huan95nd/BAI_TAP_PHAN_MEM/BAI_TAP_SOLIDWORKS/Dong_co_DC/bevel-gear-mechanism-4.snapshot.1/untitled.90.jpg

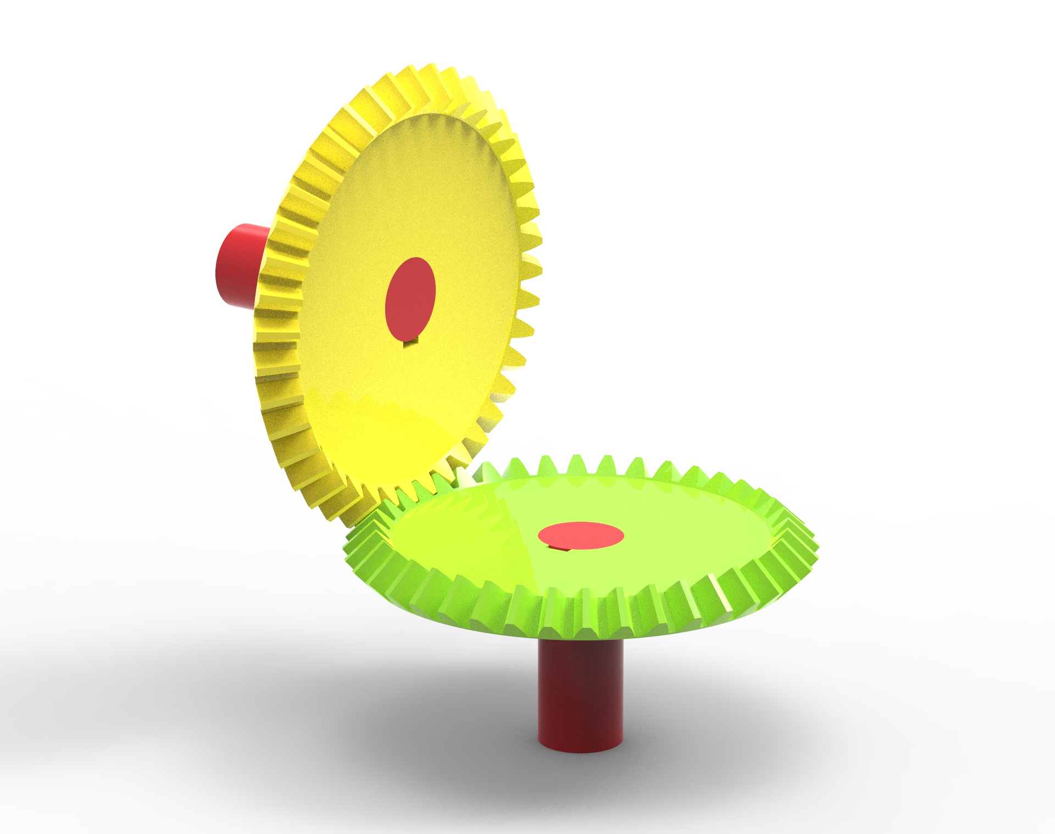
BAI_TAP_SOLIDWORKS/Dong_co_DC/bevel-gear-mechanism-4.snapshot.1/untitled.90.jpg
