huan95nd/BAI_TAP_PHAN_MEM/BAI_TAP_SOLIDWORKS/Dong_co_DC/bevel-gear-mechanism-4.snapshot.1/untitled.91.jpg

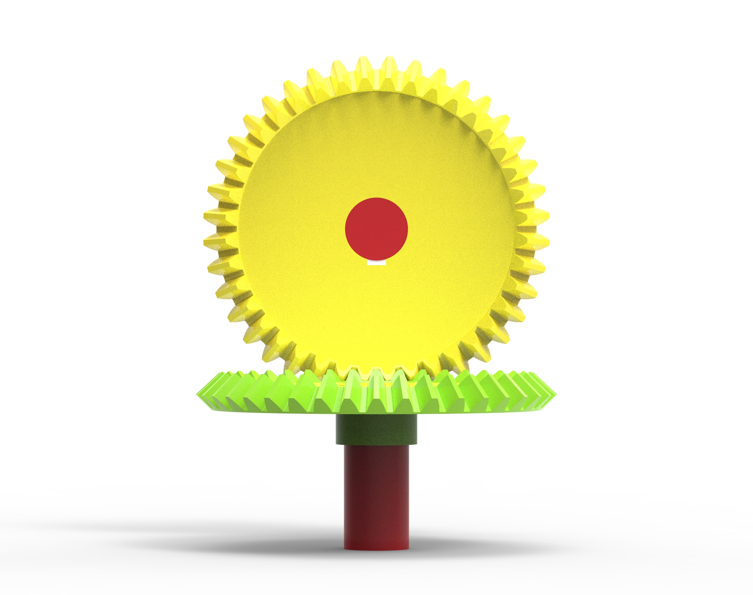
BAI_TAP_SOLIDWORKS/Dong_co_DC/bevel-gear-mechanism-4.snapshot.1/untitled.91.jpg
