huan95nd/BAI_TAP_PHAN_MEM/BAI_TAP_SOLIDWORKS/AN_HONG/Duoc_CPC_HN_project2-master/Duoc_CPC_HN_project2-master/fullcpchn.JPG

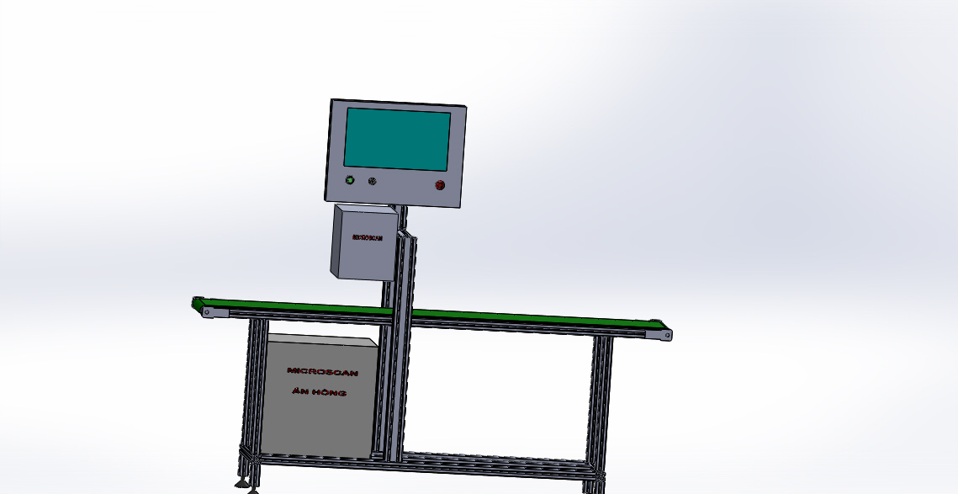
BAI_TAP_SOLIDWORKS/AN_HONG/Duoc_CPC_HN_project2-master/Duoc_CPC_HN_project2-master/fullcpchn.JPG
