huan95nd/BAI_TAP_PHAN_MEM/BAI_TAP_SOLIDWORKS/AN_HONG/videojet_8520/Assem1.SLDASM

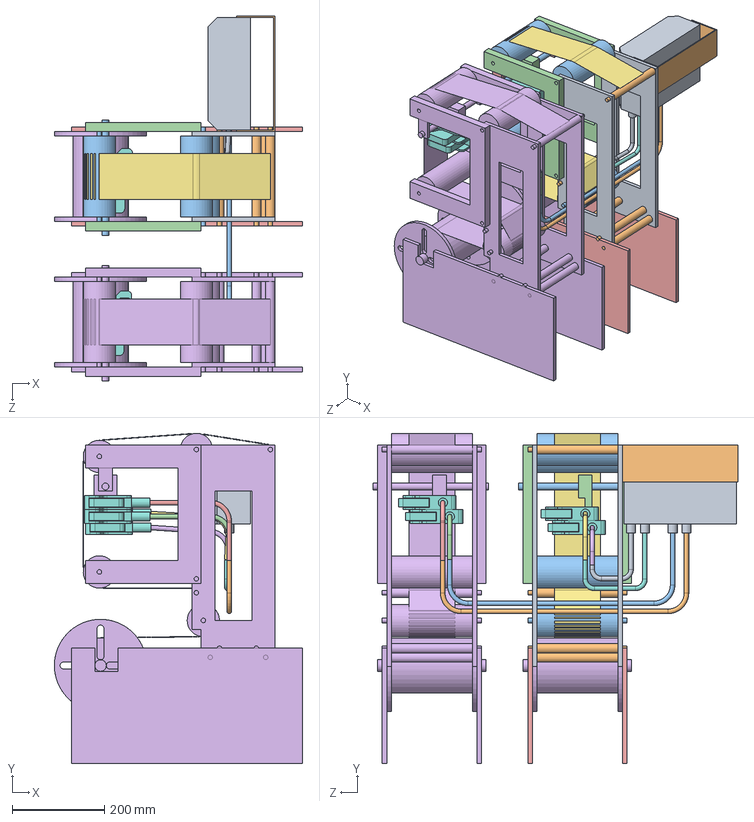
[picture p5: CAD file, 2020-03-10]
BAI_TAP_SOLIDWORKS/AN_HONG/videojet_8520/Assem1.SLDASM
537.5 x 715.1 x 790.0 mm
conlannho x 6
conlanto x 4
Part8^Assem1
dauin x 4
manhinh
Part22^Assem1
Part25^Assem1
Part1^Assem1
Part2^Assem1
Part5^Assem1
Part6^Assem1
Part9^Assem1
Part10^Assem1
Assem1
