huan95nd/BAI_TAP_PHAN_MEM/BAI_TAP_SOLIDWORKS/robot/User Library-NB4/User Library-NB4.sldasm

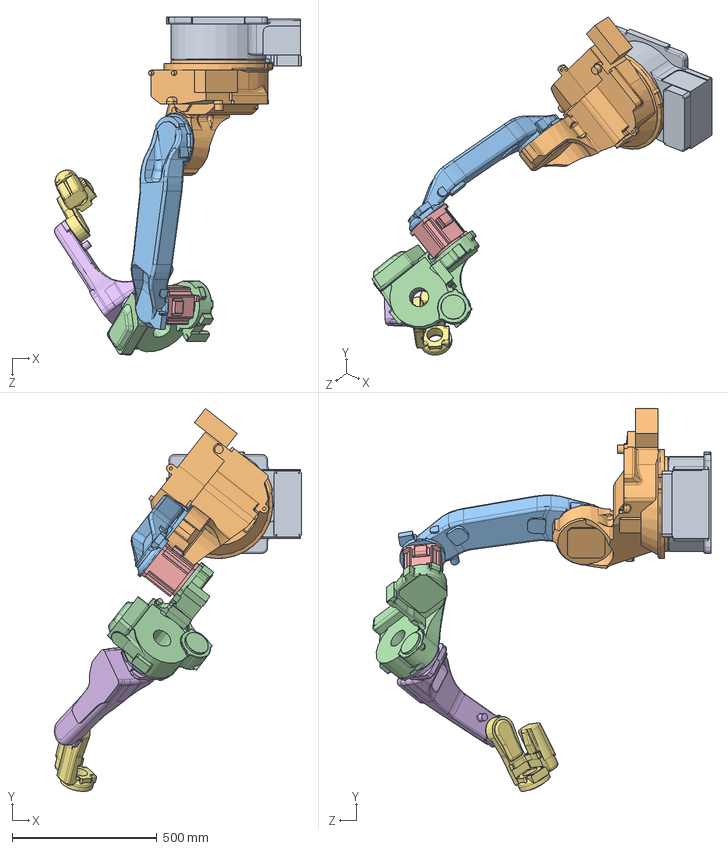
[picture p6: CAD file, 2020-02-10]
BAI_TAP_SOLIDWORKS/robot/User Library-NB4/User Library-NB4.sldasm
854.9 x 1325.2 x 1170.1 mm
User Library-NB4_NB4-oa0_1
User Library-NB4_NB4_0-oa1_1
User Library-NB4_NB4_2_1
User Library-NB4_NB4_3_1
User Library-NB4_NB4_4_1
User Library-NB4_NB4_6_1
User Library-NB4_NB4_7_1
User Library-NB4_NB4_8_1
