huan95nd/BAI_TAP_PHAN_MEM/BAI_TAP_SOLIDWORKS/AN_HONG/laser_khach_hang/laser_khach_hang/Assem2.SLDASM

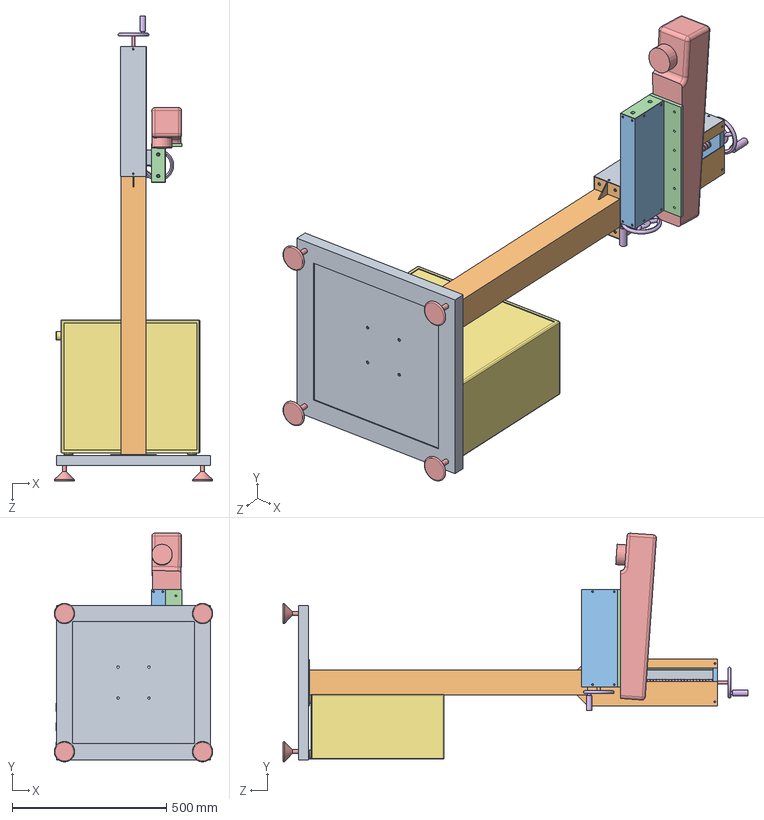
[picture p7: CAD file, 2020-03-07]
BAI_TAP_SOLIDWORKS/AN_HONG/laser_khach_hang/laser_khach_hang/Assem2.SLDASM
512.9 x 740.2 x 1505.0 mm
De
Chan_de
Nhom_duoi
Truc x 2
Truc_vit_me
Nhom_giua
nhom_truc_x
truc_x x 2
giua_trc_x
vit_me_truc_x
Nhom_tren
De_may_in
bat_de x 4
tay_quay x 2
khoi nguon fiber
angular contact ball bearing_68_iso
op
op_1
op_2
nhom_truc_x 1
MAY_IN_LAZE
bac x 4
bac_x x 4
