huan95nd/BAI_TAP_PHAN_MEM/BAI_TAP_SOLIDWORKS/AN_HONG/videojet_8520/Assem2.SLDASM

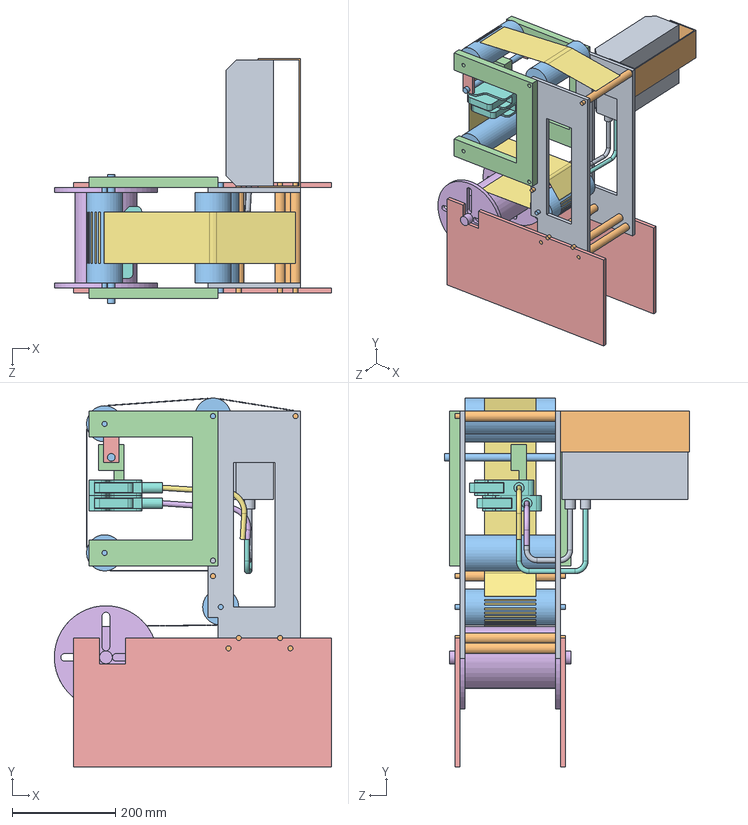
[picture p8: CAD file, 2020-03-10]
BAI_TAP_SOLIDWORKS/AN_HONG/videojet_8520/Assem2.SLDASM
537.5 x 715.1 x 475.0 mm
conlannho x 6
conlanto x 4
Part8^Assem2
dauin x 2
manhinh
Part22^Assem2
Part25^Assem2
Part1^Assem2
Part2^Assem2
