huan95nd/BAI_TAP_PHAN_MEM/BAI_TAP_SOLIDWORKS/Dong_co_DC/bevel-gear-mechanism-4.snapshot.1/圆锥齿轮传动齿轮副仿真.SLDASM

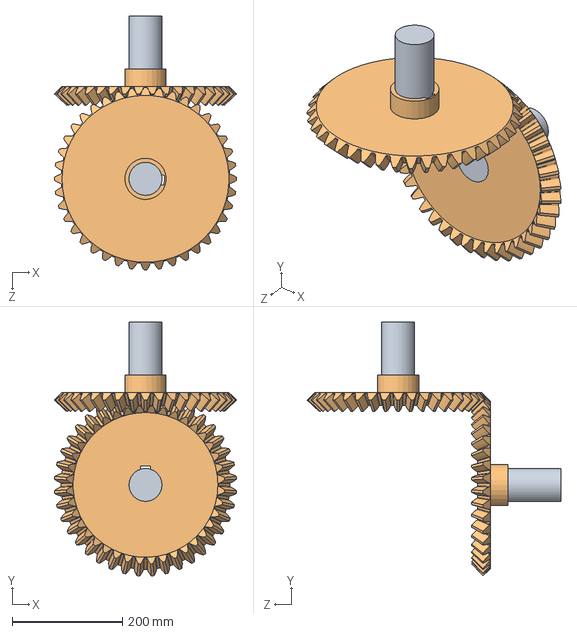
[picture p9: CAD file, 2020-02-09]
BAI_TAP_SOLIDWORKS/Dong_co_DC/bevel-gear-mechanism-4.snapshot.1/圆锥齿轮传动齿轮副仿真.SLDASM
331.3 x 461.1 x 461.4 mm
齿轮轴 x 2
圆锥齿轮 x 2
