huan95nd/BAI_TAP_PHAN_MEM/BAI_TAP_SOLIDWORKS/AN_HONG/gia_camera_demo-master/gia_camera_demo-master/full camera demo.SLDASM

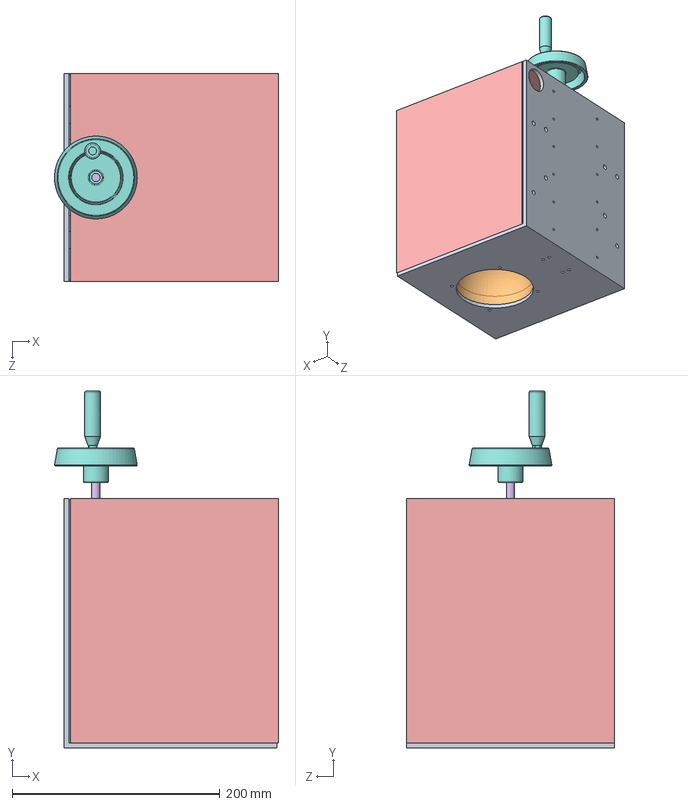
[picture p10: CAD file, 2020-03-10]
BAI_TAP_SOLIDWORKS/AN_HONG/gia_camera_demo-master/gia_camera_demo-master/full camera demo.SLDASM
215.6 x 343.5 x 200.0 mm
gia bat
dome light VT-LT3-DM100x
NORDEX-MIX-A1-3-230_MIX-A1-Base x 2
NORDEX-MIX-A1-3-230_MIX-A1-Carriage x 2
bat chung
vitme
do vitme duoi
H04.080.010.1-Durovis
gia bat MV4000
MicroHAWK_ID-40_Drawing
gia bat mv40-1
gia bat mv40
nap bat cover
