huan95nd/BAI_TAP_PHAN_MEM/BAI_TAP_SOLIDWORKS/AN_HONG/laser_khach_hang/laser_khach_hang/Assem3.SLDASM

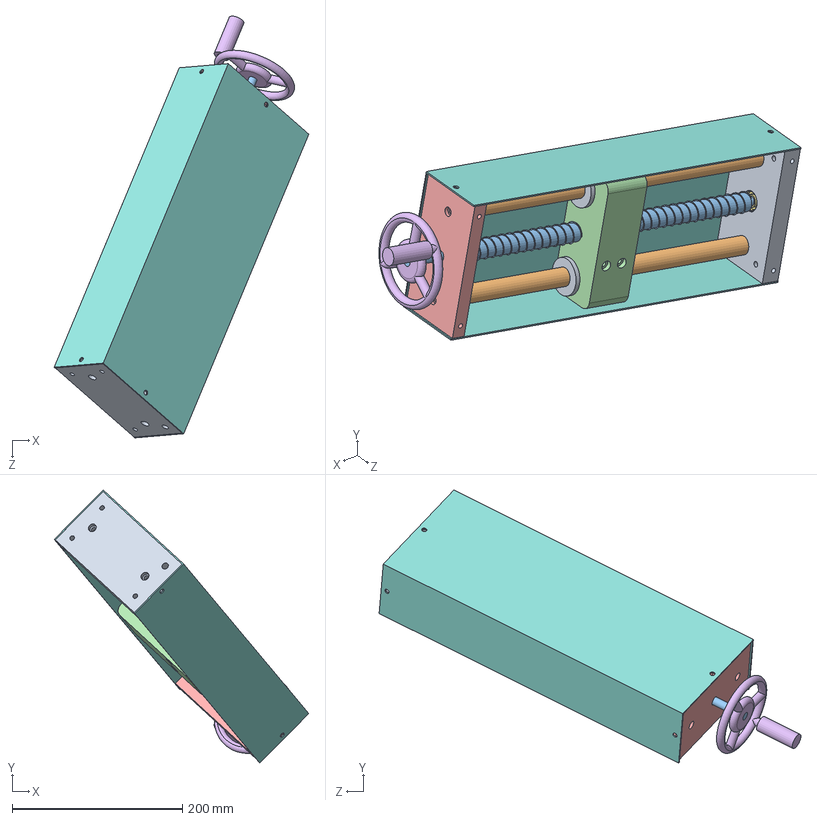
[picture p11: CAD file, 2020-02-09]
BAI_TAP_SOLIDWORKS/AN_HONG/laser_khach_hang/laser_khach_hang/Assem3.SLDASM
299.3 x 320.8 x 495.7 mm
Nhom_duoi
Truc x 2
Truc_vit_me
Nhom_giua
Nhom_tren
tay_quay
angular contact ball bearing_68_iso
op
bac x 4
