huan95nd/BAI_TAP_PHAN_MEM/BAI_TAP_SOLIDWORKS/bang tai/Quickdraw-LR6TS-7-DDL-ESD/Quickdraw-LR6TS-7-DDL-ESD.SLDASM

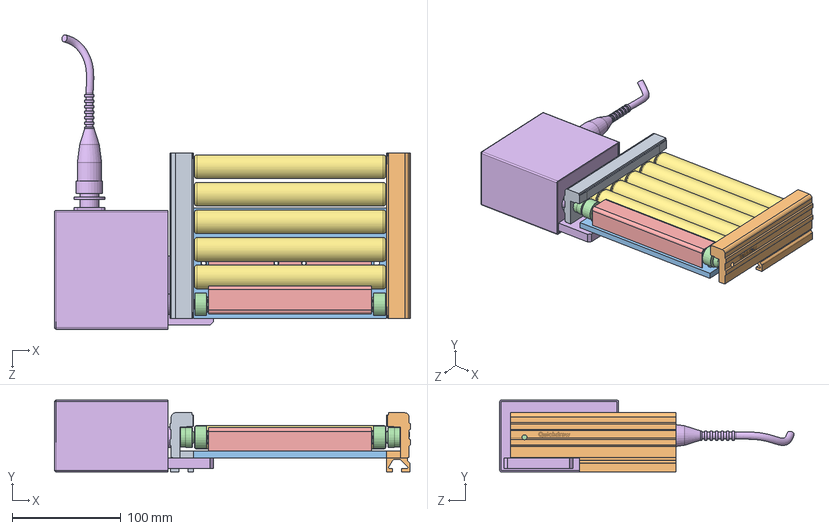
[picture p12: CAD file, 2020-02-09]
BAI_TAP_SOLIDWORKS/bang tai/Quickdraw-LR6TS-7-DDL-ESD/Quickdraw-LR6TS-7-DDL-ESD.SLDASM
328.1 x 66.2 x 271.4 mm
Quickdraw-LR6TS-7-DDL-ESD_LHRail
Quickdraw-LR6TS-7-DDL-ESD_RHRail
Quickdraw-LR6TS-7-DDL-ESD_END PLATE
Quickdraw-LR6TS-7-DDL-ESD_MR ROLLER ASSY LT x 2
Quickdraw-LR6TS-7-DDL-ESD_collar_cover
Quickdraw-LR6TS-7-DDL-ESD_Motor PKG DDL
Quickdraw-LR6TS-7-DDL-ESD_LongRoller x 5
