huan95nd/BAI_TAP_PHAN_MEM/BAI_TAP_SOLIDWORKS/AN_HONG/Project_BIA_HHT1/full bt5.SLDASM

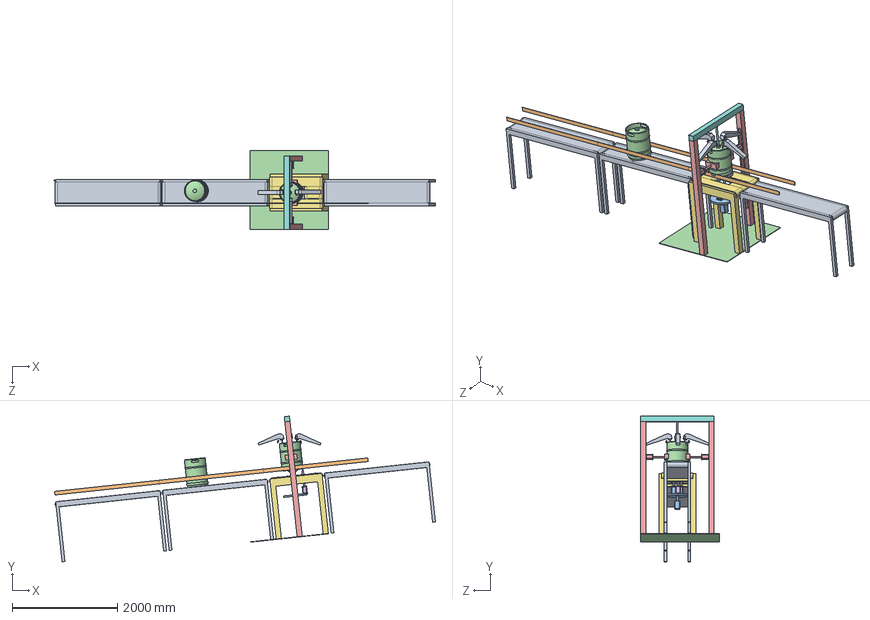
[picture p13: CAD file, 2020-02-09]
BAI_TAP_SOLIDWORKS/AN_HONG/Project_BIA_HHT1/full bt5.SLDASM
7253.0 x 2775.9 x 1500.0 mm
laser x 4
CT-hanhtrinh x 4
cam x 4
tam-nen
tru-do-xilanh-giu-keg x 3
xilanh_tt22
bang tai 2
bang tai 3 x 3
thanh dan hương x 6
ban-xoay-2
kegbia x 2
xilanh_giukeg1 x 2
