huan95nd/BAI_TAP_PHAN_MEM/BAI_TAP_SOLIDWORKS/AN_HONG/gia_camera_demo-master/gia_camera_demo-master/giá.SLDASM

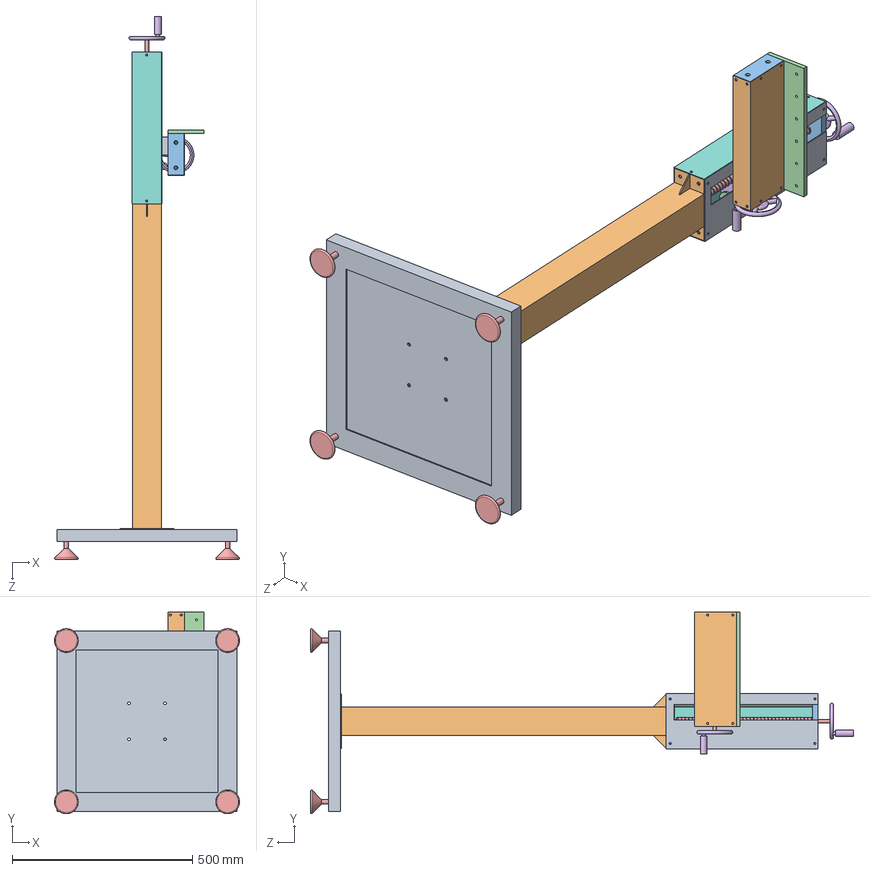
[picture p14: CAD file, 2020-03-10]
BAI_TAP_SOLIDWORKS/AN_HONG/gia_camera_demo-master/gia_camera_demo-master/giá.SLDASM
512.9 x 558.5 x 1505.0 mm
De
Chan_de
Nhom_duoi
Truc x 2
Truc_vit_me
Nhom_giua
nhom_truc_x
truc_x x 2
giua_trc_x
vit_me_truc_x
Nhom_tren
De_may_in
bat_de x 4
tay_quay x 2
angular contact ball bearing_68_iso
op
op_1
op_2
nhom_truc_x 1
bac x 4
bac_x x 4
