huan95nd/BAI_TAP_PHAN_MEM/BAI_TAP_SOLIDWORKS/Ban_le/8020-2134 Hinge Door Configuration/8020-2134 Hinge Door Configuration-$PARTNUMBER.SLDASM

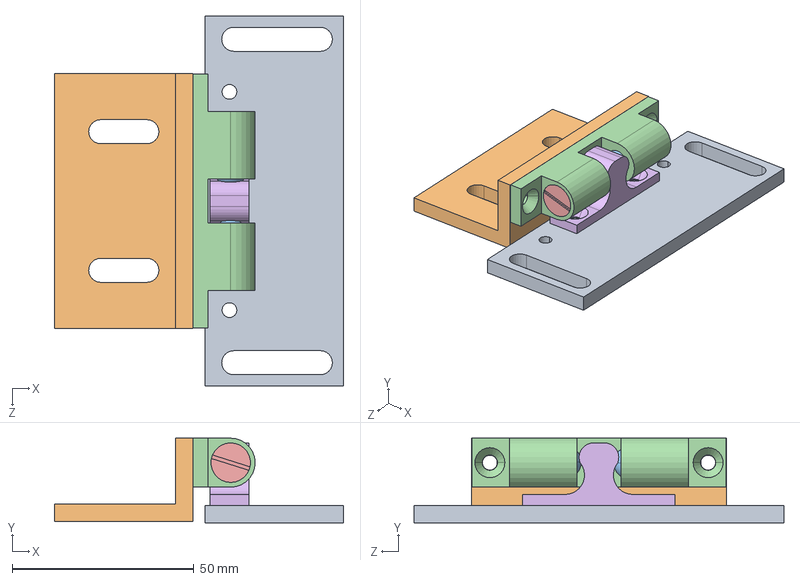
[picture p15: CAD file, 2020-02-09]
BAI_TAP_SOLIDWORKS/Ban_le/8020-2134 Hinge Door Configuration/8020-2134 Hinge Door Configuration-$PARTNUMBER.SLDASM
79.4 x 23.3 x 101.6 mm
8020-2134 Hinge Door Configuration-$PARTNUMBER_Latch Plate
8020-2134 Hinge Door Configuration-$PARTNUMBER_Strike Plate
8020-2134 Hinge Door Configuration-$PARTNUMBER_Ball Latch x 2
8020-2134 Hinge Door Configuration-$PARTNUMBER_Latch
8020-2134 Hinge Door Configuration-$PARTNUMBER_Cap x 2
8020-2134 Hinge Door Configuration-$PARTNUMBER_Striker
