huan95nd/BAI_TAP_PHAN_MEM/BAI_TAP_SOLIDWORKS/AN_HONG/FCC_2/Assem1.SLDASM

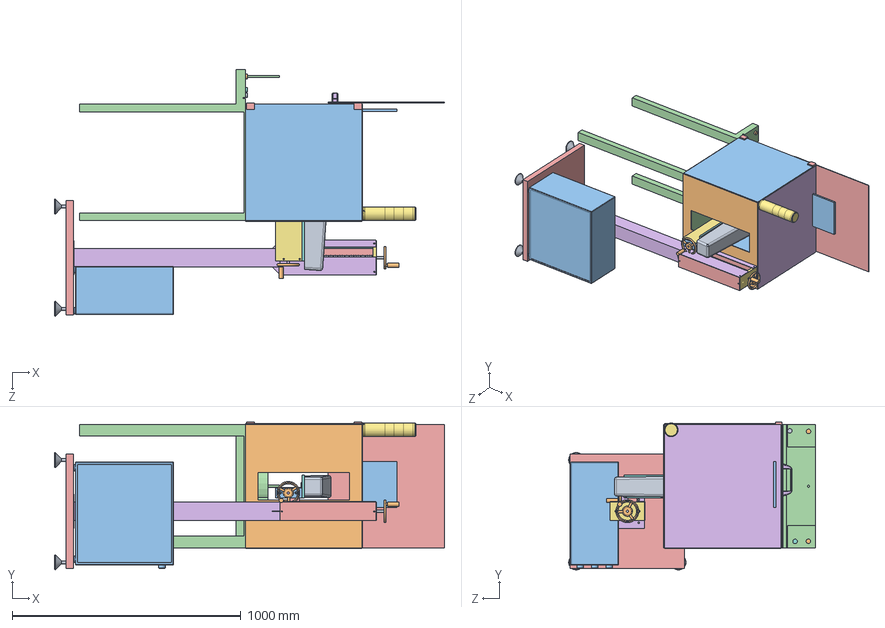
[picture p17: CAD file, 2020-02-09]
BAI_TAP_SOLIDWORKS/AN_HONG/FCC_2/Assem1.SLDASM
1704.8 x 646.1 x 1078.3 mm
nhôm định hình 1 x 11
De
Chan_de
Nhom_duoi
Truc x 2
Truc_vit_me
Nhom_giua
nhom_truc_x
truc_x x 2
giua_trc_x
vit_me_truc_x
Nhom_tren
De_may_in
bat_de x 4
tay_quay x 2
khoi nguon fiber
angular contact ball bearing_68_iso
op
op_1
op_2
nhom_truc_x 1
MAY_IN_LAZE
bac x 4
bac_x x 4
User Library-p000557 light tower
do
in
vang x 2
27394.stp
Part2 - Sao chép
8020-2061-$PARTNUMBER
