huan95nd/BAI_TAP_PHAN_MEM/BAI_TAP_SOLIDWORKS/AN_HONG/Project_BIA_HHT1/Assem3.SLDASM

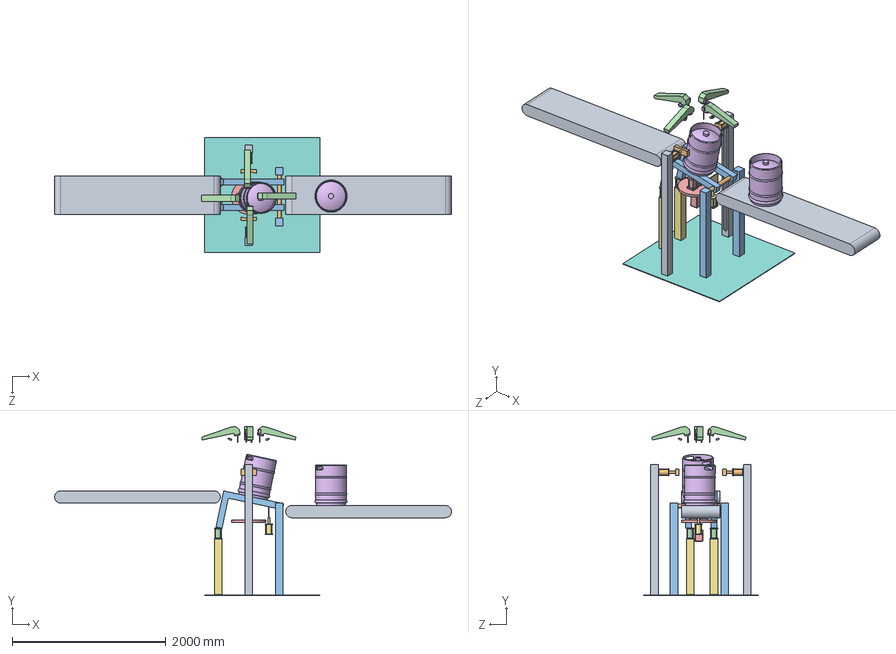
[picture p19: CAD file, 2020-02-09]
BAI_TAP_SOLIDWORKS/AN_HONG/Project_BIA_HHT1/Assem3.SLDASM
5170.0 x 2202.6 x 1500.0 mm
bang-tai x 2
truc-quay
tru-dung x 2
xilanh x 2
ban-xoay
kegbia x 2
xilanh_tt2
tam-nen
tru-do-xilanh-giu-keg x 2
xilanh_giukeg x 2
reject x 2
laser x 4
CT-hanhtrinh x 4
cam x 4
