huan95nd/BAI_TAP_PHAN_MEM/BAI_TAP_SOLIDWORKS/AN_HONG/Project_BIA_HHT1/FILE 1/full 1.SLDASM

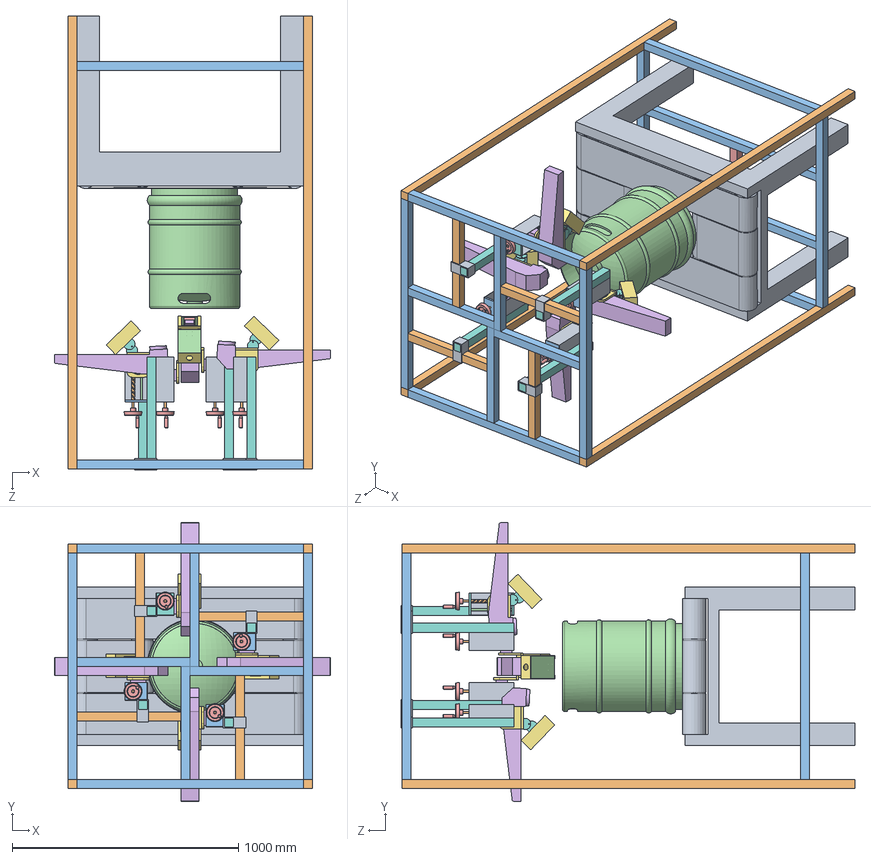
[picture p20: CAD file, 2020-02-09]
BAI_TAP_SOLIDWORKS/AN_HONG/Project_BIA_HHT1/FILE 1/full 1.SLDASM
1220.7 x 1233.4 x 2005.0 mm
bang tai 2
truc do laser x 4
truc do laser1 x 10
kegbia
truc do laser2
laser x 4
gia laser x 4
gia bat vitme3 x 5
gia bat vitme 1 x 4
truc vit me x 4
gia bat vitme x 3
truc tron x 4
H04.080.010.1-Durovis x 4
truc do x 4
gia laser 2 x 4
truc do laser3 x 4
gia bat tren x 4
truc do laser6 x 4
truc do laser7 x 4
cover camera x 4
do camera x 4
MicroHAWK_ID-40_Drawing x 4
cover camera1 x 4
gia bat cover x 8
