huan95nd/BAI_TAP_PHAN_MEM/BAI_TAP_SOLIDWORKS/robot/User Library-6-axis robot abb6650_320_125/User Library-6-axis robot abb6650_320_125.SLDASM

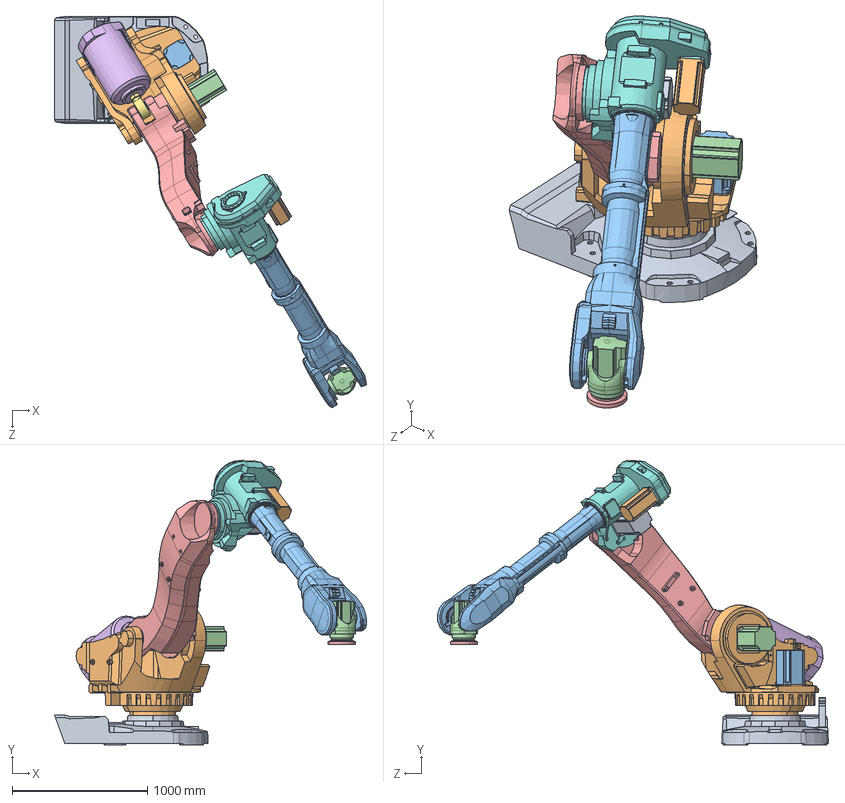
[picture p21: CAD file, 2020-02-10]
BAI_TAP_SOLIDWORKS/robot/User Library-6-axis robot abb6650_320_125/User Library-6-axis robot abb6650_320_125.SLDASM
2306.7 x 2104.9 x 2891.5 mm
User Library-6-axis robot abb6650_320_125_IRB6650_320-125_m2000_rev2_01-1
User Library-6-axis robot abb6650_320_125_IRB6650_320-125_m2000_rev2_01-2
User Library-6-axis robot abb6650_320_125_IRB6650_320-125_m2000_rev2_01-13
User Library-6-axis robot abb6650_320_125_IRB6650_320-125_m2000_rev2_01-12
User Library-6-axis robot abb6650_320_125_IRB6650_320-125_m2000_rev2_01-3
User Library-6-axis robot abb6650_320_125_IRB6650_320-125_m2000_rev2_01-8
User Library-6-axis robot abb6650_320_125_IRB6650_320-125_m2000_rev2_01-9
User Library-6-axis robot abb6650_320_125_IRB6650_320-125_m2000_rev2_01-4
User Library-6-axis robot abb6650_320_125_IRB6650_320-125_m2000_rev2_01-10
User Library-6-axis robot abb6650_320_125_IRB6650_320-125_m2000_rev2_01-11
User Library-6-axis robot abb6650_320_125_IRB6650_320-125_m2000_rev2_01-6
User Library-6-axis robot abb6650_320_125_IRB6650_320-125_m2000_rev2_01-5
User Library-6-axis robot abb6650_320_125_IRB6650_320-125_m2000_rev2_01-7
