huan95nd/BAI_TAP_PHAN_MEM/BAI_TAP_SOLIDWORKS/AN_HONG/Duoc_CPC_HN_project2-master/Duoc_CPC_HN_project2-master/dr30e3l-l3gzc.SLDASM

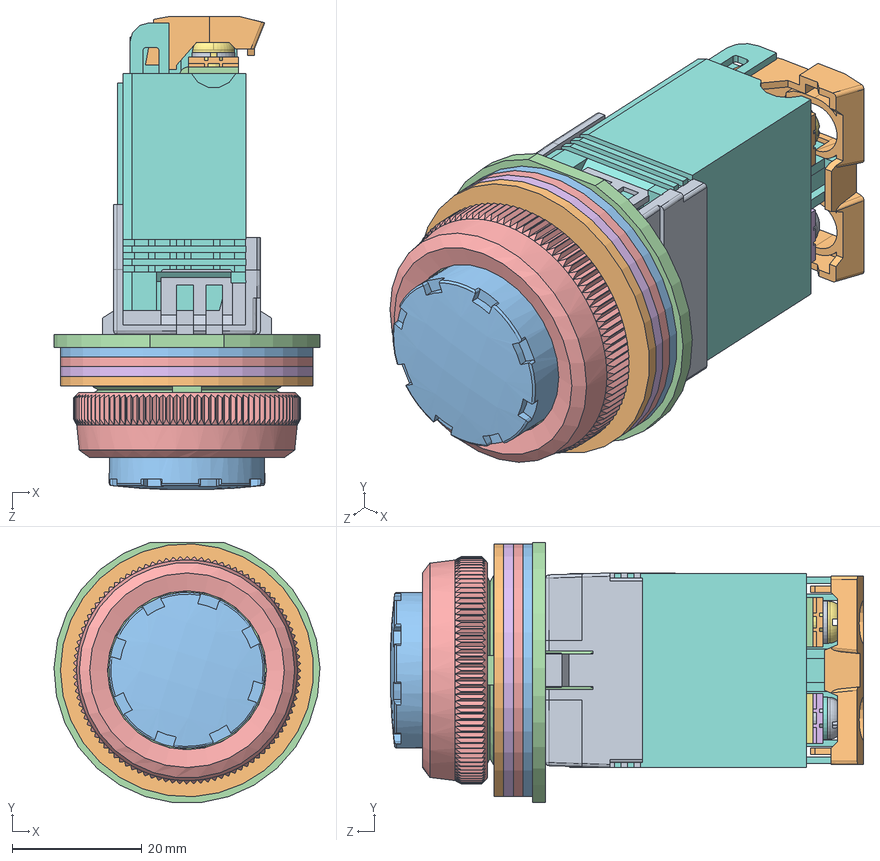
[picture p22: CAD file, 2020-03-10]
BAI_TAP_SOLIDWORKS/AN_HONG/Duoc_CPC_HN_project2-master/Duoc_CPC_HN_project2-master/dr30e3l-l3gzc.SLDASM
41.0 x 40.1 x 72.9 mm
dr30e3l-l3gzc_01
dr30e3l-l3gzc_02
dr30e3l-l3gzc_03
dr30e3l-l3gzc_04
dr30e3l-l3gzc_05
dr30e3l-l3gzc_06
dr30e3l-l3gzc_07
dr30e3l-l3gzc_08
dr30e3l-l3gzc_09
dr30e3l-l3gzc_10
dr30e3l-l3gzc_11
dr30e3l-l3gzc_12
dr30e3l-l3gzc_13
dr30e3l-l3gzc_14
dr30e3l-l3gzc_15
dr30e3l-l3gzc_16
dr30e3l-l3gzc_17
dr30e3l-l3gzc_18
dr30e3l-l3gzc_19
