huan95nd/BAI_TAP_PHAN_MEM/BAI_TAP_SOLIDWORKS/AN_HONG/Project_BIA_HHT1/FILE 1/truc do laser.SLDASM

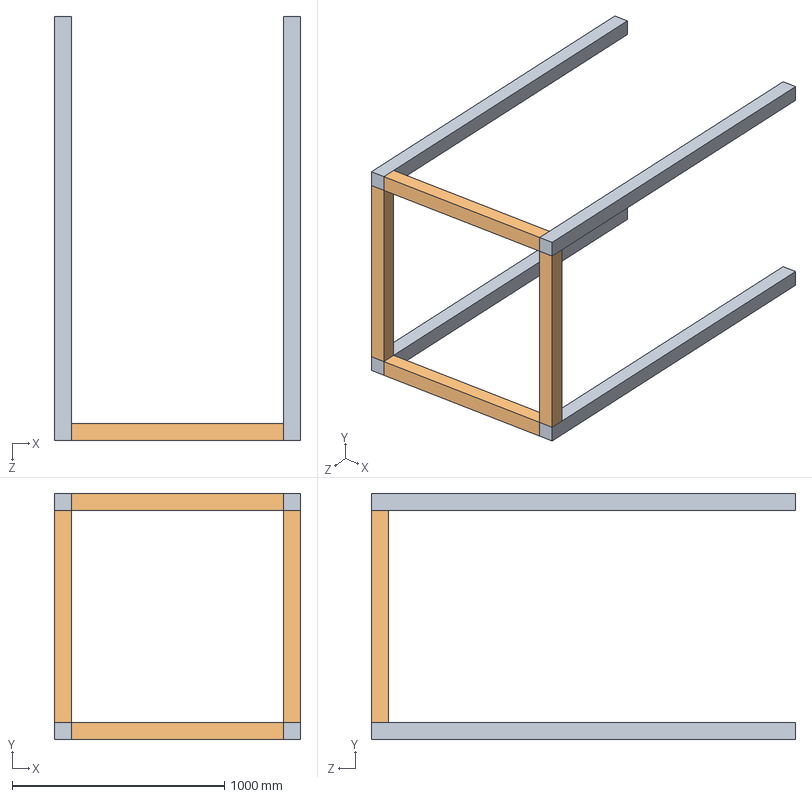
[picture p23: CAD file, 2020-02-09]
BAI_TAP_SOLIDWORKS/AN_HONG/Project_BIA_HHT1/FILE 1/truc do laser.SLDASM
1160.0 x 1160.0 x 2000.0 mm
truc do laser x 4
truc do laser1 x 4
