huan95nd/BAI_TAP_PHAN_MEM/BAI_TAP_SOLIDWORKS/AN_HONG/Duoc_CPC_HN_project2-master/Duoc_CPC_HN_project2-master/tu dien.SLDASM

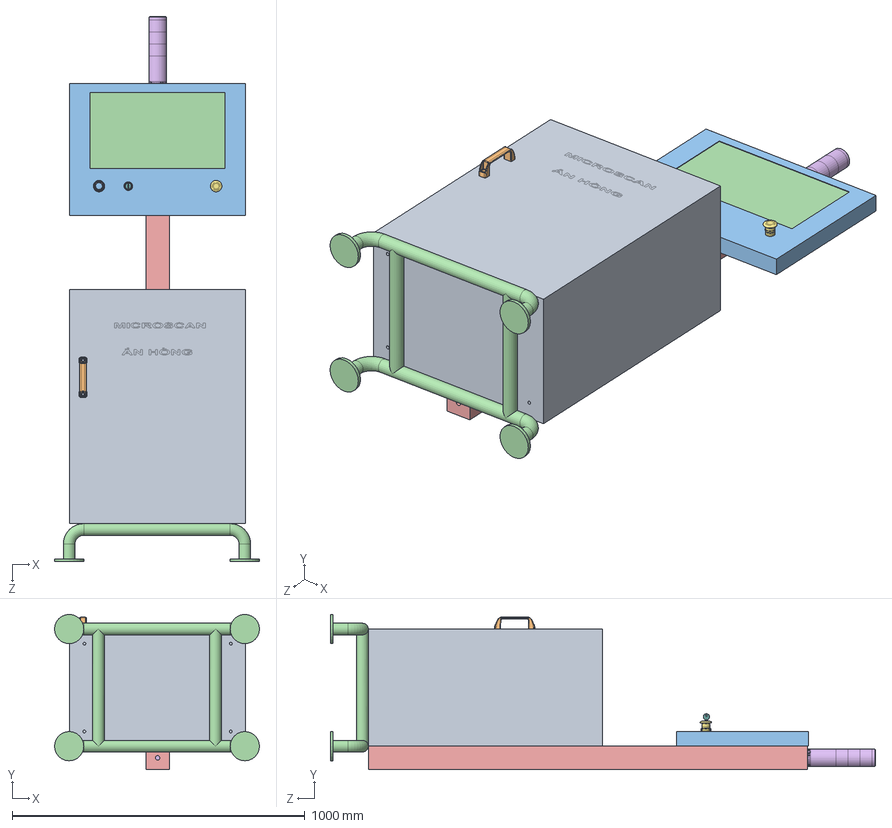
[picture p24: CAD file, 2020-03-10]
BAI_TAP_SOLIDWORKS/AN_HONG/Duoc_CPC_HN_project2-master/Duoc_CPC_HN_project2-master/tu dien.SLDASM
700.0 x 530.0 x 1862.4 mm
tu dien
8020-2061-$PARTNUMBER
bat man hinh
man hinh
thanh bat man hinh
User Library-p000557 light tower
User Library-E Stop Button
G_IC03_XX_28762V
dr30e3l-l3gzc_01
dr30e3l-l3gzc_02
dr30e3l-l3gzc_03
dr30e3l-l3gzc_04
dr30e3l-l3gzc_05
dr30e3l-l3gzc_06
dr30e3l-l3gzc_07
dr30e3l-l3gzc_08
dr30e3l-l3gzc_09
dr30e3l-l3gzc_10
dr30e3l-l3gzc_11
dr30e3l-l3gzc_12
dr30e3l-l3gzc_13
dr30e3l-l3gzc_14
dr30e3l-l3gzc_15
dr30e3l-l3gzc_16
dr30e3l-l3gzc_17
dr30e3l-l3gzc_18
dr30e3l-l3gzc_19
chan de tu
