huan95nd/BAI_TAP_PHAN_MEM/BAI_TAP_SOLIDWORKS/AN_HONG/Duoc_CPC_HN_project2-master/Duoc_CPC_HN_project2-master/bang_tai.SLDASM

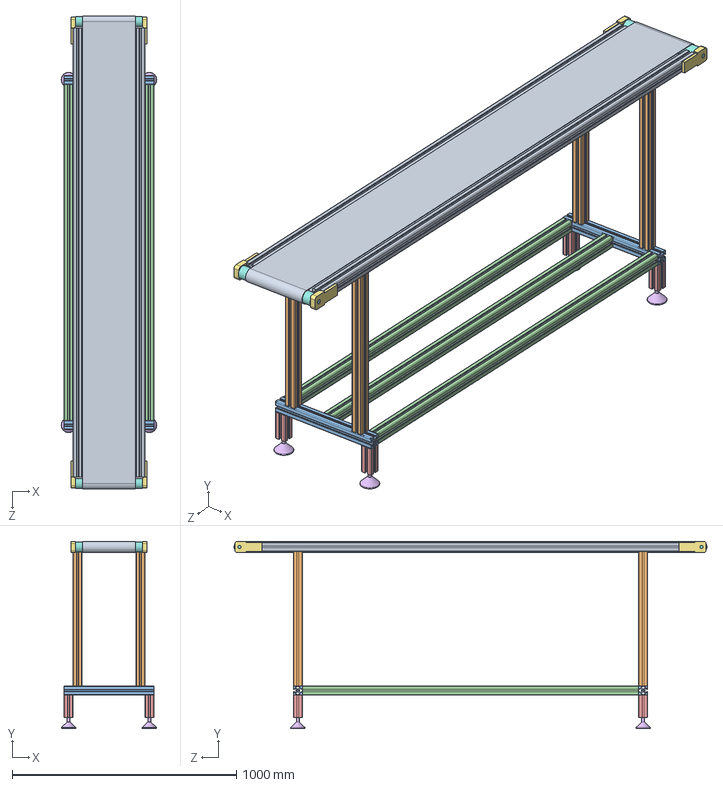
[picture p25: CAD file, 2020-03-10]
BAI_TAP_SOLIDWORKS/AN_HONG/Duoc_CPC_HN_project2-master/Duoc_CPC_HN_project2-master/bang_tai.SLDASM
426.0 x 835.0 x 2109.0 mm
nhom 40x40x2000 x 2
nhom 40x40x600 x 4
nhom 40x40x400 x 2
nhom 40x40x1500 x 3
nhom 40x40x100 x 4
bat_de x 4
bat truc x 4
truc lan x 2
Belt2-4^bang_tai
