huan95nd/BAI_TAP_PHAN_MEM/BAI_TAP_SOLIDWORKS/AN_HONG/Project_BIA_HHT1/FILE 1/cover camera.SLDASM

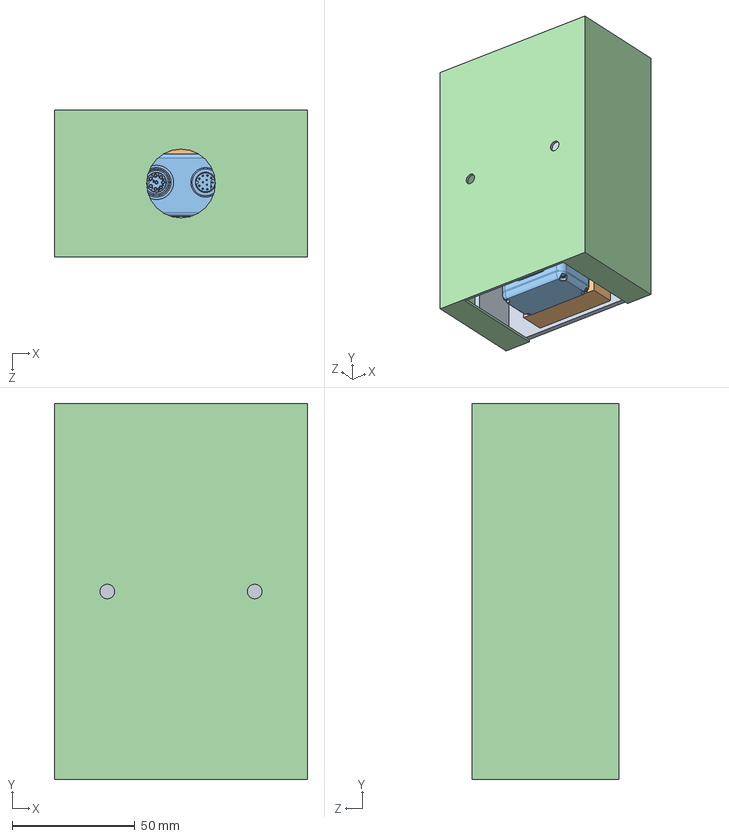
[picture p27: CAD file, 2020-02-09]
BAI_TAP_SOLIDWORKS/AN_HONG/Project_BIA_HHT1/FILE 1/cover camera.SLDASM
103.0 x 153.0 x 60.0 mm
cover camera
do camera
MicroHAWK_ID-40_Drawing
cover camera1
