huan95nd/BAI_TAP_PHAN_MEM/BAI_TAP_SOLIDWORKS/AN_HONG/Project_BIA_HHT1/bang tai giua.SLDASM

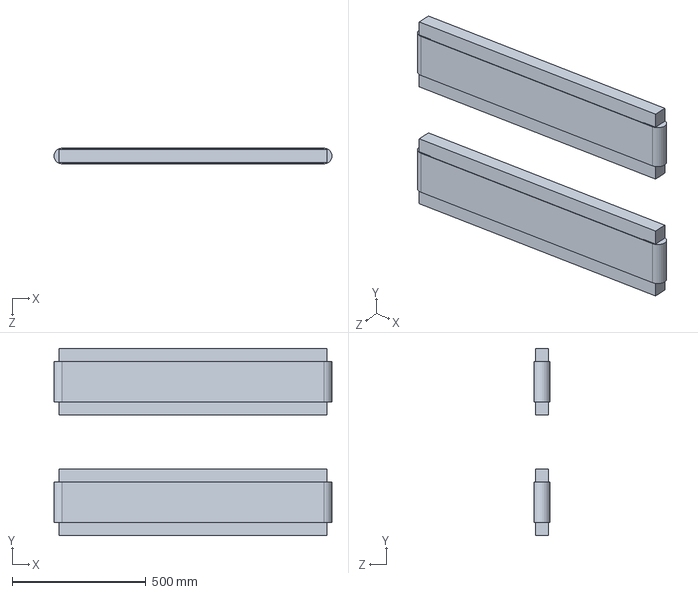
[picture p31: CAD file, 2020-02-09]
BAI_TAP_SOLIDWORKS/AN_HONG/Project_BIA_HHT1/bang tai giua.SLDASM
1039.0 x 700.0 x 59.0 mm
bang tai 1 x 2
