huan95nd/BAI_TAP_PHAN_MEM/BAI_TAP_SOLIDWORKS/AN_HONG/Duoc_CPC_HN_project2-master/Duoc_CPC_HN_project2-master/fullcpchn.SLDASM

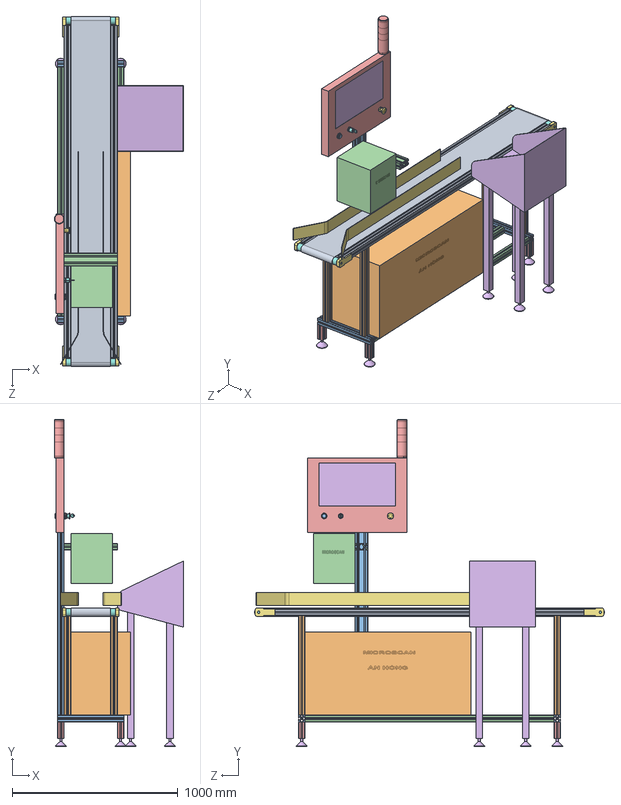
[picture p32: CAD file, 2020-03-10]
BAI_TAP_SOLIDWORKS/AN_HONG/Duoc_CPC_HN_project2-master/Duoc_CPC_HN_project2-master/fullcpchn.SLDASM
780.0 x 1972.4 x 2109.0 mm
nhom 40x40x2000 x 2
nhom 40x40x600 x 4
nhom 40x40x400 x 2
nhom 40x40x1500 x 3
nhom 40x40x100 x 4
bat_de x 8
bat truc x 4
truc lan x 2
Belt2-4^bang_tai
tu dien - Sao chép
40x80x1000
cover camera
bat man hinh
man hinh
User Library-E Stop Button
G_IC03_XX_28762V
dr30e3l-l3gzc_01
dr30e3l-l3gzc_02
dr30e3l-l3gzc_03
dr30e3l-l3gzc_04
dr30e3l-l3gzc_05
dr30e3l-l3gzc_06
dr30e3l-l3gzc_07
dr30e3l-l3gzc_08
dr30e3l-l3gzc_09
dr30e3l-l3gzc_10
dr30e3l-l3gzc_11
dr30e3l-l3gzc_12
dr30e3l-l3gzc_13
dr30e3l-l3gzc_14
dr30e3l-l3gzc_15
dr30e3l-l3gzc_16
dr30e3l-l3gzc_17
dr30e3l-l3gzc_18
dr30e3l-l3gzc_19
40x80x320
User Library-p000557 light tower
gia loai sp
thanh dan hương x 2
