huan95nd/BAI_TAP_PHAN_MEM/BAI_TAP_SOLIDWORKS/AN_HONG/Project_BIA_HHT1/full bt2.SLDASM

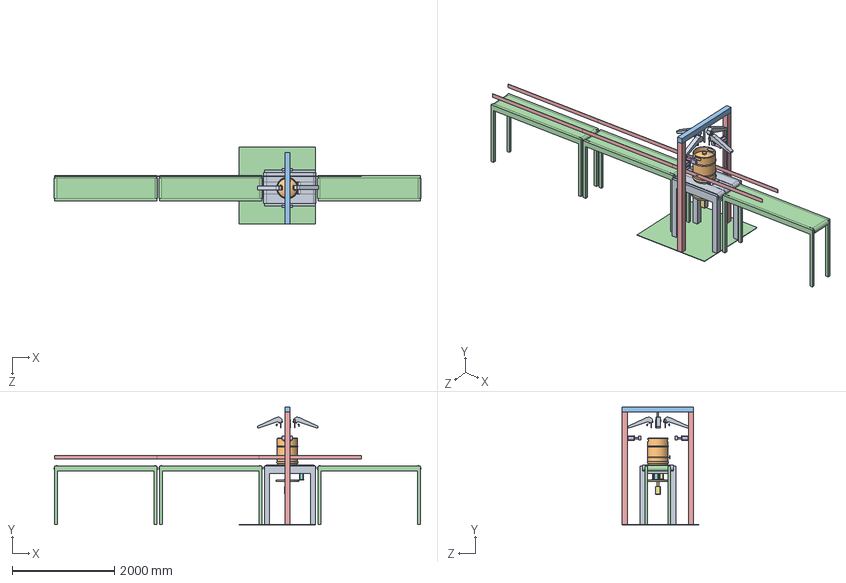
[picture p33: CAD file, 2020-02-09]
BAI_TAP_SOLIDWORKS/AN_HONG/Project_BIA_HHT1/full bt2.SLDASM
7179.0 x 2308.0 x 1500.0 mm
laser x 4
CT-hanhtrinh x 4
cam x 4
tam-nen
tru-do-xilanh-giu-keg x 3
xilanh_giukeg x 3
ban-xoay
xilanh_tt2
bang tai 2
kegbia
bang tai 3 x 3
thanh dan hương x 6
