huan95nd/BAI_TAP_PHAN_MEM/BAI_TAP_SOLIDWORKS/AN_HONG/laser_khach_hang/laser_khach_hang/Assem4.SLDASM

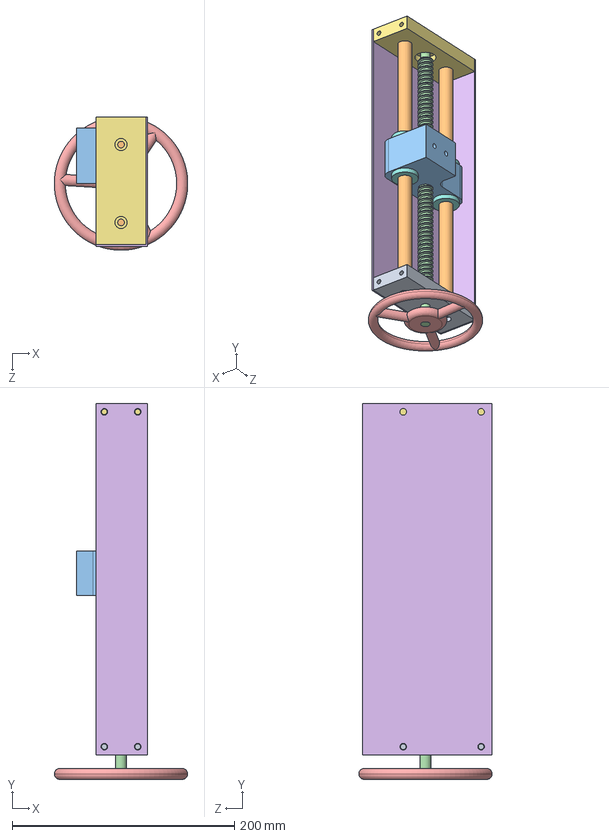
[picture p35: CAD file, 2020-02-09]
BAI_TAP_SOLIDWORKS/AN_HONG/laser_khach_hang/laser_khach_hang/Assem4.SLDASM
119.9 x 338.0 x 120.0 mm
nhom_truc_x
truc_x x 2
giua_trc_x
vit_me_truc_x
tay_quay
op_2
nhom_truc_x 1
bac_x x 4
