huan95nd/BAI_TAP_PHAN_MEM/BAI_TAP_SOLIDWORKS/AN_HONG/gia_camera_demo-master/gia_camera_demo-master/Assem1.SLDASM

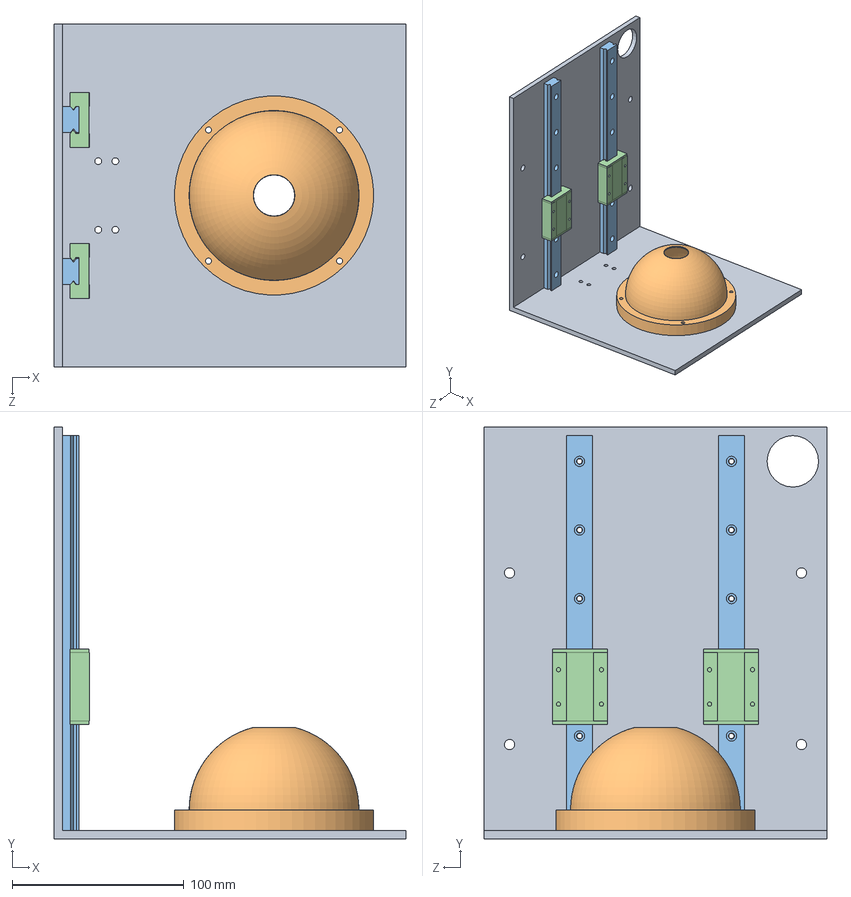
[picture p36: CAD file, 2020-03-10]
BAI_TAP_SOLIDWORKS/AN_HONG/gia_camera_demo-master/gia_camera_demo-master/Assem1.SLDASM
205.0 x 240.0 x 200.0 mm
gia bat
dome light VT-LT3-DM100x
NORDEX-MIX-A1-3-230_MIX-A1-Base x 2
NORDEX-MIX-A1-3-230_MIX-A1-Carriage x 2
