huan95nd/BAI_TAP_PHAN_MEM/BAI_TAP_SOLIDWORKS/AN_HONG/Project_BIA_HHT1/full bt10.SLDASM

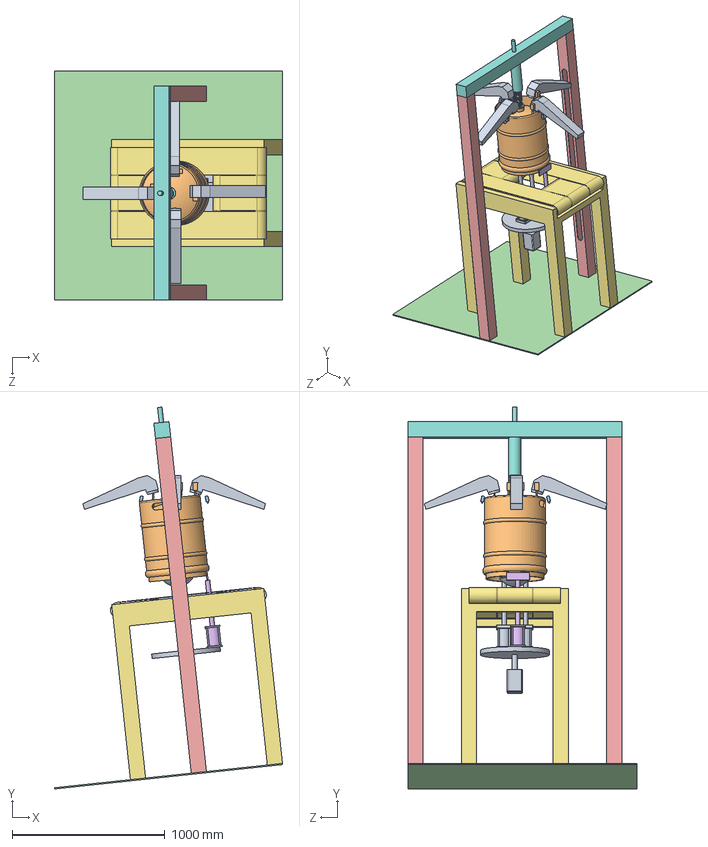
[picture p37: CAD file, 2020-02-09]
BAI_TAP_SOLIDWORKS/AN_HONG/Project_BIA_HHT1/full bt10.SLDASM
1492.4 x 2496.9 x 1500.0 mm
laser x 4
CT-hanhtrinh x 4
cam x 4
tam-nen
tru-do-xilanh-giu-keg x 3
xilanh_tt22
bang tai 2
ban-xoay-2
kegbia
loxo
