huan95nd/BAI_TAP_PHAN_MEM/BAI_TAP_SOLIDWORKS/AN_HONG/Project_BIA_HHT1/Assem1.SLDASM

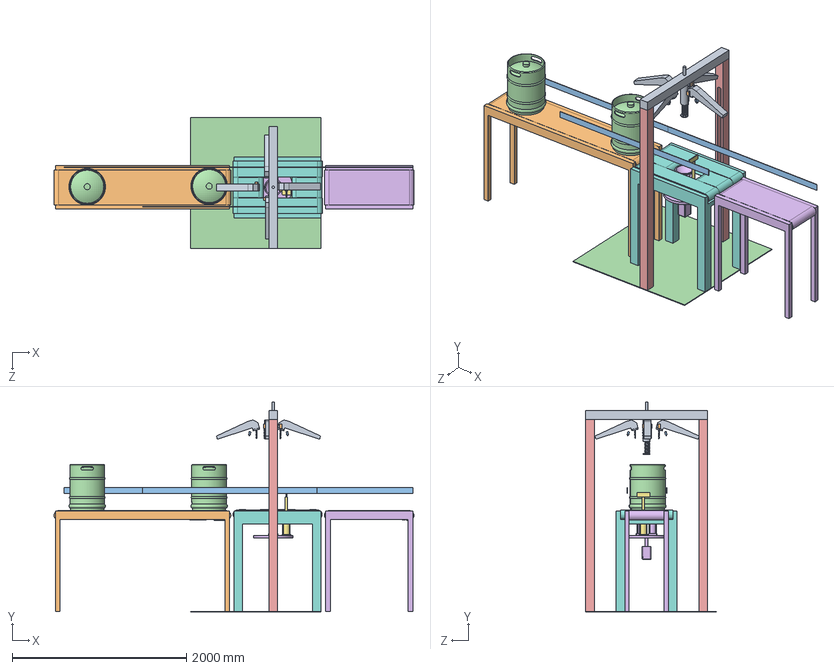
[picture p40: CAD file, 2020-02-09]
BAI_TAP_SOLIDWORKS/AN_HONG/Project_BIA_HHT1/Assem1.SLDASM
4128.5 x 2408.0 x 1500.0 mm
laser x 4
CT-hanhtrinh x 4
cam x 4
tam-nen
tru-do-xilanh-giu-keg x 3
ban-xoay
xilanh_tt22
bang tai 2
bang tai 3.1
thanh dan hương x 3
kegbia x 2
loxo
bang tai 3
