huan95nd/BAI_TAP_PHAN_MEM/BAI_TAP_SOLIDWORKS/AN_HONG/Project_BIA_HHT1/full bt4.SLDASM

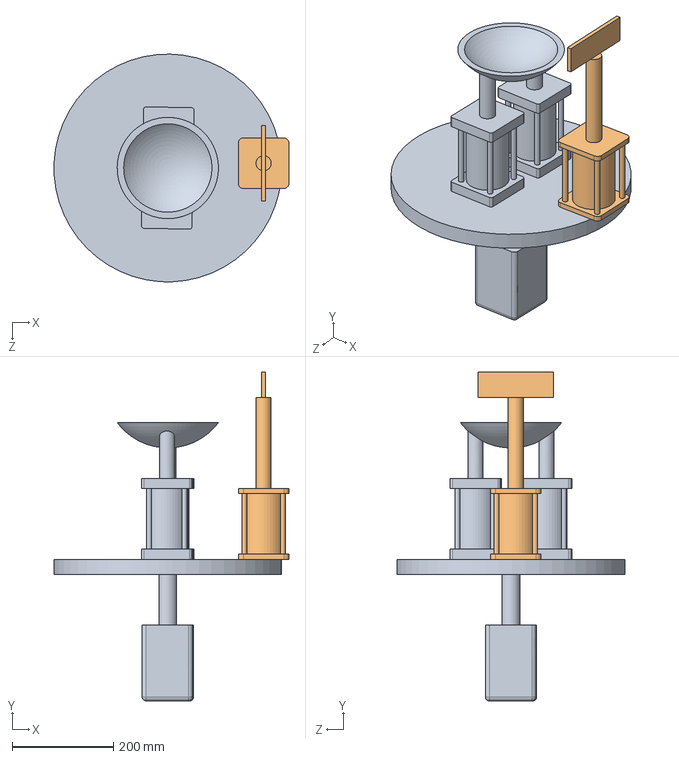
[picture p41: CAD file, 2020-02-09]
BAI_TAP_SOLIDWORKS/AN_HONG/Project_BIA_HHT1/full bt4.SLDASM
464.0 x 650.0 x 449.9 mm
ban-xoay
xilanh_tt22
