huan95nd/BAI_TAP_PHAN_MEM/BAI_TAP_SOLIDWORKS/AN_HONG/Project_BIA_HHT1/Assem2.SLDASM

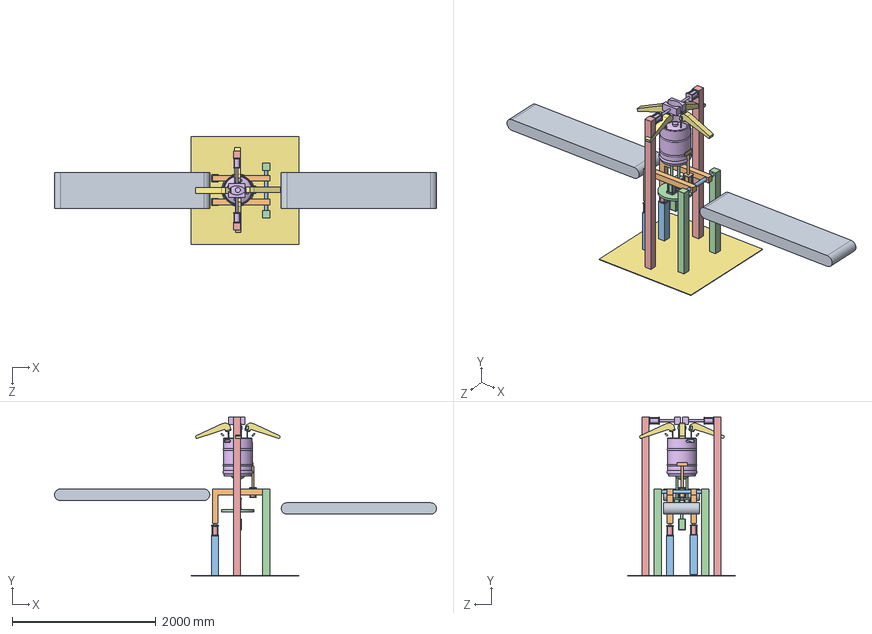
[picture p43: CAD file, 2020-02-09]
BAI_TAP_SOLIDWORKS/AN_HONG/Project_BIA_HHT1/Assem2.SLDASM
5312.3 x 2208.0 x 1500.0 mm
bang-tai x 2
reject x 2
truc-quay
tru-dung x 2
xilanh x 2
kegbia
laser x 4
CT-hanhtrinh x 4
cam x 4
xilanh_tt22
ban-xoay-2
tru-do-xilanh-giu-keg x 2
xilanh_giukeg1 x 2
tam-nen
