huan95nd/BAI_TAP_PHAN_MEM/BAI_TAP_SOLIDWORKS/AN_HONG/FCC_2/in.SLDPRT

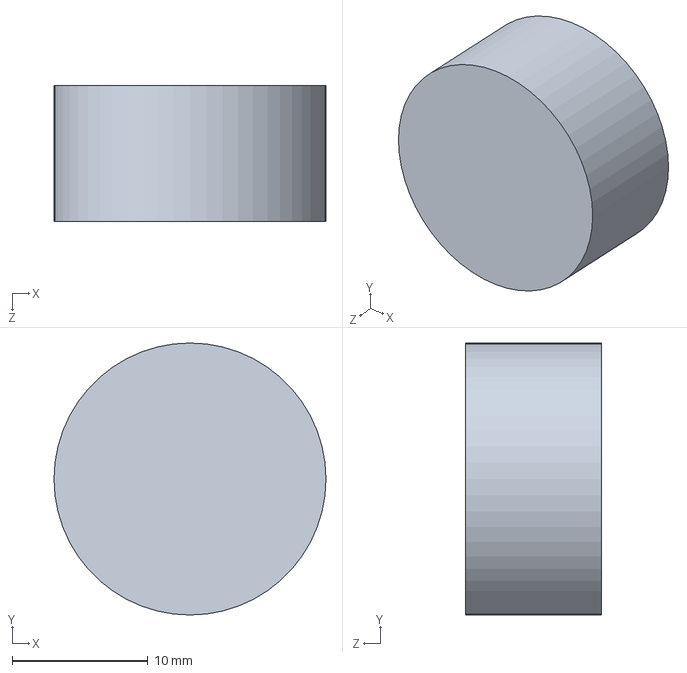
[picture p45: CAD file, 2020-02-09]
BAI_TAP_SOLIDWORKS/AN_HONG/FCC_2/in.SLDPRT
20.0 x 20.0 x 10.0 mm
