huan95nd/BAI_TAP_PHAN_MEM/BAI_TAP_SOLIDWORKS/AN_HONG/laser_khach_hang/laser_khach_hang/giua_trc_x.SLDPRT

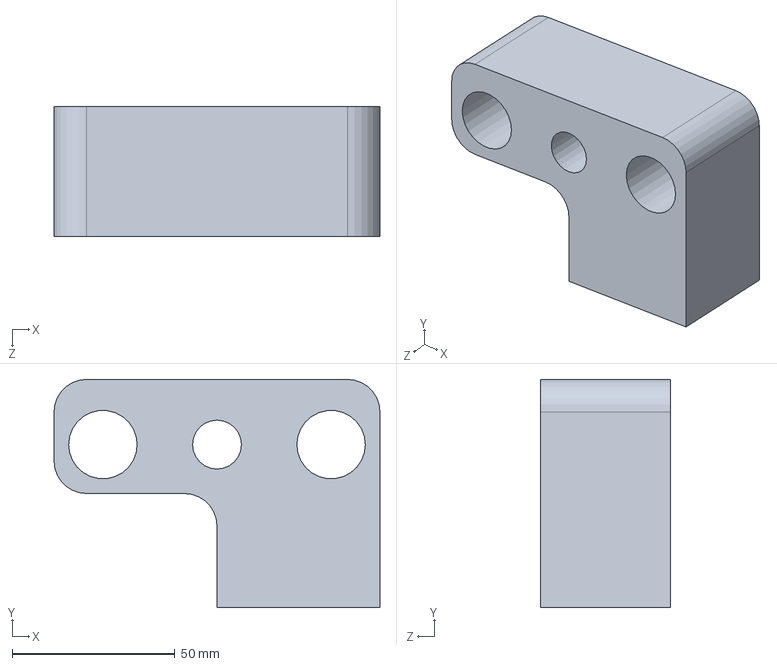
[picture p47: CAD file, 2020-03-07]
BAI_TAP_SOLIDWORKS/AN_HONG/laser_khach_hang/laser_khach_hang/giua_trc_x.SLDPRT
100.0 x 70.0 x 40.0 mm
