huan95nd/BAI_TAP_PHAN_MEM/BAI_TAP_SOLIDWORKS/AN_HONG/MV40MicroHAWK_Drawings/STEP/98-9000041-01.STEP

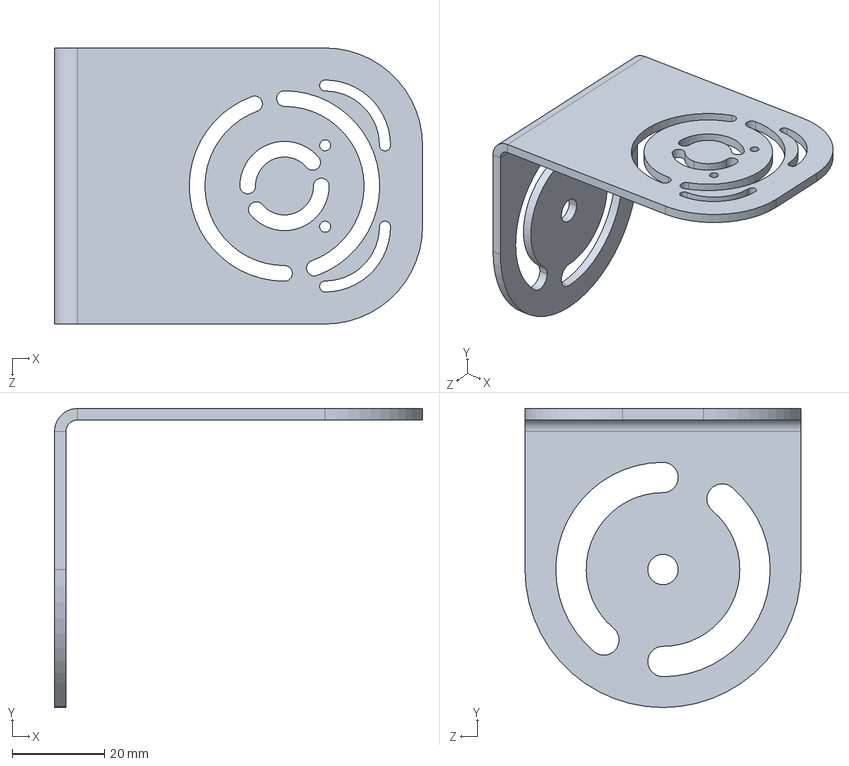
[picture p48: CAD file, 2020-02-09]
BAI_TAP_SOLIDWORKS/AN_HONG/MV40MicroHAWK_Drawings/STEP/98-9000041-01.STEP
80.0 x 65.0 x 60.0 mm
