huan95nd/BAI_TAP_PHAN_MEM/BAI_TAP_SOLIDWORKS/AN_HONG/Project_BIA_HHT1/FILE 1/gia bat vitme.SLDPRT

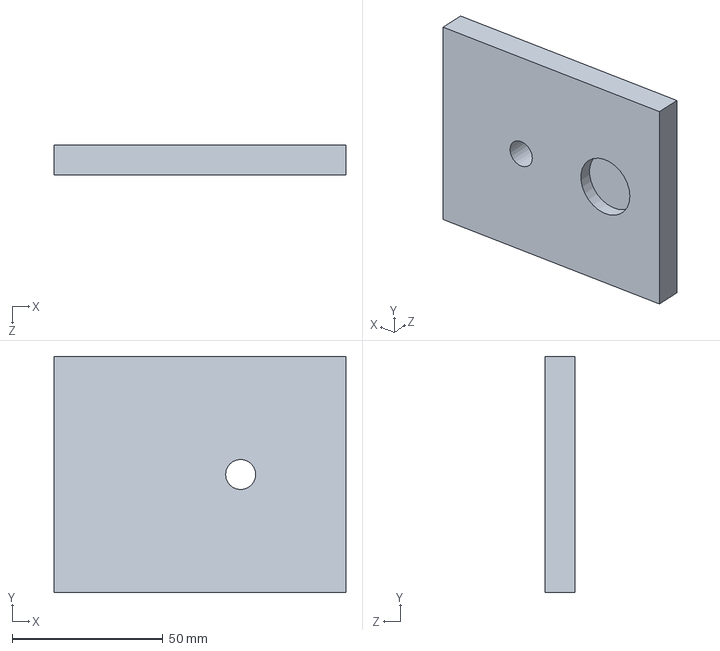
[picture p49: CAD file, 2020-02-09]
BAI_TAP_SOLIDWORKS/AN_HONG/Project_BIA_HHT1/FILE 1/gia bat vitme.SLDPRT
97.0 x 78.5 x 10.0 mm
