huan95nd/BAI_TAP_PHAN_MEM/BAI_TAP_SOLIDWORKS/AN_HONG/Project_BIA_HHT1/tru-dung.SLDPRT

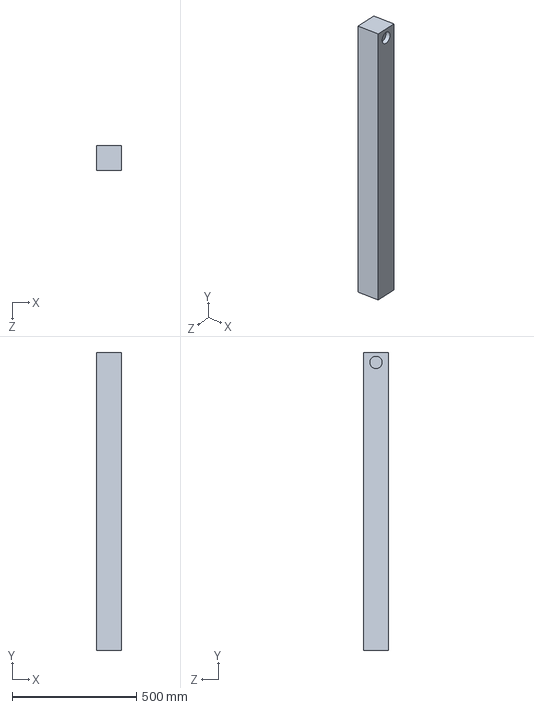
[picture p50: CAD file, 2020-02-09]
BAI_TAP_SOLIDWORKS/AN_HONG/Project_BIA_HHT1/tru-dung.SLDPRT
100.0 x 1200.0 x 100.0 mm
