huan95nd/BAI_TAP_PHAN_MEM/BAI_TAP_SOLIDWORKS/Ban_le/8020-2061/Part1.SLDPRT

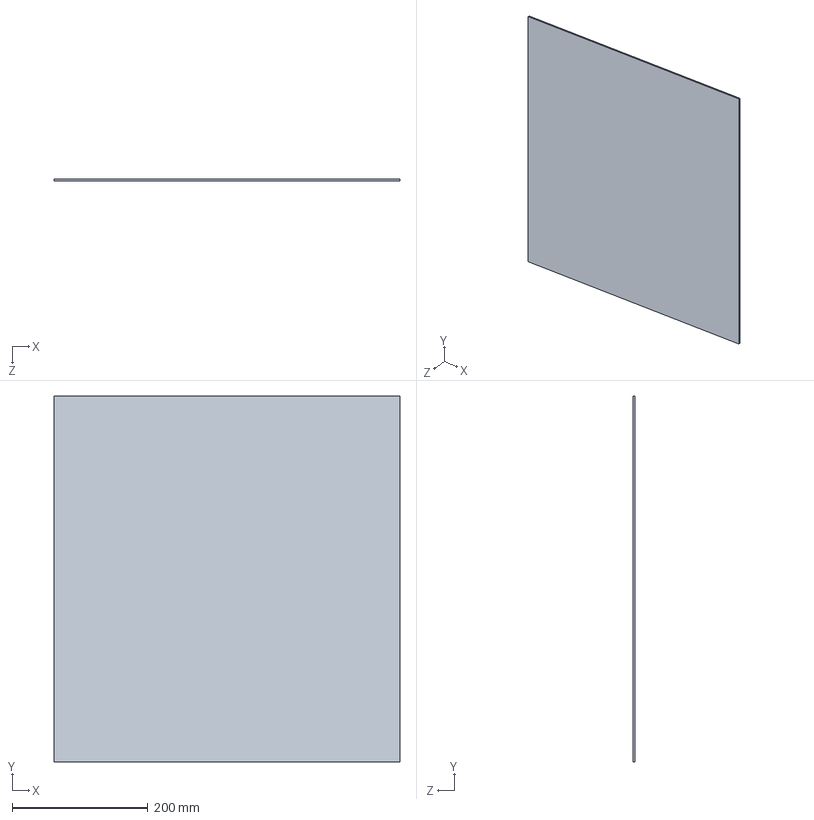
[picture p51: CAD file, 2020-02-09]
BAI_TAP_SOLIDWORKS/Ban_le/8020-2061/Part1.SLDPRT
510.0 x 540.0 x 3.00 mm
