huan95nd/BAI_TAP_PHAN_MEM/BAI_TAP_SOLIDWORKS/Ban_le/8020-2134 Hinge Door Configuration/Part5.SLDPRT

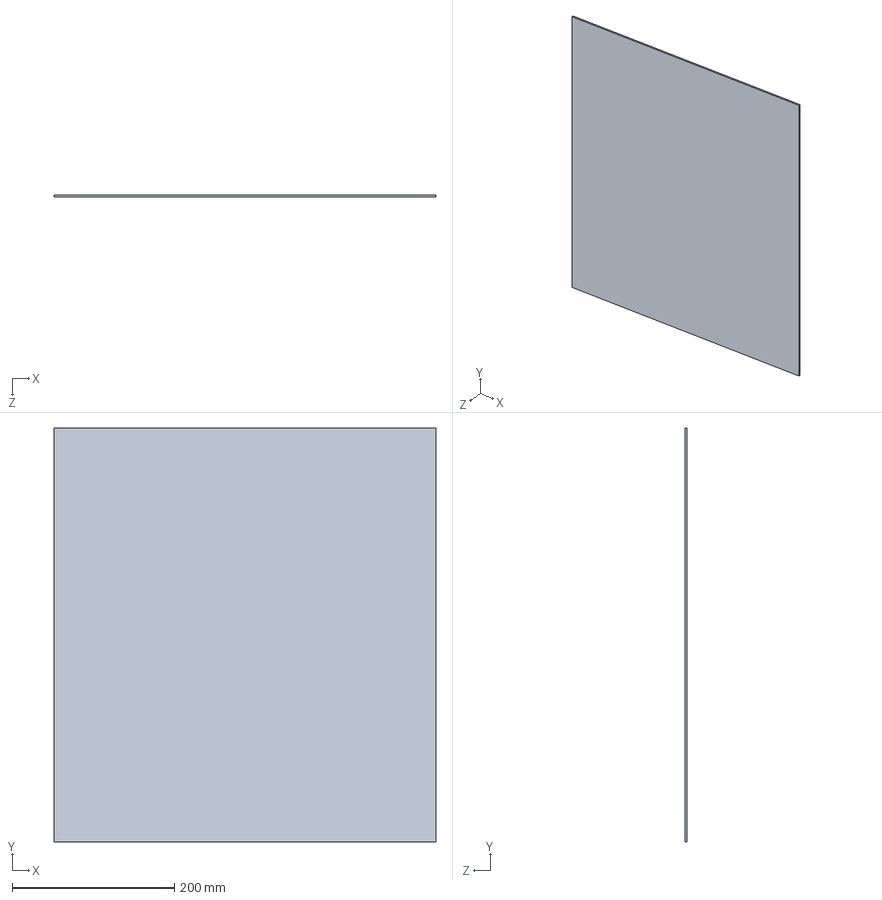
[picture p52: CAD file, 2020-02-09]
BAI_TAP_SOLIDWORKS/Ban_le/8020-2134 Hinge Door Configuration/Part5.SLDPRT
470.0 x 510.0 x 3.00 mm
