huan95nd/BAI_TAP_PHAN_MEM/BAI_TAP_SOLIDWORKS/Ban_le/SierraPacific-BH7005BP/SierraPacific-BH7005BP.SLDPRT

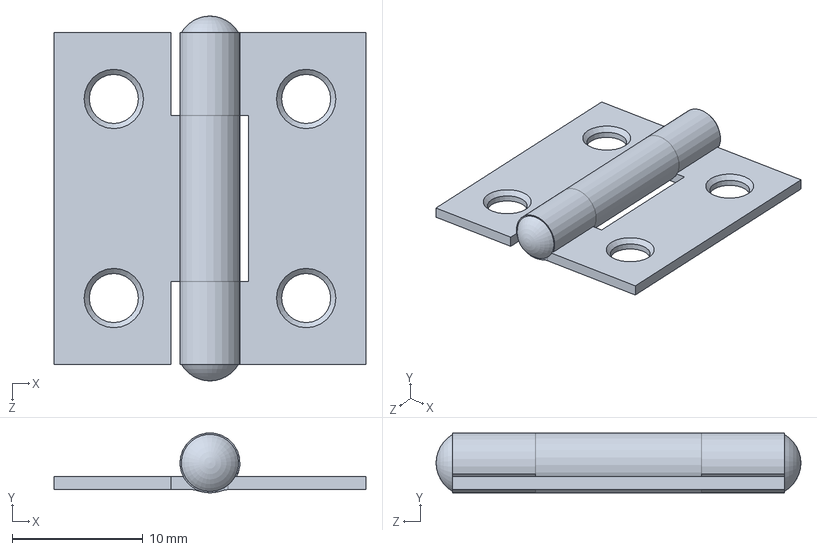
[picture p53: CAD file, 2020-02-09]
BAI_TAP_SOLIDWORKS/Ban_le/SierraPacific-BH7005BP/SierraPacific-BH7005BP.SLDPRT
23.9 x 4.59 x 27.9 mm
