huan95nd/BAI_TAP_PHAN_MEM/BAI_TAP_SOLIDWORKS/Ban_le/SierraPacific-M1005/SierraPacific-M1005.SLDPRT

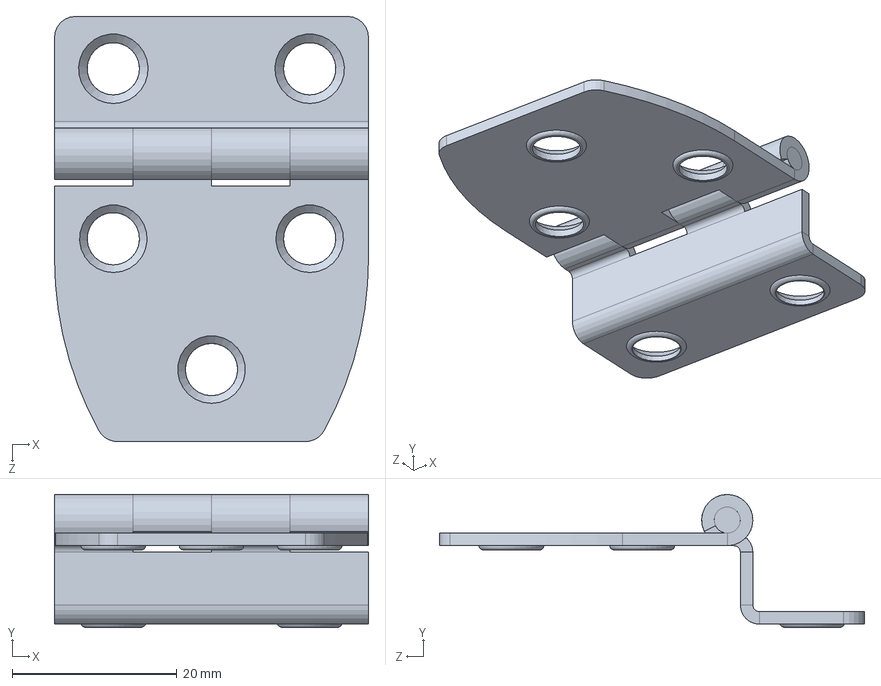
[picture p54: CAD file, 2020-02-09]
BAI_TAP_SOLIDWORKS/Ban_le/SierraPacific-M1005/SierraPacific-M1005.SLDPRT
38.1 x 16.2 x 51.6 mm
