huan95nd/BAI_TAP_PHAN_MEM/BAI_TAP_SOLIDWORKS/bang tai/96223304-19-c-040-20-400-pvc-m1-a1-r_74_70_0_2/c-040-20-400-pvc-m1-a1-r_74_70_0_2.stp

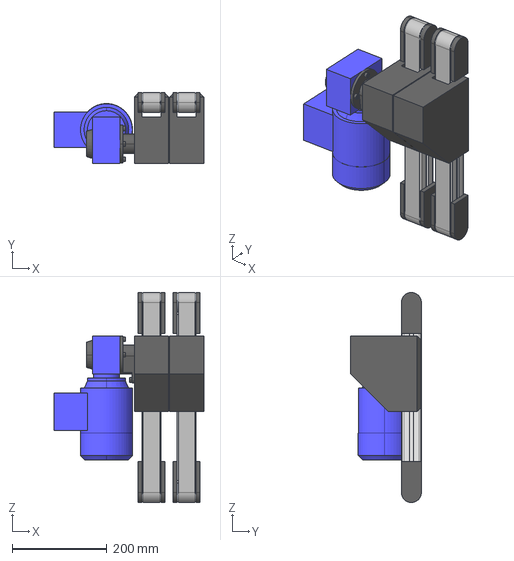
[picture p55: CAD file, 2020-02-09]
BAI_TAP_SOLIDWORKS/bang tai/96223304-19-c-040-20-400-pvc-m1-a1-r_74_70_0_2/c-040-20-400-pvc-m1-a1-r_74_70_0_2.stp
315.0 x 149.1 x 442.2 mm
