huan95nd/BAI_TAP_PHAN_MEM/BAI_TAP_SOLIDWORKS/bang tai/96223307-19-c-040-41-400-t5_par_paz-m1-a1-r_133_0_2/c-040-41-400-t5_par_paz-m1-a1-r_133_0_2.stp

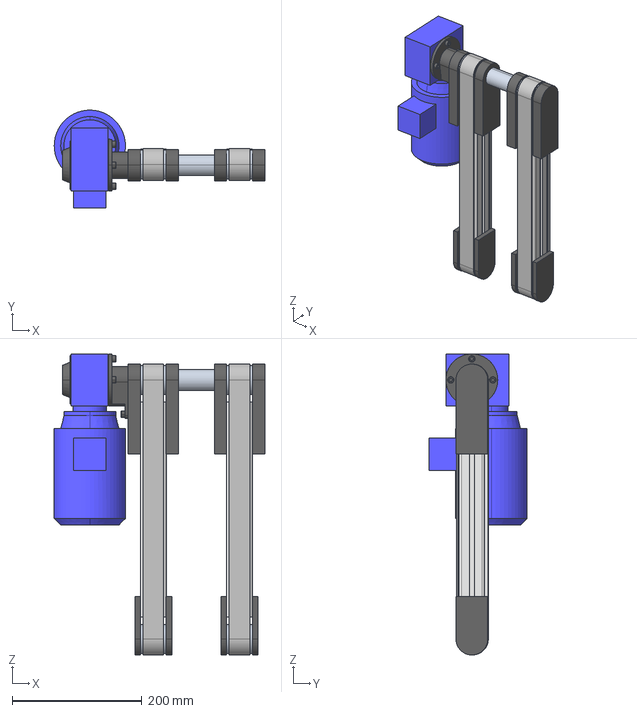
[picture p56: CAD file, 2020-02-09]
BAI_TAP_SOLIDWORKS/bang tai/96223307-19-c-040-41-400-t5_par_paz-m1-a1-r_133_0_2/c-040-41-400-t5_par_paz-m1-a1-r_133_0_2.stp
325.0 x 151.0 x 464.5 mm
