huan95nd/BAI_TAP_PHAN_MEM/BAI_TAP_SOLIDWORKS/bang tai/96223312-19-minitec_29_5033_0_35ppeglpb9pa7qzzlsu53eo0n/minitec_29_5033_0_35ppeglpb9pa7qzzlsu53eo0n.stp

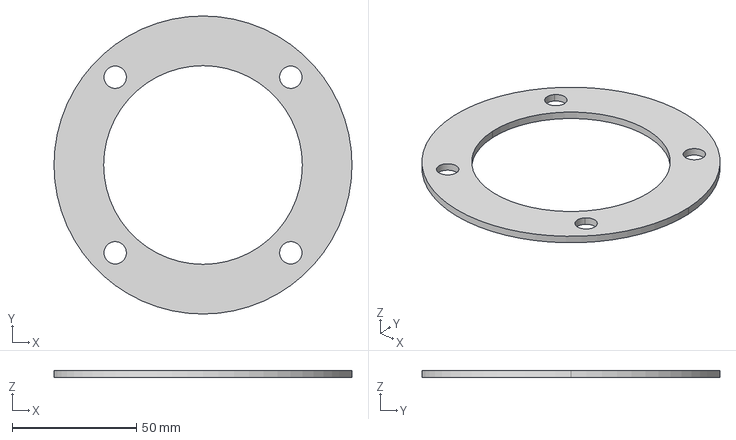
[picture p57: CAD file, 2020-02-09]
BAI_TAP_SOLIDWORKS/bang tai/96223312-19-minitec_29_5033_0_35ppeglpb9pa7qzzlsu53eo0n/minitec_29_5033_0_35ppeglpb9pa7qzzlsu53eo0n.stp
120.0 x 120.0 x 3.00 mm
