huan95nd/BAI_TAP_PHAN_MEM/BAI_TAP_SOLIDWORKS/bang tai/User Library-hytrol model tr horizontal belt conveyor/User Library-hytrol model tr horizontal belt conveyor.sldprt

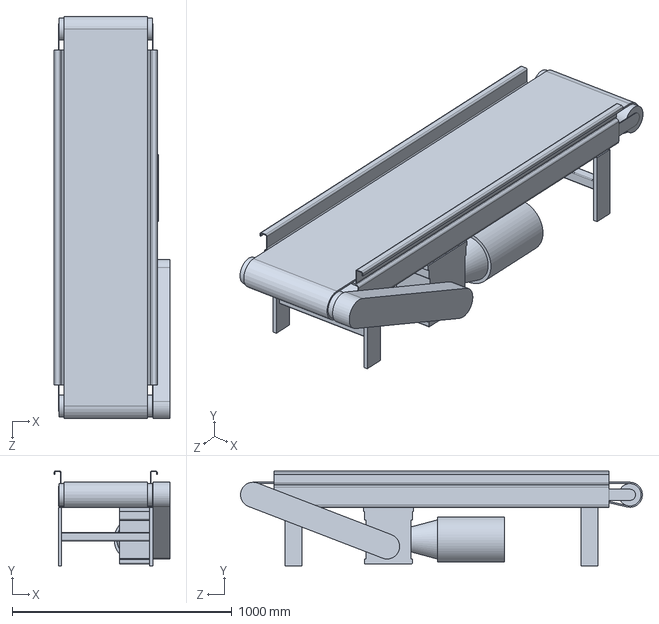
[picture p58: CAD file, 2020-02-09]
BAI_TAP_SOLIDWORKS/bang tai/User Library-hytrol model tr horizontal belt conveyor/User Library-hytrol model tr horizontal belt conveyor.sldprt
527.1 x 431.8 x 1828.8 mm
