huan95nd/BAI_TAP_PHAN_MEM/BAI_TAP_SOLIDWORKS/Banh_rang/gear-525.snapshot.1/gear.SLDPRT

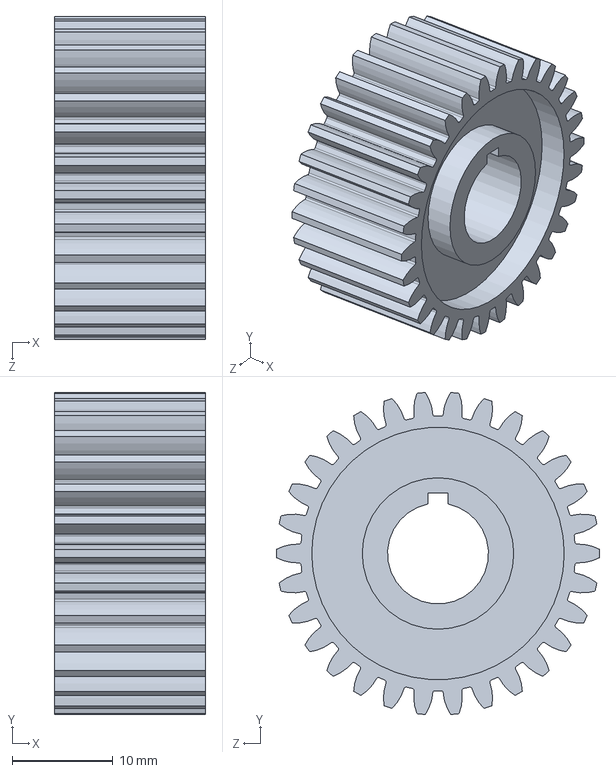
[picture p59: CAD file, 2020-02-09]
BAI_TAP_SOLIDWORKS/Banh_rang/gear-525.snapshot.1/gear.SLDPRT
15.0 x 31.9 x 32.0 mm
