huan95nd/BAI_TAP_PHAN_MEM/BAI_TAP_SOLIDWORKS/Den thap/96223199-19-lr4-3m2ljnw-ryg/lr4-3m2ljnw-ryg.step

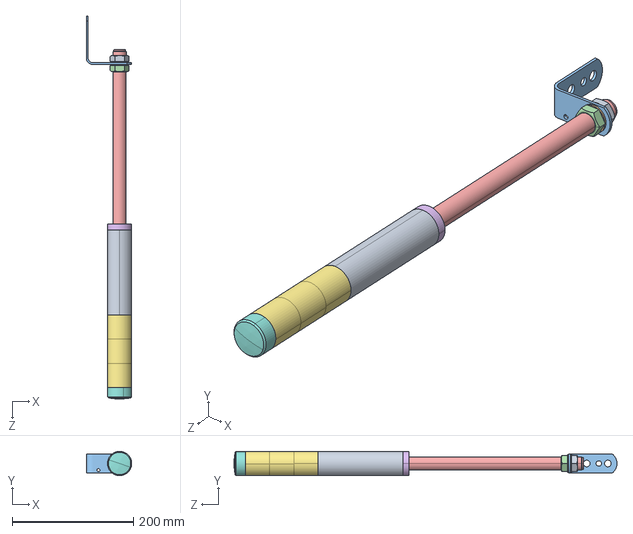
[picture p60: CAD file, 2020-02-09]
BAI_TAP_SOLIDWORKS/Den thap/96223199-19-lr4-3m2ljnw-ryg/lr4-3m2ljnw-ryg.step
75.0 x 40.0 x 632.0 mm
