huan95nd/BAI_TAP_PHAN_MEM/BAI_TAP_SOLIDWORKS/Dong_co_DC/bevel-gear-mechanism-4.snapshot.1/齿轮轴.SLDPRT

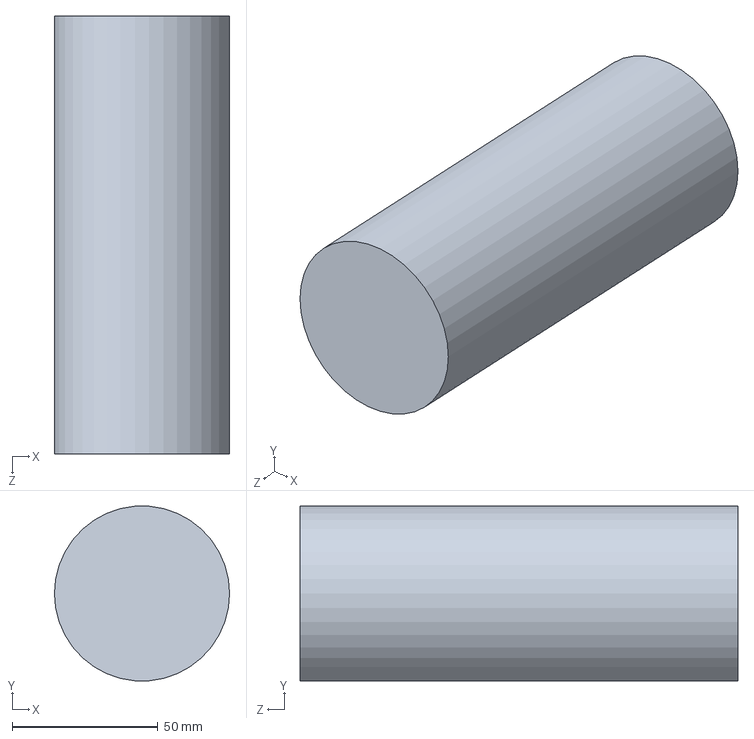
[picture p61: CAD file, 2020-02-09]
BAI_TAP_SOLIDWORKS/Dong_co_DC/bevel-gear-mechanism-4.snapshot.1/齿轮轴.SLDPRT
60.0 x 59.8 x 150.0 mm
