huan95nd/BAI_TAP_PHAN_MEM/BAI_TAP_SOLIDWORKS/Dong_co_DC/Bison-021725DCSHORT-DEFAULT/Bison-021725DCSHORT-$PARTNUMBER.SLDPRT

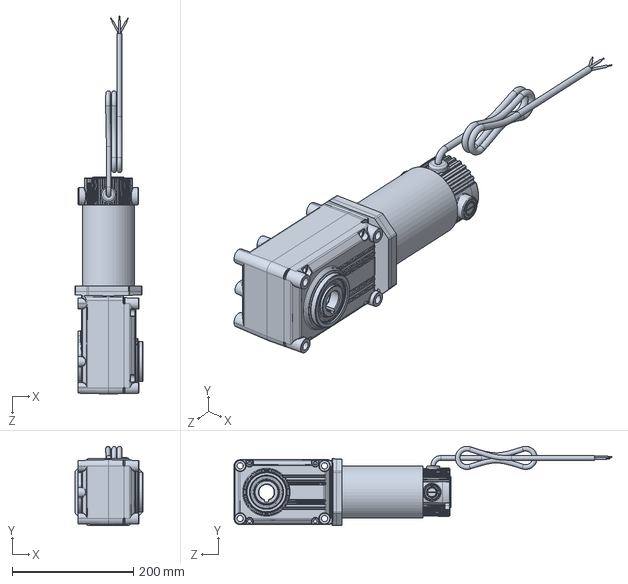
[picture p62: CAD file, 2020-02-09]
BAI_TAP_SOLIDWORKS/Dong_co_DC/Bison-021725DCSHORT-DEFAULT/Bison-021725DCSHORT-$PARTNUMBER.SLDPRT
112.2 x 130.8 x 622.5 mm
