huan95nd/BAI_TAP_PHAN_MEM/BAI_TAP_SOLIDWORKS/Dong_co_DC/GearWurx-i06324_01_MN_TRXS_2_0/GearWurx-i06324_01_MN_TRXS_2_0.SLDPRT

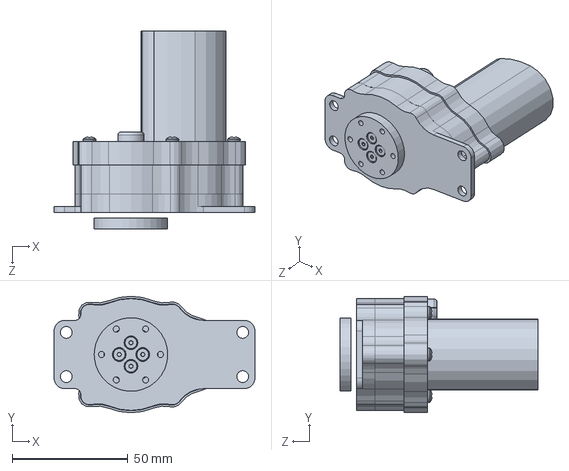
[picture p63: CAD file, 2020-02-09]
BAI_TAP_SOLIDWORKS/Dong_co_DC/GearWurx-i06324_01_MN_TRXS_2_0/GearWurx-i06324_01_MN_TRXS_2_0.SLDPRT
86.8 x 50.3 x 85.4 mm
