huan95nd/BAI_TAP_PHAN_MEM/BAI_TAP_SOLIDWORKS/Dong_co_DC/User Library-ml-50 MOTOR from ROBOT MARKETPLACE_COM/User Library-ml-50 MOTOR from ROBOT MARKETPLACE_COM.sldprt

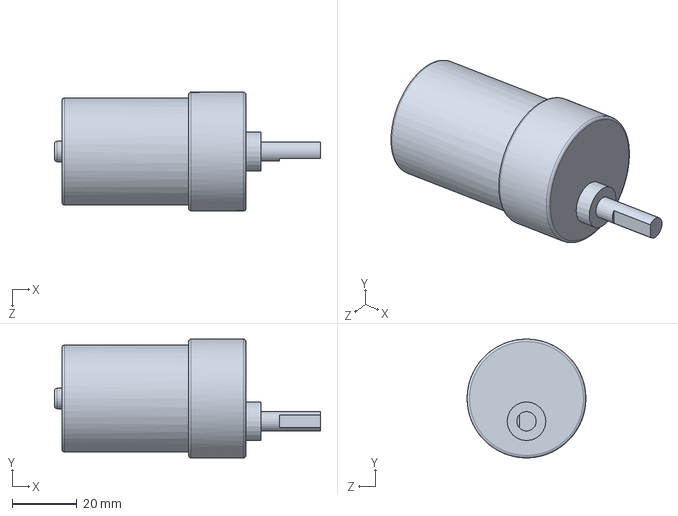
[picture p64: CAD file, 2020-02-09]
BAI_TAP_SOLIDWORKS/Dong_co_DC/User Library-ml-50 MOTOR from ROBOT MARKETPLACE_COM/User Library-ml-50 MOTOR from ROBOT MARKETPLACE_COM.sldprt
82.2 x 36.7 x 36.7 mm
