huan95nd/BAI_TAP_PHAN_MEM/BAI_TAP_SOLIDWORKS/Dong_co_DC/User Library-motors_banebots rs-775/User Library-motors_banebots rs-775.sldprt

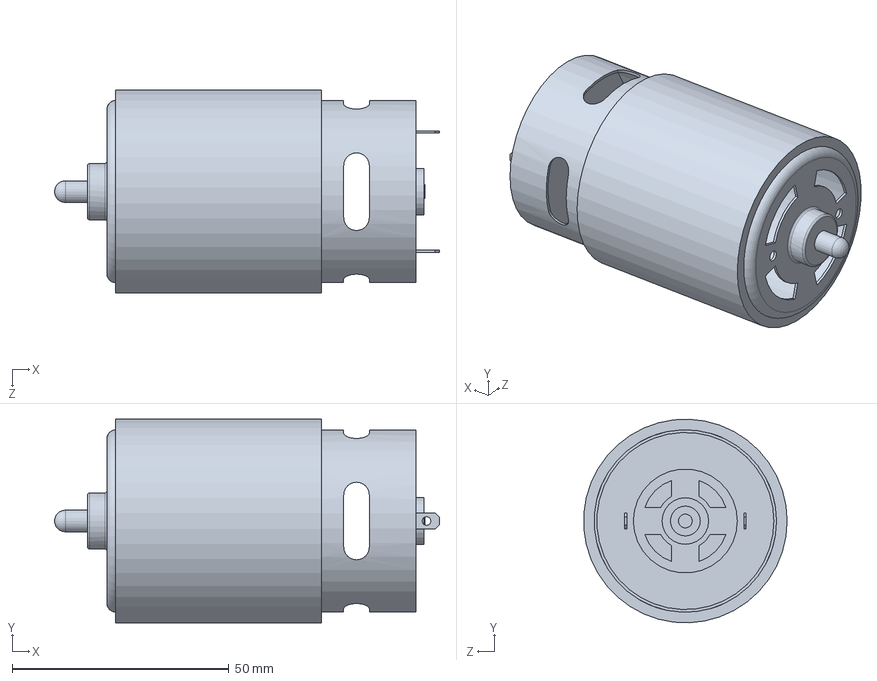
[picture p65: CAD file, 2020-02-09]
BAI_TAP_SOLIDWORKS/Dong_co_DC/User Library-motors_banebots rs-775/User Library-motors_banebots rs-775.sldprt
88.8 x 47.0 x 46.9 mm
