huan95nd/BAI_TAP_PHAN_MEM/BAI_TAP_SOLIDWORKS/ga vision/CMD --Vision S/CMD --Vision S.SLDPRT

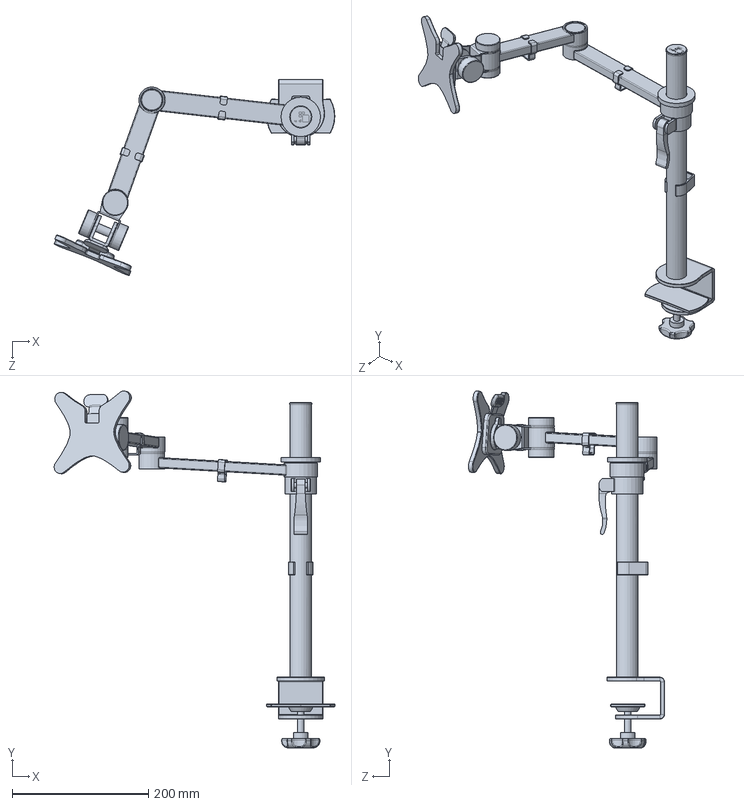
[picture p66: CAD file, 2020-02-09]
BAI_TAP_SOLIDWORKS/ga vision/CMD --Vision S/CMD --Vision S.SLDPRT
412.0 x 523.9 x 287.9 mm
