huan95nd/BAI_TAP_PHAN_MEM/BAI_TAP_SOLIDWORKS/ga vision/pss24-100.SLDPRT

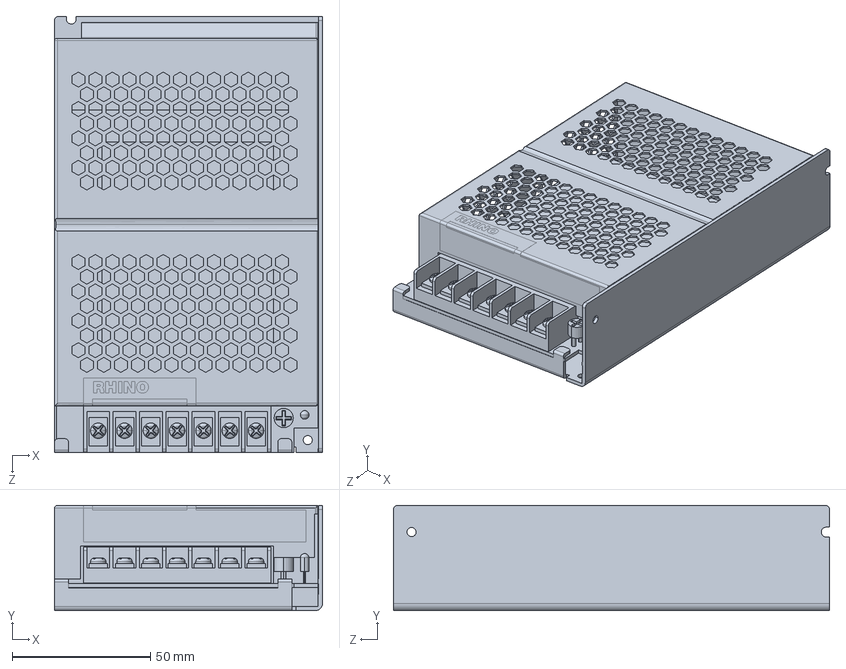
[picture p67: CAD file, 2020-02-09]
BAI_TAP_SOLIDWORKS/ga vision/pss24-100.SLDPRT
97.0 x 38.1 x 158.0 mm
