huan95nd/BAI_TAP_PHAN_MEM/BAI_TAP_SOLIDWORKS/Nhom_dinh_hinh/8020-20-2020 X 4 M.SLDPRT/8020-20-2020-20-2020 X 4 M.SLDPRT

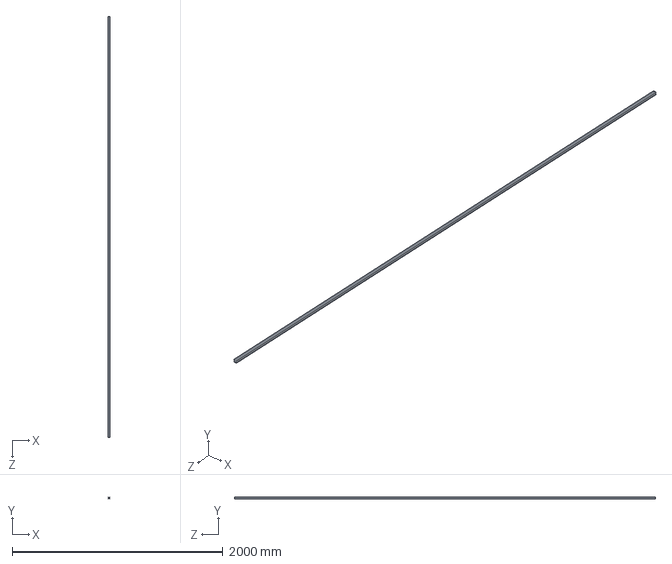
[picture p68: CAD file, 2020-02-09]
BAI_TAP_SOLIDWORKS/Nhom_dinh_hinh/8020-20-2020 X 4 M.SLDPRT/8020-20-2020-20-2020 X 4 M.SLDPRT
20.0 x 20.0 x 4000.0 mm
