huan95nd/BAI_TAP_PHAN_MEM/BAI_TAP_SOLIDWORKS/Nhom_dinh_hinh/8020-30-3030 X 4000.SLDPRT/8020-30-3030-30-3030 X 4000.SLDPRT

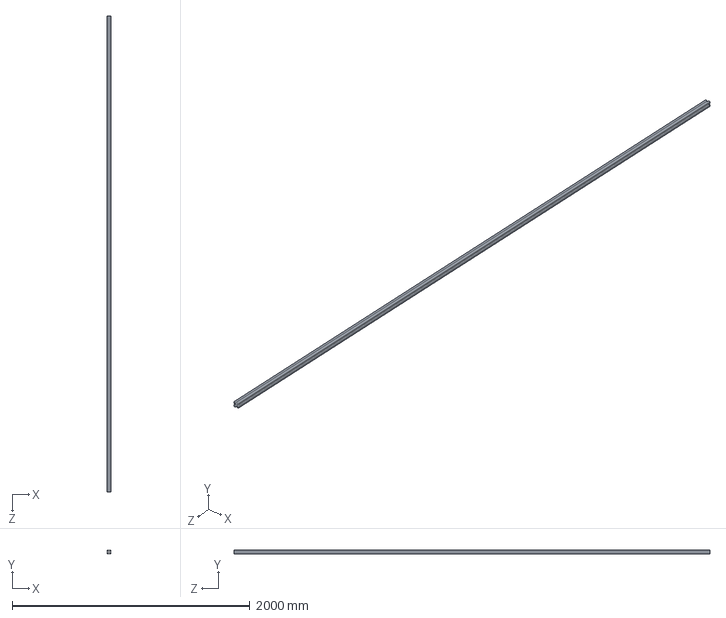
[picture p70: CAD file, 2020-02-09]
BAI_TAP_SOLIDWORKS/Nhom_dinh_hinh/8020-30-3030 X 4000.SLDPRT/8020-30-3030-30-3030 X 4000.SLDPRT
30.0 x 30.0 x 4000.0 mm
