huan95nd/BAI_TAP_PHAN_MEM/BAI_TAP_SOLIDWORKS/Nhom_dinh_hinh/8020-30-6060 X 4000.SLDPRT/8020-30-6060-30-6060 X 4000.SLDPRT

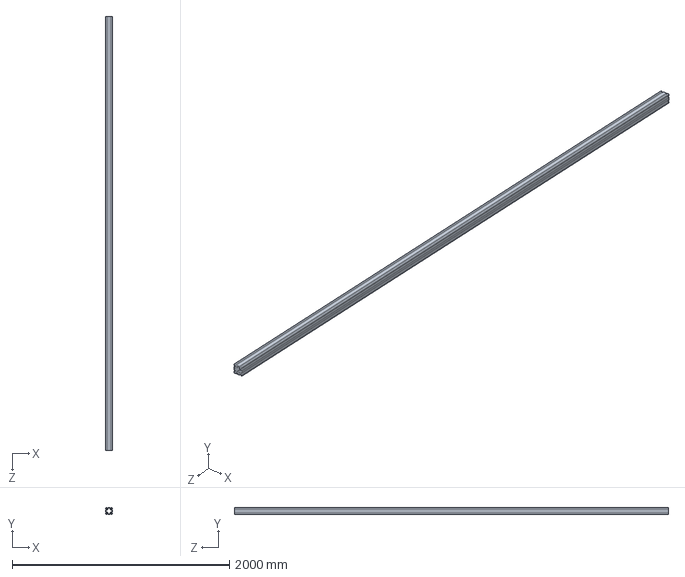
[picture p71: CAD file, 2020-02-09]
BAI_TAP_SOLIDWORKS/Nhom_dinh_hinh/8020-30-6060 X 4000.SLDPRT/8020-30-6060-30-6060 X 4000.SLDPRT
60.0 x 60.0 x 4000.0 mm
