huan95nd/BAI_TAP_PHAN_MEM/BAI_TAP_SOLIDWORKS/Nhom_dinh_hinh/8020-3060 X 145.SLDPRT/8020-30-3060-BLACK-FB-30-3060-BLACK-FB X 4000.SLDPRT

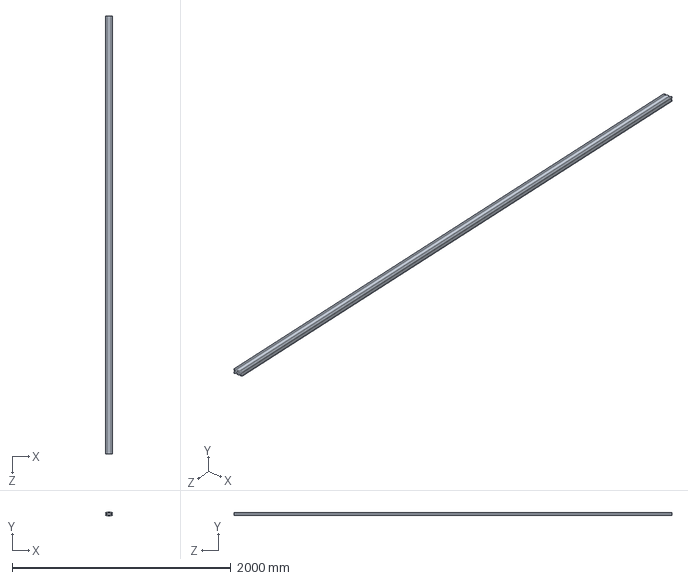
[picture p72: CAD file, 2020-02-09]
BAI_TAP_SOLIDWORKS/Nhom_dinh_hinh/8020-3060 X 145.SLDPRT/8020-30-3060-BLACK-FB-30-3060-BLACK-FB X 4000.SLDPRT
60.0 x 30.0 x 4000.0 mm
