huan95nd/BAI_TAP_PHAN_MEM/BAI_TAP_SOLIDWORKS/Nhom_dinh_hinh/8020-40-4040 X 4000.SLDPRT/8020-40-4040-40-4040 X 4000.SLDPRT

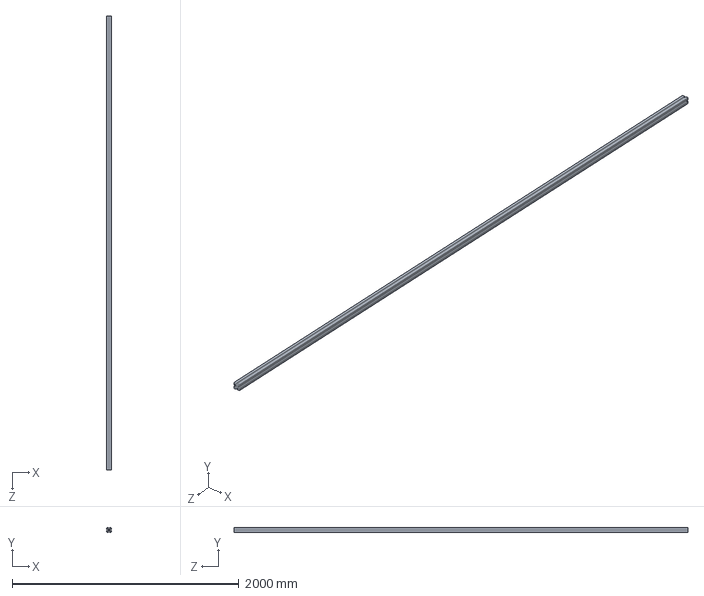
[picture p73: CAD file, 2020-02-09]
BAI_TAP_SOLIDWORKS/Nhom_dinh_hinh/8020-40-4040 X 4000.SLDPRT/8020-40-4040-40-4040 X 4000.SLDPRT
40.0 x 40.0 x 4000.0 mm
