huan95nd/BAI_TAP_PHAN_MEM/BAI_TAP_SOLIDWORKS/Nhom_dinh_hinh/8020-40-4080 X 4000.SLDPRT/8020-40-4080-40-4080 X 4000.SLDPRT

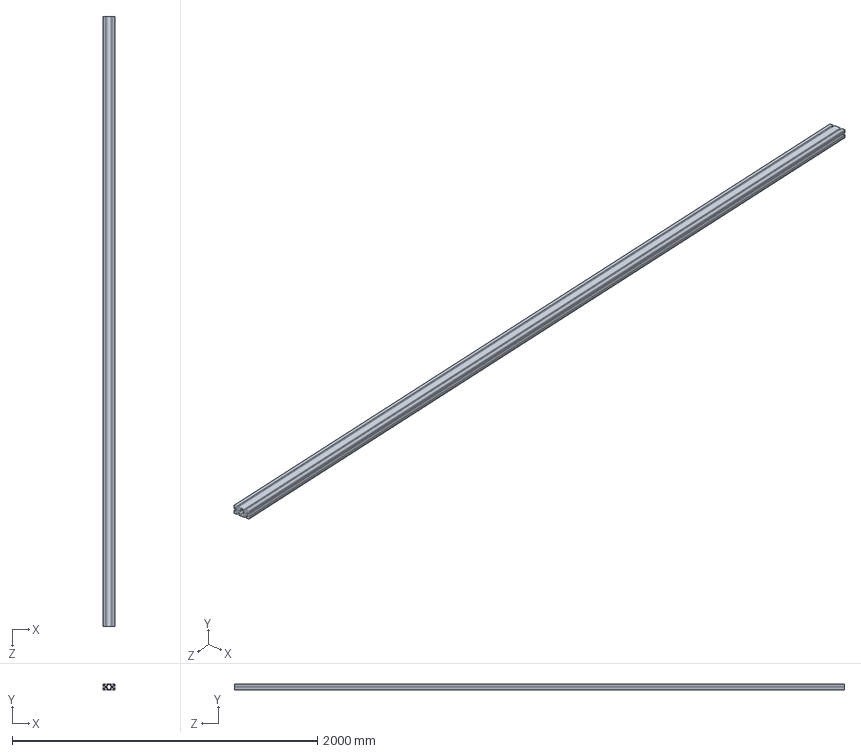
[picture p74: CAD file, 2020-02-09]
BAI_TAP_SOLIDWORKS/Nhom_dinh_hinh/8020-40-4080 X 4000.SLDPRT/8020-40-4080-40-4080 X 4000.SLDPRT
80.0 x 40.0 x 4000.0 mm
