huan95nd/BAI_TAP_PHAN_MEM/BAI_TAP_SOLIDWORKS/robot/User Library-6-axis robot abb6650_320_125/User Library-6-axis robot abb6650_320_125_IRB6650_320-125_m2000_rev2_01-4.sldprt

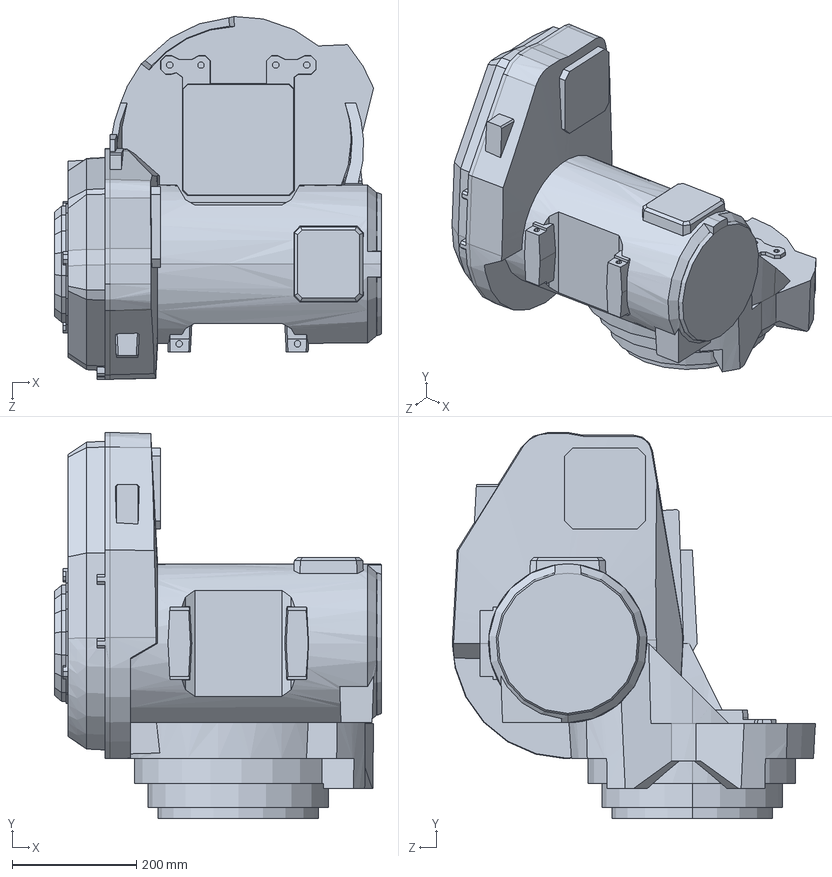
[picture p76: CAD file, 2020-02-10]
BAI_TAP_SOLIDWORKS/robot/User Library-6-axis robot abb6650_320_125/User Library-6-axis robot abb6650_320_125_IRB6650_320-125_m2000_rev2_01-4.sldprt
526.3 x 620.4 x 583.4 mm
