huan95nd/BAI_TAP_PHAN_MEM/BAI_TAP_SOLIDWORKS/tay quay/96223232-19-haldern_eh_2433_010_/haldern_eh_2433_010_.stp

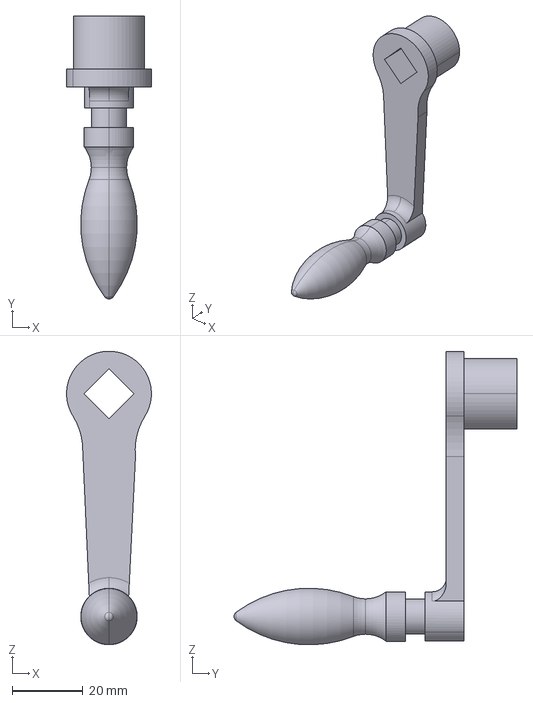
[picture p77: CAD file, 2020-02-09]
BAI_TAP_SOLIDWORKS/tay quay/96223232-19-haldern_eh_2433_010_/haldern_eh_2433_010_.stp
24.0 x 80.0 x 83.0 mm
