huan95nd/BAI_TAP_PHAN_MEM/BAI_TAP_SOLIDWORKS/AN_HONG/FCC_2/Part9.SLDPRT

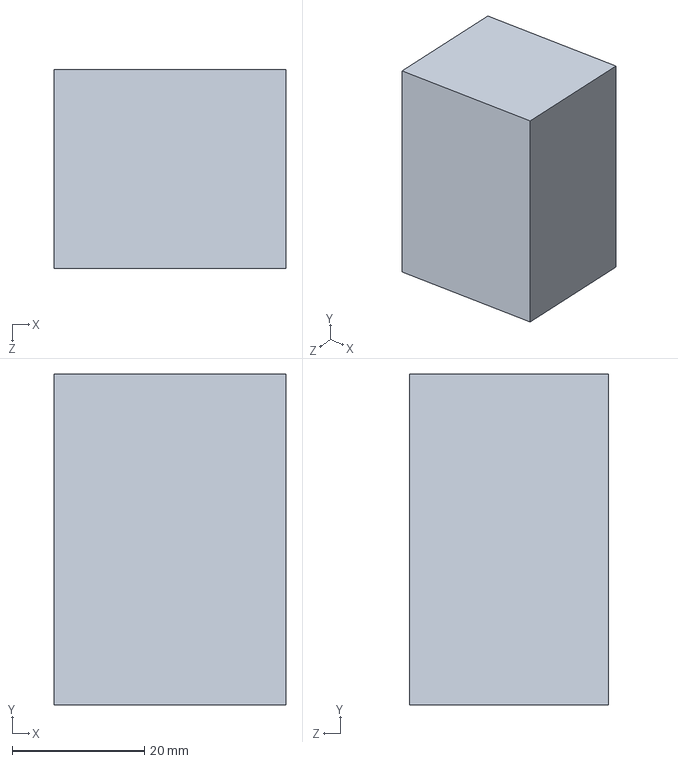
[picture p79: CAD file, 2020-02-09]
BAI_TAP_SOLIDWORKS/AN_HONG/FCC_2/Part9.SLDPRT
35.0 x 50.0 x 30.0 mm
