huan95nd/BAI_TAP_PHAN_MEM/BAI_TAP_SOLIDWORKS/AN_HONG/gia_camera_demo-master/gia_camera_demo-master/NORDEX-MIX-A1-3-230/NORDEX-MIX-A1-3-230_MIX-A1-Carriage.SLDPRT

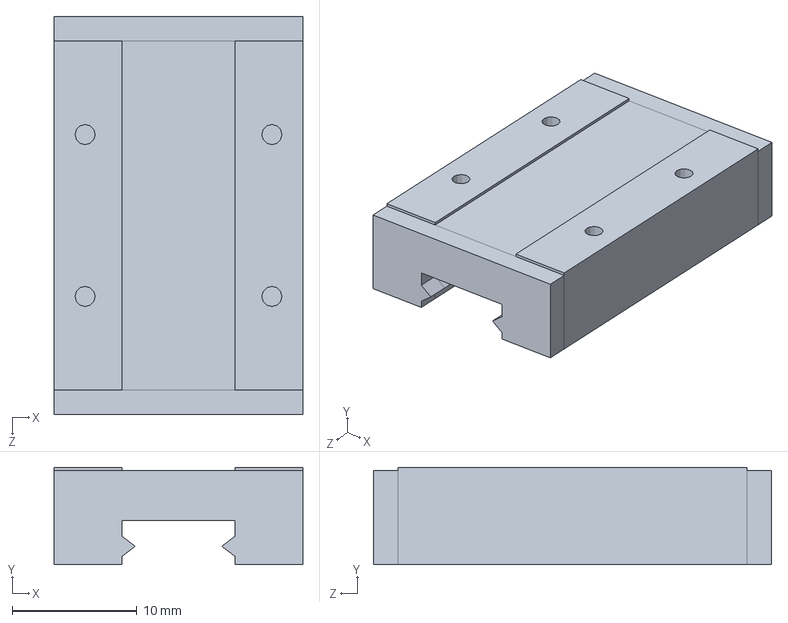
[picture p81: CAD file, 2020-03-10]
BAI_TAP_SOLIDWORKS/AN_HONG/gia_camera_demo-master/gia_camera_demo-master/NORDEX-MIX-A1-3-230/NORDEX-MIX-A1-3-230_MIX-A1-Carriage.SLDPRT
20.0 x 7.80 x 32.0 mm
