huan95nd/BAI_TAP_PHAN_MEM/BAI_TAP_SOLIDWORKS/AN_HONG/MV40MicroHAWK_Drawings/STEP/98-9000054-01.STEP

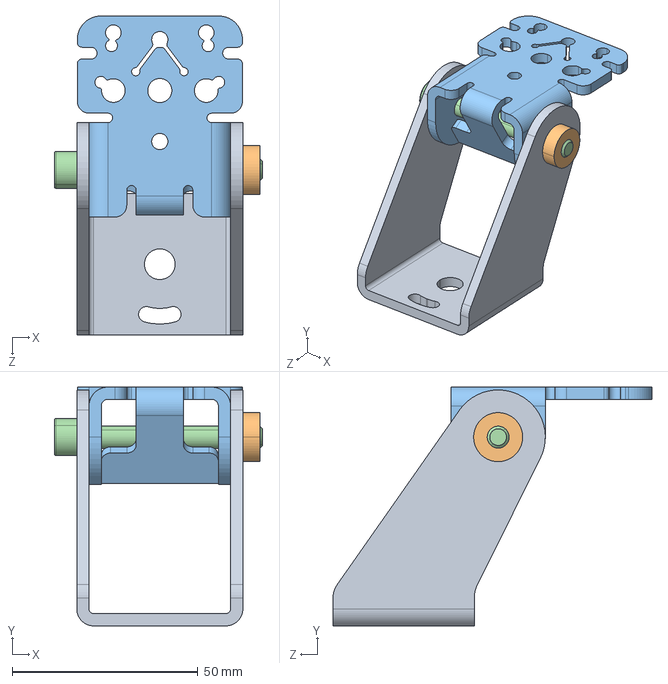
[picture p82: CAD file, 2020-02-09]
BAI_TAP_SOLIDWORKS/AN_HONG/MV40MicroHAWK_Drawings/STEP/98-9000054-01.STEP
56.0 x 64.3 x 85.9 mm
