huan95nd/BAI_TAP_PHAN_MEM/BAI_TAP_SOLIDWORKS/AN_HONG/Project_BIA_HHT1/FILE 1/truc do laser6.SLDPRT

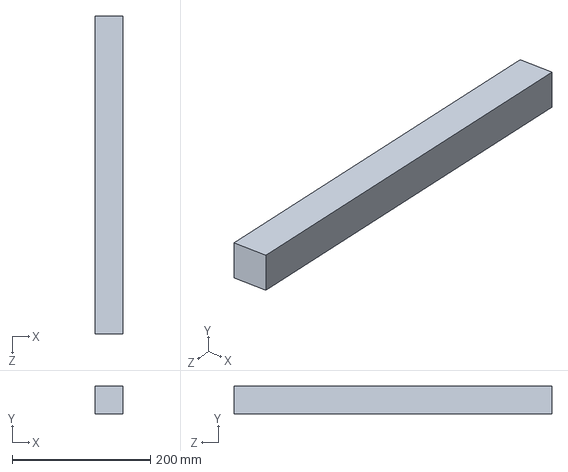
[picture p83: CAD file, 2020-02-09]
BAI_TAP_SOLIDWORKS/AN_HONG/Project_BIA_HHT1/FILE 1/truc do laser6.SLDPRT
40.0 x 40.0 x 460.0 mm
