huan95nd/BAI_TAP_PHAN_MEM/BAI_TAP_SOLIDWORKS/AN_HONG/Project_BIA_HHT1/tam-nen.SLDPRT

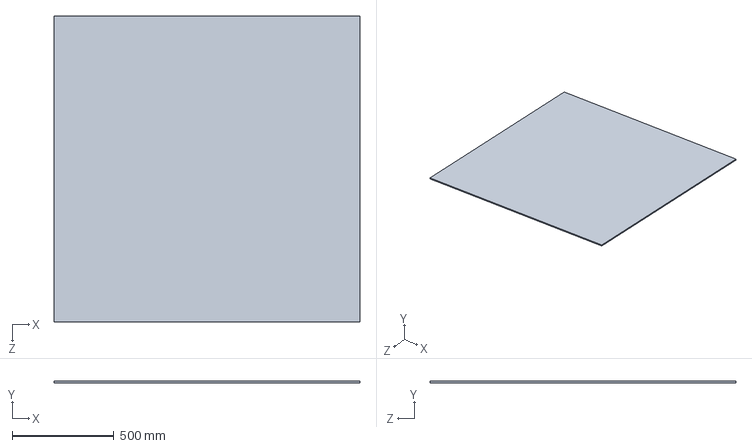
[picture p84: CAD file, 2020-02-09]
BAI_TAP_SOLIDWORKS/AN_HONG/Project_BIA_HHT1/tam-nen.SLDPRT
1500.0 x 8.00 x 1500.0 mm
