huan95nd/BAI_TAP_PHAN_MEM/BAI_TAP_SOLIDWORKS/Ban_le/8020-2134 Hinge Door Configuration/8020-2134 Hinge Door Configuration-$PARTNUMBER_Ball Latch.sldprt

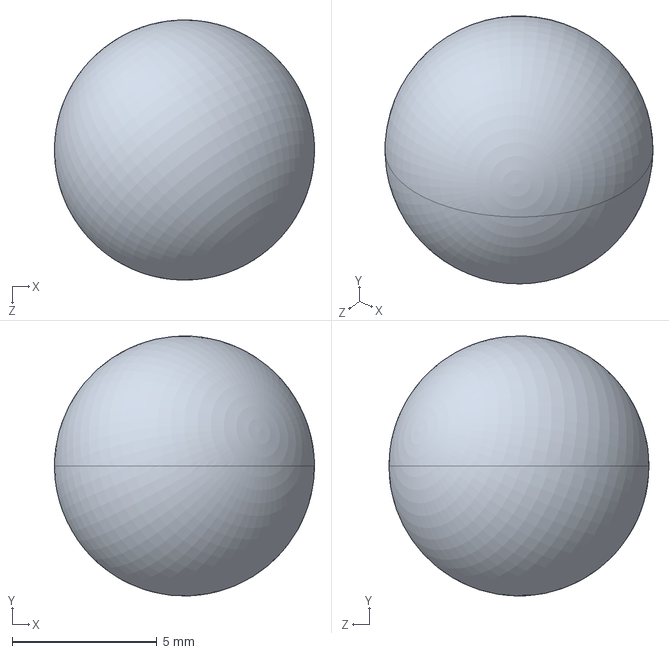
[picture p85: CAD file, 2020-02-09]
BAI_TAP_SOLIDWORKS/Ban_le/8020-2134 Hinge Door Configuration/8020-2134 Hinge Door Configuration-$PARTNUMBER_Ball Latch.sldprt
8.99 x 8.98 x 8.99 mm
