huan95nd/BAI_TAP_PHAN_MEM/BAI_TAP_SOLIDWORKS/Banh_rang/gear-525.snapshot.1/gear - Sao chép.SLDPRT

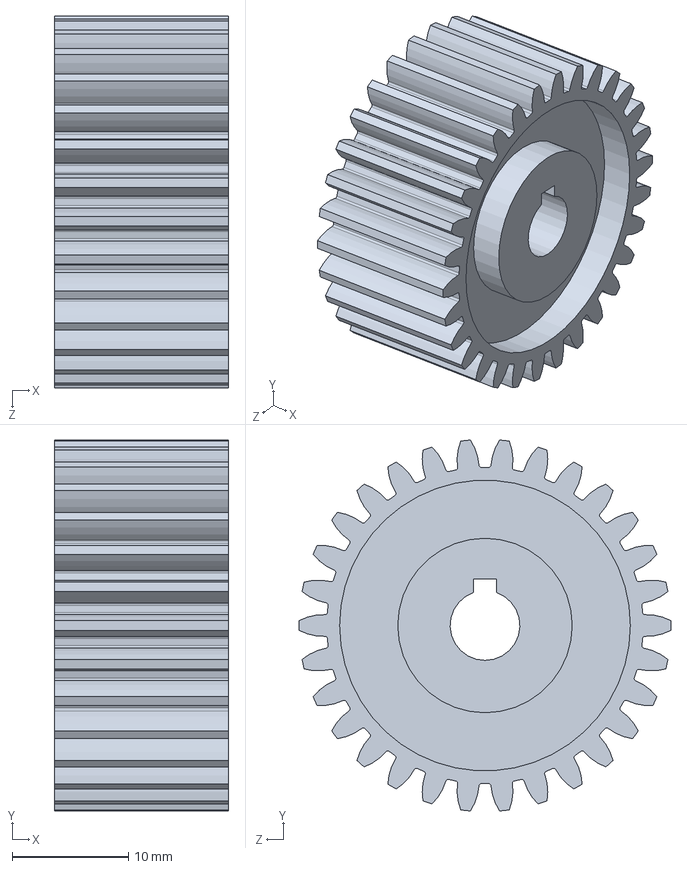
[picture p86: CAD file, 2020-02-09]
BAI_TAP_SOLIDWORKS/Banh_rang/gear-525.snapshot.1/gear - Sao chép.SLDPRT
15.0 x 31.9 x 32.0 mm
