huan95nd/BAI_TAP_PHAN_MEM/BAI_TAP_SOLIDWORKS/Nhom_dinh_hinh/8020-3060 X 145.SLDPRT/8020-3060- 3060 X 145.SLDPRT

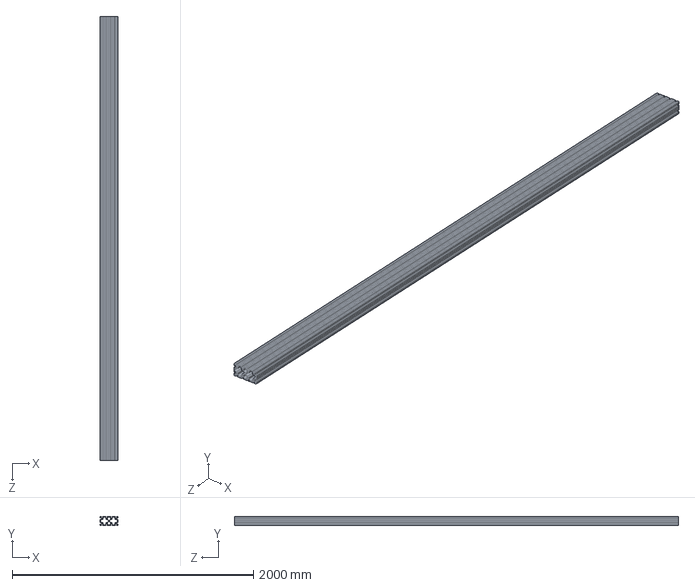
[picture p87: CAD file, 2020-02-09]
BAI_TAP_SOLIDWORKS/Nhom_dinh_hinh/8020-3060 X 145.SLDPRT/8020-3060- 3060 X 145.SLDPRT
152.4 x 76.2 x 3683.0 mm
