huan95nd/BAI_TAP_PHAN_MEM/BAI_TAP_SOLIDWORKS/robot/User Library-30 pound vert/User Library-30 pound vert_R Side Rail.SLDPRT

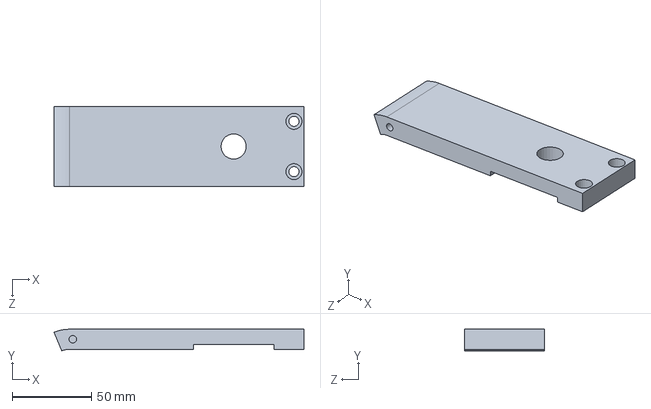
[picture p88: CAD file, 2020-02-10]
BAI_TAP_SOLIDWORKS/robot/User Library-30 pound vert/User Library-30 pound vert_R Side Rail.SLDPRT
157.9 x 13.7 x 50.8 mm
