huan95nd/BAI_TAP_PHAN_MEM/BAI_TAP_SOLIDWORKS/tay quay/96223232-19-haldern_eh_2433_010_/H04.080.010.1-Durovis.sldprt

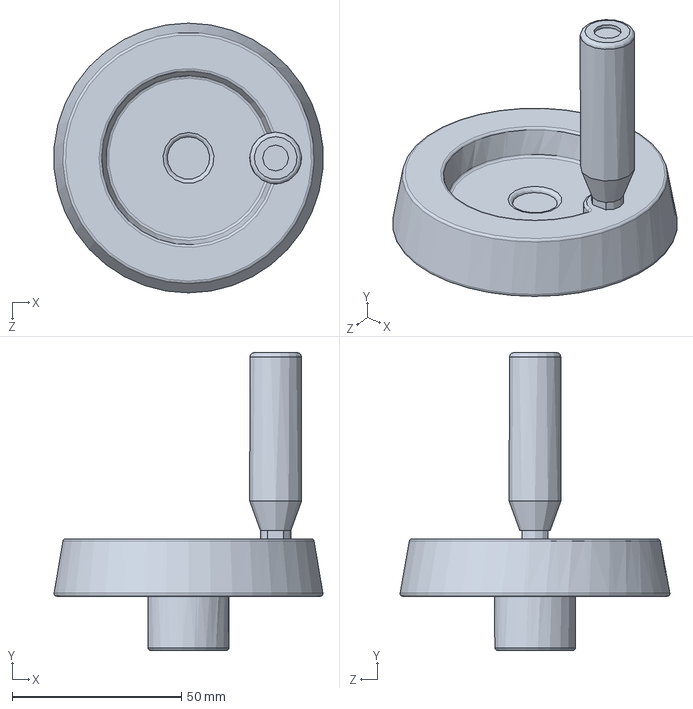
[picture p90: CAD file, 2020-02-09]
BAI_TAP_SOLIDWORKS/tay quay/96223232-19-haldern_eh_2433_010_/H04.080.010.1-Durovis.sldprt
79.4 x 88.0 x 79.7 mm
