huan95nd/BAI_TAP_PHAN_MEM/BAI_TAP_SOLIDWORKS/AN_HONG/gia_camera_demo-master/gia_camera_demo-master/NORDEX-MIX-A1-3-230/NORDEX-MIX-A1-3-230_MIX-A1-Base.SLDPRT

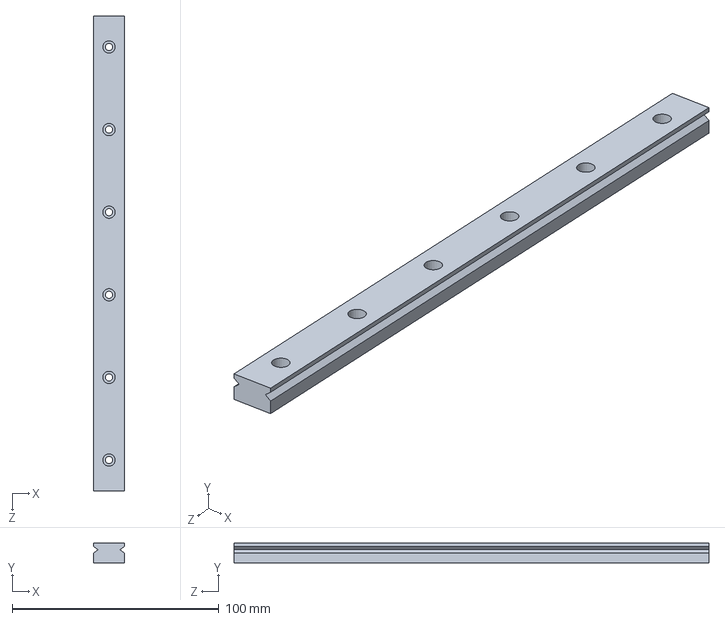
[picture p92: CAD file, 2020-03-10]
BAI_TAP_SOLIDWORKS/AN_HONG/gia_camera_demo-master/gia_camera_demo-master/NORDEX-MIX-A1-3-230/NORDEX-MIX-A1-3-230_MIX-A1-Base.SLDPRT
15.0 x 9.50 x 230.0 mm
