huan95nd/BAI_TAP_PHAN_MEM/BAI_TAP_SOLIDWORKS/AN_HONG/laser_khach_hang/laser_khach_hang/Nhom_giua.SLDPRT

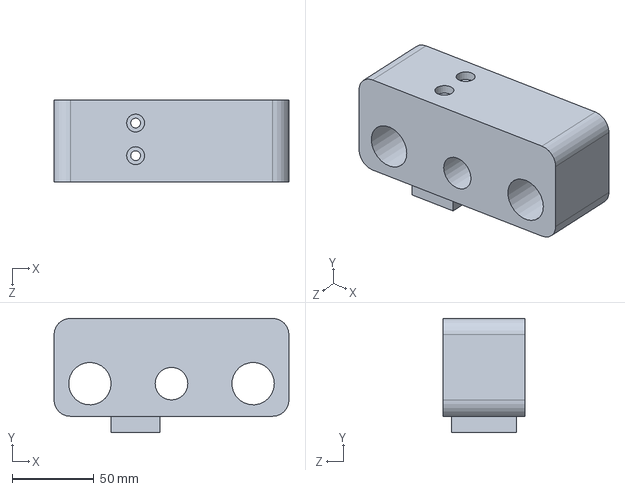
[picture p93: CAD file, 2020-03-07]
BAI_TAP_SOLIDWORKS/AN_HONG/laser_khach_hang/laser_khach_hang/Nhom_giua.SLDPRT
144.0 x 70.0 x 50.0 mm
