huan95nd/BAI_TAP_PHAN_MEM/BAI_TAP_SOLIDWORKS/AN_HONG/MV40MicroHAWK_Drawings/STEP/98-9000059-01.STEP

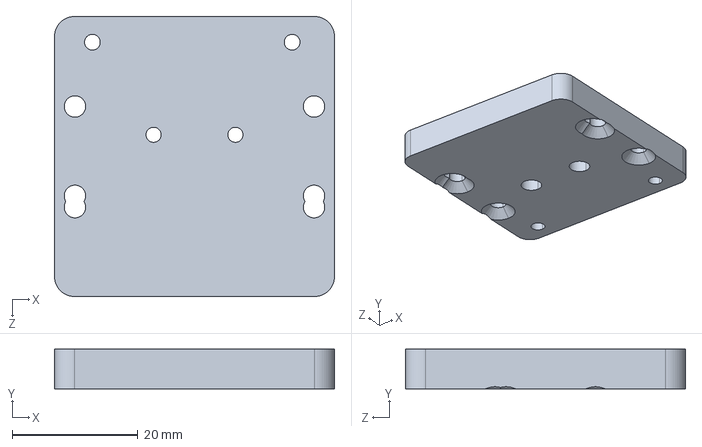
[picture p94: CAD file, 2020-02-09]
BAI_TAP_SOLIDWORKS/AN_HONG/MV40MicroHAWK_Drawings/STEP/98-9000059-01.STEP
44.5 x 6.35 x 44.5 mm
