huan95nd/BAI_TAP_PHAN_MEM/BAI_TAP_SOLIDWORKS/AN_HONG/Project_BIA_HHT1/tru-do-xilanh-giu-keg.SLDPRT

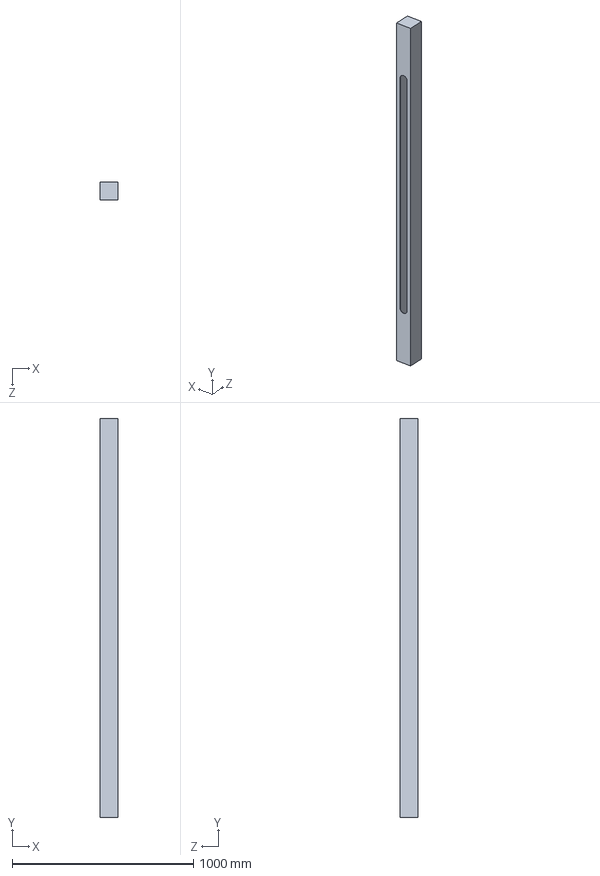
[picture p96: CAD file, 2020-02-09]
BAI_TAP_SOLIDWORKS/AN_HONG/Project_BIA_HHT1/tru-do-xilanh-giu-keg.SLDPRT
100.0 x 2200.0 x 100.0 mm
