huan95nd/BAI_TAP_PHAN_MEM/BAI_TAP_SOLIDWORKS/AN_HONG/videojet_8520/Part5.SLDPRT

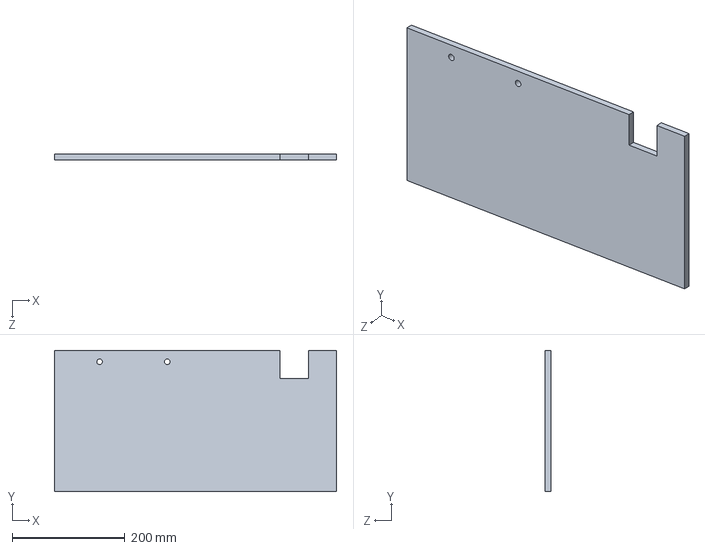
[picture p97: CAD file, 2020-03-10]
BAI_TAP_SOLIDWORKS/AN_HONG/videojet_8520/Part5.SLDPRT
500.0 x 250.0 x 10.0 mm
