huan95nd/BAI_TAP_PHAN_MEM/BAI_TAP_SOLIDWORKS/Ban_le/8020-2134 Hinge Door Configuration/8020-2134 Hinge Door Configuration-$PARTNUMBER_Latch Plate.sldprt

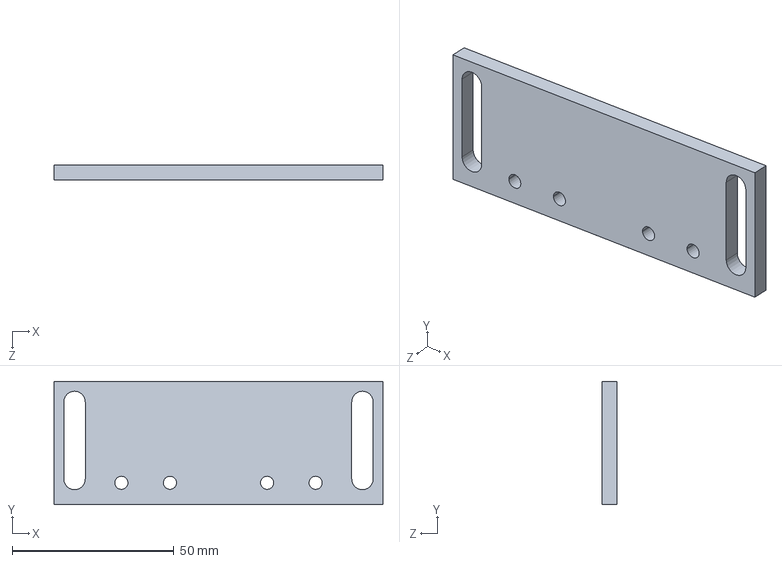
[picture p98: CAD file, 2020-02-09]
BAI_TAP_SOLIDWORKS/Ban_le/8020-2134 Hinge Door Configuration/8020-2134 Hinge Door Configuration-$PARTNUMBER_Latch Plate.sldprt
101.6 x 38.1 x 4.78 mm
