huan95nd/BAI_TAP_PHAN_MEM/BAI_TAP_SOLIDWORKS/bang tai/Quickdraw-LR6TS-7-DDL-ESD/Quickdraw-LR6TS-7-DDL-ESD_Motor PKG  DDL.SLDPRT

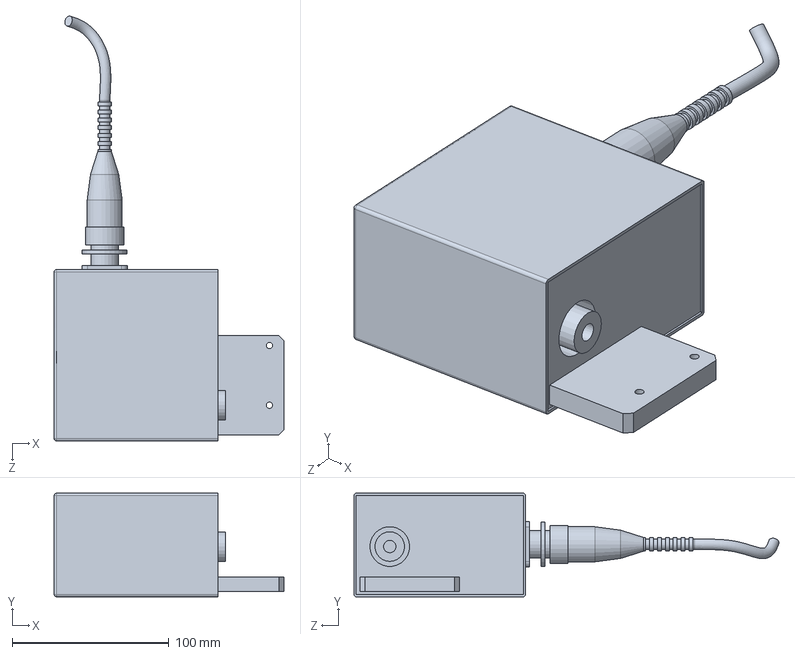
[picture p99: CAD file, 2020-02-09]
BAI_TAP_SOLIDWORKS/bang tai/Quickdraw-LR6TS-7-DDL-ESD/Quickdraw-LR6TS-7-DDL-ESD_Motor PKG DDL.SLDPRT
146.7 x 66.2 x 271.4 mm
