huan95nd/BAI_TAP_PHAN_MEM/BAI_TAP_SOLIDWORKS/Dong_co_DC/bevel-gear-mechanism-4.snapshot.1/圆锥齿轮.SLDPRT

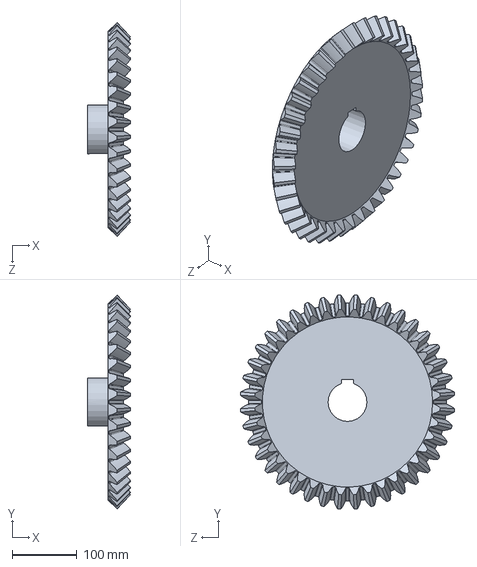
[picture p100: CAD file, 2020-02-09]
BAI_TAP_SOLIDWORKS/Dong_co_DC/bevel-gear-mechanism-4.snapshot.1/圆锥齿轮.SLDPRT
66.1 x 330.7 x 330.7 mm
