huan95nd/BAI_TAP_PHAN_MEM/BAI_TAP_SOLIDWORKS/AN_HONG/FCC_2/Part14.SLDPRT

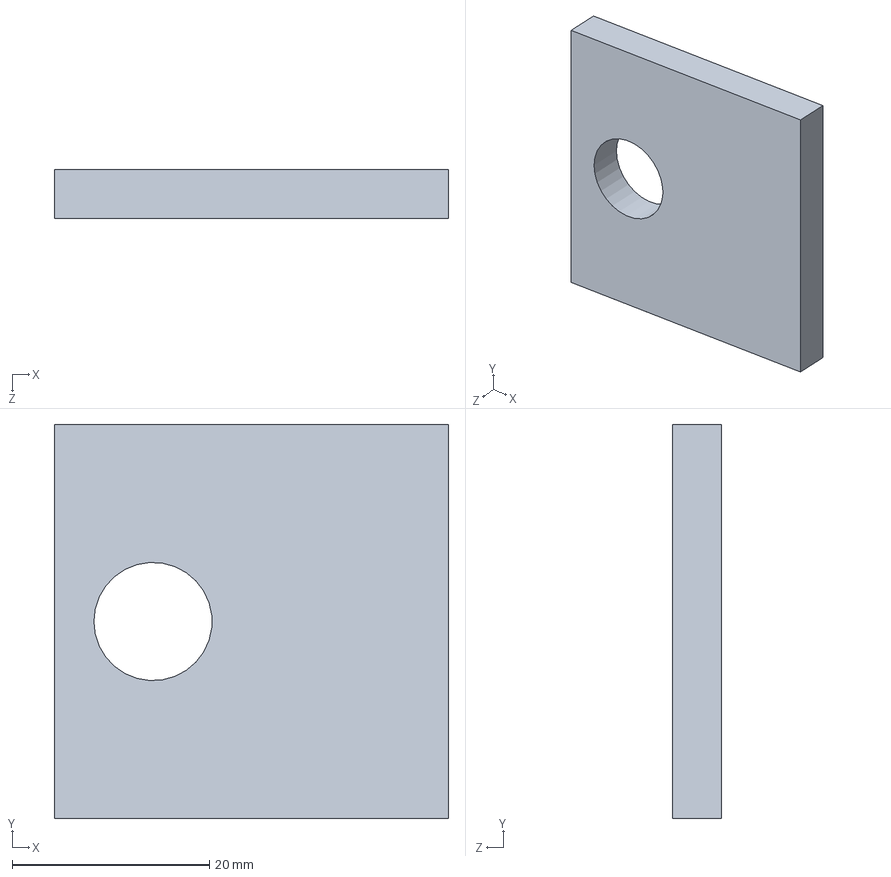
[picture p103: CAD file, 2020-02-09]
BAI_TAP_SOLIDWORKS/AN_HONG/FCC_2/Part14.SLDPRT
40.0 x 40.0 x 5.00 mm
