huan95nd/BAI_TAP_PHAN_MEM/BAI_TAP_SOLIDWORKS/AN_HONG/laser_khach_hang/laser_khach_hang/op_2.SLDPRT

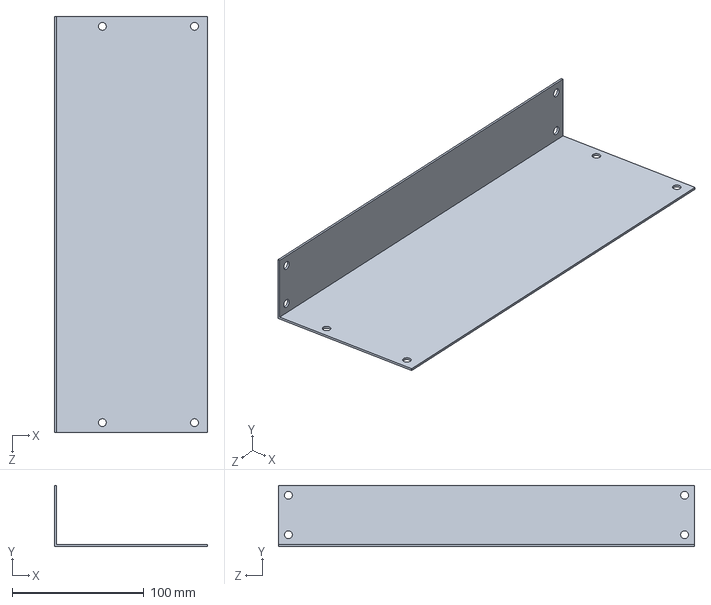
[picture p105: CAD file, 2020-02-09]
BAI_TAP_SOLIDWORKS/AN_HONG/laser_khach_hang/laser_khach_hang/op_2.SLDPRT
116.5 x 46.5 x 316.0 mm
