huan95nd/BAI_TAP_PHAN_MEM/BAI_TAP_SOLIDWORKS/AN_HONG/MV40MicroHAWK_Drawings/STEP/98-9000052-01.STEP

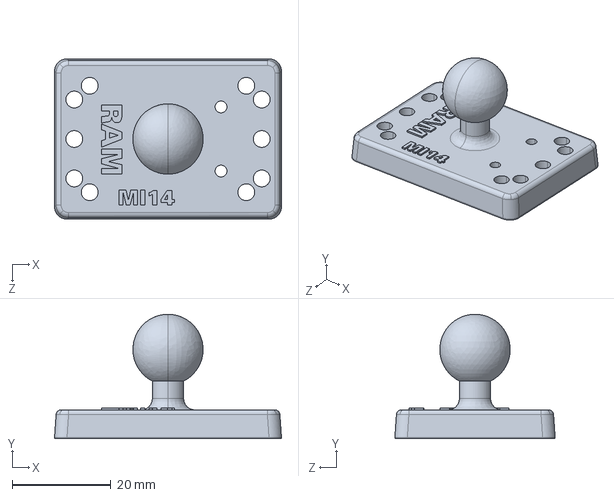
[picture p106: CAD file, 2020-02-09]
BAI_TAP_SOLIDWORKS/AN_HONG/MV40MicroHAWK_Drawings/STEP/98-9000052-01.STEP
46.0 x 25.2 x 32.5 mm
