huan95nd/BAI_TAP_PHAN_MEM/BAI_TAP_SOLIDWORKS/AN_HONG/videojet_8520/manhinh.SLDPRT

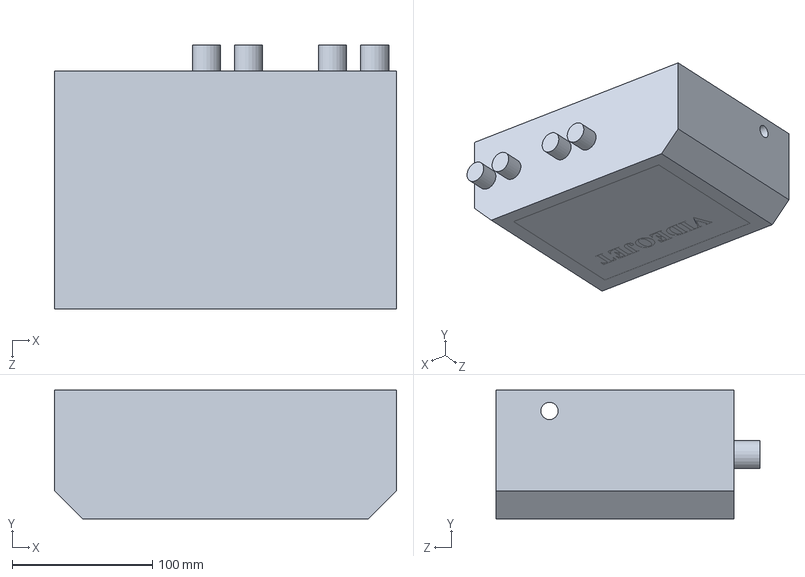
[picture p108: CAD file, 2020-03-10]
BAI_TAP_SOLIDWORKS/AN_HONG/videojet_8520/manhinh.SLDPRT
244.0 x 92.0 x 188.7 mm
