huan95nd/BAI_TAP_PHAN_MEM/BAI_TAP_SOLIDWORKS/Ban_le/8020-2134 Hinge Door Configuration/8020-2134 Hinge Door Configuration-$PARTNUMBER_Latch.sldprt

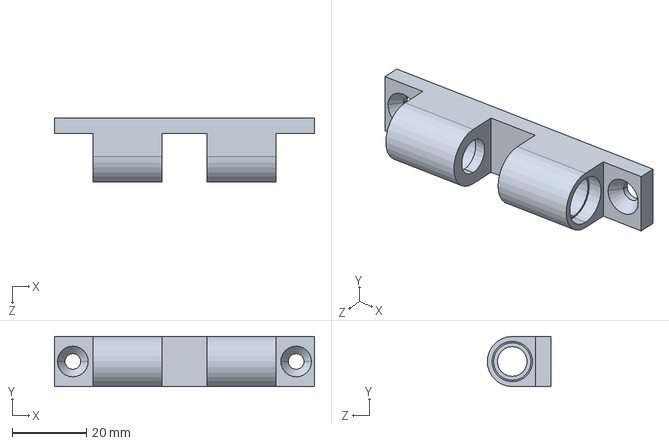
[picture p109: CAD file, 2020-02-09]
BAI_TAP_SOLIDWORKS/Ban_le/8020-2134 Hinge Door Configuration/8020-2134 Hinge Door Configuration-$PARTNUMBER_Latch.sldprt
69.8 x 13.5 x 17.1 mm
