huan95nd/BAI_TAP_PHAN_MEM/BAI_TAP_SOLIDWORKS/tay quay/96223232-19-haldern_eh_2433_010_/gn_22501.stp

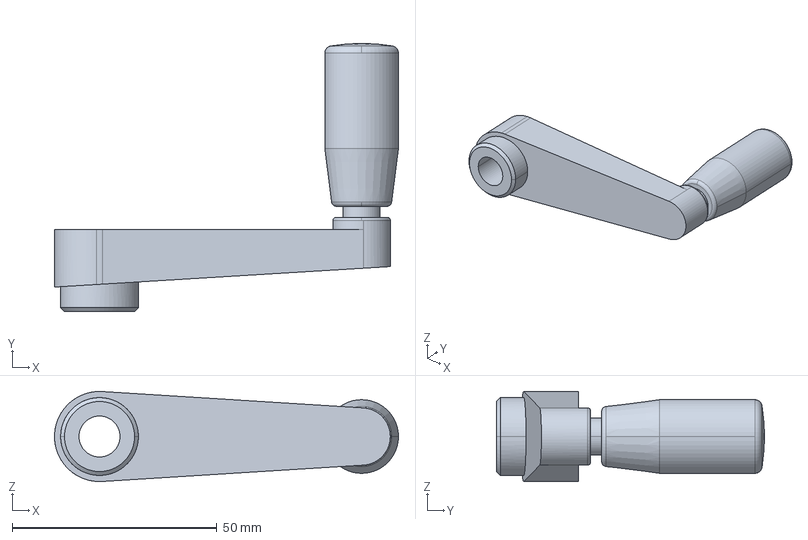
[picture p111: CAD file, 2020-02-09]
BAI_TAP_SOLIDWORKS/tay quay/96223232-19-haldern_eh_2433_010_/gn_22501.stp
84.0 x 65.5 x 22.0 mm
