huan95nd/BAI_TAP_PHAN_MEM/BAI_TAP_SOLIDWORKS/AN_HONG/MV40MicroHAWK_Drawings/STEP/98-9000034-01.STEP

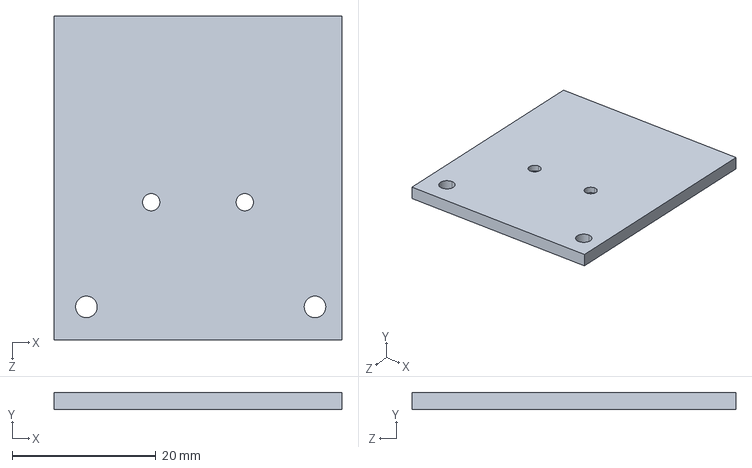
[picture p114: CAD file, 2020-02-09]
BAI_TAP_SOLIDWORKS/AN_HONG/MV40MicroHAWK_Drawings/STEP/98-9000034-01.STEP
40.0 x 2.40 x 45.0 mm
