huan95nd/BAI_TAP_PHAN_MEM/BAI_TAP_SOLIDWORKS/AN_HONG/videojet_8520/Part6.SLDPRT

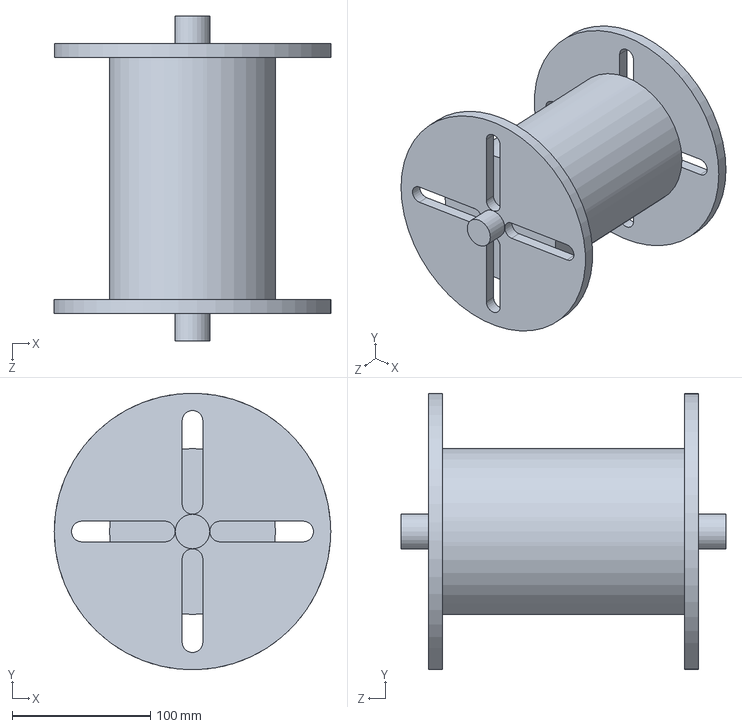
[picture p117: CAD file, 2020-03-10]
BAI_TAP_SOLIDWORKS/AN_HONG/videojet_8520/Part6.SLDPRT
200.0 x 199.9 x 235.0 mm
