huan95nd/BAI_TAP_PHAN_MEM/BAI_TAP_SOLIDWORKS/robot/User Library-30 pound vert/User Library-30 pound vert_Round Tie Rod.SLDPRT

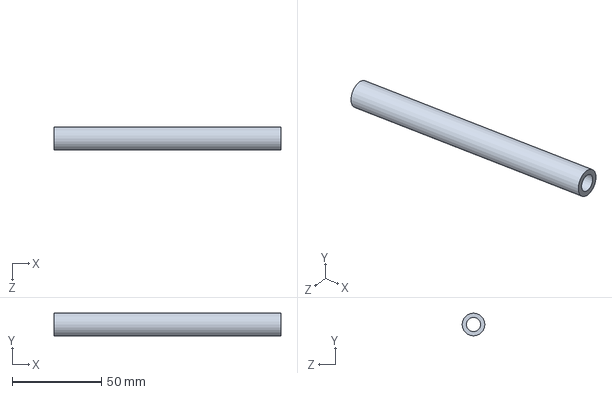
[picture p119: CAD file, 2020-02-10]
BAI_TAP_SOLIDWORKS/robot/User Library-30 pound vert/User Library-30 pound vert_Round Tie Rod.SLDPRT
127.0 x 12.7 x 12.7 mm
