huan95nd/BAI_TAP_PHAN_MEM/BAI_TAP_SOLIDWORKS/AN_HONG/FCC_2/Part8.SLDPRT

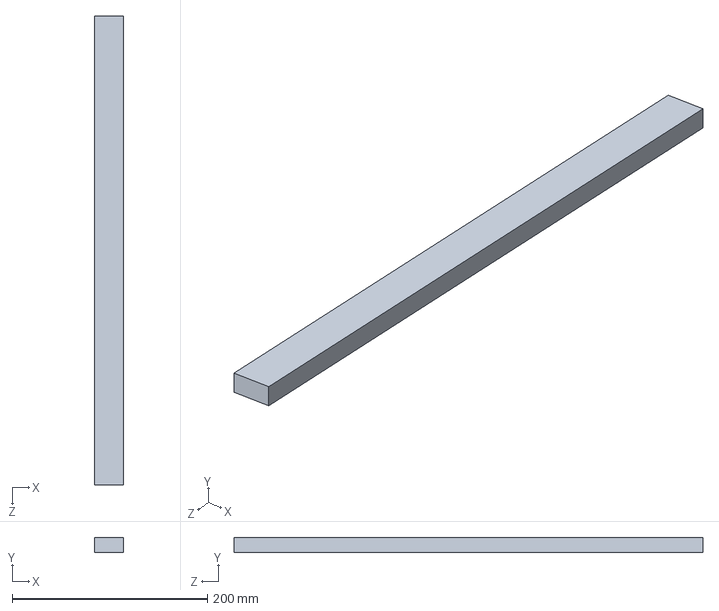
[picture p122: CAD file, 2020-02-09]
BAI_TAP_SOLIDWORKS/AN_HONG/FCC_2/Part8.SLDPRT
30.0 x 15.0 x 480.0 mm
