huan95nd/BAI_TAP_PHAN_MEM/BAI_TAP_SOLIDWORKS/AN_HONG/laser_khach_hang/laser_khach_hang/nhom_truc_x 1.SLDPRT

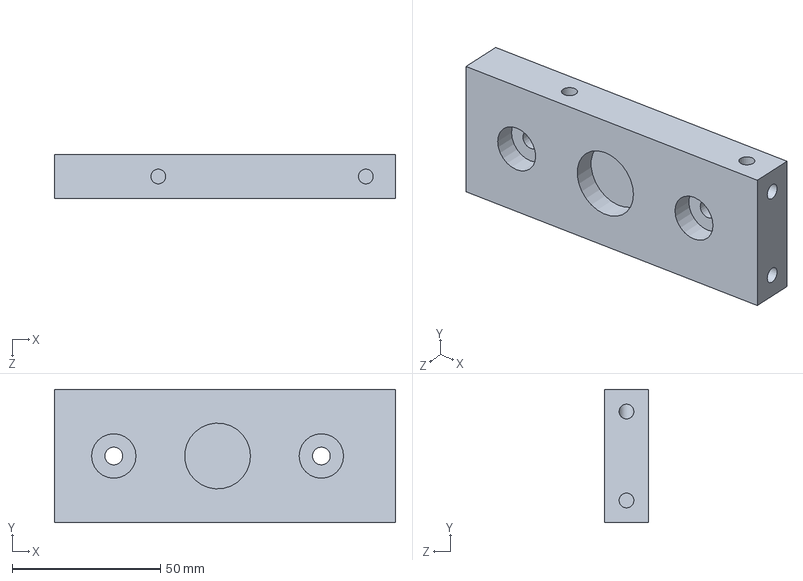
[picture p123: CAD file, 2020-02-09]
BAI_TAP_SOLIDWORKS/AN_HONG/laser_khach_hang/laser_khach_hang/nhom_truc_x 1.SLDPRT
115.0 x 45.0 x 15.0 mm
