huan95nd/BAI_TAP_PHAN_MEM/BAI_TAP_SOLIDWORKS/robot/User Library-30 pound vert/User Library-30 pound vert_New Disc Assembly.SLDASM

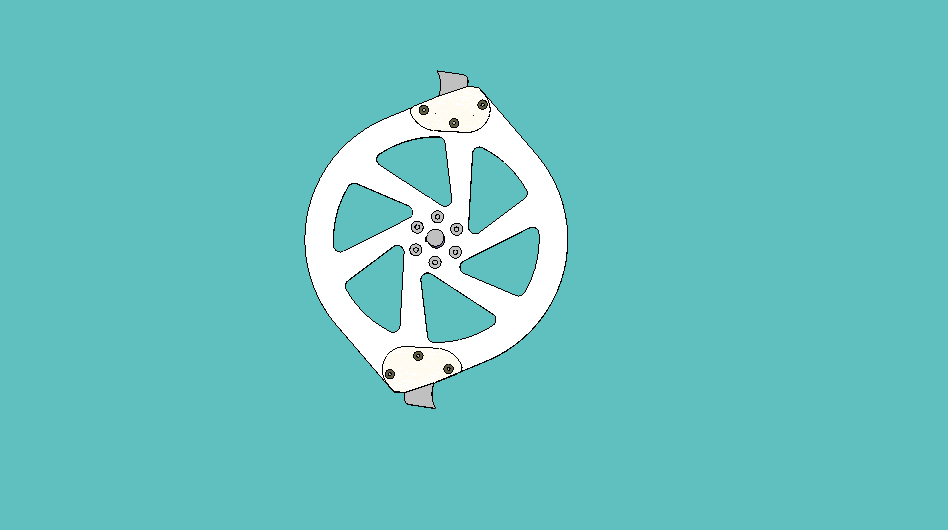
[picture p126: CAD file, 2020-02-10]
BAI_TAP_SOLIDWORKS/robot/User Library-30 pound vert/User Library-30 pound vert_New Disc Assembly.SLDASM
User Library-30 pound vert_New Disc
User Library-30 pound vert_New Tooth x 2
User Library-30 pound vert_New Tooth Plate L x 2
User Library-30 pound vert_New Tooth Plate R x 2
User Library-30 pound vert_Hub
User Library-30 pound vert_.25 flat screw x 6
User Library-30 pound vert_Shaft
User Library-30 pound vert_10-32_Screw x 6
