huan95nd/BAI_TAP_PHAN_MEM/(list of files, cad)

Other CAD files:
BAI_TAP_SOLIDWORKS/bang tai/Quickdraw-LR6TS-7-DDL-ESD/Quickdraw-LR6TS-7-DDL-ESD_MR ROLLER ASSY LT.SLDPRT
BAI_TAP_SOLIDWORKS/AN_HONG/Project_BIA_HHT1/full.SLDASM
BAI_TAP_SOLIDWORKS/AN_HONG/Project_BIA_HHT1/full bt9.SLDASM
BAI_TAP_SOLIDWORKS/AN_HONG/Project_BIA_HHT1/full bt6.SLDASM
BAI_TAP_SOLIDWORKS/AN_HONG/Project_BIA_HHT1/full bt8.SLDASM
BAI_TAP_SOLIDWORKS/AN_HONG/Project_BIA_HHT1/full bt7.SLDASM
BAI_TAP_AUTOCAD/Drawing1.dwg
BAI_TAP_SOLIDWORKS/AN_HONG/MV40MicroHAWK_Drawings/DWG/MicroHAWK_ID-20_Drawing.DWG
BAI_TAP_SOLIDWORKS/nguon 24VDC/96226356-19-pss24-100/pss24-100.stp
BAI_TAP_SOLIDWORKS/Nhom_dinh_hinh/40x40.SLDPRT
BAI_TAP_SOLIDWORKS/Nhom_dinh_hinh/NHOM_DINH_HINH/20x40.SLDPRT
BAI_TAP_SOLIDWORKS/AN_HONG/MV40MicroHAWK_Drawings/DWG/MicroHAWK_ID-30_Drawing.DWG
BAI_TAP_SOLIDWORKS/bang tai/Quickdraw-LR6TS-7-DDL-ESD/Quickdraw-LR6TS-7-DDL-ESD_END PLATE.SLDPRT
BAI_TAP_SOLIDWORKS/Nhom_dinh_hinh/NHOM_DINH_HINH/30x30.SLDPRT
BAI_TAP_SOLIDWORKS/robot/User Library-NB4/User Library-NB4_NB4_6_1.sldprt
BAI_TAP_SOLIDWORKS/AN_HONG/FCC_2/Part2 - Sao chép.SLDPRT
BAI_TAP_SOLIDWORKS/AN_HONG/MV40MicroHAWK_Drawings/DWG/MicroHAWK_ID-40_Drawing.DWG
BAI_TAP_SOLIDWORKS/Nhom_dinh_hinh/NHOM_DINH_HINH/40x80.SLDPRT
BAI_TAP_SOLIDWORKS/robot/User Library-NB4/User Library-NB4_NB4_5_1.sldprt
BAI_TAP_SOLIDWORKS/AN_HONG/Project_BIA_HHT1/FILE 1/gia bat vitme3.SLDPRT
BAI_TAP_SOLIDWORKS/bang tai/Quickdraw-LR6TS-7-DDL-ESD/Quickdraw-LR6TS-7-DDL-ESD_RHRail.SLDPRT
BAI_TAP_SOLIDWORKS/Nhom_dinh_hinh/NHOM_DINH_HINH/20x20.SLDPRT
BAI_TAP_SOLIDWORKS/robot/User Library-NB4/User Library-NB4_NB4_4_1.sldprt
BAI_TAP_SOLIDWORKS/AN_HONG/FCC_2/Part10.SLDPRT
BAI_TAP_SOLIDWORKS/Nhom_dinh_hinh/NHOM_DINH_HINH/30x60.SLDPRT
BAI_TAP_SOLIDWORKS/robot/User Library-NB4/User Library-NB4_NB4_8_1.sldprt
BAI_TAP_SOLIDWORKS/AN_HONG/gia_camera_demo-master/gia_camera_demo-master/H04.080.010.1-Durovis.sldprt
BAI_TAP_SOLIDWORKS/AN_HONG/Duoc_CPC_HN_project2-master/Duoc_CPC_HN_project2-master/40x80x100.SLDPRT
BAI_TAP_SOLIDWORKS/AN_HONG/Duoc_CPC_HN_project2-master/Duoc_CPC_HN_project2-master/40x80x1000.SLDPRT
BAI_TAP_SOLIDWORKS/AN_HONG/Duoc_CPC_HN_project2-master/Duoc_CPC_HN_project2-master/40x80x320.SLDPRT
BAI_TAP_SOLIDWORKS/AN_HONG/Duoc_CPC_HN_project2-master/Duoc_CPC_HN_project2-master/40x80x3201.SLDPRT
BAI_TAP_SOLIDWORKS/AN_HONG/Duoc_CPC_HN_project2-master/Duoc_CPC_HN_project2-master/8020-2061-$PARTNUMBER.SLDPRT
BAI_TAP_SOLIDWORKS/AN_HONG/Duoc_CPC_HN_project2-master/Duoc_CPC_HN_project2-master/BAN VE/full.SLDDRW
BAI_TAP_SOLIDWORKS/AN_HONG/Duoc_CPC_HN_project2-master/Duoc_CPC_HN_project2-master/BAN VE/fullcpchn.SLDDRW
BAI_TAP_SOLIDWORKS/AN_HONG/Duoc_CPC_HN_project2-master/Duoc_CPC_HN_project2-master/G_IC03_XX_28762V.SLDPRT
BAI_TAP_SOLIDWORKS/AN_HONG/Duoc_CPC_HN_project2-master/Duoc_CPC_HN_project2-master/User Library-E Stop Button.sldprt
BAI_TAP_SOLIDWORKS/AN_HONG/Duoc_CPC_HN_project2-master/Duoc_CPC_HN_project2-master/User Library-p000557 light tower.sldprt
BAI_TAP_SOLIDWORKS/AN_HONG/Duoc_CPC_HN_project2-master/Duoc_CPC_HN_project2-master/bat man hinh.SLDPRT
BAI_TAP_SOLIDWORKS/AN_HONG/Duoc_CPC_HN_project2-master/Duoc_CPC_HN_project2-master/bat_de.SLDPRT
BAI_TAP_SOLIDWORKS/AN_HONG/Duoc_CPC_HN_project2-master/Duoc_CPC_HN_project2-master/chan de tu.SLDPRT
BAI_TAP_SOLIDWORKS/AN_HONG/Duoc_CPC_HN_project2-master/Duoc_CPC_HN_project2-master/cover camera.SLDPRT
BAI_TAP_SOLIDWORKS/AN_HONG/Duoc_CPC_HN_project2-master/Duoc_CPC_HN_project2-master/man hinh.SLDPRT
BAI_TAP_SOLIDWORKS/AN_HONG/Duoc_CPC_HN_project2-master/Duoc_CPC_HN_project2-master/nhom 40x40.SLDPRT
BAI_TAP_SOLIDWORKS/AN_HONG/Duoc_CPC_HN_project2-master/Duoc_CPC_HN_project2-master/nhom 40x40x100.SLDPRT
BAI_TAP_SOLIDWORKS/AN_HONG/Duoc_CPC_HN_project2-master/Duoc_CPC_HN_project2-master/nhom 40x40x1500.SLDPRT
BAI_TAP_SOLIDWORKS/AN_HONG/Duoc_CPC_HN_project2-master/Duoc_CPC_HN_project2-master/nhom 40x40x400.SLDPRT
BAI_TAP_SOLIDWORKS/AN_HONG/Duoc_CPC_HN_project2-master/Duoc_CPC_HN_project2-master/nhom 40x40x600.SLDPRT
BAI_TAP_SOLIDWORKS/AN_HONG/Duoc_CPC_HN_project2-master/Duoc_CPC_HN_project2-master/thanh dan hương.SLDPRT
BAI_TAP_SOLIDWORKS/AN_HONG/Duoc_CPC_HN_project2-master/Duoc_CPC_HN_project2-master/tu dien - Sao chép.SLDPRT
BAI_TAP_SOLIDWORKS/AN_HONG/Duoc_CPC_HN_project2-master/Duoc_CPC_HN_project2-master/tu dien.SLDPRT
BAI_TAP_SOLIDWORKS/AN_HONG/FCC_2/Assem1.SLDDRW
BAI_TAP_SOLIDWORKS/AN_HONG/FCC_2/Part11.SLDPRT
BAI_TAP_SOLIDWORKS/AN_HONG/FCC_2/Part15.SLDPRT
BAI_TAP_SOLIDWORKS/AN_HONG/FCC_2/Part16.SLDPRT
BAI_TAP_SOLIDWORKS/AN_HONG/FCC_2/Part2.SLDPRT
BAI_TAP_SOLIDWORKS/AN_HONG/FCC_2/Part3.SLDPRT
BAI_TAP_SOLIDWORKS/AN_HONG/FCC_2/Part6.SLDPRT
BAI_TAP_SOLIDWORKS/AN_HONG/FCC_2/Part7.SLDPRT
BAI_TAP_SOLIDWORKS/AN_HONG/FCC_2/do.SLDPRT
BAI_TAP_SOLIDWORKS/AN_HONG/FCC_2/nhôm định hình 1.SLDPRT
BAI_TAP_SOLIDWORKS/AN_HONG/FCC_2/vang.SLDPRT
BAI_TAP_SOLIDWORKS/AN_HONG/FCC_2/vitme.SLDPRT
BAI_TAP_SOLIDWORKS/AN_HONG/MV40MicroHAWK_Drawings/STEP/98-9000047-01Ext.STEP
BAI_TAP_SOLIDWORKS/AN_HONG/MV40MicroHAWK_Drawings/STEP/98-9000053-01.STEP
BAI_TAP_SOLIDWORKS/AN_HONG/MV40MicroHAWK_Drawings/STEP/98-9000058-01Ext.STEP
BAI_TAP_SOLIDWORKS/AN_HONG/Project_BIA_HHT1/CT-hanhtrinh.SLDPRT
BAI_TAP_SOLIDWORKS/AN_HONG/Project_BIA_HHT1/FILE 1/cover camera.SLDPRT
BAI_TAP_SOLIDWORKS/AN_HONG/Project_BIA_HHT1/FILE 1/do camera.SLDPRT
BAI_TAP_SOLIDWORKS/AN_HONG/Project_BIA_HHT1/FILE 1/full 1.SLDDRW
BAI_TAP_SOLIDWORKS/AN_HONG/Project_BIA_HHT1/FILE 1/gia bat cover.SLDPRT
BAI_TAP_SOLIDWORKS/AN_HONG/Project_BIA_HHT1/FILE 1/gia bat tren.SLDPRT
BAI_TAP_SOLIDWORKS/AN_HONG/Project_BIA_HHT1/FILE 1/gia bat vitme 1.SLDPRT
BAI_TAP_SOLIDWORKS/AN_HONG/Project_BIA_HHT1/FILE 1/truc do laser.SLDPRT
BAI_TAP_SOLIDWORKS/AN_HONG/Project_BIA_HHT1/FILE 1/truc do laser1.SLDPRT
BAI_TAP_SOLIDWORKS/AN_HONG/Project_BIA_HHT1/FILE 1/truc do laser2.SLDPRT
BAI_TAP_SOLIDWORKS/AN_HONG/Project_BIA_HHT1/FILE 1/truc do laser3.SLDPRT
BAI_TAP_SOLIDWORKS/AN_HONG/Project_BIA_HHT1/FILE 1/truc do laser5.SLDPRT
BAI_TAP_SOLIDWORKS/AN_HONG/Project_BIA_HHT1/FILE 1/truc do laser7.SLDPRT
BAI_TAP_SOLIDWORKS/AN_HONG/Project_BIA_HHT1/FILE 1/truc do.SLDPRT
BAI_TAP_SOLIDWORKS/AN_HONG/Project_BIA_HHT1/FILE 1/truc tron.SLDPRT
BAI_TAP_SOLIDWORKS/AN_HONG/Project_BIA_HHT1/FILE 1/truc vit me.SLDPRT
BAI_TAP_SOLIDWORKS/AN_HONG/Project_BIA_HHT1/Part11.SLDPRT
BAI_TAP_SOLIDWORKS/AN_HONG/Project_BIA_HHT1/Part12.SLDPRT
BAI_TAP_SOLIDWORKS/AN_HONG/Project_BIA_HHT1/ban-xoay-2.SLDPRT
BAI_TAP_SOLIDWORKS/AN_HONG/Project_BIA_HHT1/ban-xoay.SLDPRT
BAI_TAP_SOLIDWORKS/AN_HONG/Project_BIA_HHT1/bang tai 1.SLDPRT
BAI_TAP_SOLIDWORKS/AN_HONG/Project_BIA_HHT1/bang tai 2.SLDPRT
BAI_TAP_SOLIDWORKS/AN_HONG/Project_BIA_HHT1/bang tai 3.1.SLDPRT
BAI_TAP_SOLIDWORKS/AN_HONG/Project_BIA_HHT1/bang tai 3.SLDPRT
BAI_TAP_SOLIDWORKS/AN_HONG/Project_BIA_HHT1/bang-tai.SLDPRT
BAI_TAP_SOLIDWORKS/AN_HONG/Project_BIA_HHT1/cam.SLDPRT
BAI_TAP_SOLIDWORKS/AN_HONG/Project_BIA_HHT1/gia laser.SLDPRT
BAI_TAP_SOLIDWORKS/AN_HONG/Project_BIA_HHT1/kegbia.SLDPRT
BAI_TAP_SOLIDWORKS/AN_HONG/Project_BIA_HHT1/laser.SLDPRT
BAI_TAP_SOLIDWORKS/AN_HONG/Project_BIA_HHT1/loxo.SLDPRT
BAI_TAP_SOLIDWORKS/AN_HONG/Project_BIA_HHT1/reject_2.SLDPRT
BAI_TAP_SOLIDWORKS/AN_HONG/Project_BIA_HHT1/thanh dan hương.SLDPRT
BAI_TAP_SOLIDWORKS/AN_HONG/Project_BIA_HHT1/tru-dung-2.SLDPRT
BAI_TAP_SOLIDWORKS/AN_HONG/Project_BIA_HHT1/truc-quay.SLDPRT
BAI_TAP_SOLIDWORKS/AN_HONG/Project_BIA_HHT1/xilanh.SLDPRT
BAI_TAP_SOLIDWORKS/AN_HONG/Project_BIA_HHT1/xilanh_giukeg.SLDPRT
BAI_TAP_SOLIDWORKS/AN_HONG/Project_BIA_HHT1/xilanh_giukeg1.SLDPRT
BAI_TAP_SOLIDWORKS/AN_HONG/Project_BIA_HHT1/xilanh_tt2.SLDPRT
BAI_TAP_SOLIDWORKS/AN_HONG/Project_BIA_HHT1/xilanh_tt22.SLDPRT
BAI_TAP_SOLIDWORKS/AN_HONG/gia_camera_demo-master/gia_camera_demo-master/GigE Camera CCD.SLDPRT
BAI_TAP_SOLIDWORKS/AN_HONG/gia_camera_demo-master/gia_camera_demo-master/MicroHAWK_ID-20_Drawing.SLDPRT
BAI_TAP_SOLIDWORKS/AN_HONG/gia_camera_demo-master/gia_camera_demo-master/MicroHAWK_ID-30_Drawing.SLDPRT
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
