huan95nd/BAI_TAP_PHAN_MEM/BAI_TAP_SOLIDWORKS/AN_HONG/videojet_8520/Assem1.PDF

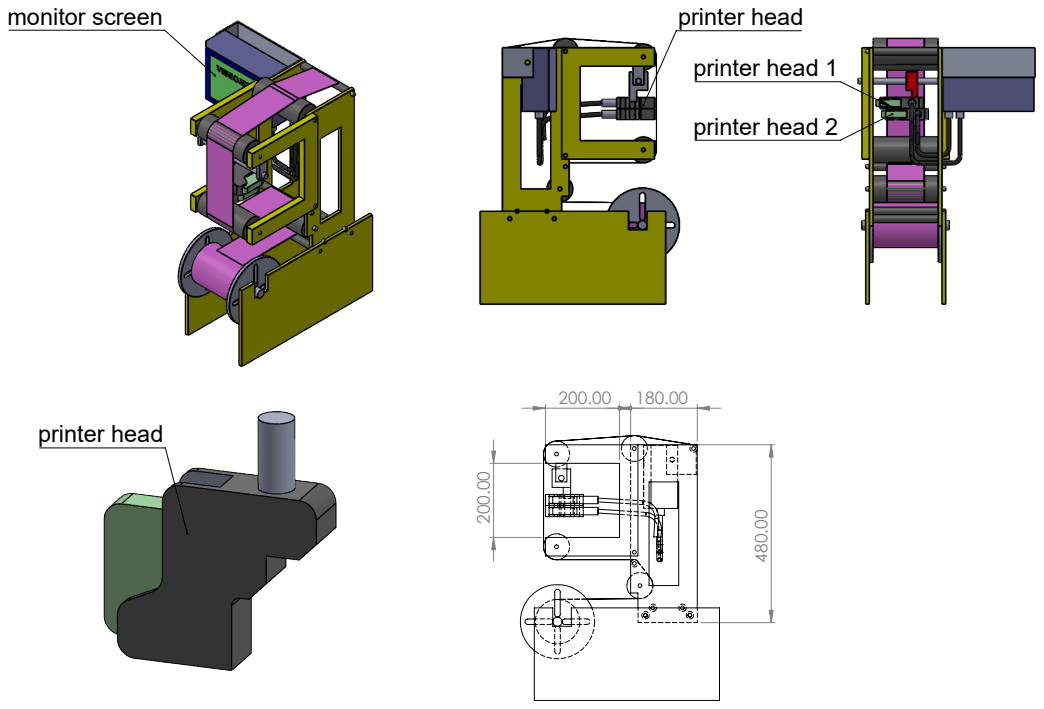
[picture p127: page 1]
monitor screen; printer head; printer head 1; printer head 2
