huan95nd/BAI_TAP_PHAN_MEM/BAI_TAP_SOLIDWORKS/AN_HONG/videojet_8520/Assem3 - Sheet1.pdf

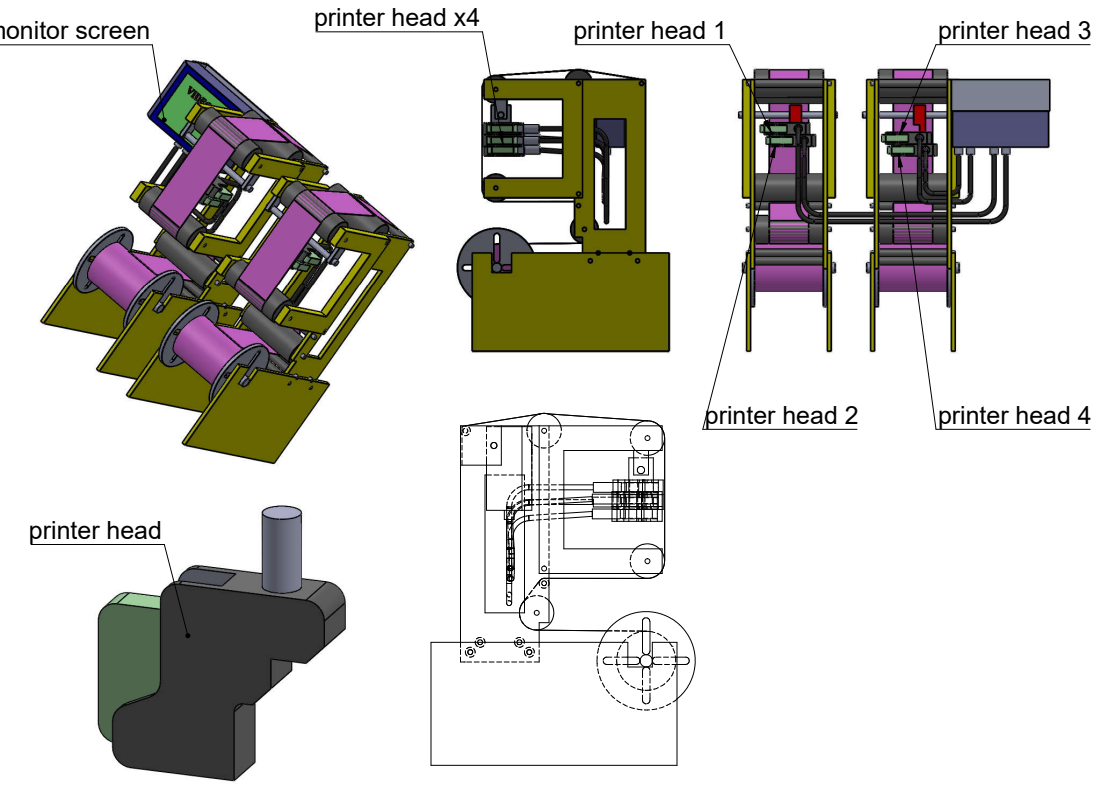
[picture p128: page 1]
printer head; printer head 1; printer head 4; printer head 3; printer head 2; monitor screen; printer head x4
