huan95nd/BAI_TAP_PHAN_MEM/BAI_TAP_SOLIDWORKS/AN_HONG/FCC_2/Assem1-1.PDF

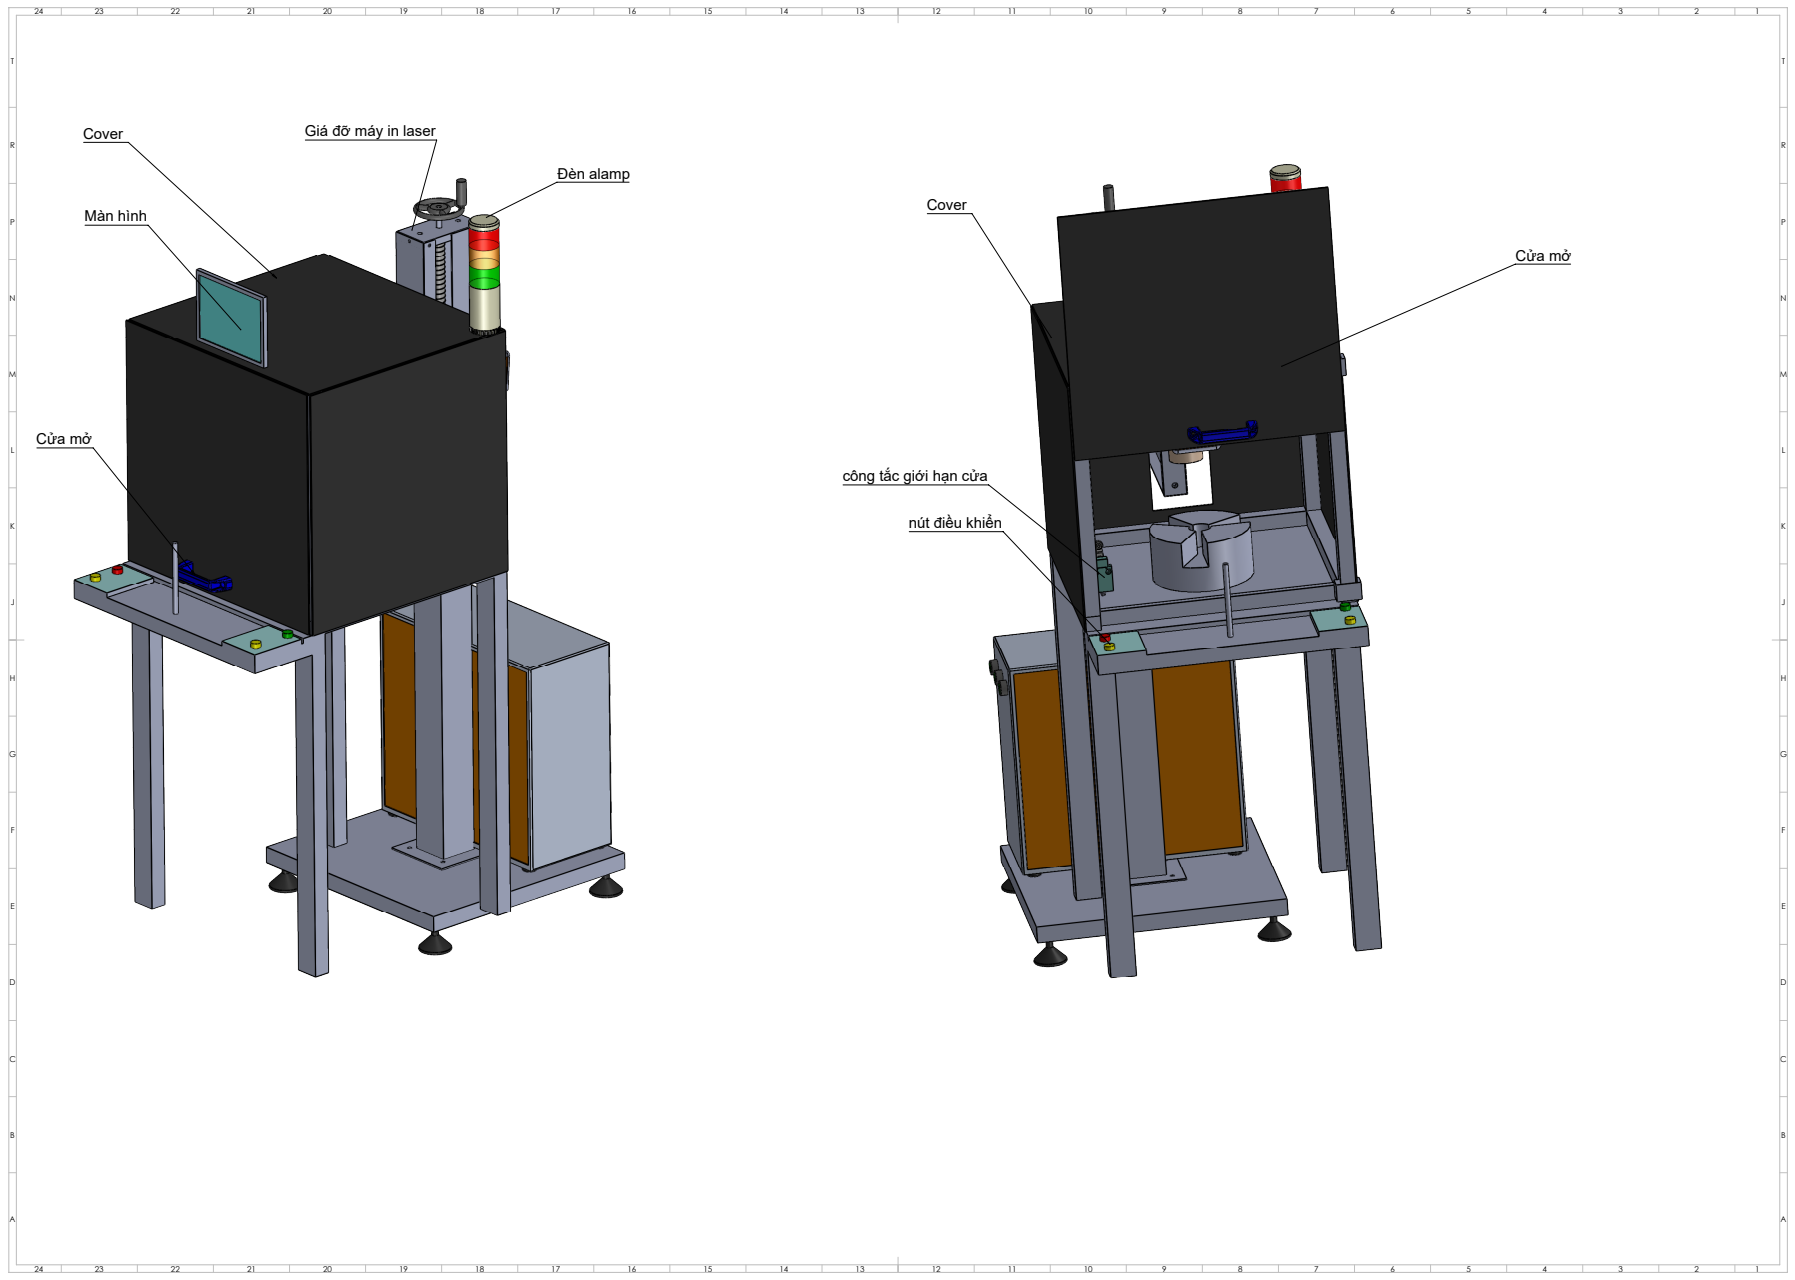
[picture p129: page 1]
Đèn alamp; Cửa mở; Màn hình

Giá đỡ máy in laser

công tắc giới hạn cửa

nút điều khiển
