huan95nd/BAI_TAP_PHAN_MEM/BAI_TAP_SOLIDWORKS/AN_HONG/Project_BIA_HHT1/full lan 1.PDF

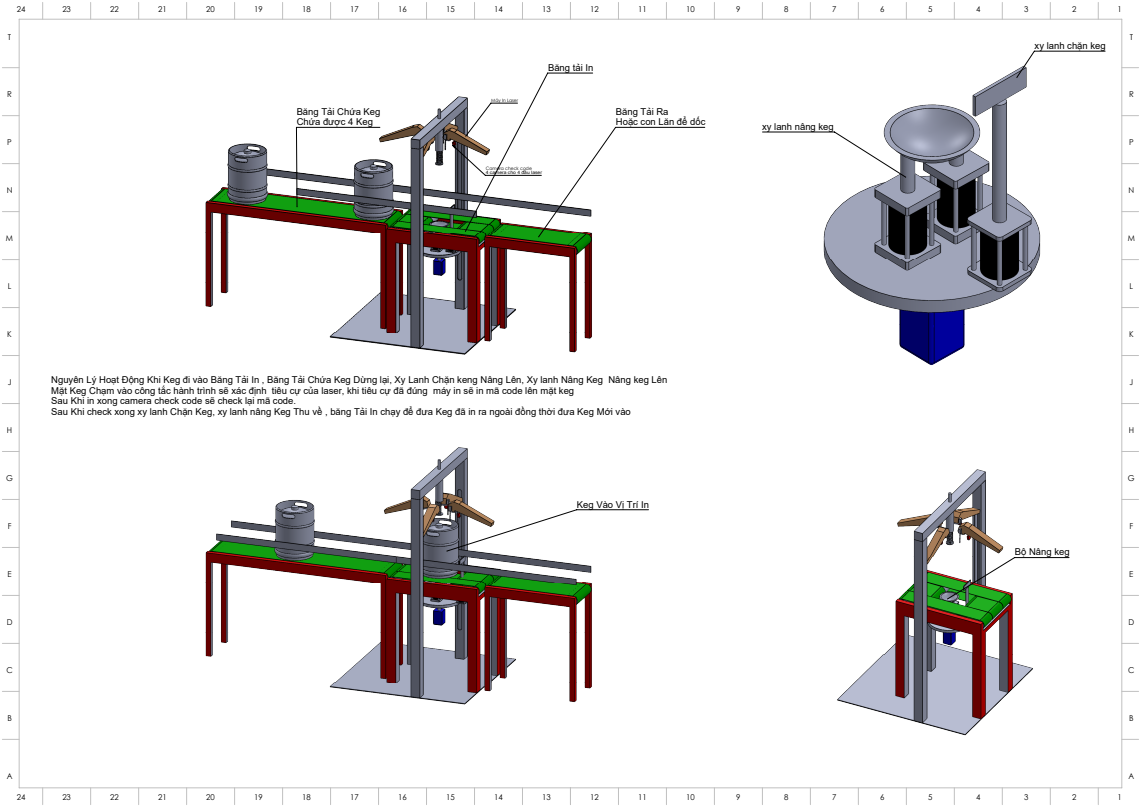
[picture p131: page 1]

xy lanh chặn keg

Băng tải In

Máy In Laser

Băng Tải Chứa Keg
Chứa được 4 Keg

Băng Tải Ra
Hoặc con Lăn để dốc

xy lanh nâng keg

Camera check code
4 camera cho 4 đầu laser

Nguyên Lý Hoạt Động Khi Keg đi vào Băng Tải In , Băng Tải Chứa Keg Dừng lại, Xy Lanh Chặn keng Nâng Lên, Xy lanh Nâng Keg Nâng keg Lên
Mặt Keg Chạm vào công tắc hành trình sẽ xác định tiêu cự của laser, khi tiêu cự đã đúng máy in sẽ in mã code lên mặt keg
Sau Khi in xong camera check code sẽ check lại mã code.
Sau Khi check xong xy lanh Chặn Keg, xy lanh nâng Keg Thu về , băng Tải In chạy để đưa Keg đã in ra ngoài đồng thời đưa Keg Mới vào

Keg Vào Vị Trí In

Bộ Nâng keg
