huan95nd/BAI_TAP_PHAN_MEM/BAI_TAP_SOLIDWORKS/AN_HONG/Project_BIA_HHT1/full lan 2.PDF

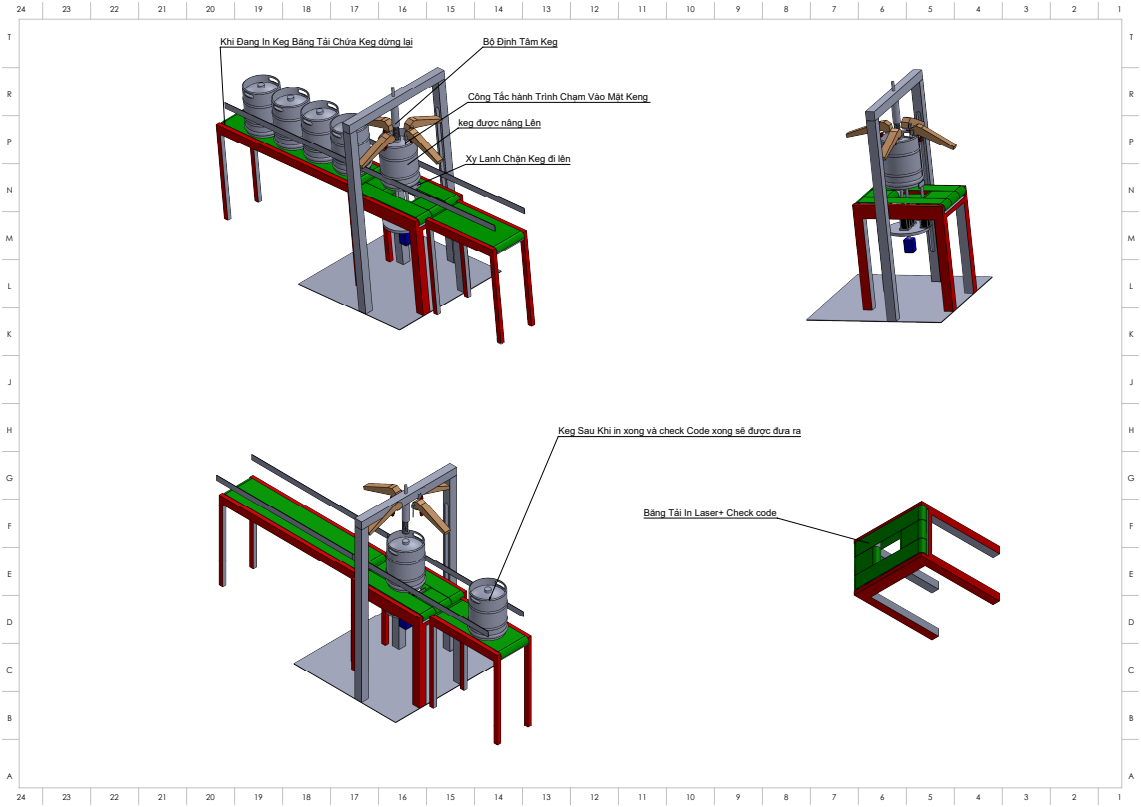
[picture p132: page 1]
Khi Đang In Keg Băng Tải Chứa Keg dừng lại; Bộ Định Tâm Keg

Công Tắc hành Trình Chạm Vào Mặt Keng

keg được nâng Lên

Xy Lanh Chặn Keg đi lên

Keg Sau Khi in xong và check Code xong sẽ được đưa ra

Băng Tải In Laser+ Check code
