huan95nd/BAI_TAP_PHAN_MEM/BAI_TAP_SOLIDWORKS/AN_HONG/Project_BIA_HHT1/Nguyen-ly-hoat-dong.PDF

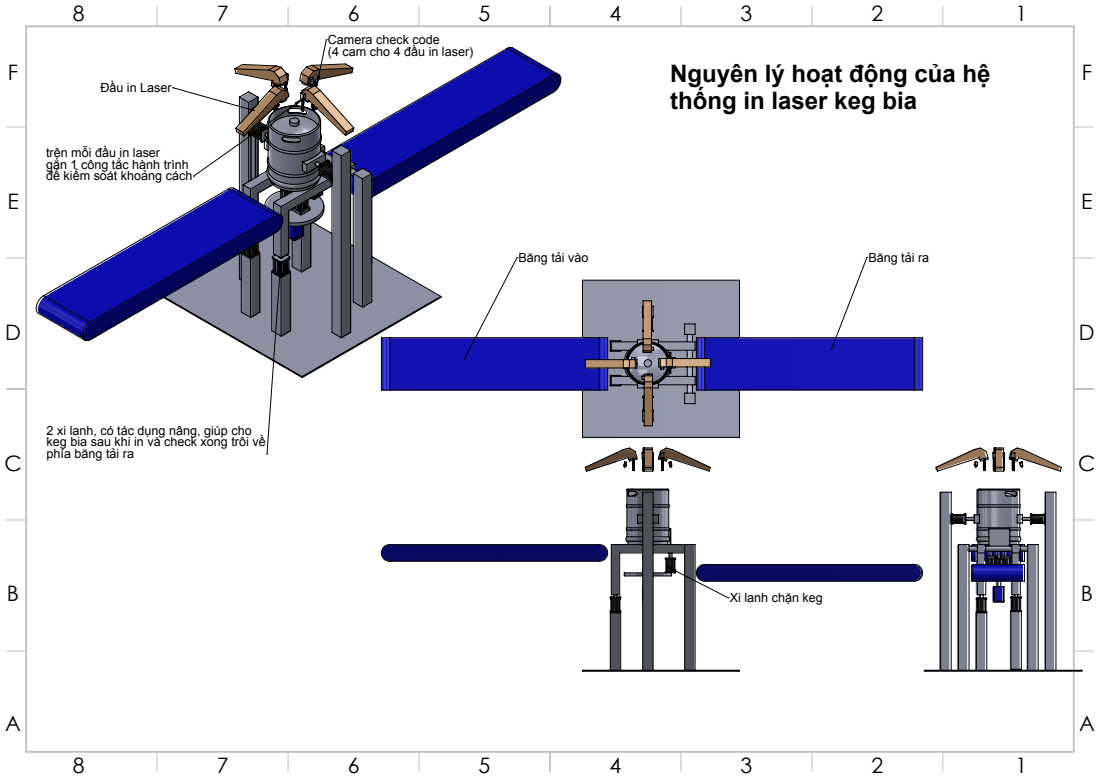
[picture p133: page 1]
Băng tải vào; Băng tải ra

Camera check code
(4 cam cho 4 đầu in laser)

Nguyên lý hoạt động của hệ
thống in laser keg bia

Đầu in Laser

trên mỗi đầu in laser
gắn 1 công tắc hành trình
để kiểm soát khoảng cách

2 xi lanh, có tác dụng nâng, giúp cho
keg bia sau khi in và check xong trôi về
phía băng tải ra

Xi lanh chặn keg

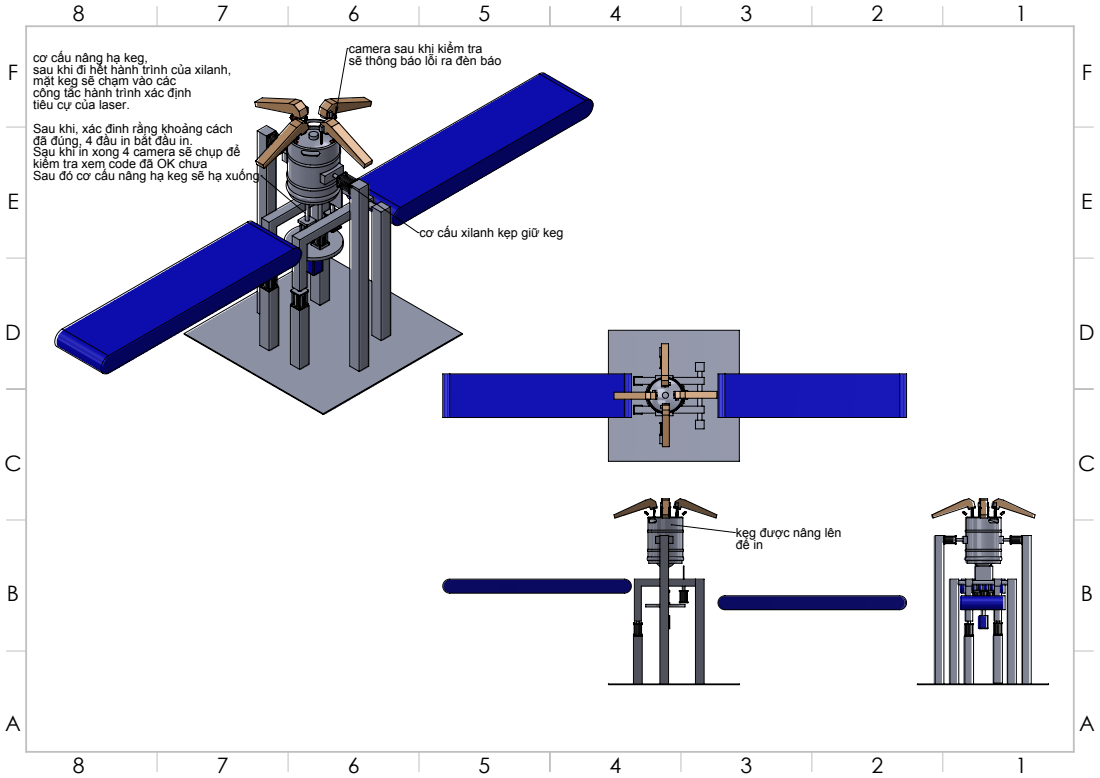
[picture p134: page 2]

camera sau khi kiểm tra
sẽ thông báo lỗi ra đèn báo

cơ cấu nâng hạ keg,
sau khi đi hết hành trình của xilanh,
mặt keg sẽ chạm vào các
công tắc hành trình xác định
tiêu cự của laser.
Sau khi, xác đinh rằng khoảng cách
đã đúng, 4 đầu in bắt đầu in.
Sau khi in xong 4 camera sẽ chụp để
kiểm tra xem code đã OK chưa
Sau đó cơ cấu nâng hạ keg sẽ hạ xuống

cơ cấu xilanh kẹp giữ keg

keg được nâng lên

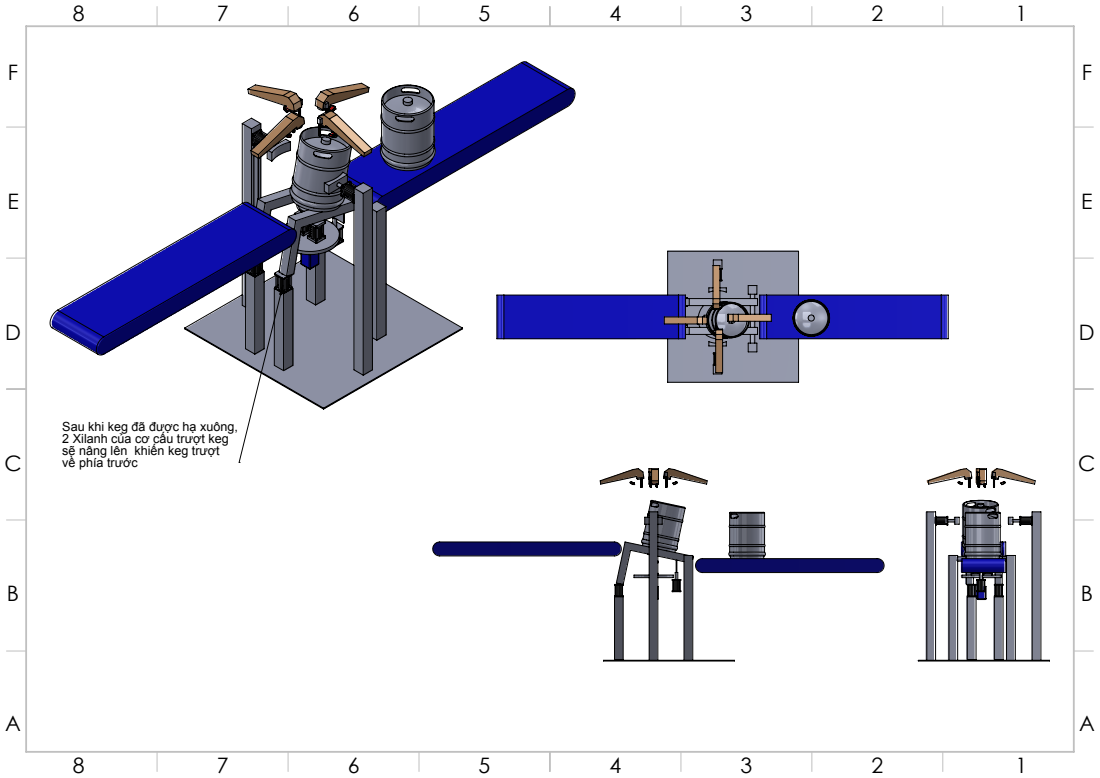
[picture p135: page 3]

Sau khi keg đã được hạ xuông,
2 Xilanh của cơ cấu trượt keg
sẽ nâng lên khiến keg trượt

về phía trước
