huan95nd/BAI_TAP_PHAN_MEM/BAI_TAP_SOLIDWORKS/AN_HONG/MV40MicroHAWK_Drawings/PDF/98-9000041-01Ext.PDF

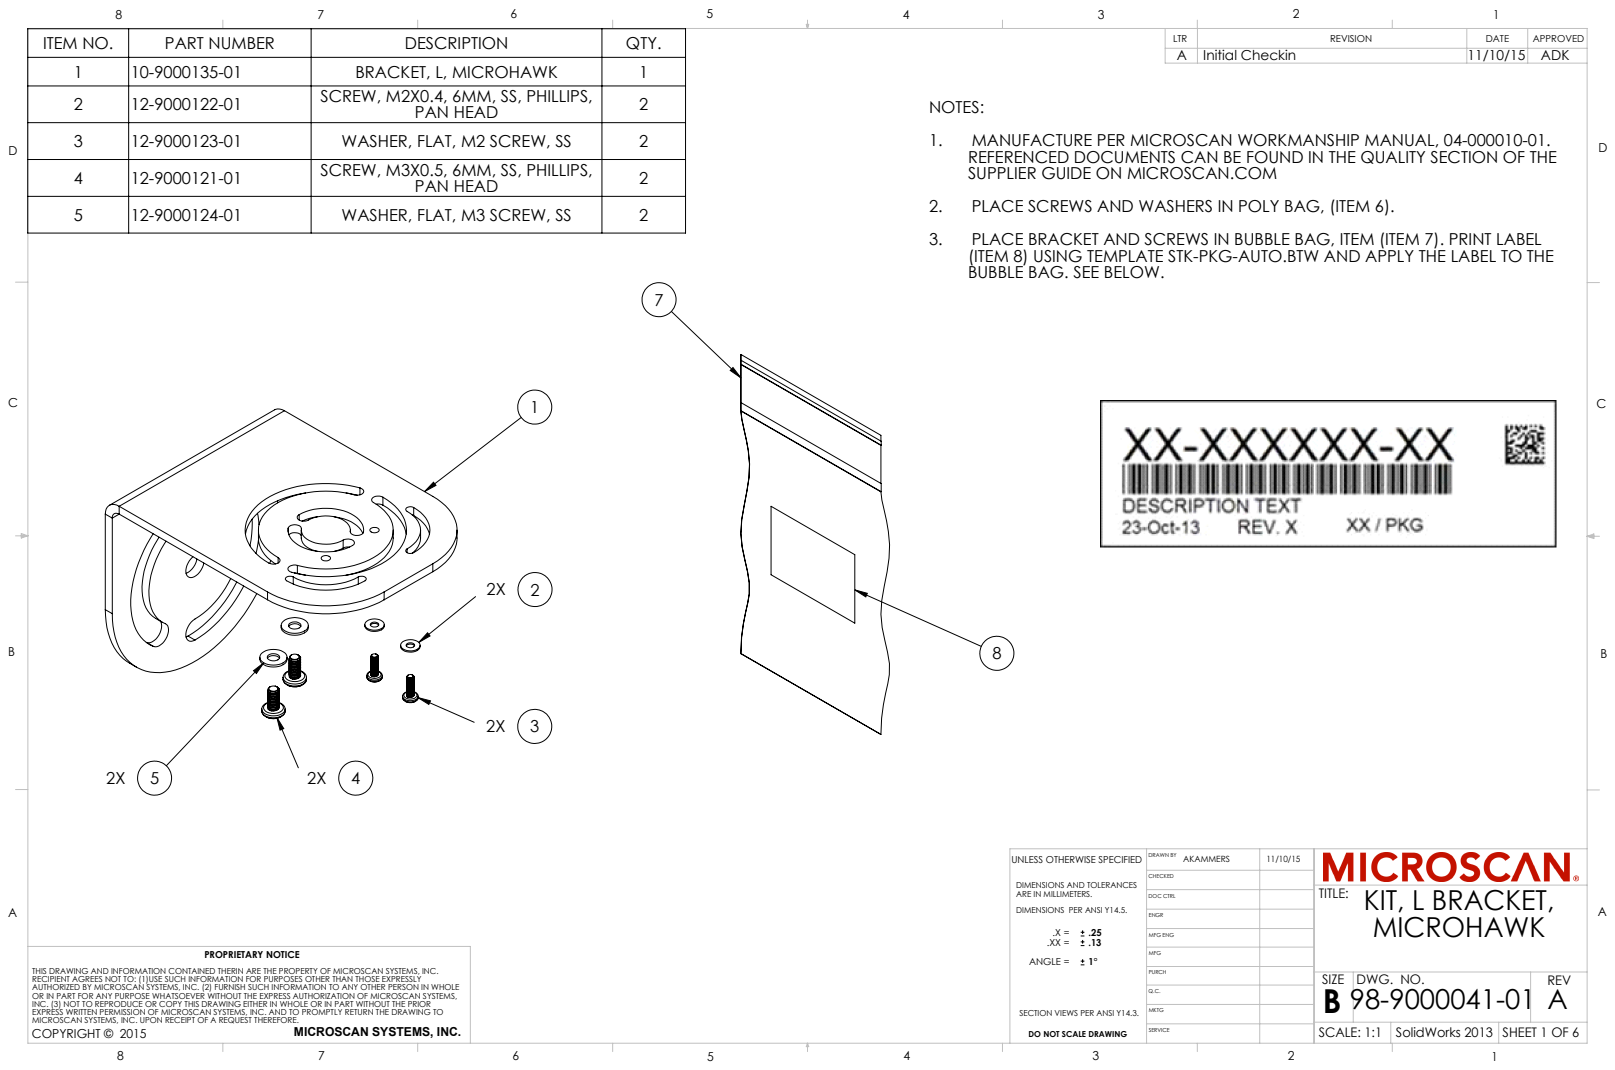
[picture p136: page 1]
DWG. NO.; REV; KIT, L BRACKET,; .XX = ANGLE =; COPYRIGHT © 2015; MICROSCAN SYSTEMS, INC.; SERVICE; PROPRIETARY NOTICE; DRAWN BY; DOC CTRL; MFG ENG; UNLESS OTHERWISE SPECIFIED; AKAMMERS; A Initial Checkin; 11/10/15 ADK

ITEM NO. | PART NUMBER | DESCRIPTION | QTY.
1 | 10-9000135-01 | BRACKET, L, MICROHAWK | 1
2 | 12-9000122-01 | SCREW, M2X0.4, 6MM, SS, PHILLIPS, PAN HEAD | 2

NOTES:
1. MANUFACTURE PER MICROSCAN WORKMANSHIP MANUAL, 04-000010-01.
REFERENCED DOCUMENTS CAN BE FOUND IN THE QUALITY SECTION OF THE
SUPPLIER GUIDE ON MICROSCAN.COM
2. PLACE SCREWS AND WASHERS IN POLY BAG, (ITEM 6).
3. PLACE BRACKET AND SCREWS IN BUBBLE BAG, ITEM (ITEM 7). PRINT LABEL
(ITEM 8) USING TEMPLATE STK-PKG-AUTO.BTW AND APPLY THE LABEL TO THE
BUBBLE BAG. SEE BELOW.

3 | 12-9000123-01 | WASHER, FLAT, M2 SCREW, SS | 2
4 | 12-9000121-01 | SCREW, M3X0.5, 6MM, SS, PHILLIPS, PAN HEAD | 2

5 | 12-9000124-01 | WASHER, FLAT, M3 SCREW, SS | 2

DIMENSIONS AND TOLERANCES
ARE IN MILLIMETERS.
DIMENSIONS PER ANSI Y14.5.

THIS DRAWING AND INFORMATION CONTAINED THERIN ARE THE PROPERTY OF MICROSCAN SYSTEMS, INC.
RECIPIENT AGREES NOT TO: (1)USE SUCH INFORMATION FOR PURPOSES OTHER THAN THOSE EXPRESSLY
AUTHORIZED BY MICROSCAN SYSTEMS, INC. (2) FURNISH SUCH INFORMATION TO ANY OTHER PERSON IN WHOLE
OR IN PART FOR ANY PURPOSE WHATSOEVER WITHOUT THE EXPRESS AUTHORIZATION OF MICROSCAN SYSTEMS,
INC. (3) NOT TO REPRODUCE OR COPY THIS DRAWING EITHER IN WHOLE OR IN PART WITHOUT THE PRIOR
EXPRESS WRITTEN PERMISSION OF MICROSCAN SYSTEMS, INC. AND TO PROMPTLY RETURN THE DRAWING TO
MICROSCAN SYSTEMS, INC. UPON RECEIPT OF A REQUEST THEREFORE.

SECTION VIEWS PER ANSI Y14.3.
DO NOT SCALE DRAWING

SCALE: 1:1 SolidWorks 2013 SHEET 1 OF 6

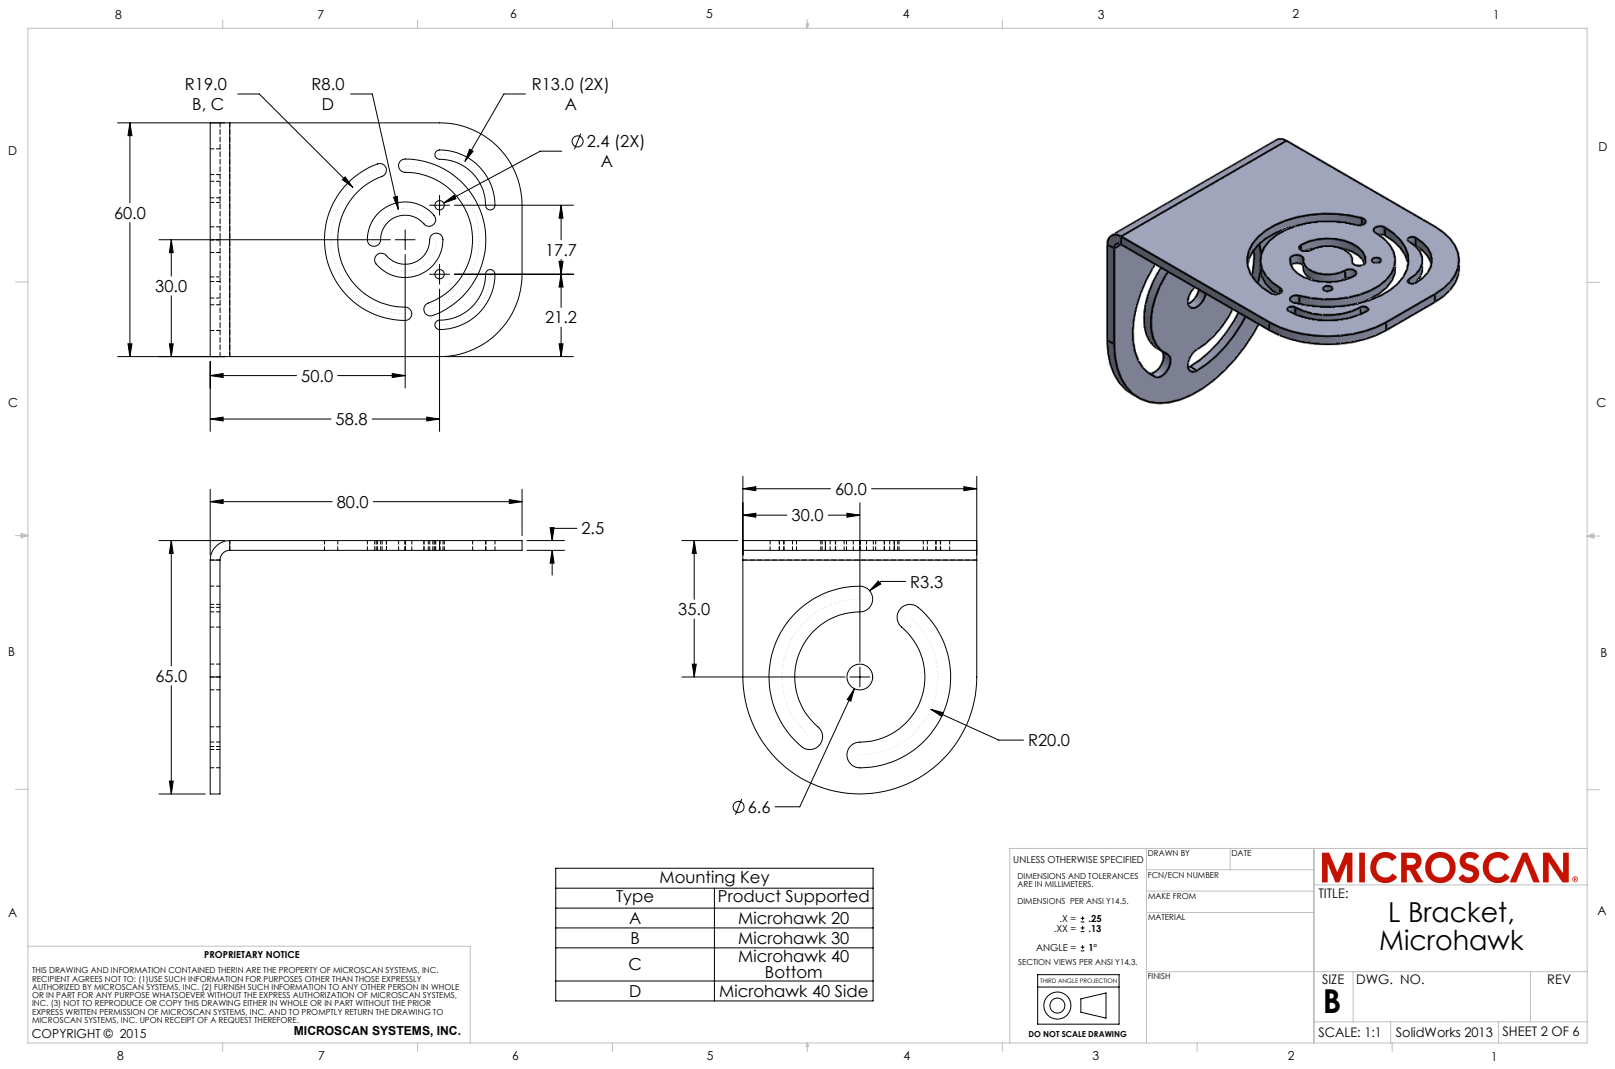
[picture p137: page 2]
Mounting Key; DWG. NO.; REV; L Bracket,; COPYRIGHT © 2015; MICROSCAN SYSTEMS, INC.; PROPRIETARY NOTICE; DO NOT SCALE DRAWING; SCALE: 1:1 SolidWorks 2013 SHEET 2 OF 6; MAKE FROM; DRAWN BY; DATE

UNLESS OTHERWISE SPECIFIED
DIMENSIONS AND TOLERANCES
ARE IN MILLIMETERS.
DIMENSIONS PER ANSI Y14.5.

FCN/ECN NUMBER

Type | Product Supported
A | Microhawk 20
B | Microhawk 30
C | Microhawk 40 Bottom
D | Microhawk 40 Side

ANGLE =
SECTION VIEWS PER ANSI Y14.3.

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

THIRD ANGLE PROJECTION

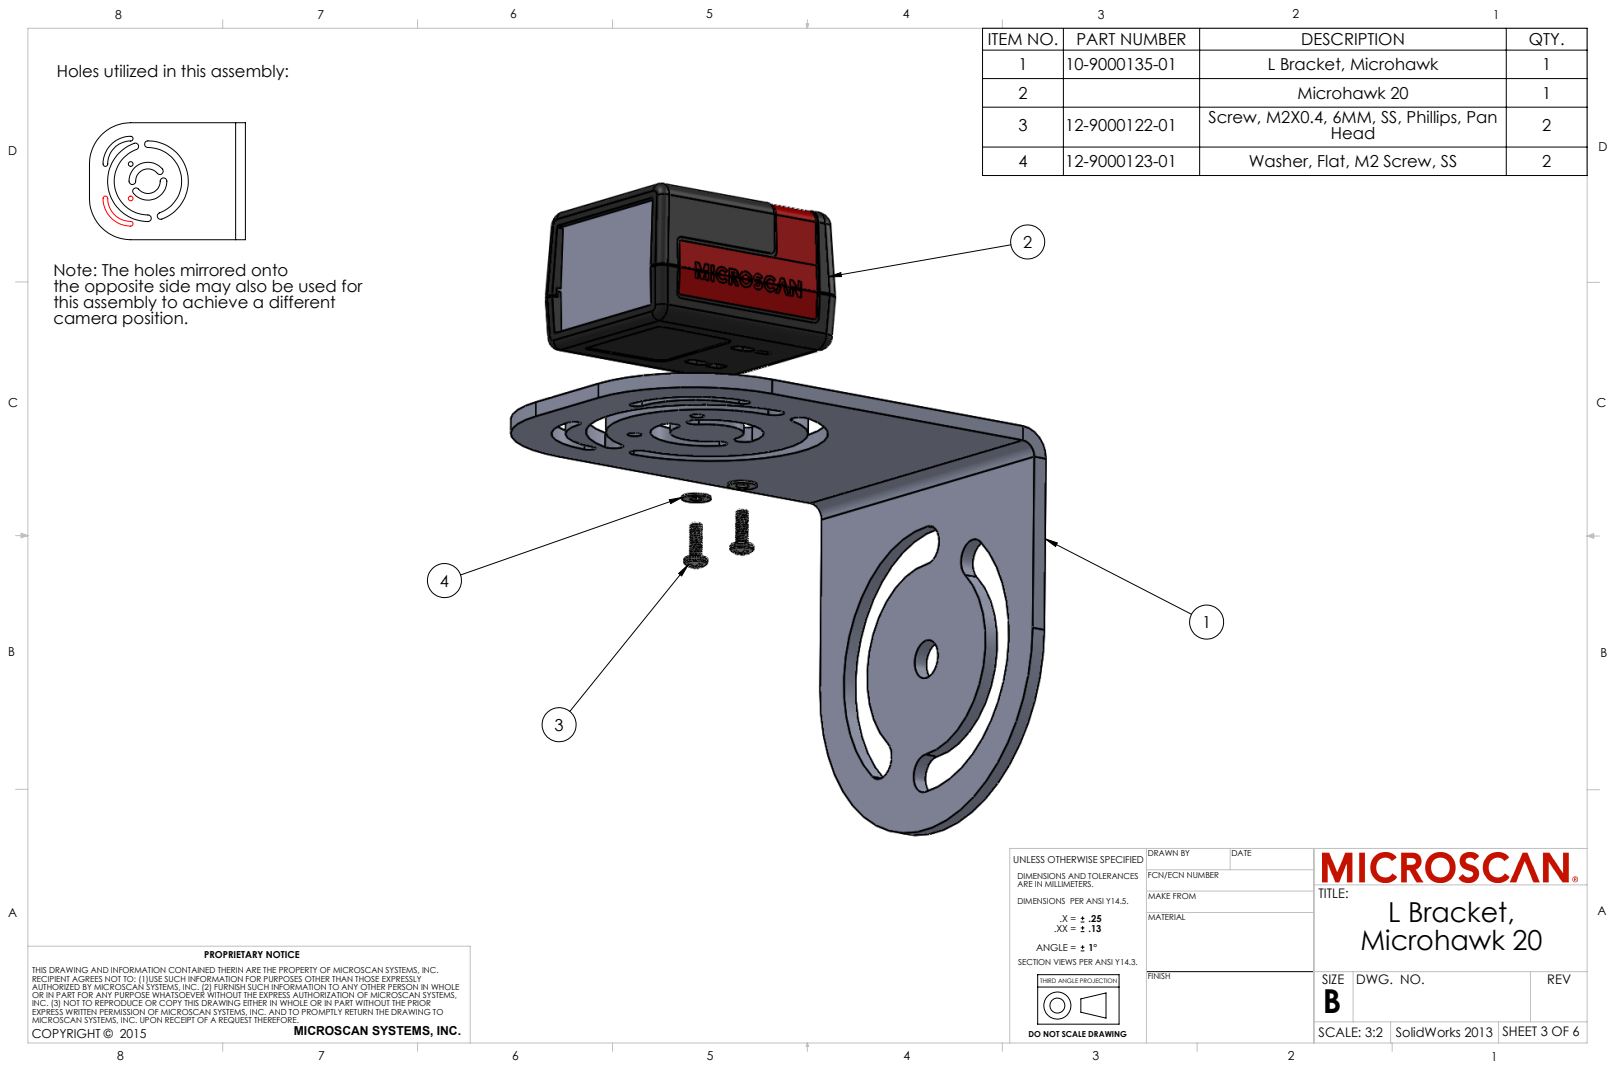
[picture p138: page 3]
DWG. NO.; REV; L Bracket, Microhawk 20; PROPRIETARY NOTICE; DO NOT SCALE DRAWING; SCALE: 3:2 SolidWorks 2013 SHEET 3 OF 6; MAKE FROM; DRAWN BY; DATE

Holes utilized in this assembly:

1 | 10-9000135-01 | L Bracket, Microhawk | 1
2 | | Microhawk 20 | 1
3 | 12-9000122-01 | Screw, M2X0.4, 6MM, SS, Phillips, Pan Head | 2

4 | 12-9000123-01 | Washer, Flat, M2 Screw, SS | 2

Note: The holes mirrored onto
the opposite side may also be used for
this assembly to achieve a different
camera position.

UNLESS OTHERWISE SPECIFIED
DIMENSIONS AND TOLERANCES
ARE IN MILLIMETERS.
DIMENSIONS PER ANSI Y14.5.

FCN/ECN NUMBER

ANGLE =
SECTION VIEWS PER ANSI Y14.3.

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

THIRD ANGLE PROJECTION

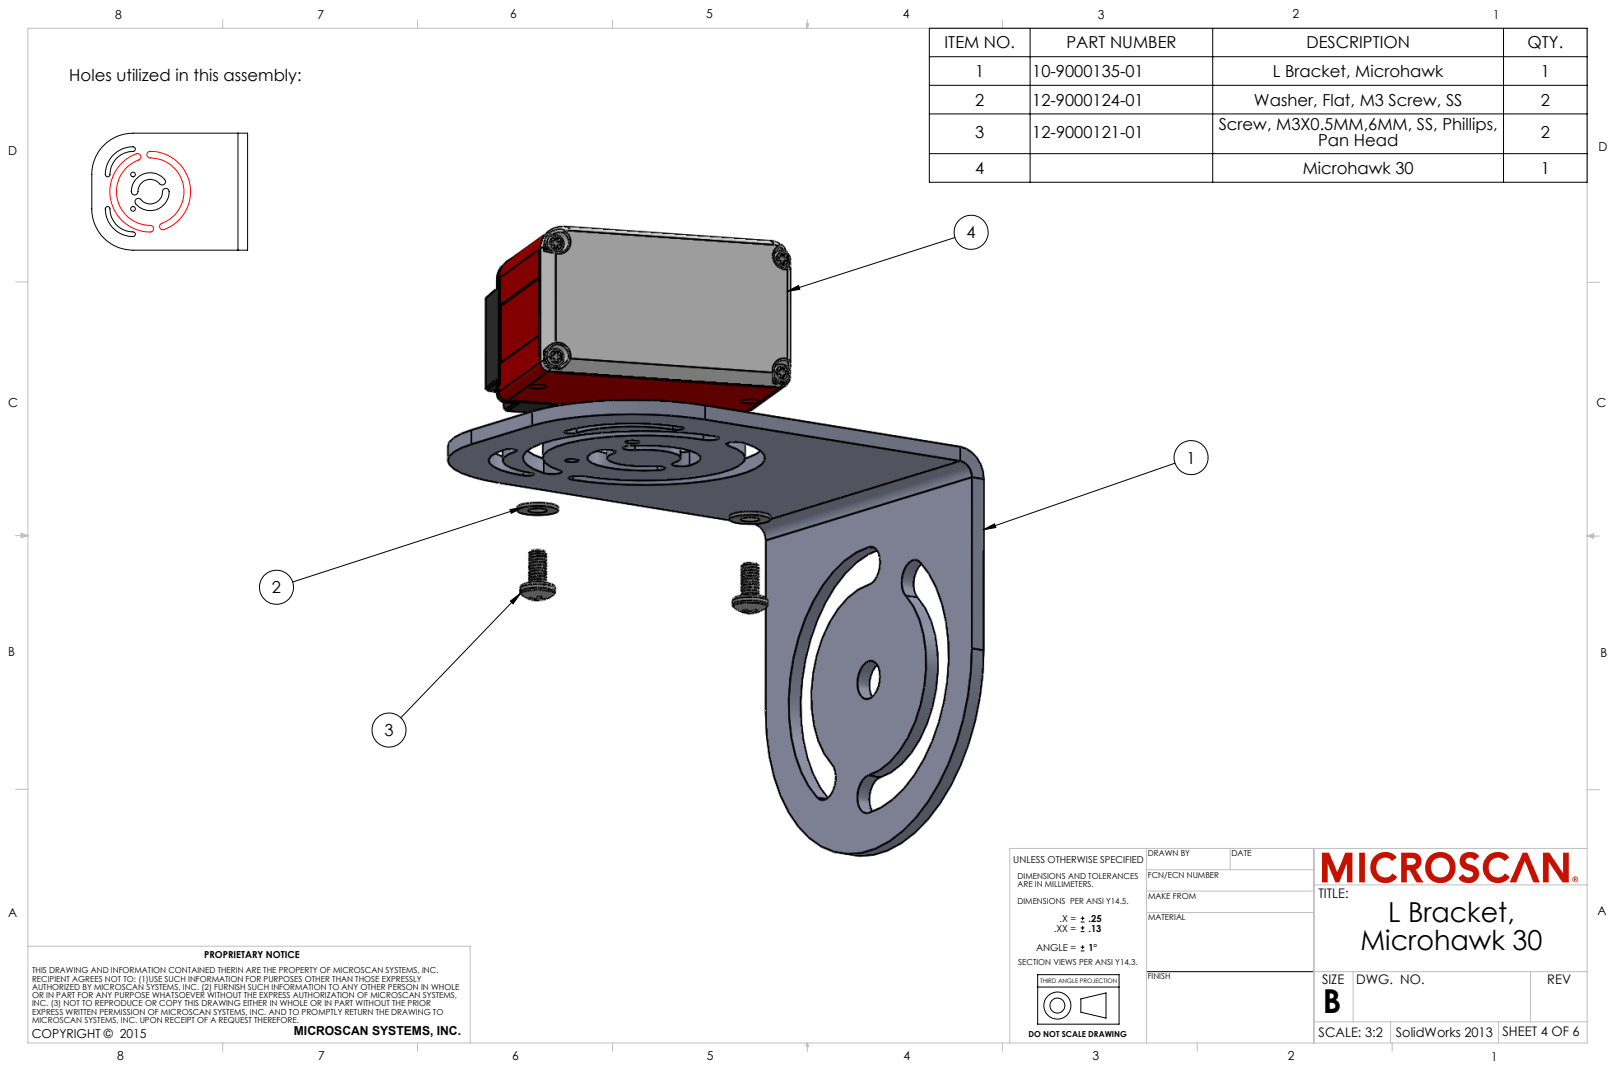
[picture p139: page 4]
DWG. NO.; REV; L Bracket, Microhawk 30; PROPRIETARY NOTICE; DO NOT SCALE DRAWING; SCALE: 3:2 SolidWorks 2013 SHEET 4 OF 6; MAKE FROM; DRAWN BY; DATE

2 | 12-9000124-01 | Washer, Flat, M3 Screw, SS | 2
3 | 12-9000121-01 | Screw, M3X0.5MM,6MM, SS, Phillips, Pan Head | 2

4 | | Microhawk 30 | 1

UNLESS OTHERWISE SPECIFIED
DIMENSIONS AND TOLERANCES
ARE IN MILLIMETERS.
DIMENSIONS PER ANSI Y14.5.

FCN/ECN NUMBER

ANGLE =
SECTION VIEWS PER ANSI Y14.3.

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

THIRD ANGLE PROJECTION

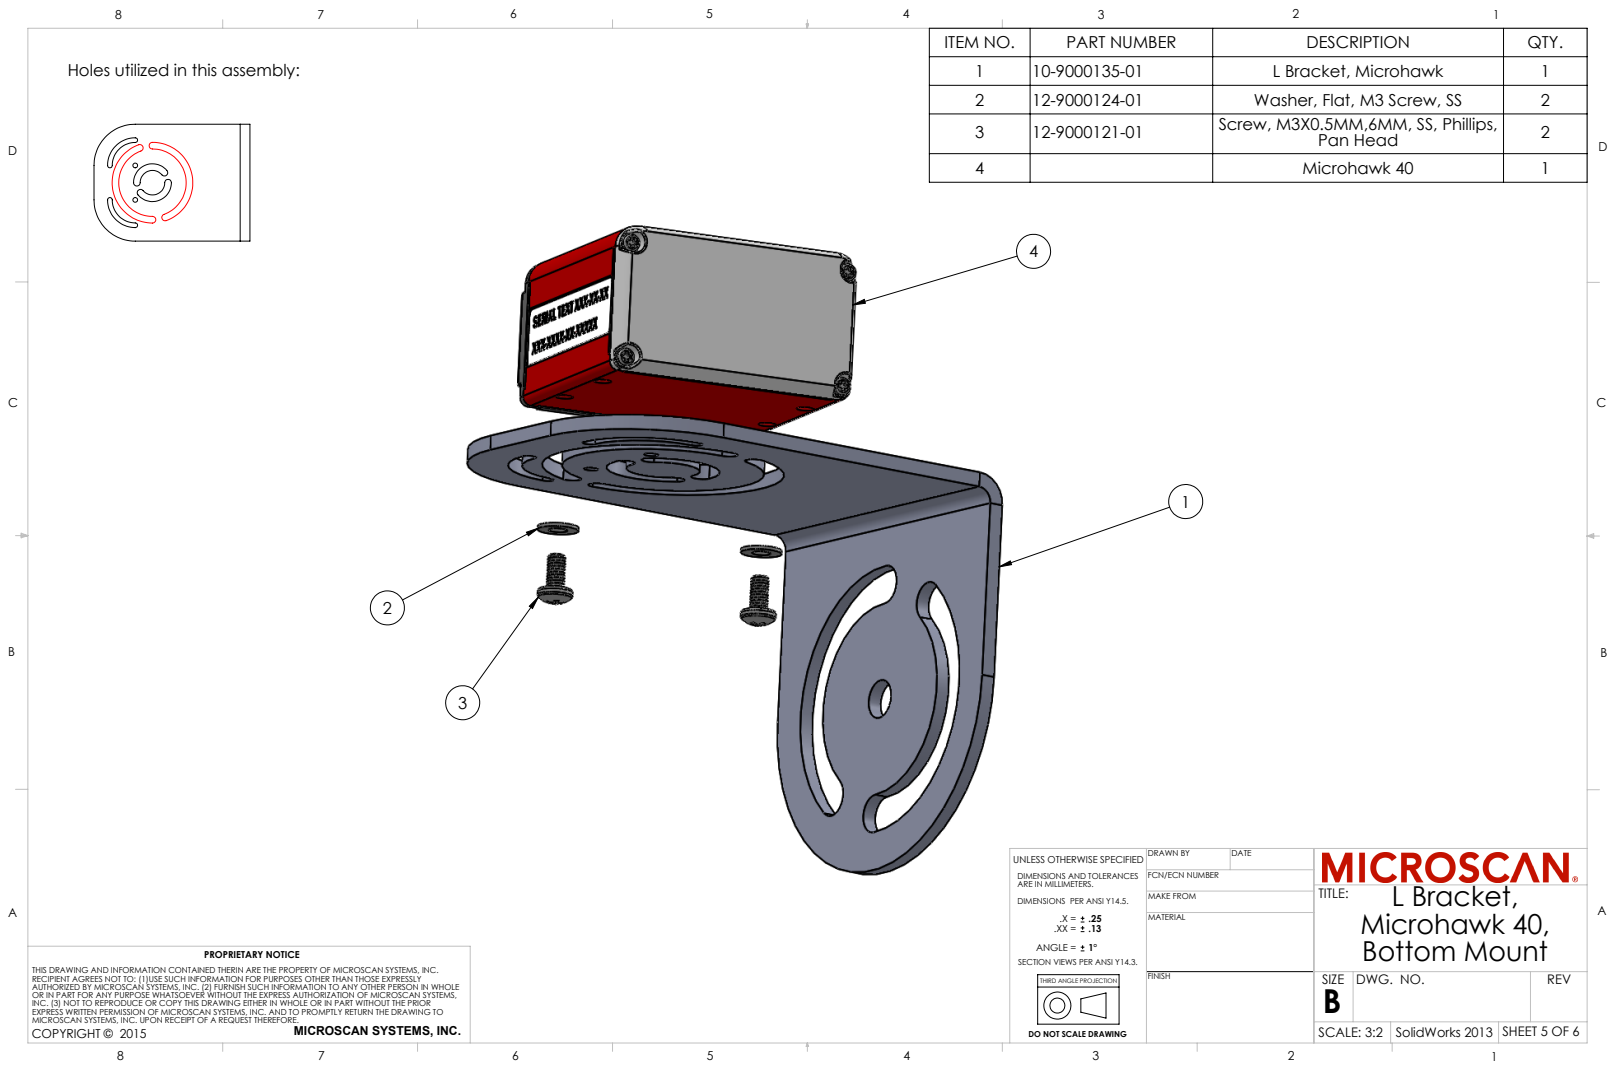
[picture p140: page 5]
DWG. NO.; REV; L Bracket, Microhawk 40,; SECTION VIEWS PER ANSI Y14.3.; Bottom Mount; .X = .XX = ANGLE =; PROPRIETARY NOTICE; DO NOT SCALE DRAWING; SCALE: 3:2 SolidWorks 2013 SHEET 5 OF 6; MAKE FROM; DRAWN BY; DATE

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

4 | | Microhawk 40 | 1

UNLESS OTHERWISE SPECIFIED
DIMENSIONS AND TOLERANCES
ARE IN MILLIMETERS.
DIMENSIONS PER ANSI Y14.5.

FCN/ECN NUMBER

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

THIRD ANGLE PROJECTION

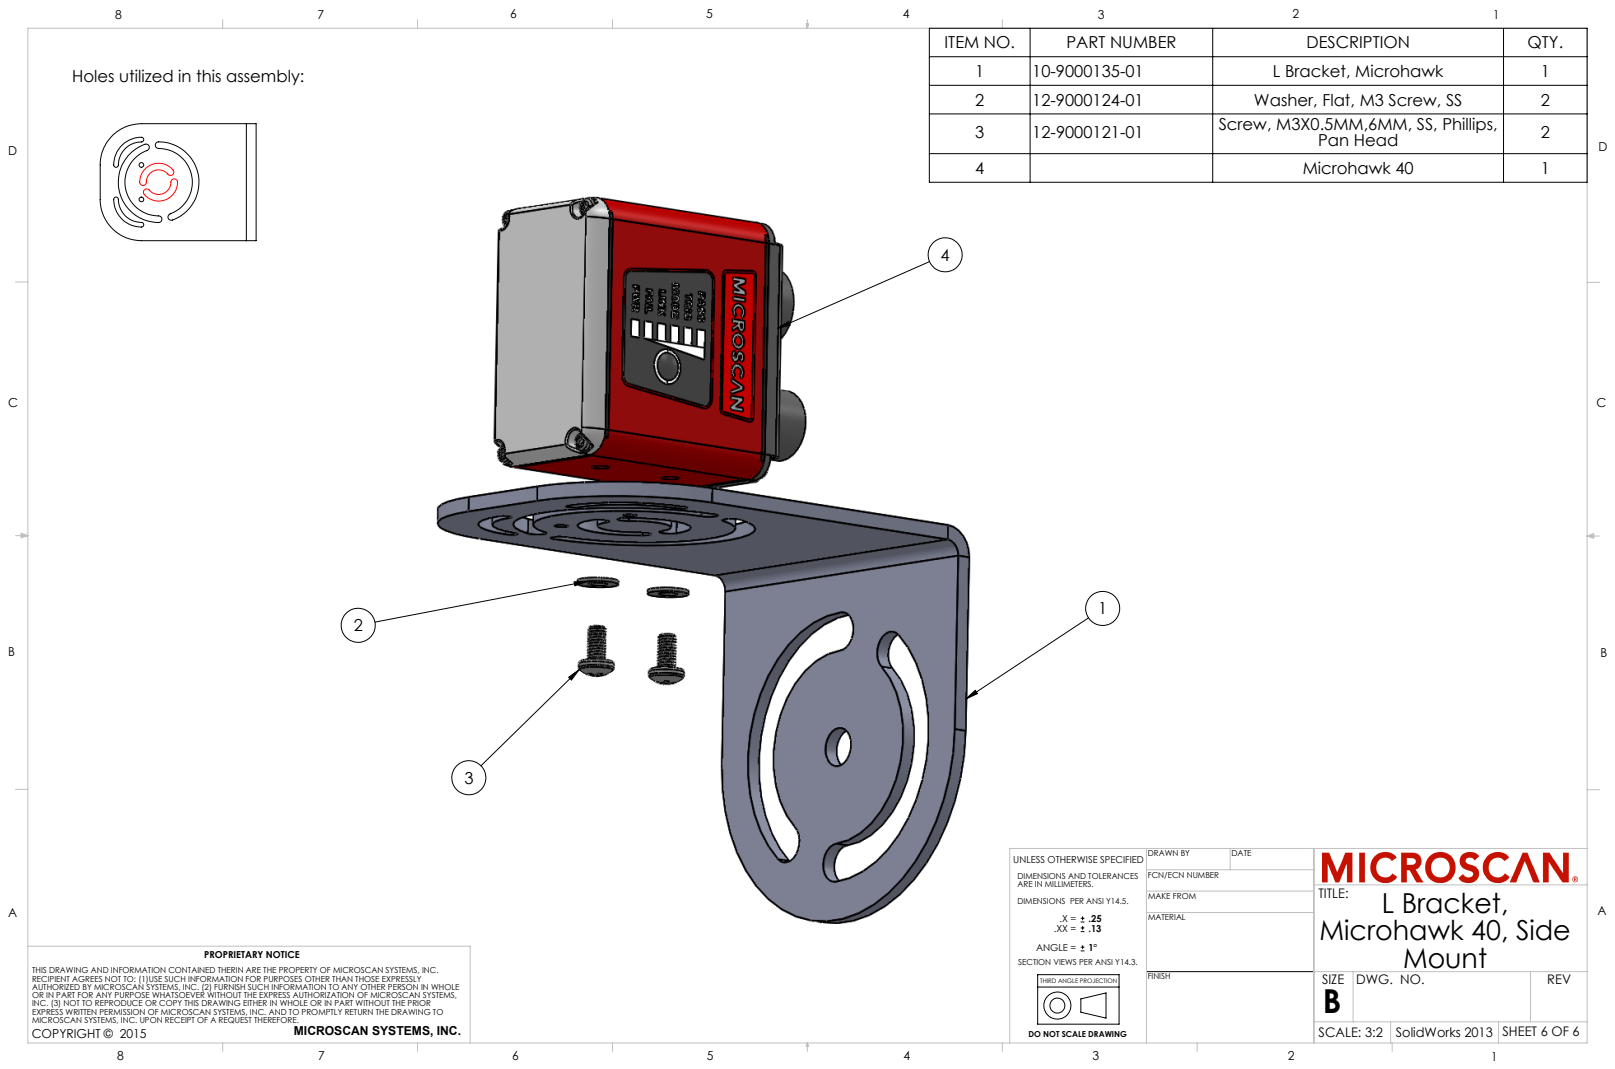
[picture p141: page 6]
DWG. NO.; REV; L Bracket, Microhawk 40, Side; SECTION VIEWS PER ANSI Y14.3.; Mount; .X = .XX = ANGLE =; PROPRIETARY NOTICE; DO NOT SCALE DRAWING; SCALE: 3:2 SolidWorks 2013 SHEET 6 OF 6; MAKE FROM; DRAWN BY; DATE

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

4 | | Microhawk 40 | 1

UNLESS OTHERWISE SPECIFIED
DIMENSIONS AND TOLERANCES
ARE IN MILLIMETERS.
DIMENSIONS PER ANSI Y14.5.

FCN/ECN NUMBER

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

THIRD ANGLE PROJECTION
