huan95nd/BAI_TAP_PHAN_MEM/BAI_TAP_SOLIDWORKS/AN_HONG/MV40MicroHAWK_Drawings/PDF/98-9000047-01Ext.PDF

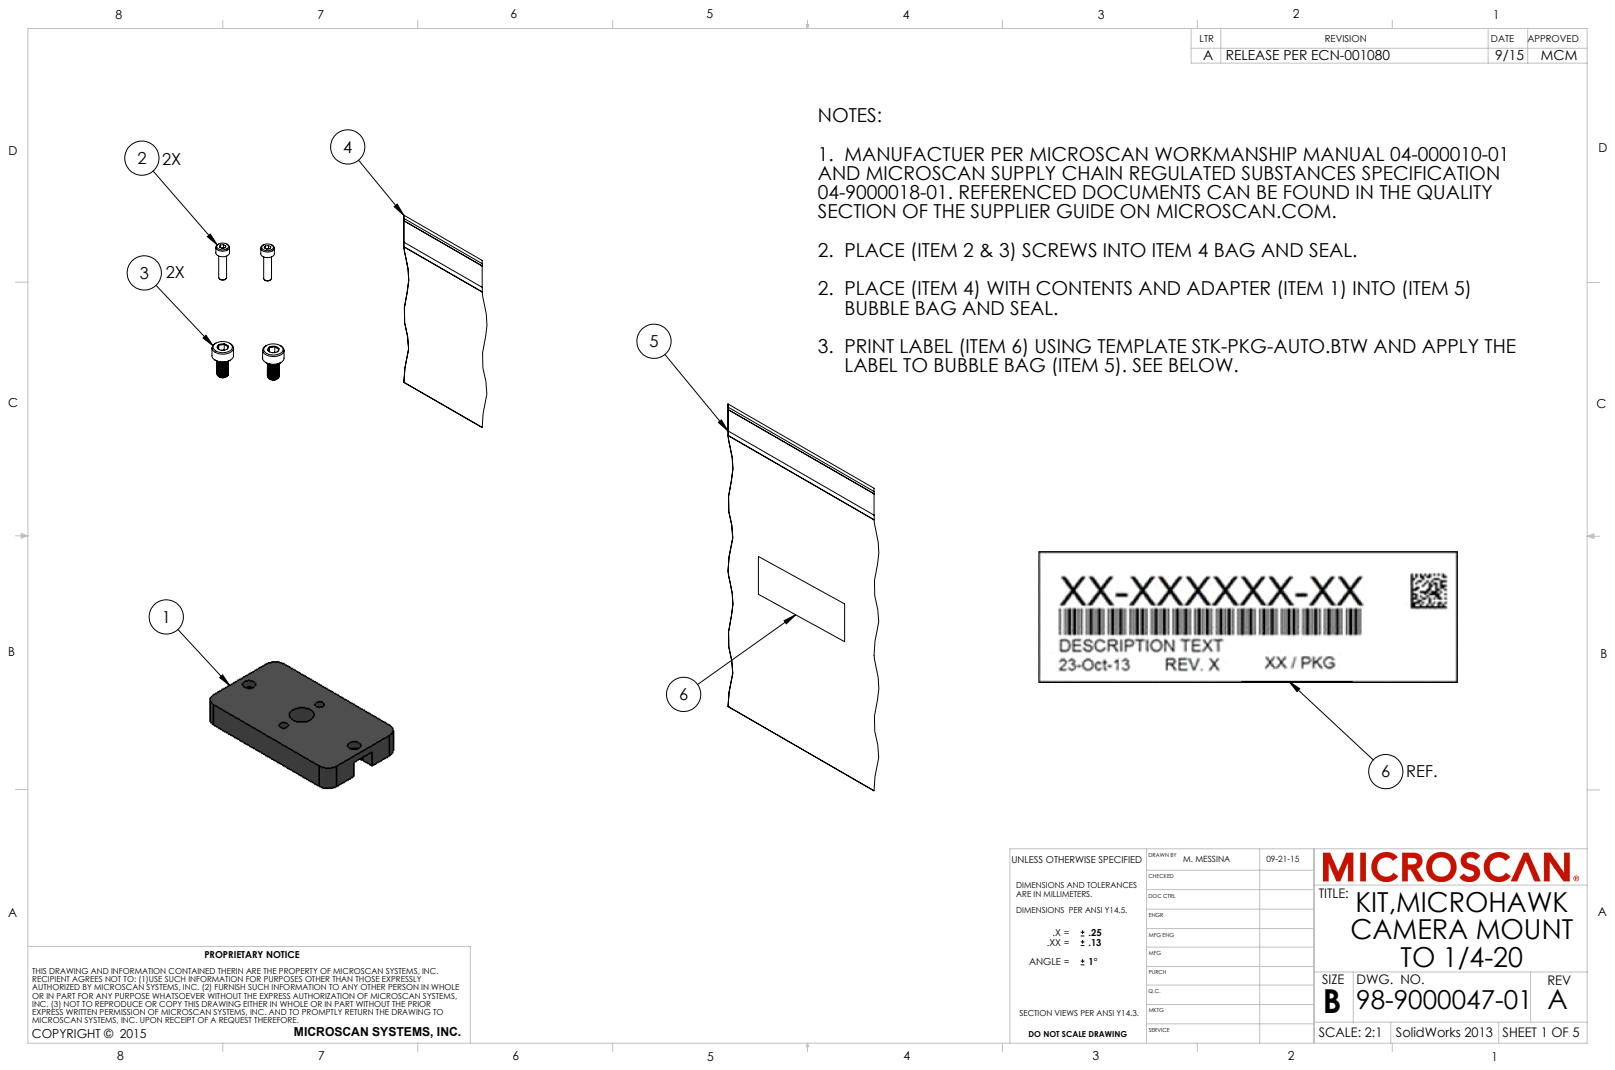
[picture p142: page 1]
DWG. NO.; REV; CAMERA MOUNT TO 1/4-20; .XX = ANGLE =; COPYRIGHT © 2015; MICROSCAN SYSTEMS, INC.; SERVICE; PROPRIETARY NOTICE; DRAWN BY; DOC CTRL; MFG ENG; UNLESS OTHERWISE SPECIFIED; M. MESSINA; LTR; REVISION; DATE APPROVED; 9/15 MCM

A RELEASE PER ECN-001080

NOTES:
1. MANUFACTUER PER MICROSCAN WORKMANSHIP MANUAL 04-000010-01
AND MICROSCAN SUPPLY CHAIN REGULATED SUBSTANCES SPECIFICATION
04-9000018-01. REFERENCED DOCUMENTS CAN BE FOUND IN THE QUALITY
SECTION OF THE SUPPLIER GUIDE ON MICROSCAN.COM.
2. PLACE (ITEM 2 & 3) SCREWS INTO ITEM 4 BAG AND SEAL.
2. PLACE (ITEM 4) WITH CONTENTS AND ADAPTER (ITEM 1) INTO (ITEM 5)
BUBBLE BAG AND SEAL.
3. PRINT LABEL (ITEM 6) USING TEMPLATE STK-PKG-AUTO.BTW AND APPLY THE
LABEL TO BUBBLE BAG (ITEM 5). SEE BELOW.

DIMENSIONS AND TOLERANCES
ARE IN MILLIMETERS.
DIMENSIONS PER ANSI Y14.5.

THIS DRAWING AND INFORMATION CONTAINED THERIN ARE THE PROPERTY OF MICROSCAN SYSTEMS, INC.
RECIPIENT AGREES NOT TO: (1)USE SUCH INFORMATION FOR PURPOSES OTHER THAN THOSE EXPRESSLY
AUTHORIZED BY MICROSCAN SYSTEMS, INC. (2) FURNISH SUCH INFORMATION TO ANY OTHER PERSON IN WHOLE
OR IN PART FOR ANY PURPOSE WHATSOEVER WITHOUT THE EXPRESS AUTHORIZATION OF MICROSCAN SYSTEMS,
INC. (3) NOT TO REPRODUCE OR COPY THIS DRAWING EITHER IN WHOLE OR IN PART WITHOUT THE PRIOR
EXPRESS WRITTEN PERMISSION OF MICROSCAN SYSTEMS, INC. AND TO PROMPTLY RETURN THE DRAWING TO
MICROSCAN SYSTEMS, INC. UPON RECEIPT OF A REQUEST THEREFORE.

SECTION VIEWS PER ANSI Y14.3.
DO NOT SCALE DRAWING

SCALE: 2:1 SolidWorks 2013 SHEET 1 OF 5

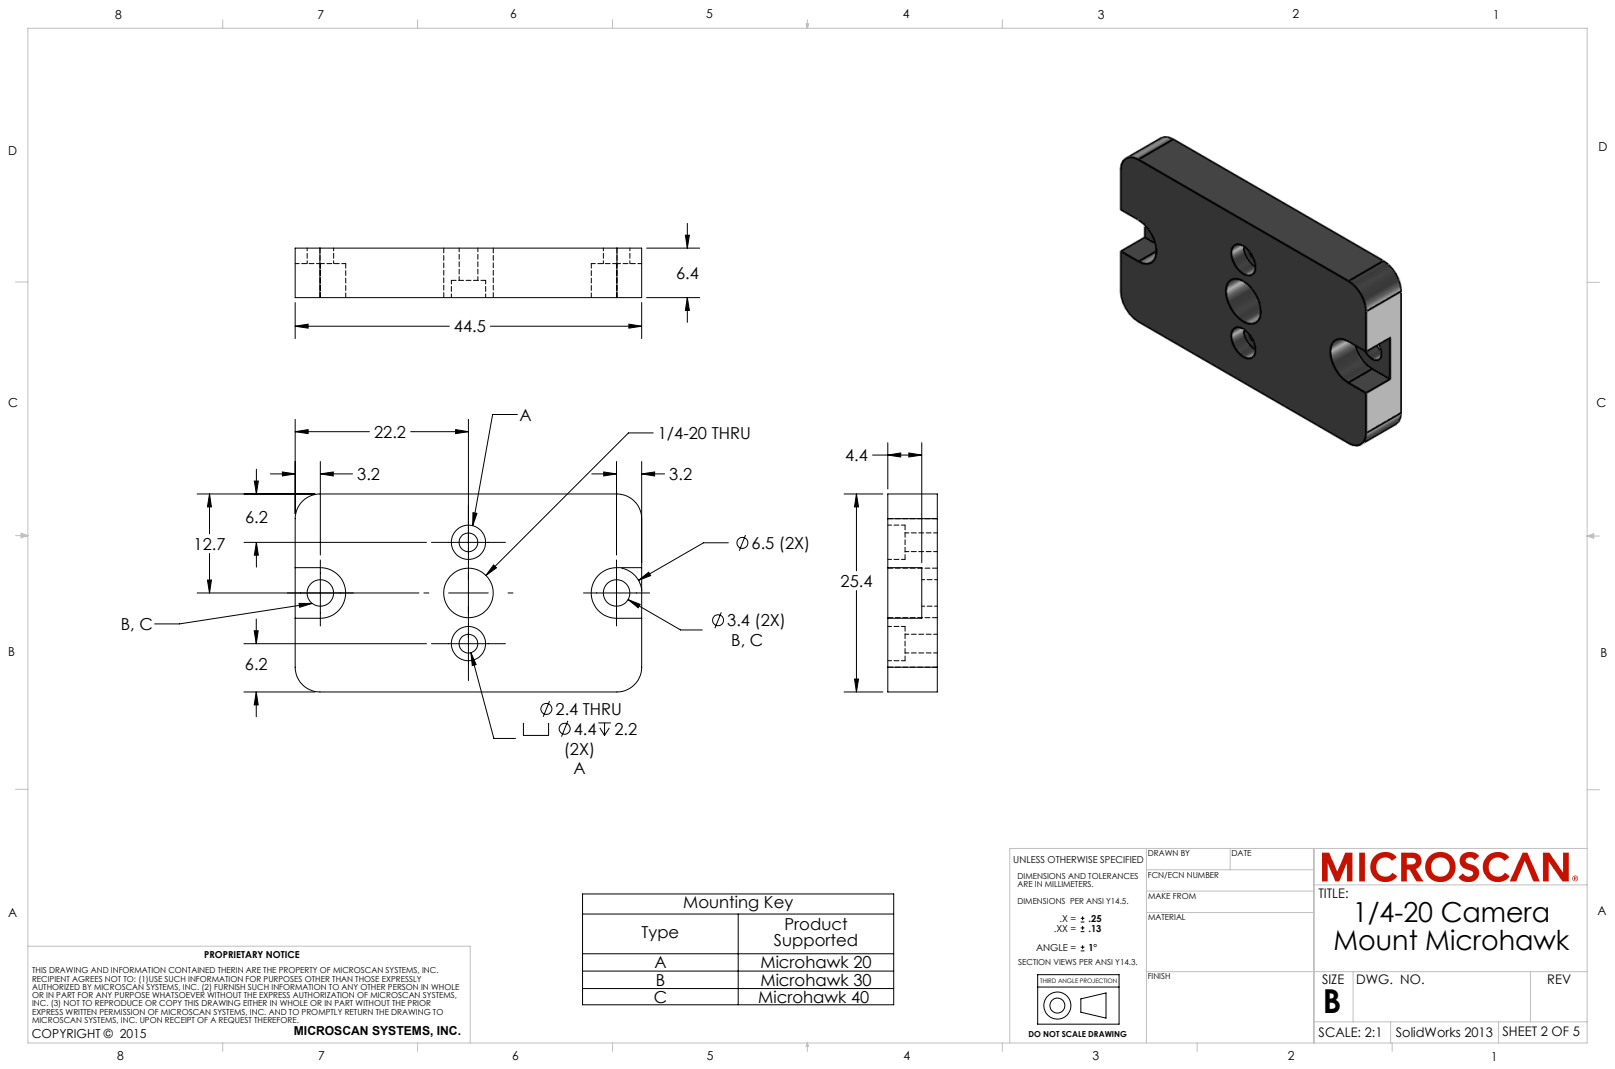
[picture p143: page 2]
1/4-20 THRU; 2.4 THRU 4.4 2.2; Mounting Key; DWG. NO.; REV; 1/4-20 Camera Mount Microhawk; COPYRIGHT © 2015; MICROSCAN SYSTEMS, INC.; PROPRIETARY NOTICE; DO NOT SCALE DRAWING; SCALE: 2:1 SolidWorks 2013 SHEET 2 OF 5; MAKE FROM; DRAWN BY; DATE

UNLESS OTHERWISE SPECIFIED
DIMENSIONS AND TOLERANCES
ARE IN MILLIMETERS.
DIMENSIONS PER ANSI Y14.5.

FCN/ECN NUMBER

Type | Product Supported
A | Microhawk 20
B | Microhawk 30
C | Microhawk 40

ANGLE =
SECTION VIEWS PER ANSI Y14.3.

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

THIRD ANGLE PROJECTION

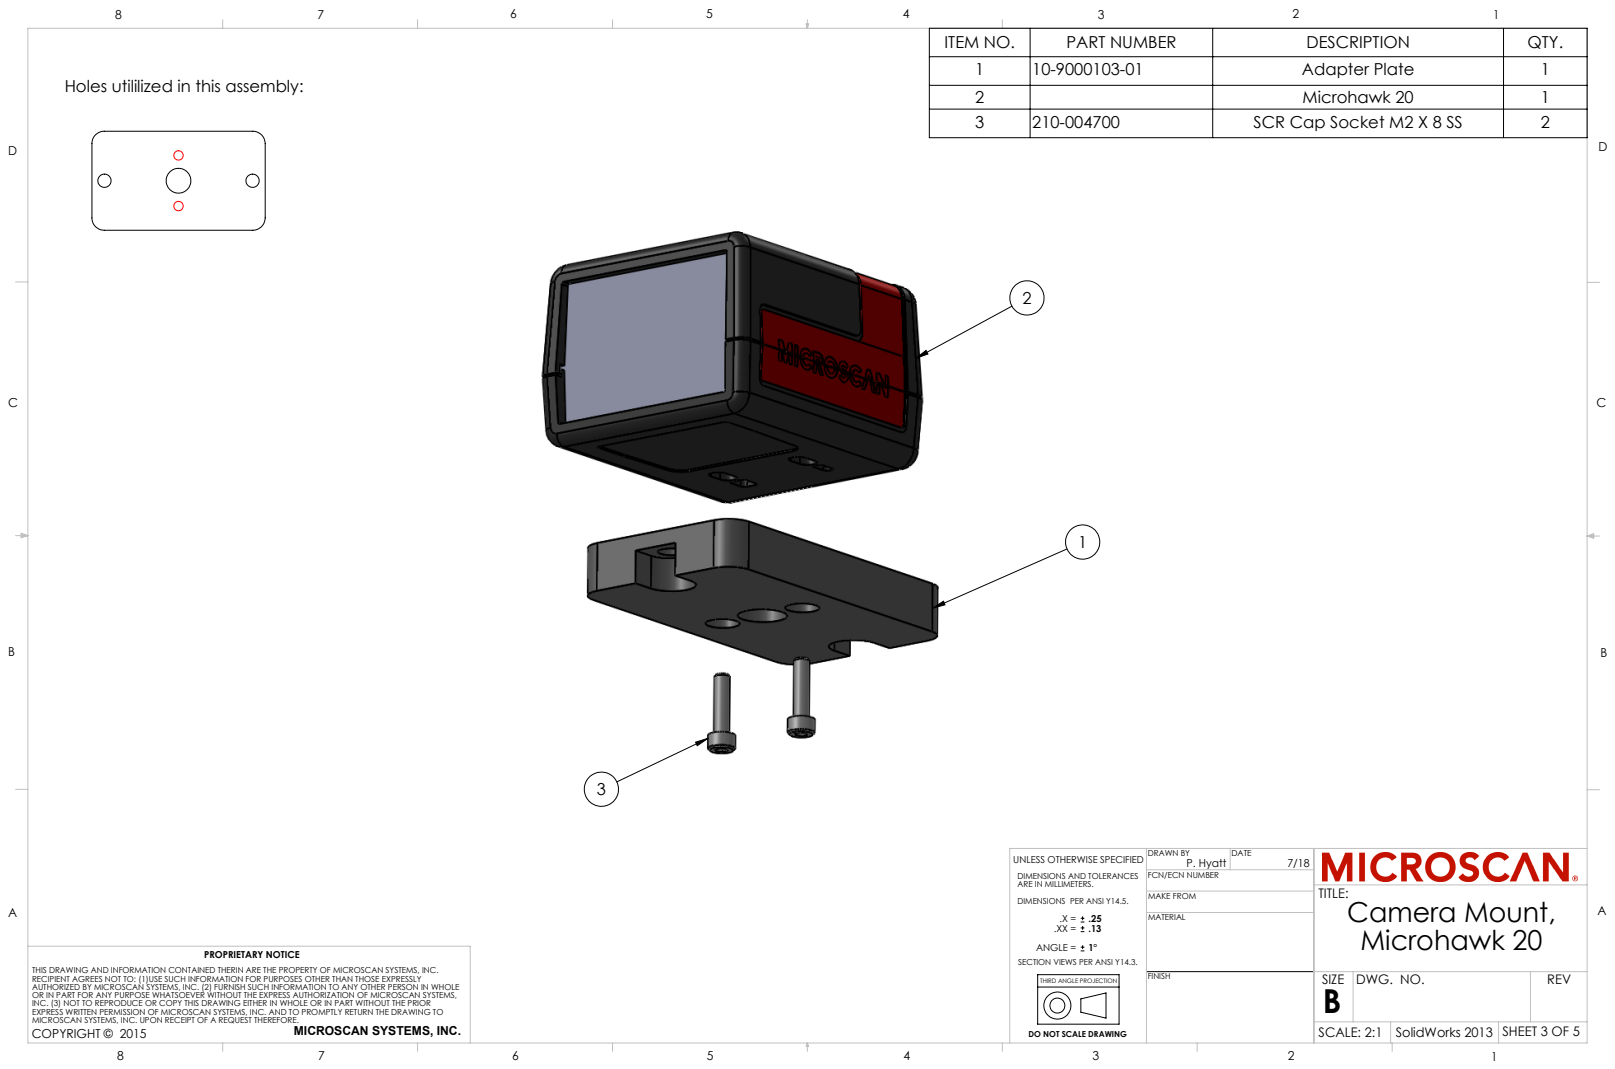
[picture p144: page 3]
DWG. NO.; REV; Camera Mount, Microhawk 20; PROPRIETARY NOTICE; DO NOT SCALE DRAWING; SCALE: 2:1 SolidWorks 2013 SHEET 3 OF 5; MAKE FROM; P. Hyatt; 7/18 DRAWN BY; DATE

ITEM NO. | PART NUMBER | DESCRIPTION | QTY.
1 | 10-9000103-01 | Adapter Plate | 1
2 | | Microhawk 20 | 1
3 | 210-004700 | SCR Cap Socket M2 X 8 SS | 2

Holes utililized in this assembly:

UNLESS OTHERWISE SPECIFIED
DIMENSIONS AND TOLERANCES
ARE IN MILLIMETERS.
DIMENSIONS PER ANSI Y14.5.

FCN/ECN NUMBER

ANGLE =
SECTION VIEWS PER ANSI Y14.3.

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

THIRD ANGLE PROJECTION

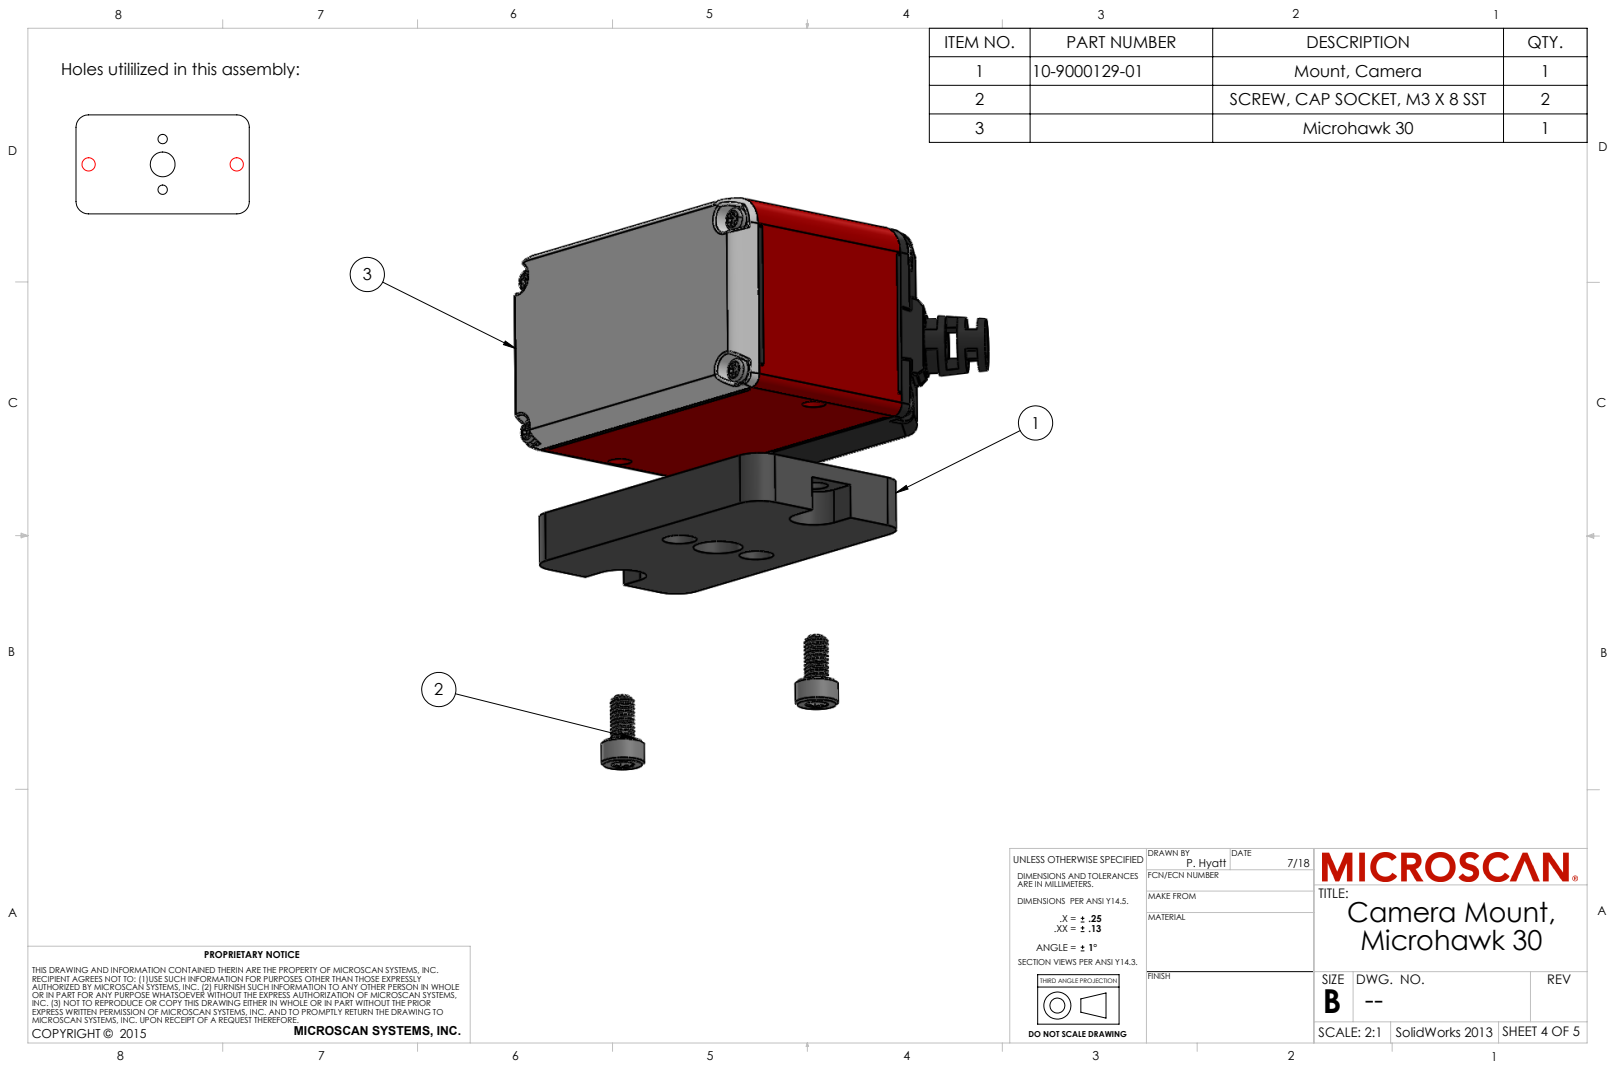
[picture p145: page 4]
DWG. NO.; REV; Camera Mount, Microhawk 30; PROPRIETARY NOTICE; DO NOT SCALE DRAWING; SCALE: 2:1 SolidWorks 2013 SHEET 4 OF 5; MAKE FROM; P. Hyatt; 7/18 DRAWN BY; DATE

Holes utililized in this assembly:

1 | 10-9000129-01 | Mount, Camera | 1
2 | | SCREW, CAP SOCKET, M3 X 8 SST | 2
3 | | Microhawk 30 | 1

UNLESS OTHERWISE SPECIFIED
DIMENSIONS AND TOLERANCES
ARE IN MILLIMETERS.
DIMENSIONS PER ANSI Y14.5.

FCN/ECN NUMBER

ANGLE =
SECTION VIEWS PER ANSI Y14.3.

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

THIRD ANGLE PROJECTION

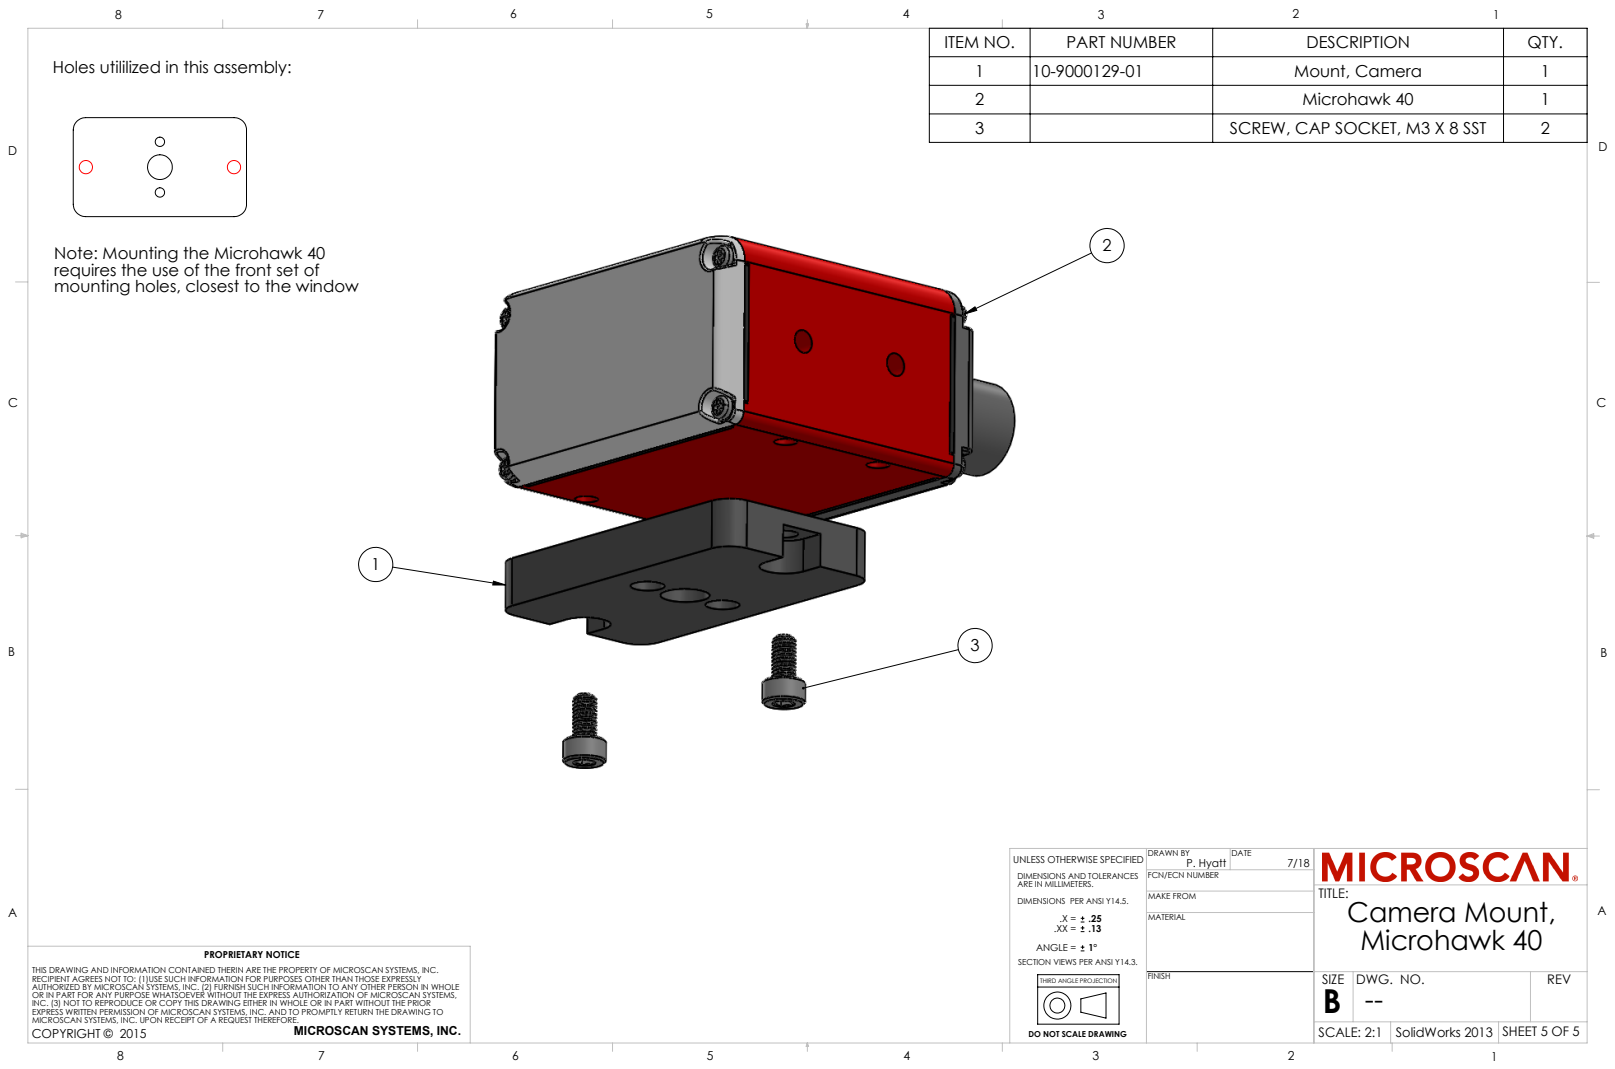
[picture p146: page 5]
DWG. NO.; REV; Camera Mount, Microhawk 40; PROPRIETARY NOTICE; DO NOT SCALE DRAWING; SCALE: 2:1 SolidWorks 2013 SHEET 5 OF 5; MAKE FROM; P. Hyatt; 7/18 DRAWN BY; DATE

Holes utililized in this assembly:

1 | 10-9000129-01 | Mount, Camera | 1
2 | | Microhawk 40 | 1
3 | | SCREW, CAP SOCKET, M3 X 8 SST | 2

Note: Mounting the Microhawk 40
requires the use of the front set of
mounting holes, closest to the window

UNLESS OTHERWISE SPECIFIED
DIMENSIONS AND TOLERANCES
ARE IN MILLIMETERS.
DIMENSIONS PER ANSI Y14.5.

FCN/ECN NUMBER

ANGLE =
SECTION VIEWS PER ANSI Y14.3.

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

THIRD ANGLE PROJECTION
