huan95nd/BAI_TAP_PHAN_MEM/BAI_TAP_SOLIDWORKS/AN_HONG/MV40MicroHAWK_Drawings/PDF/98-9000052-01.PDF

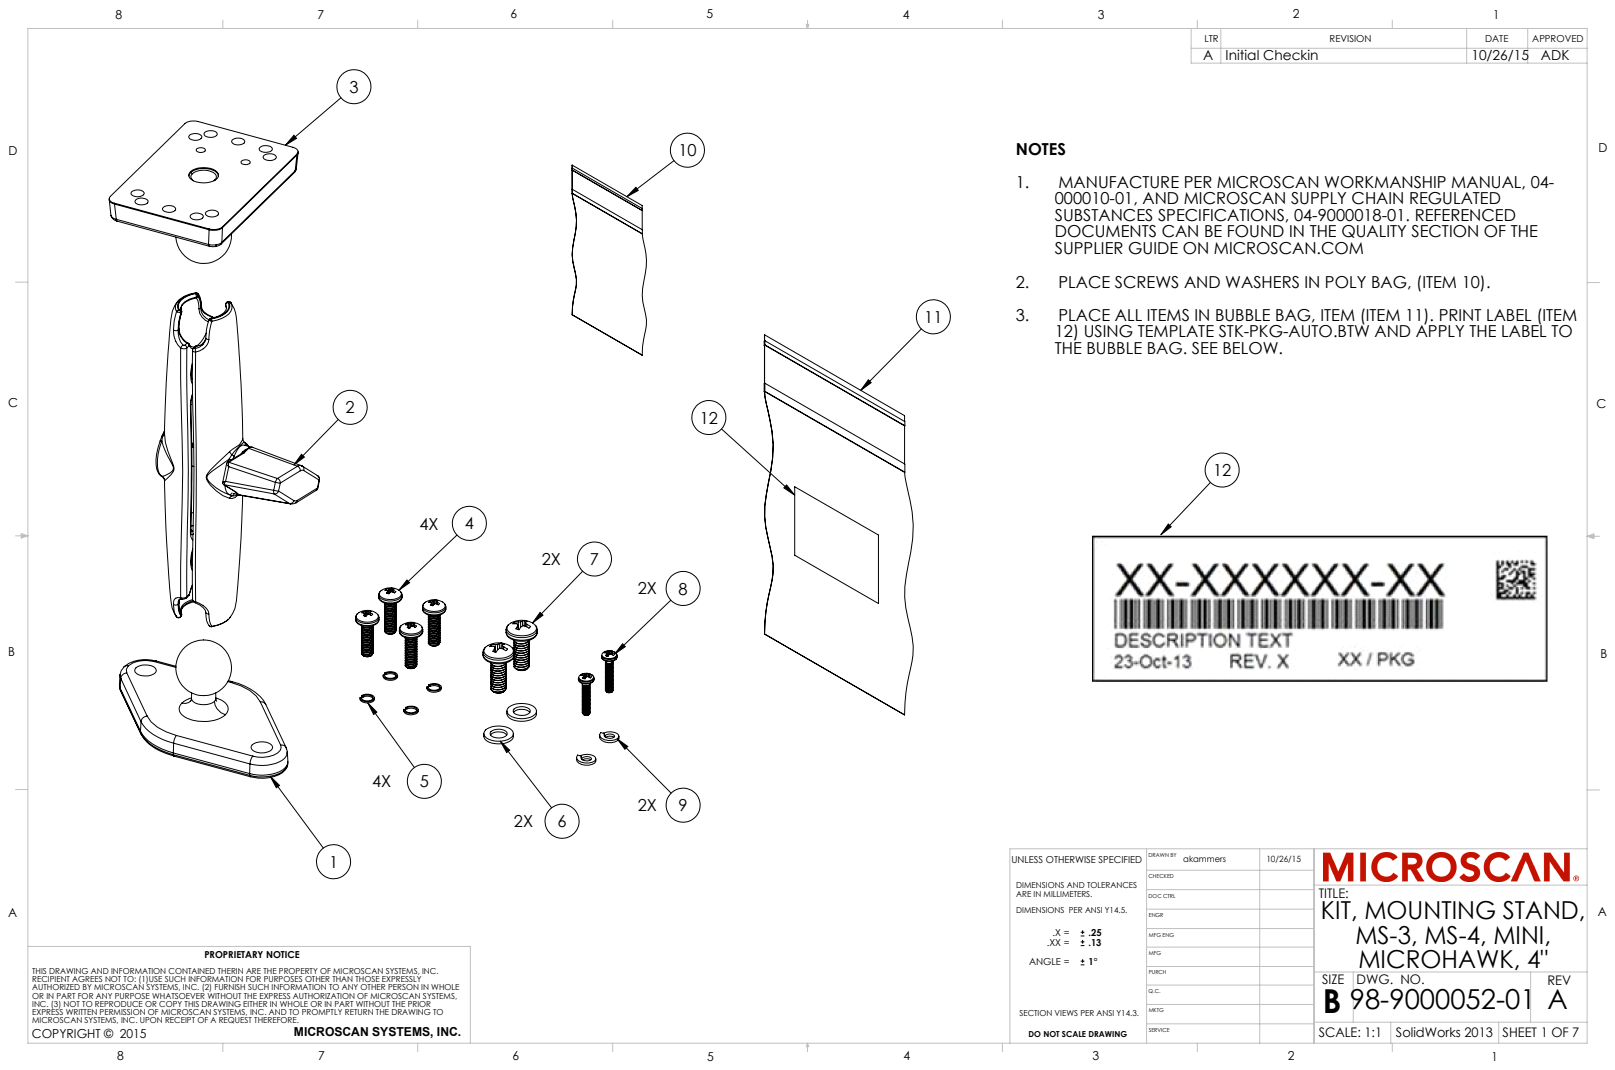
[picture p147: page 1]
DWG. NO.; REV; KIT, MOUNTING STAND, MS-3, MS-4, MINI, MICROHAWK, 4"; .XX = ANGLE =; COPYRIGHT © 2015; MICROSCAN SYSTEMS, INC.; SERVICE; PROPRIETARY NOTICE; DRAWN BY; DOC CTRL; MFG ENG; UNLESS OTHERWISE SPECIFIED; akammers; A Initial Checkin; 10/26/15 ADK

NOTES
1. MANUFACTURE PER MICROSCAN WORKMANSHIP MANUAL, 04-
000010-01, AND MICROSCAN SUPPLY CHAIN REGULATED
SUBSTANCES SPECIFICATIONS, 04-9000018-01. REFERENCED
DOCUMENTS CAN BE FOUND IN THE QUALITY SECTION OF THE
SUPPLIER GUIDE ON MICROSCAN.COM
2. PLACE SCREWS AND WASHERS IN POLY BAG, (ITEM 10).
3. PLACE ALL ITEMS IN BUBBLE BAG, ITEM (ITEM 11). PRINT LABEL (ITEM
12) USING TEMPLATE STK-PKG-AUTO.BTW AND APPLY THE LABEL TO
THE BUBBLE BAG. SEE BELOW.

DIMENSIONS AND TOLERANCES
ARE IN MILLIMETERS.
DIMENSIONS PER ANSI Y14.5.

THIS DRAWING AND INFORMATION CONTAINED THERIN ARE THE PROPERTY OF MICROSCAN SYSTEMS, INC.
RECIPIENT AGREES NOT TO: (1)USE SUCH INFORMATION FOR PURPOSES OTHER THAN THOSE EXPRESSLY
AUTHORIZED BY MICROSCAN SYSTEMS, INC. (2) FURNISH SUCH INFORMATION TO ANY OTHER PERSON IN WHOLE
OR IN PART FOR ANY PURPOSE WHATSOEVER WITHOUT THE EXPRESS AUTHORIZATION OF MICROSCAN SYSTEMS,
INC. (3) NOT TO REPRODUCE OR COPY THIS DRAWING EITHER IN WHOLE OR IN PART WITHOUT THE PRIOR
EXPRESS WRITTEN PERMISSION OF MICROSCAN SYSTEMS, INC. AND TO PROMPTLY RETURN THE DRAWING TO
MICROSCAN SYSTEMS, INC. UPON RECEIPT OF A REQUEST THEREFORE.

SECTION VIEWS PER ANSI Y14.3.
DO NOT SCALE DRAWING

SCALE: 1:1 SolidWorks 2013 SHEET 1 OF 7

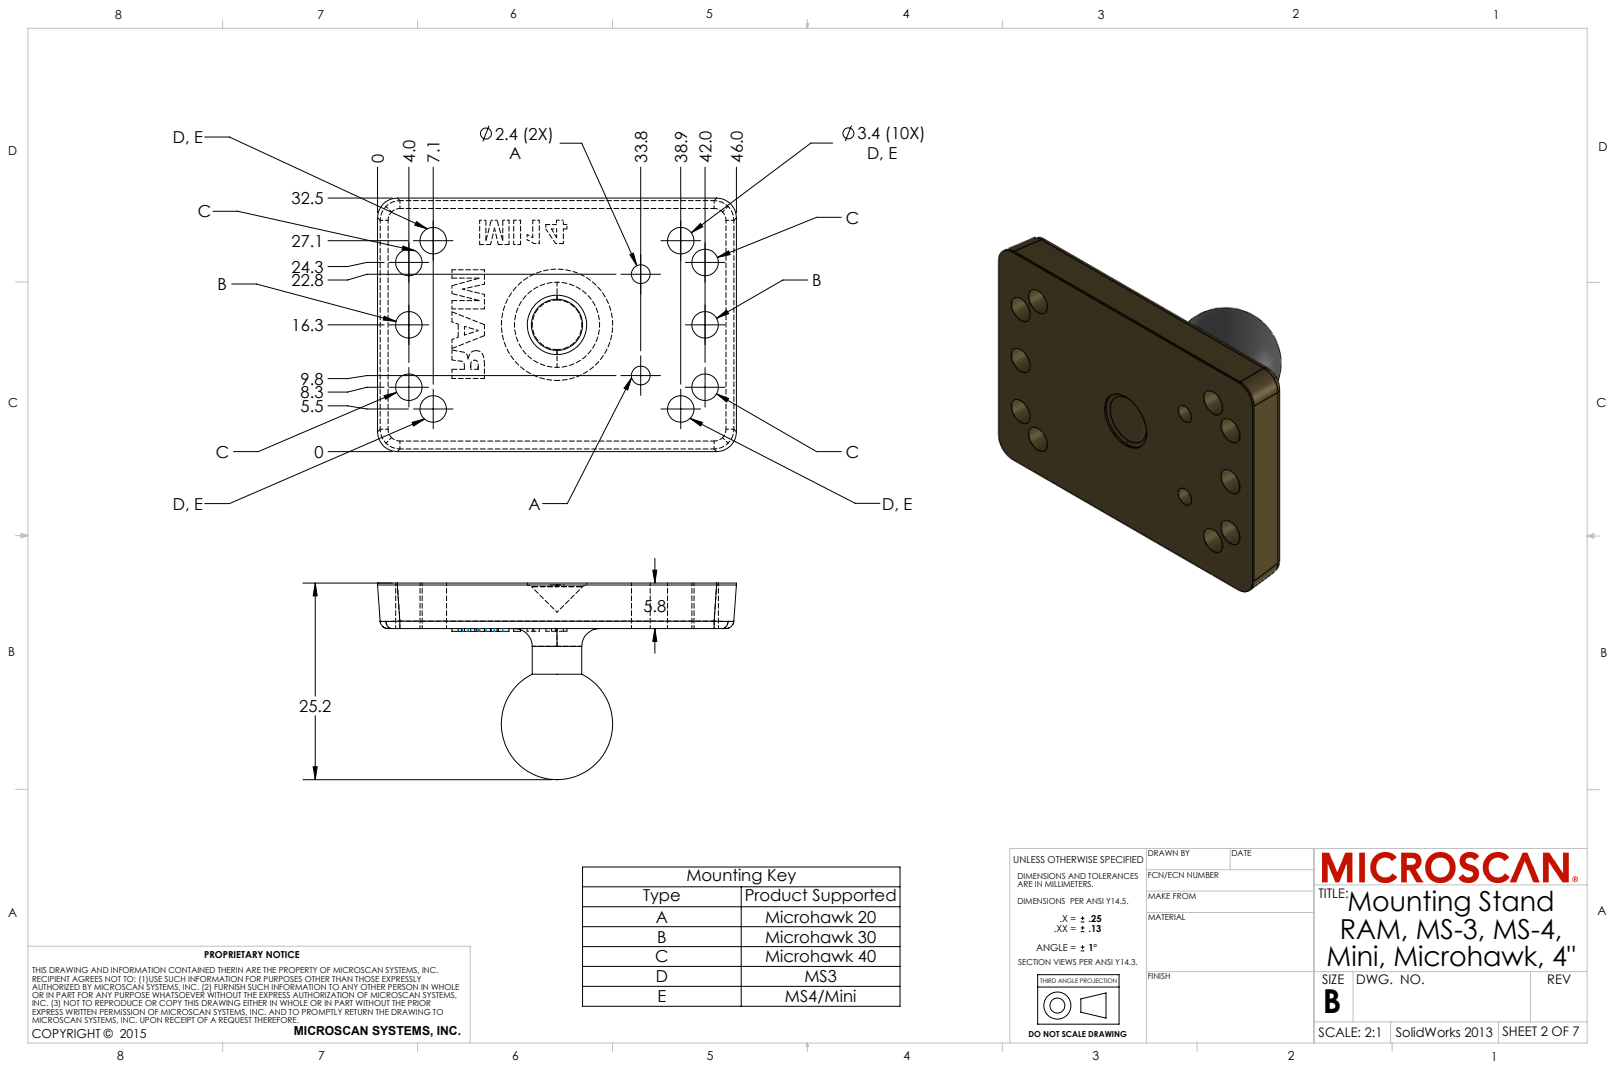
[picture p148: page 2]
Mounting Key; DWG. NO.; REV; SECTION VIEWS PER ANSI Y14.3.; Mini, Microhawk, 4"; .X = .XX = ANGLE =; COPYRIGHT © 2015; MICROSCAN SYSTEMS, INC.; PROPRIETARY NOTICE; DO NOT SCALE DRAWING; SCALE: 2:1 SolidWorks 2013 SHEET 2 OF 7; MAKE FROM; DRAWN BY; DATE

UNLESS OTHERWISE SPECIFIED
DIMENSIONS AND TOLERANCES
ARE IN MILLIMETERS.
DIMENSIONS PER ANSI Y14.5.

FCN/ECN NUMBER

Type | Product Supported
A | Microhawk 20
B | Microhawk 30
C | Microhawk 40
D | MS3
E | MS4/Mini

Mounting Stand
TITLE:
RAM, MS-3, MS-4,

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

THIRD ANGLE PROJECTION

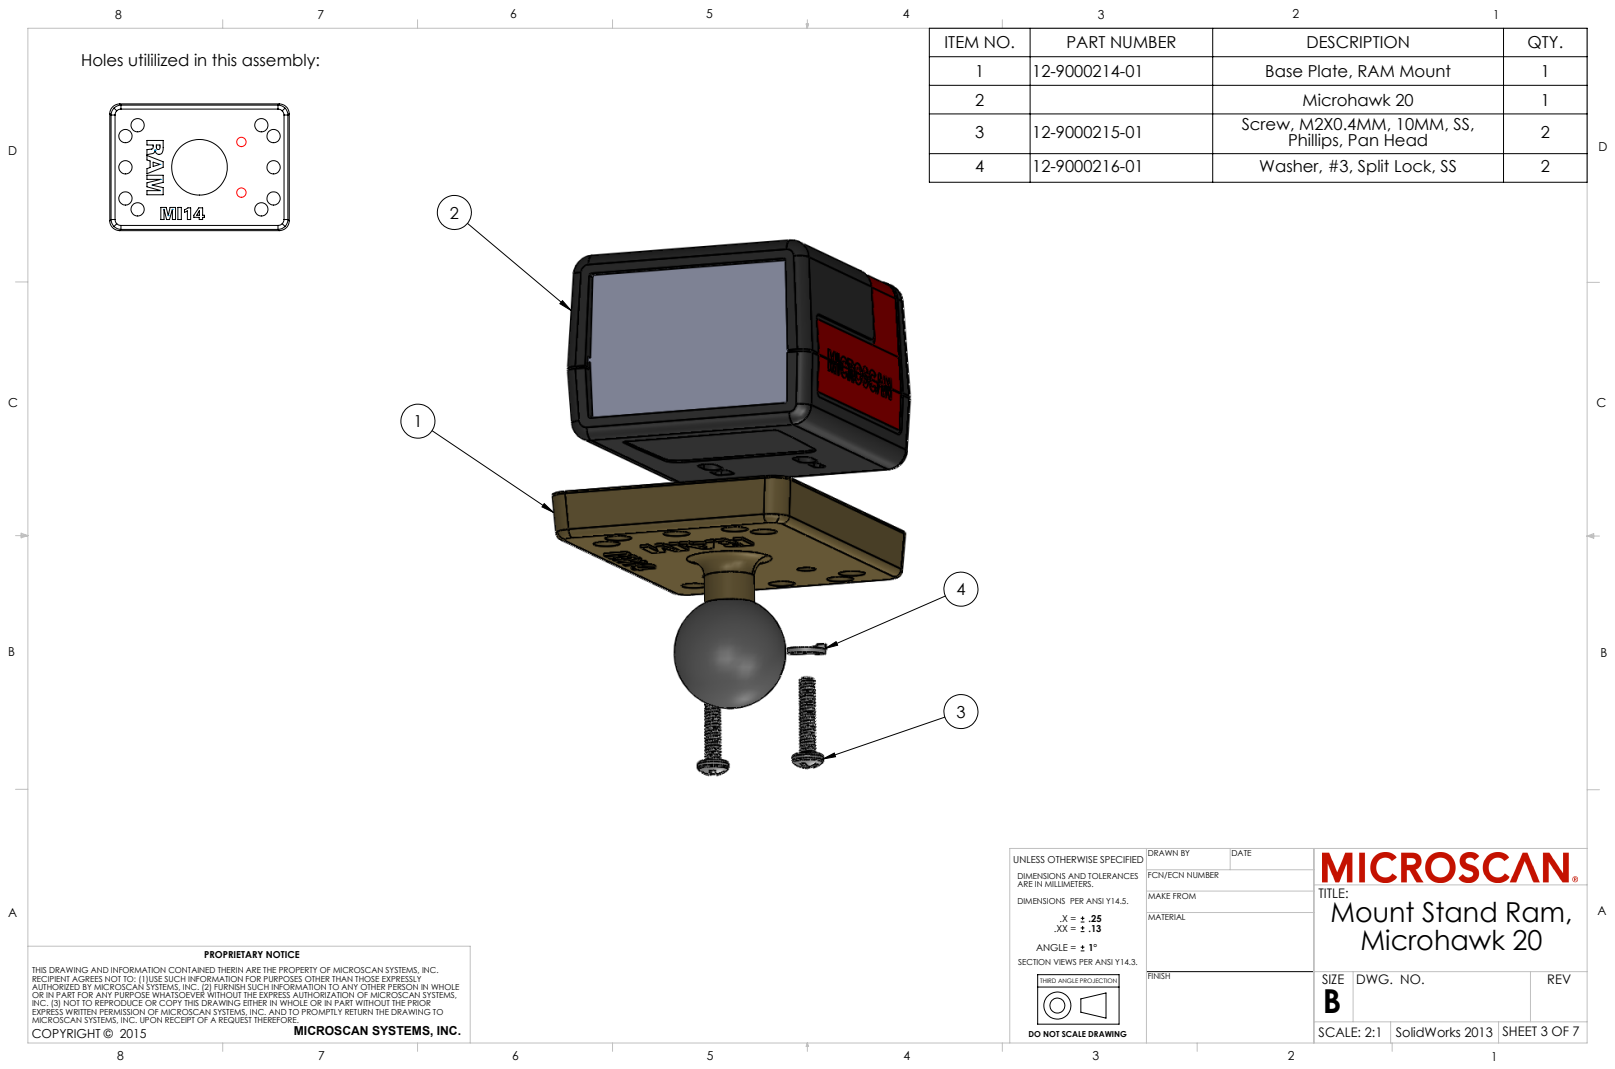
[picture p149: page 3]
DWG. NO.; REV; Mount Stand Ram, Microhawk 20; PROPRIETARY NOTICE; DO NOT SCALE DRAWING; SCALE: 2:1 SolidWorks 2013 SHEET 3 OF 7; MAKE FROM; DRAWN BY; DATE

ITEM NO. | PART NUMBER | DESCRIPTION | QTY.
1 | 12-9000214-01 | Base Plate, RAM Mount | 1
2 | | Microhawk 20 | 1
3 | 12-9000215-01 | Screw, M2X0.4MM, 10MM, SS, Phillips, Pan Head | 2
4 | 12-9000216-01 | Washer, #3, Split Lock, SS | 2

Holes utililized in this assembly:

UNLESS OTHERWISE SPECIFIED
DIMENSIONS AND TOLERANCES
ARE IN MILLIMETERS.
DIMENSIONS PER ANSI Y14.5.

FCN/ECN NUMBER

ANGLE =
SECTION VIEWS PER ANSI Y14.3.

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

THIRD ANGLE PROJECTION

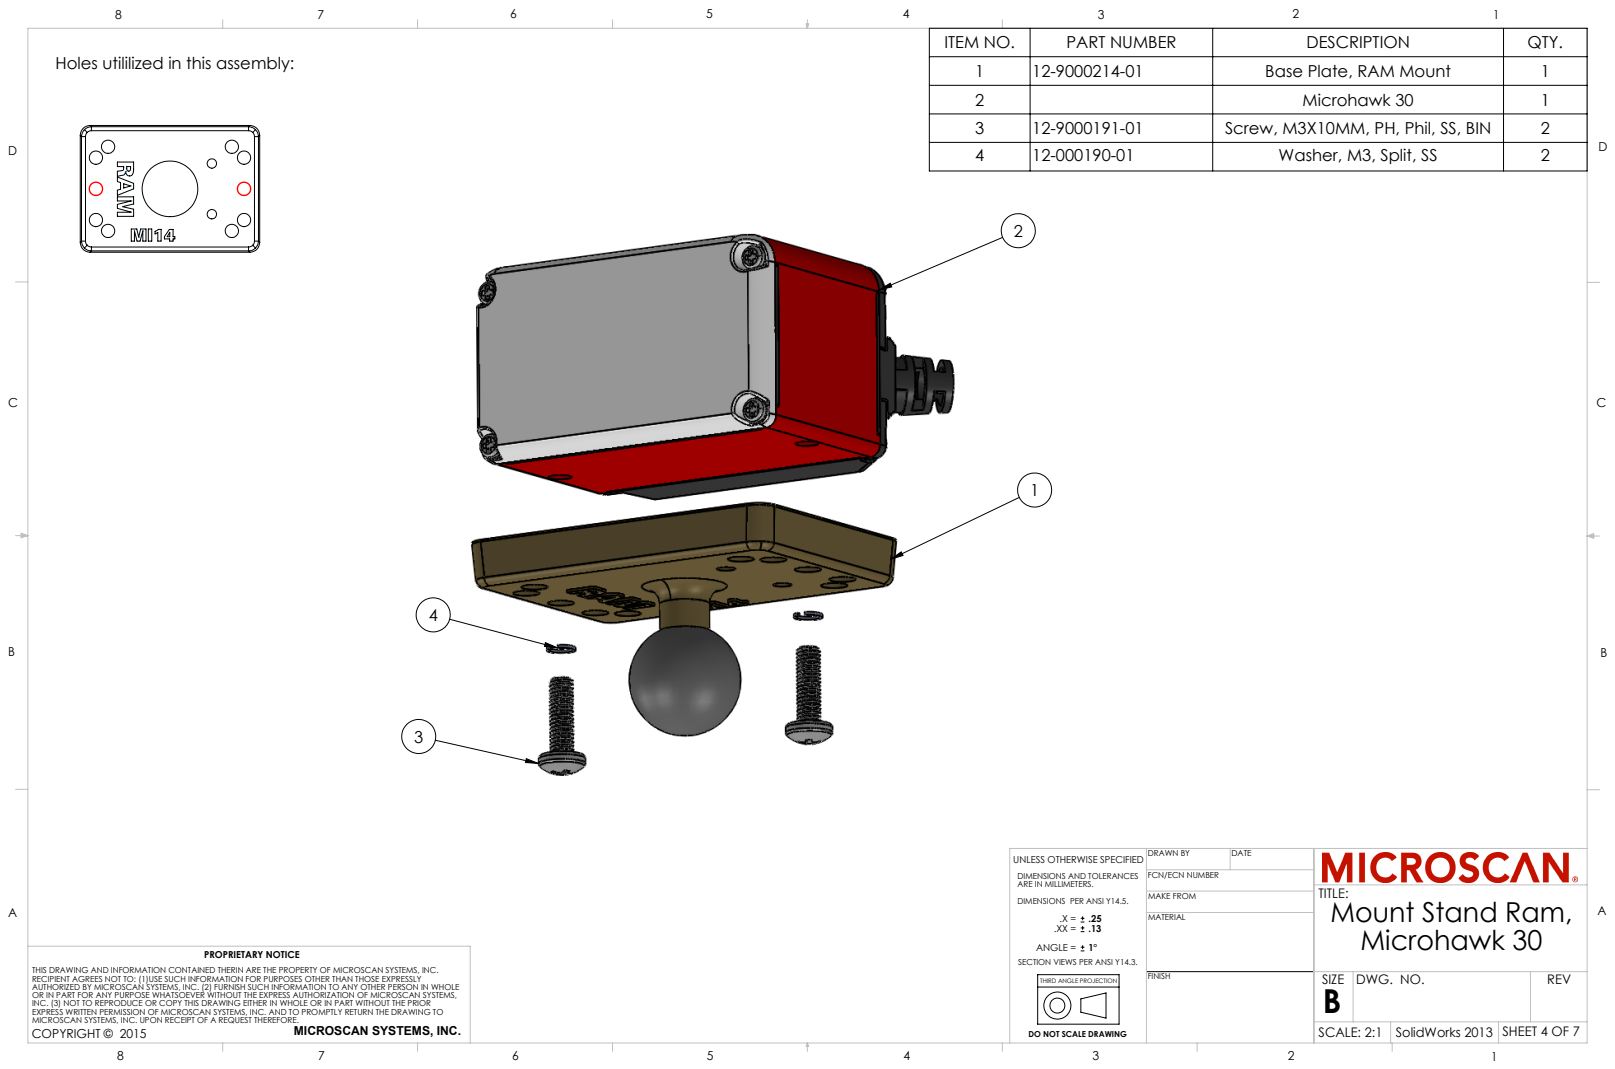
[picture p150: page 4]
Washer, M3, Split, SS; DWG. NO.; REV; Mount Stand Ram, Microhawk 30; PROPRIETARY NOTICE; DO NOT SCALE DRAWING; SCALE: 2:1 SolidWorks 2013 SHEET 4 OF 7; MAKE FROM; DRAWN BY; DATE

2 | | Microhawk 30 | 1
3 | 12-9000191-01 | Screw, M3X10MM, PH, Phil, SS, BIN | 2

UNLESS OTHERWISE SPECIFIED
DIMENSIONS AND TOLERANCES
ARE IN MILLIMETERS.
DIMENSIONS PER ANSI Y14.5.

FCN/ECN NUMBER

ANGLE =
SECTION VIEWS PER ANSI Y14.3.

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

THIRD ANGLE PROJECTION

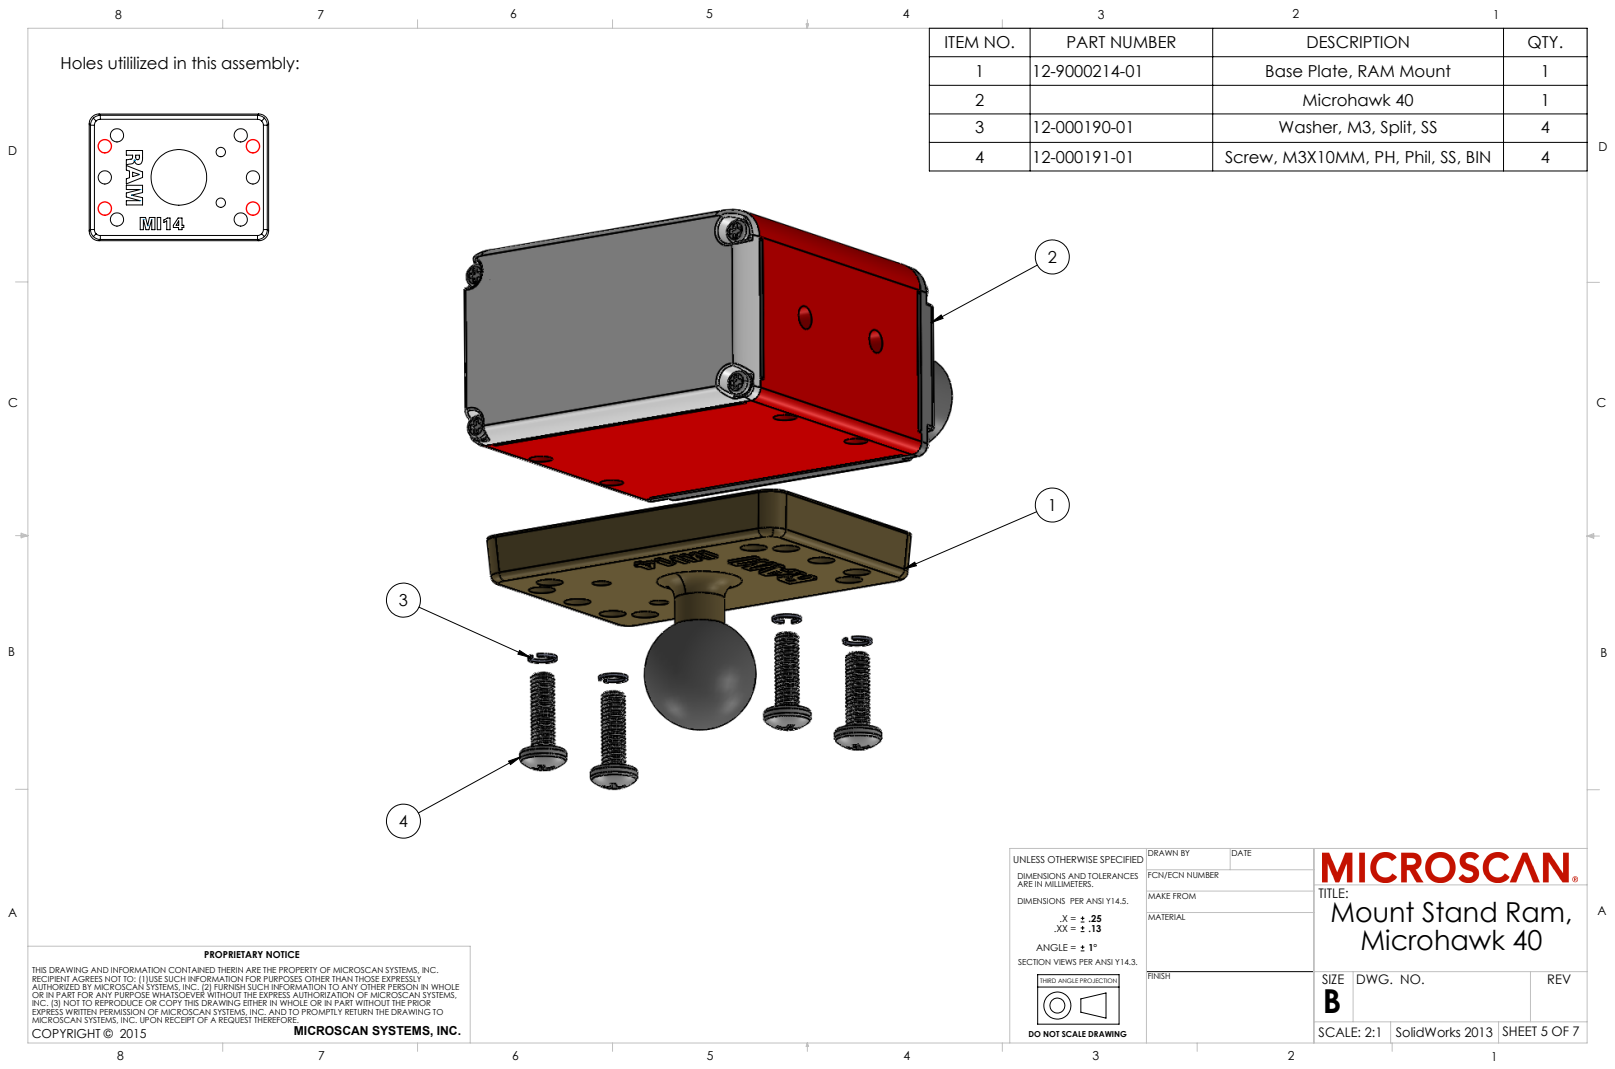
[picture p151: page 5]
Screw, M3X10MM, PH, Phil, SS, BIN; DWG. NO.; REV; Mount Stand Ram, Microhawk 40; PROPRIETARY NOTICE; DO NOT SCALE DRAWING; SCALE: 2:1 SolidWorks 2013 SHEET 5 OF 7; MAKE FROM; DRAWN BY; DATE

2 | | Microhawk 40 | 1
3 | 12-000190-01 | Washer, M3, Split, SS | 4

UNLESS OTHERWISE SPECIFIED
DIMENSIONS AND TOLERANCES
ARE IN MILLIMETERS.
DIMENSIONS PER ANSI Y14.5.

FCN/ECN NUMBER

ANGLE =
SECTION VIEWS PER ANSI Y14.3.

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

THIRD ANGLE PROJECTION

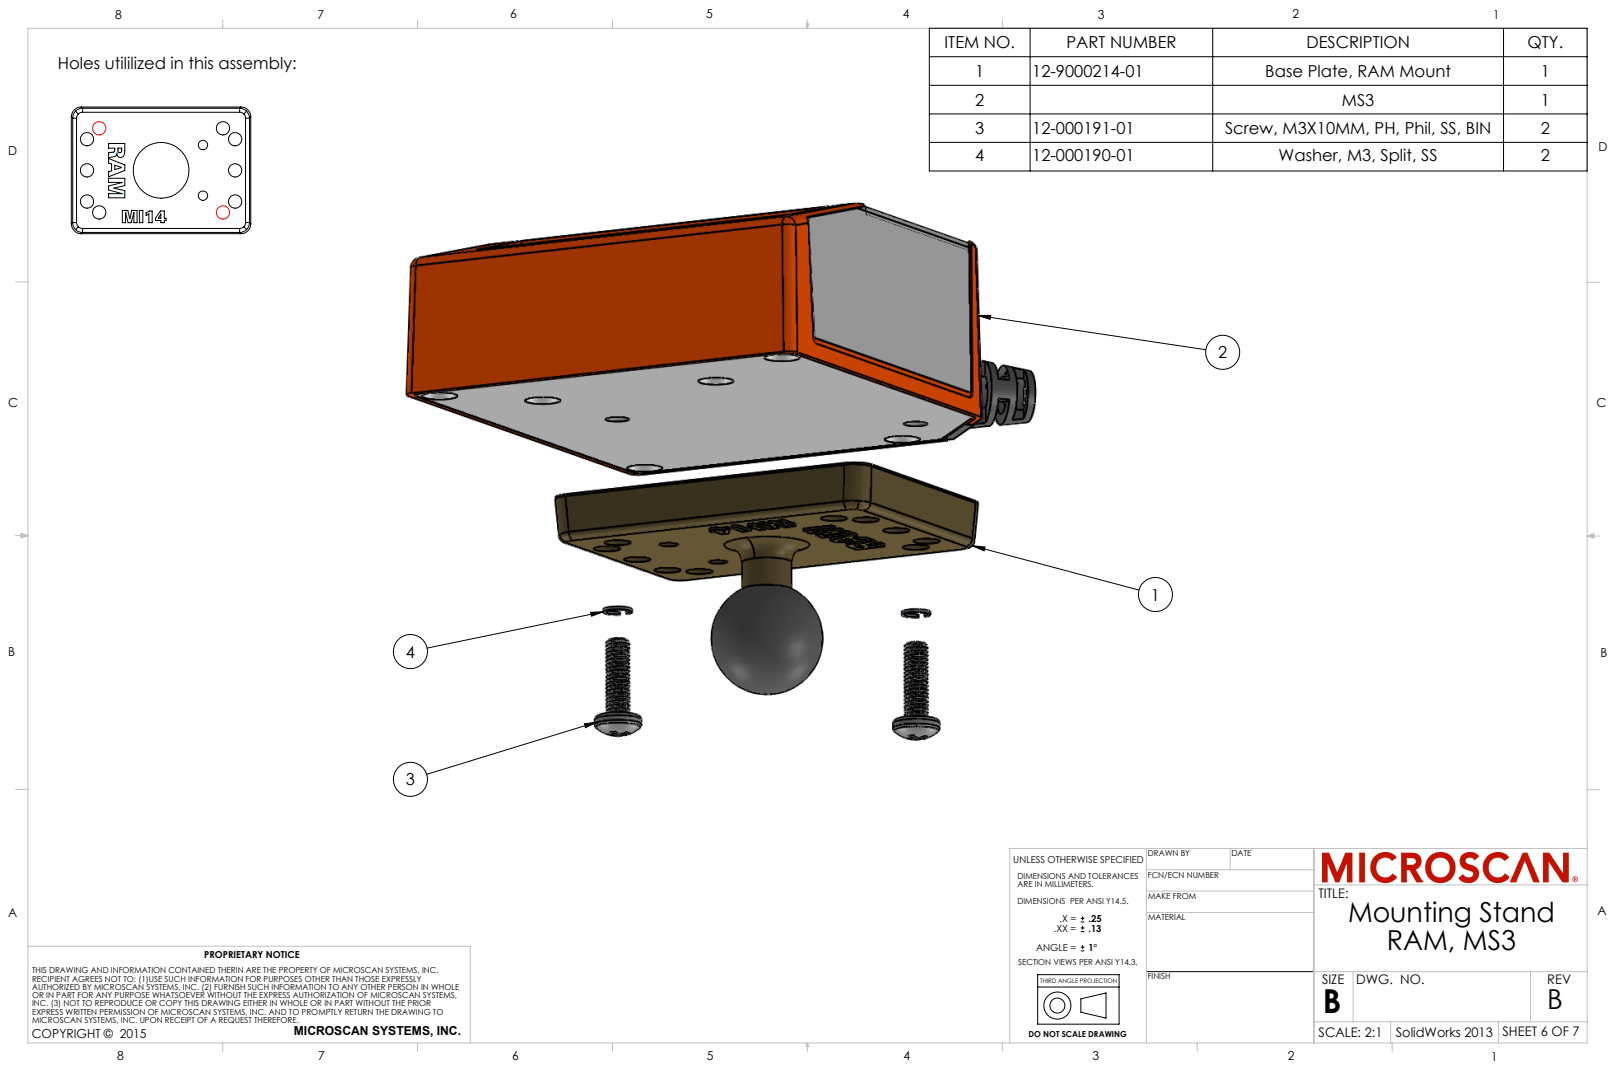
[picture p152: page 6]
Washer, M3, Split, SS; DWG. NO.; REV; Mounting Stand RAM, MS3; PROPRIETARY NOTICE; DO NOT SCALE DRAWING; SCALE: 2:1 SolidWorks 2013 SHEET 6 OF 7; MAKE FROM; DRAWN BY; DATE

2 | | MS3 | 1
3 | 12-000191-01 | Screw, M3X10MM, PH, Phil, SS, BIN | 2

UNLESS OTHERWISE SPECIFIED
DIMENSIONS AND TOLERANCES
ARE IN MILLIMETERS.
DIMENSIONS PER ANSI Y14.5.

FCN/ECN NUMBER

ANGLE =
SECTION VIEWS PER ANSI Y14.3.

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

THIRD ANGLE PROJECTION

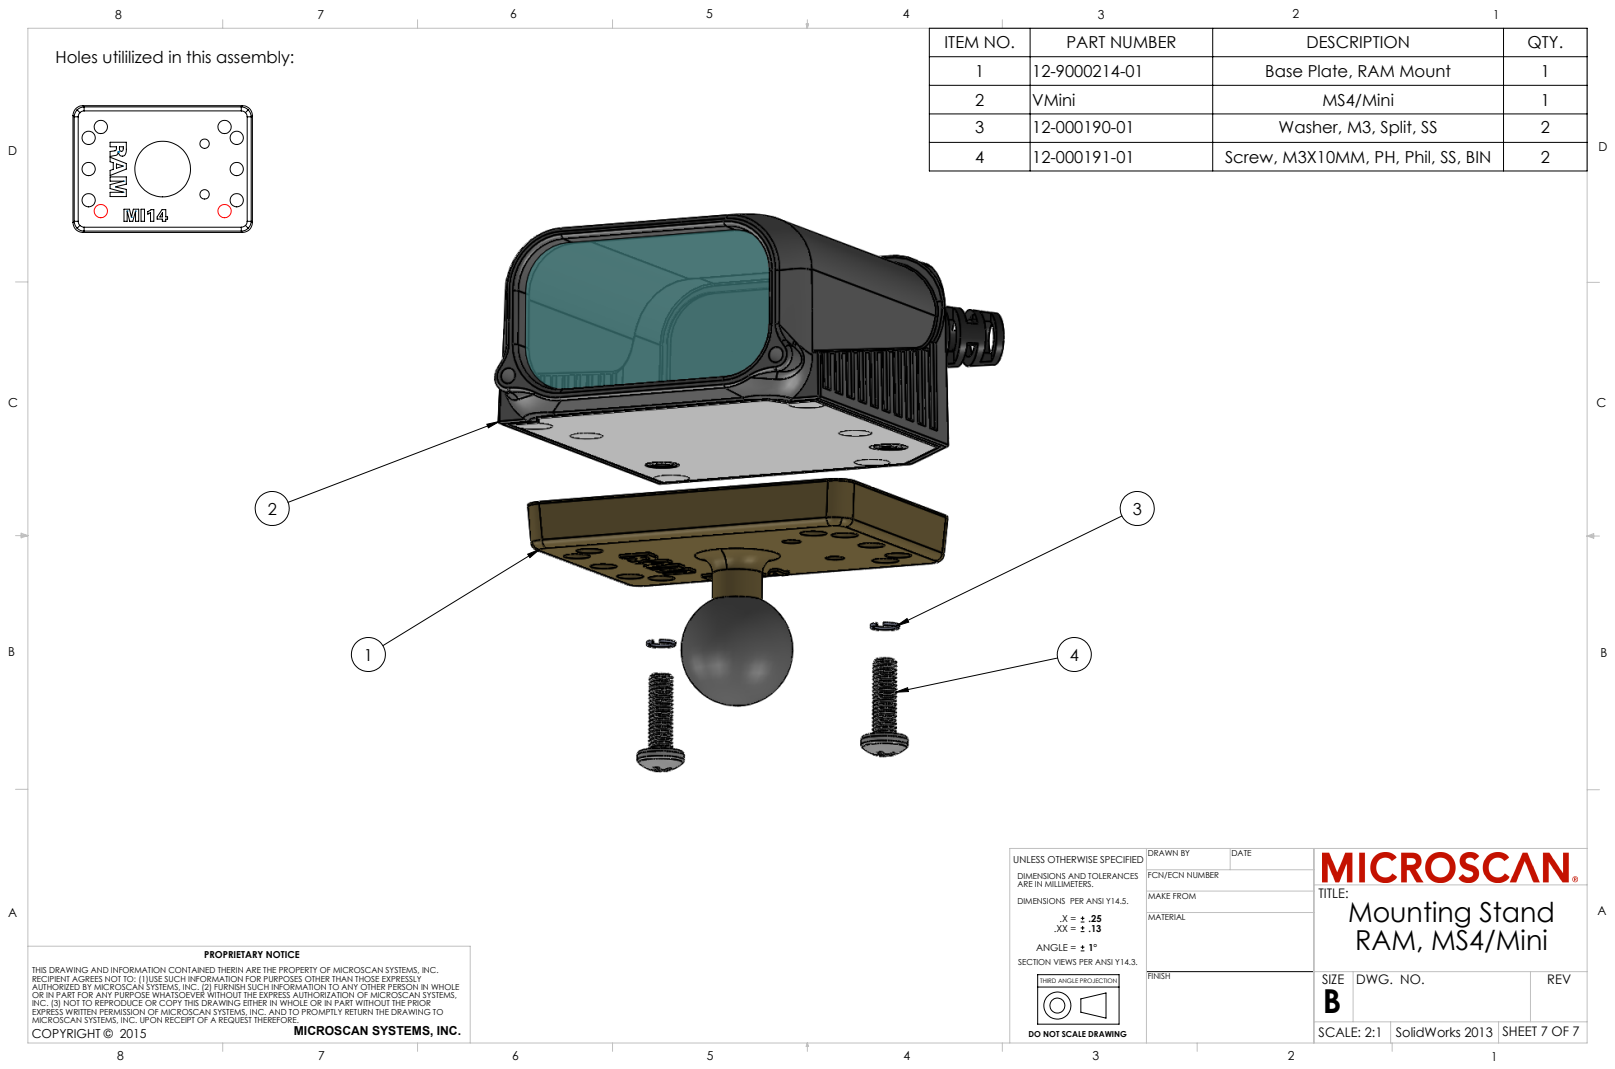
[picture p153: page 7]
Screw, M3X10MM, PH, Phil, SS, BIN; DWG. NO.; REV; Mounting Stand RAM, MS4/Mini; PROPRIETARY NOTICE; DO NOT SCALE DRAWING; SCALE: 2:1 SolidWorks 2013 SHEET 7 OF 7; MAKE FROM; DRAWN BY; DATE

2 | VMini | MS4/Mini | 1
3 | 12-000190-01 | Washer, M3, Split, SS | 2

UNLESS OTHERWISE SPECIFIED
DIMENSIONS AND TOLERANCES
ARE IN MILLIMETERS.
DIMENSIONS PER ANSI Y14.5.

FCN/ECN NUMBER

ANGLE =
SECTION VIEWS PER ANSI Y14.3.

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

THIRD ANGLE PROJECTION
