huan95nd/BAI_TAP_PHAN_MEM/BAI_TAP_SOLIDWORKS/AN_HONG/MV40MicroHAWK_Drawings/PDF/98-9000054-01Ext.PDF

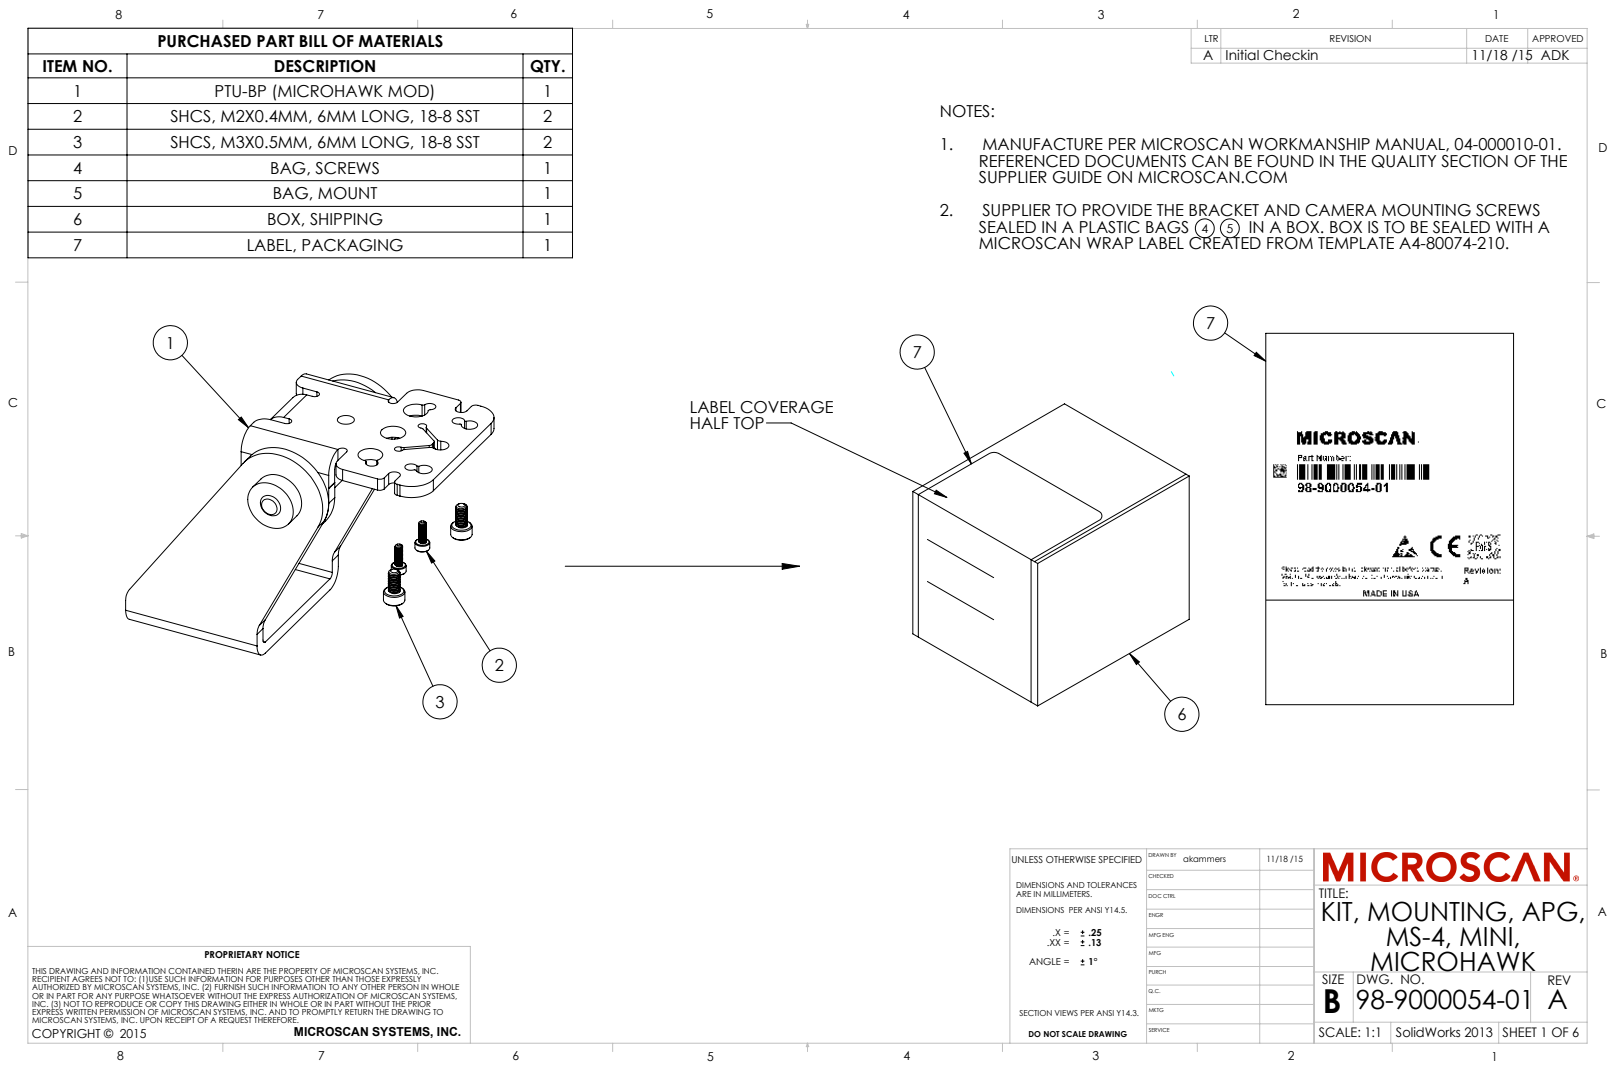
[picture p161: page 1]
LABEL COVERAGE HALF TOP; DWG. NO.; REV; KIT, MOUNTING, APG, MS-4, MINI,; .XX = ANGLE =; COPYRIGHT © 2015; MICROSCAN SYSTEMS, INC.; SERVICE; PROPRIETARY NOTICE; DRAWN BY; DOC CTRL; MFG ENG; UNLESS OTHERWISE SPECIFIED; akammers; A Initial Checkin; 11/18 /15 ADK

PURCHASED PART BILL OF MATERIALS

ITEM NO. | DESCRIPTION | QTY.
1 | PTU-BP (MICROHAWK MOD) | 1
2 | SHCS, M2X0.4MM, 6MM LONG, 18-8 SST | 2
3 | SHCS, M3X0.5MM, 6MM LONG, 18-8 SST | 2
4 | BAG, SCREWS | 1
5 | BAG, MOUNT | 1
6 | BOX, SHIPPING | 1
7 | LABEL, PACKAGING | 1

NOTES:
1. MANUFACTURE PER MICROSCAN WORKMANSHIP MANUAL, 04-000010-01.
REFERENCED DOCUMENTS CAN BE FOUND IN THE QUALITY SECTION OF THE
SUPPLIER GUIDE ON MICROSCAN.COM
2. SUPPLIER TO PROVIDE THE BRACKET AND CAMERA MOUNTING SCREWS
SEALED IN A PLASTIC BAGS 4 5 IN A BOX. BOX IS TO BE SEALED WITH A
MICROSCAN WRAP LABEL CREATED FROM TEMPLATE A4-80074-210.

DIMENSIONS AND TOLERANCES
ARE IN MILLIMETERS.
DIMENSIONS PER ANSI Y14.5.

THIS DRAWING AND INFORMATION CONTAINED THERIN ARE THE PROPERTY OF MICROSCAN SYSTEMS, INC.
RECIPIENT AGREES NOT TO: (1)USE SUCH INFORMATION FOR PURPOSES OTHER THAN THOSE EXPRESSLY
AUTHORIZED BY MICROSCAN SYSTEMS, INC. (2) FURNISH SUCH INFORMATION TO ANY OTHER PERSON IN WHOLE
OR IN PART FOR ANY PURPOSE WHATSOEVER WITHOUT THE EXPRESS AUTHORIZATION OF MICROSCAN SYSTEMS,
INC. (3) NOT TO REPRODUCE OR COPY THIS DRAWING EITHER IN WHOLE OR IN PART WITHOUT THE PRIOR
EXPRESS WRITTEN PERMISSION OF MICROSCAN SYSTEMS, INC. AND TO PROMPTLY RETURN THE DRAWING TO
MICROSCAN SYSTEMS, INC. UPON RECEIPT OF A REQUEST THEREFORE.

SECTION VIEWS PER ANSI Y14.3.
DO NOT SCALE DRAWING

SCALE: 1:1 SolidWorks 2013 SHEET 1 OF 6

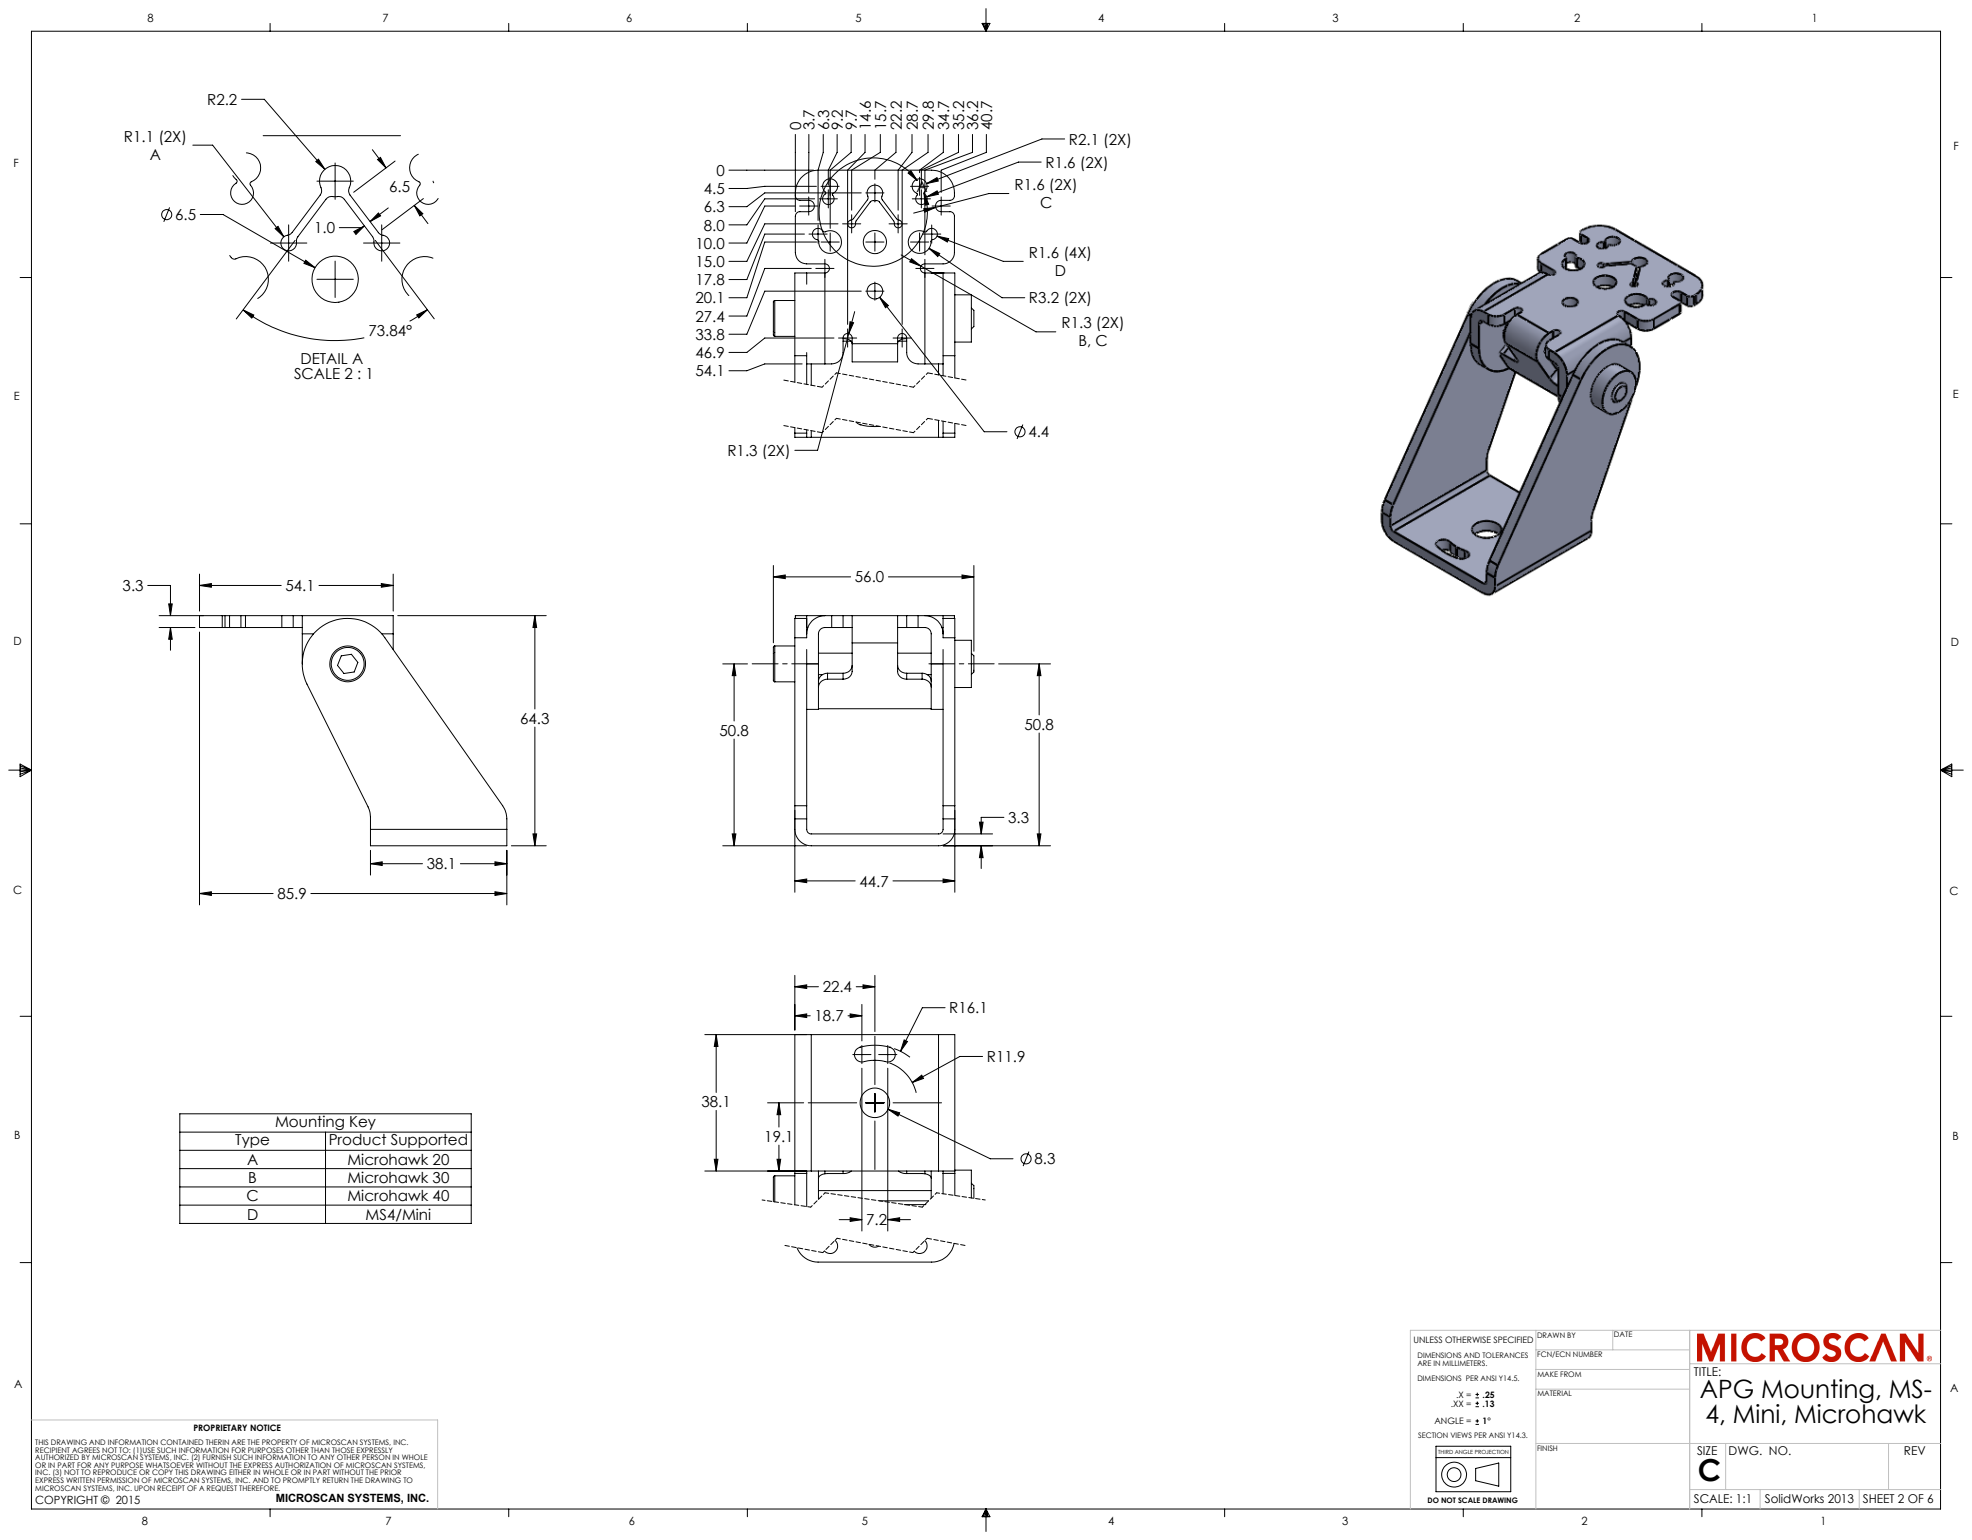
[picture p162: page 2]
DETAIL A SCALE 2 : 1; Mounting Key; DWG. NO.; REV; COPYRIGHT © 2015; MICROSCAN SYSTEMS, INC.; PROPRIETARY NOTICE; DO NOT SCALE DRAWING; SCALE: 1:1; SolidWorks 2013; SHEET 2 OF 6; MAKE FROM; DRAWN BY; DATE

Type | Product Supported
A | Microhawk 20
B | Microhawk 30
C | Microhawk 40
D | MS4/Mini

UNLESS OTHERWISE SPECIFIED
DIMENSIONS AND TOLERANCES
ARE IN MILLIMETERS.
DIMENSIONS PER ANSI Y14.5.

FCN/ECN NUMBER

TITLE:
APG Mounting, MS-
4, Mini, Microhawk

ANGLE =
SECTION VIEWS PER ANSI Y14.3.

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

THIRD ANGLE PROJECTION

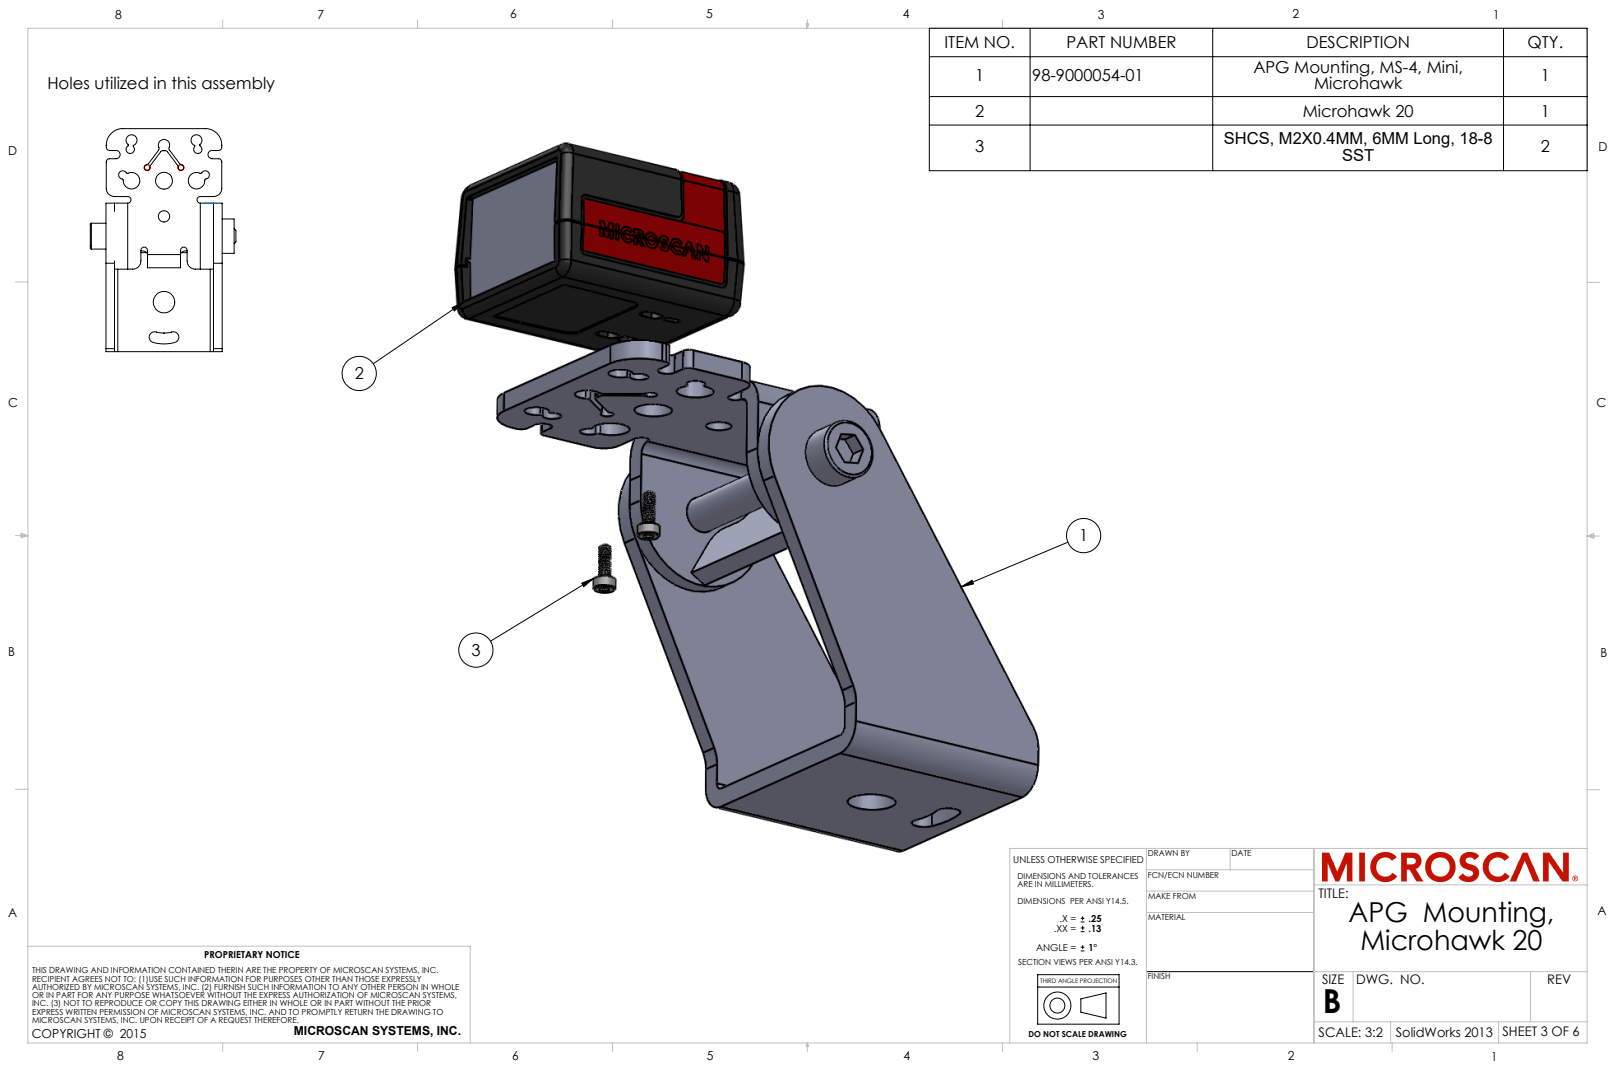
[picture p163: page 3]
DWG. NO.; REV; APG Mounting, Microhawk 20; PROPRIETARY NOTICE; DO NOT SCALE DRAWING; SCALE: 3:2 SolidWorks 2013 SHEET 3 OF 6; MAKE FROM; DRAWN BY; DATE

ITEM NO. | PART NUMBER | DESCRIPTION | QTY.
1 | 98-9000054-01 | APG Mounting, MS-4, Mini, Microhawk | 1

Holes utilized in this assembly

2 | | Microhawk 20 | 1
3 | | SHCS, M2X0.4MM, 6MM Long, 18-8

UNLESS OTHERWISE SPECIFIED
DIMENSIONS AND TOLERANCES
ARE IN MILLIMETERS.
DIMENSIONS PER ANSI Y14.5.

FCN/ECN NUMBER

ANGLE =
SECTION VIEWS PER ANSI Y14.3.

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

THIRD ANGLE PROJECTION

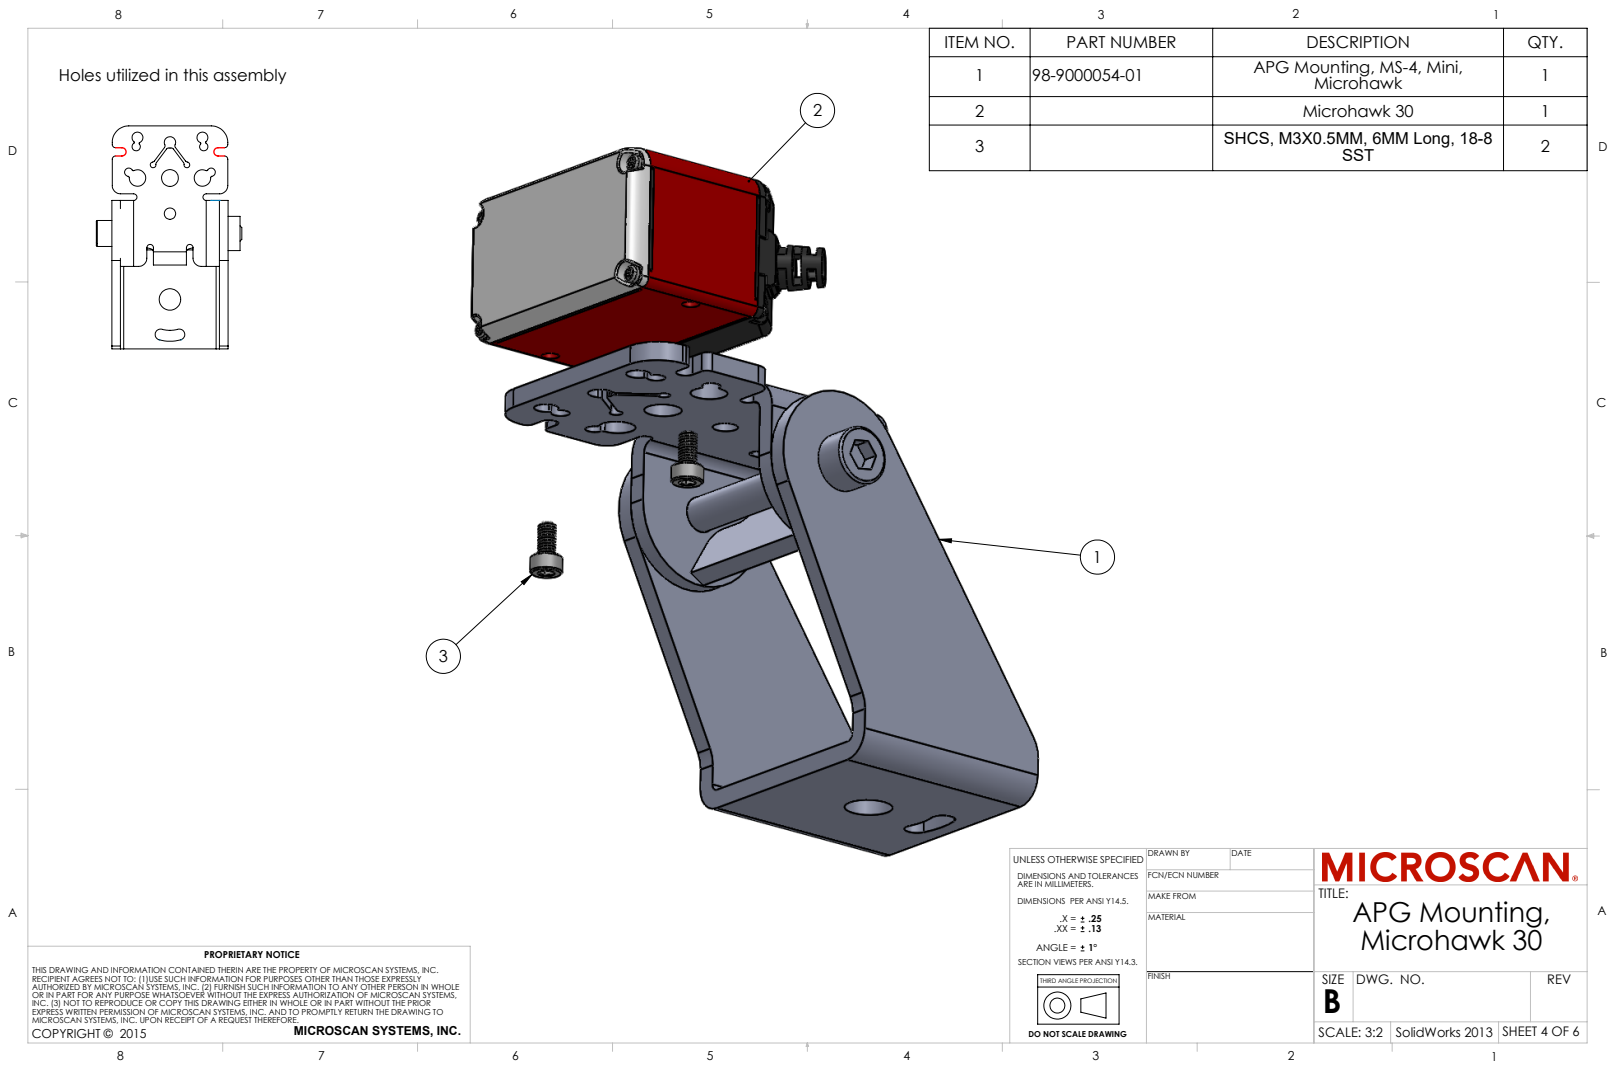
[picture p164: page 4]
DWG. NO.; REV; APG Mounting, Microhawk 30; PROPRIETARY NOTICE; DO NOT SCALE DRAWING; SCALE: 3:2 SolidWorks 2013 SHEET 4 OF 6; MAKE FROM; DRAWN BY; DATE

Holes utilized in this assembly

Microhawk | 1

2 | Microhawk 30 | 1
3 | SHCS, M3X0.5MM, 6MM Long, 18-8

UNLESS OTHERWISE SPECIFIED
DIMENSIONS AND TOLERANCES
ARE IN MILLIMETERS.
DIMENSIONS PER ANSI Y14.5.

FCN/ECN NUMBER

ANGLE =
SECTION VIEWS PER ANSI Y14.3.

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

THIRD ANGLE PROJECTION

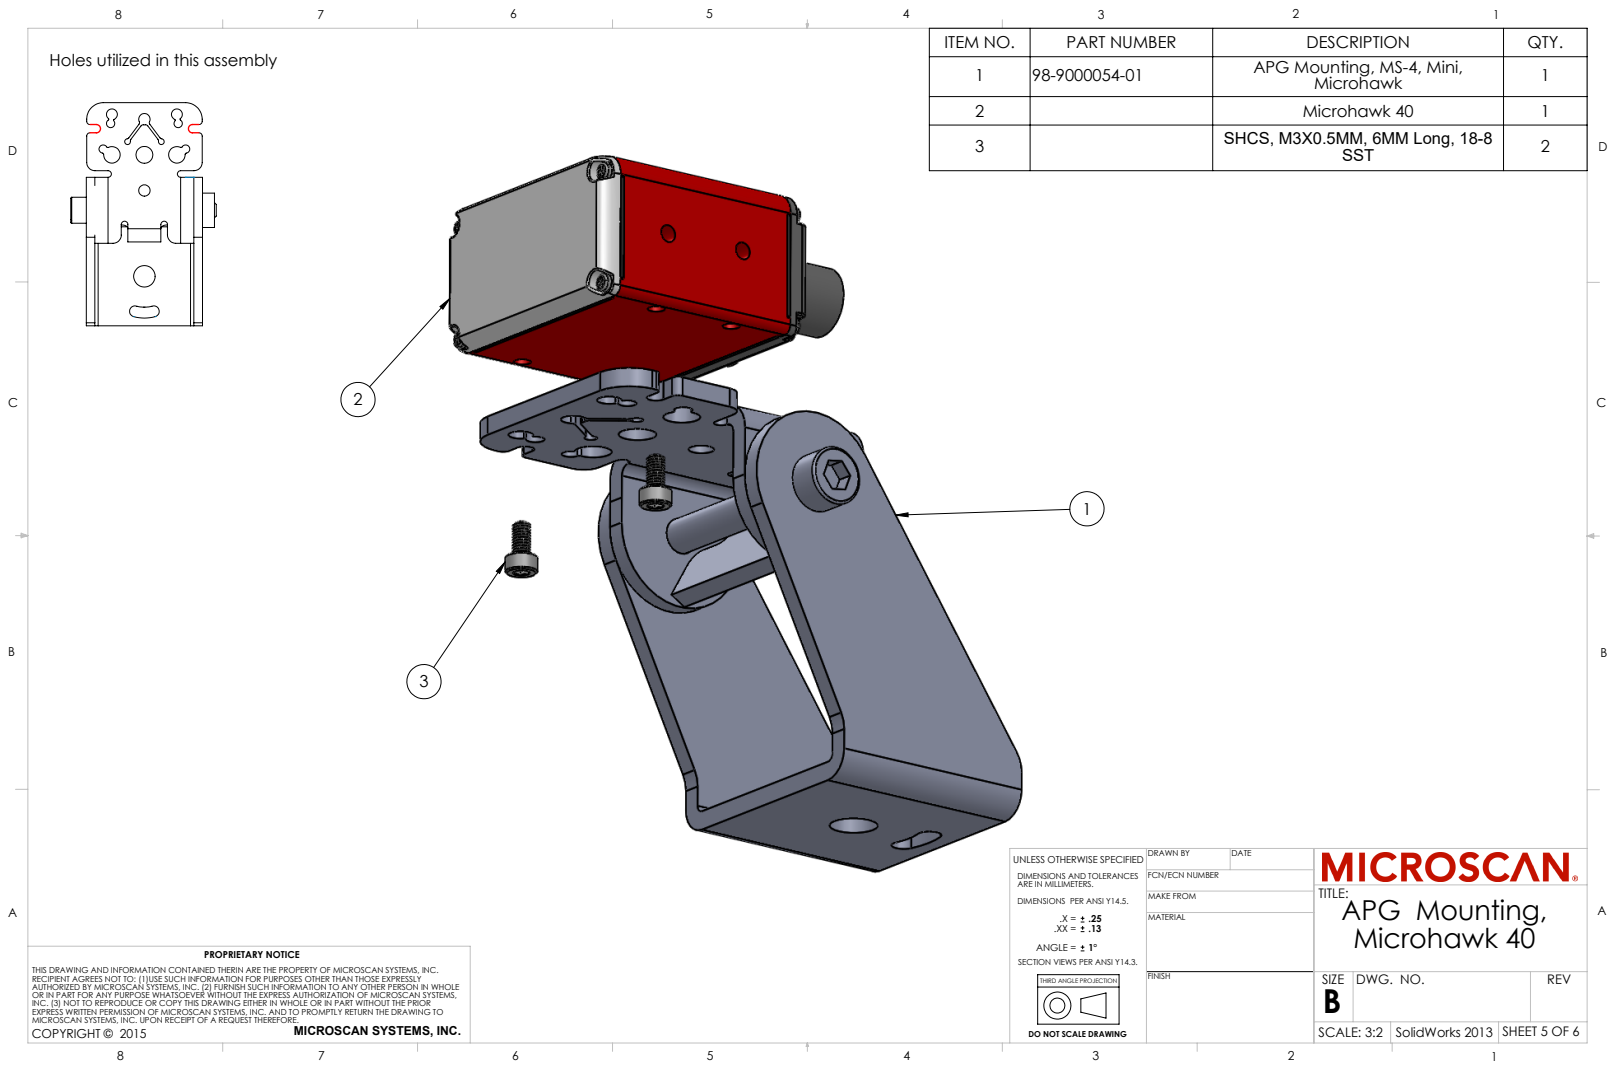
[picture p165: page 5]
DWG. NO.; REV; APG Mounting, Microhawk 40; PROPRIETARY NOTICE; DO NOT SCALE DRAWING; SCALE: 3:2 SolidWorks 2013 SHEET 5 OF 6; MAKE FROM; DRAWN BY; DATE

Microhawk | 1

2 | Microhawk 40 | 1
3 | SHCS, M3X0.5MM, 6MM Long, 18-8

UNLESS OTHERWISE SPECIFIED
DIMENSIONS AND TOLERANCES
ARE IN MILLIMETERS.
DIMENSIONS PER ANSI Y14.5.

FCN/ECN NUMBER

ANGLE =
SECTION VIEWS PER ANSI Y14.3.

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

THIRD ANGLE PROJECTION

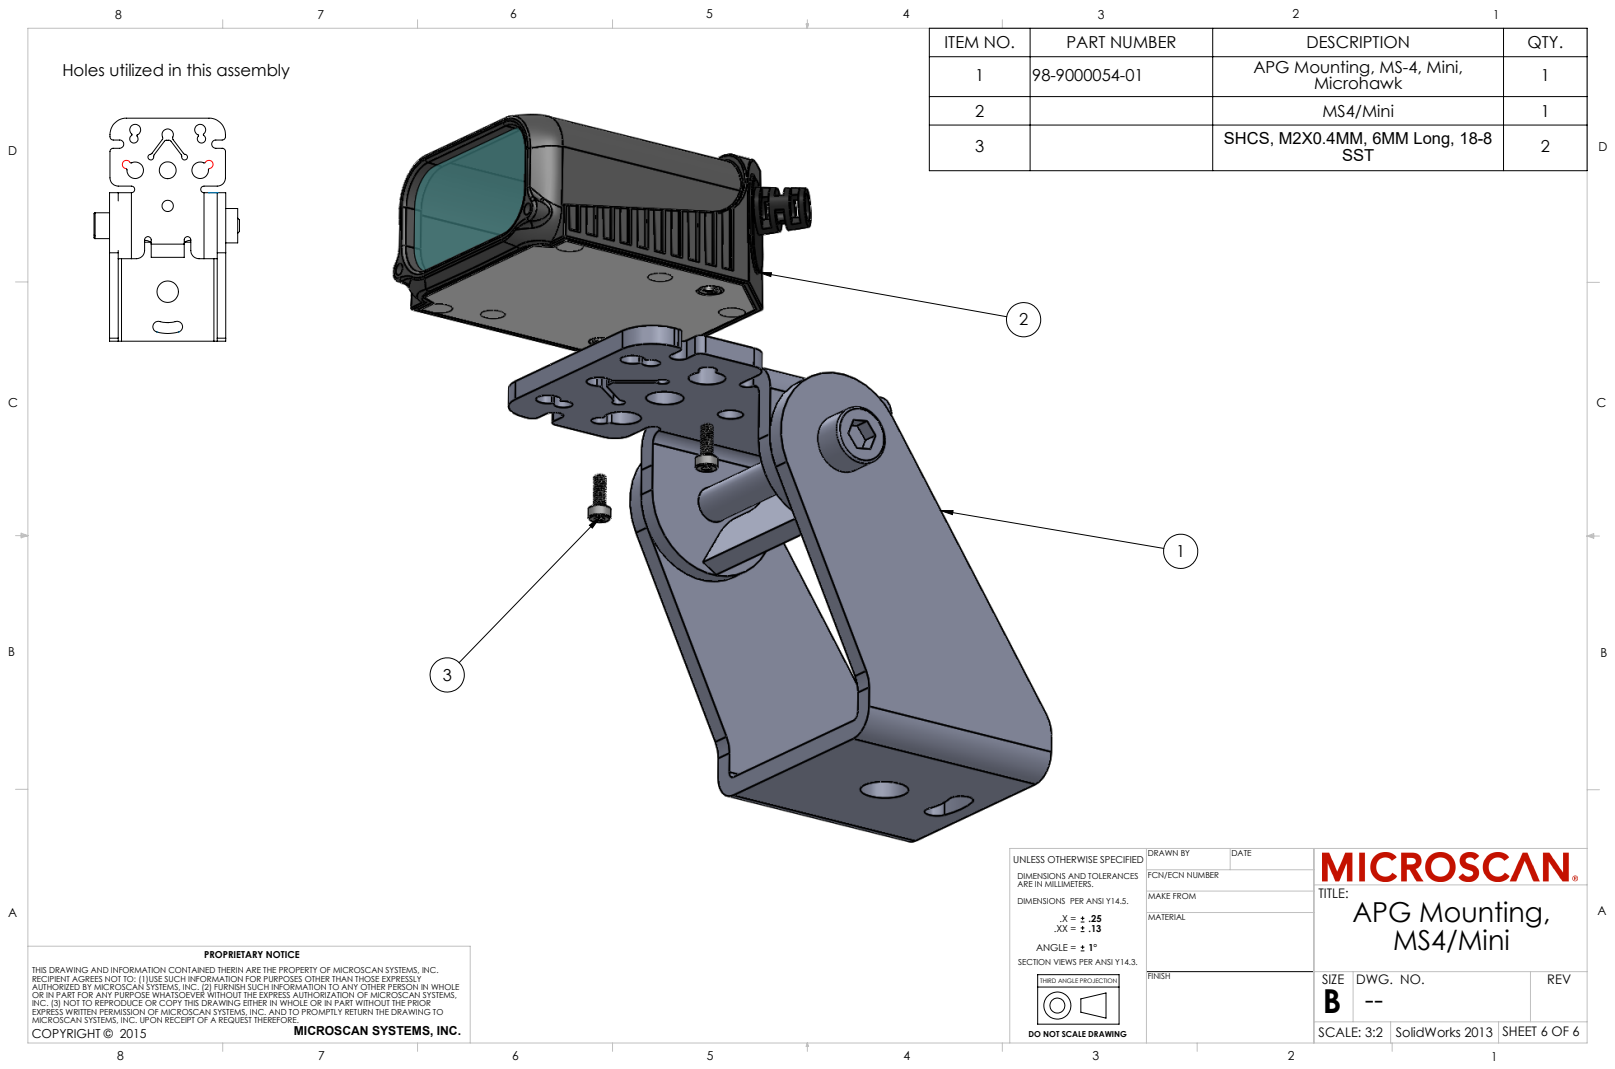
[picture p166: page 6]
DWG. NO.; REV; APG Mounting,; PROPRIETARY NOTICE; DO NOT SCALE DRAWING; SCALE: 3:2 SolidWorks 2013 SHEET 6 OF 6; MAKE FROM; DRAWN BY; DATE

Microhawk | 1

2 | MS4/Mini | 1
3 | SHCS, M2X0.4MM, 6MM Long, 18-8

UNLESS OTHERWISE SPECIFIED
DIMENSIONS AND TOLERANCES
ARE IN MILLIMETERS.
DIMENSIONS PER ANSI Y14.5.

FCN/ECN NUMBER

ANGLE =
SECTION VIEWS PER ANSI Y14.3.

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

THIRD ANGLE PROJECTION
