huan95nd/BAI_TAP_PHAN_MEM/BAI_TAP_SOLIDWORKS/AN_HONG/MV40MicroHAWK_Drawings/PDF/98-9000057-01Ext.PDF

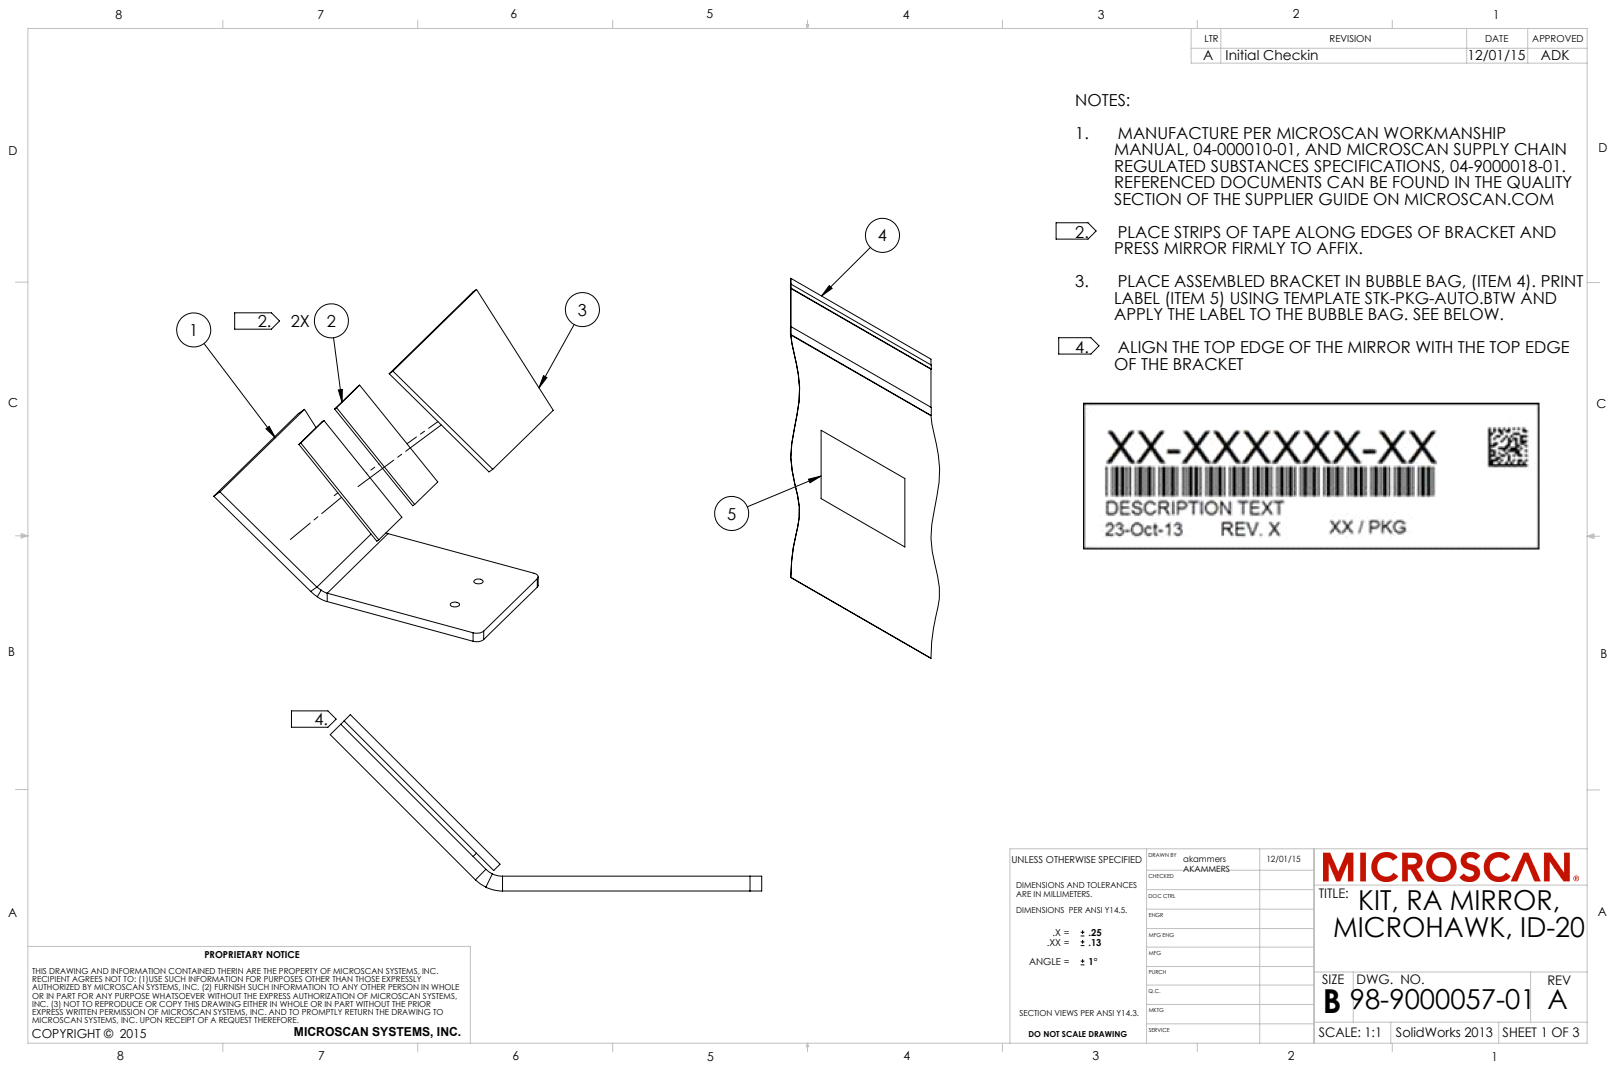
[picture p167: page 1]
DWG. NO.; REV; KIT, RA MIRROR, MICROHAWK, ID-20; .XX = ANGLE =; COPYRIGHT © 2015; MICROSCAN SYSTEMS, INC.; SERVICE; PROPRIETARY NOTICE; DRAWN BY; DOC CTRL; MFG ENG; A Initial Checkin; 12/01/15 ADK

NOTES:
1. MANUFACTURE PER MICROSCAN WORKMANSHIP
MANUAL, 04-000010-01, AND MICROSCAN SUPPLY CHAIN
REGULATED SUBSTANCES SPECIFICATIONS, 04-9000018-01.
REFERENCED DOCUMENTS CAN BE FOUND IN THE QUALITY
SECTION OF THE SUPPLIER GUIDE ON MICROSCAN.COM
2. PLACE STRIPS OF TAPE ALONG EDGES OF BRACKET AND
PRESS MIRROR FIRMLY TO AFFIX.
3. PLACE ASSEMBLED BRACKET IN BUBBLE BAG, (ITEM 4). PRINT
LABEL (ITEM 5) USING TEMPLATE STK-PKG-AUTO.BTW AND
APPLY THE LABEL TO THE BUBBLE BAG. SEE BELOW.
4. ALIGN THE TOP EDGE OF THE MIRROR WITH THE TOP EDGE
OF THE BRACKET

UNLESS OTHERWISE SPECIFIED

DIMENSIONS AND TOLERANCES
ARE IN MILLIMETERS.
DIMENSIONS PER ANSI Y14.5.

THIS DRAWING AND INFORMATION CONTAINED THERIN ARE THE PROPERTY OF MICROSCAN SYSTEMS, INC.
RECIPIENT AGREES NOT TO: (1)USE SUCH INFORMATION FOR PURPOSES OTHER THAN THOSE EXPRESSLY
AUTHORIZED BY MICROSCAN SYSTEMS, INC. (2) FURNISH SUCH INFORMATION TO ANY OTHER PERSON IN WHOLE
OR IN PART FOR ANY PURPOSE WHATSOEVER WITHOUT THE EXPRESS AUTHORIZATION OF MICROSCAN SYSTEMS,
INC. (3) NOT TO REPRODUCE OR COPY THIS DRAWING EITHER IN WHOLE OR IN PART WITHOUT THE PRIOR
EXPRESS WRITTEN PERMISSION OF MICROSCAN SYSTEMS, INC. AND TO PROMPTLY RETURN THE DRAWING TO
MICROSCAN SYSTEMS, INC. UPON RECEIPT OF A REQUEST THEREFORE.

SECTION VIEWS PER ANSI Y14.3.
DO NOT SCALE DRAWING

SCALE: 1:1 SolidWorks 2013 SHEET 1 OF 3

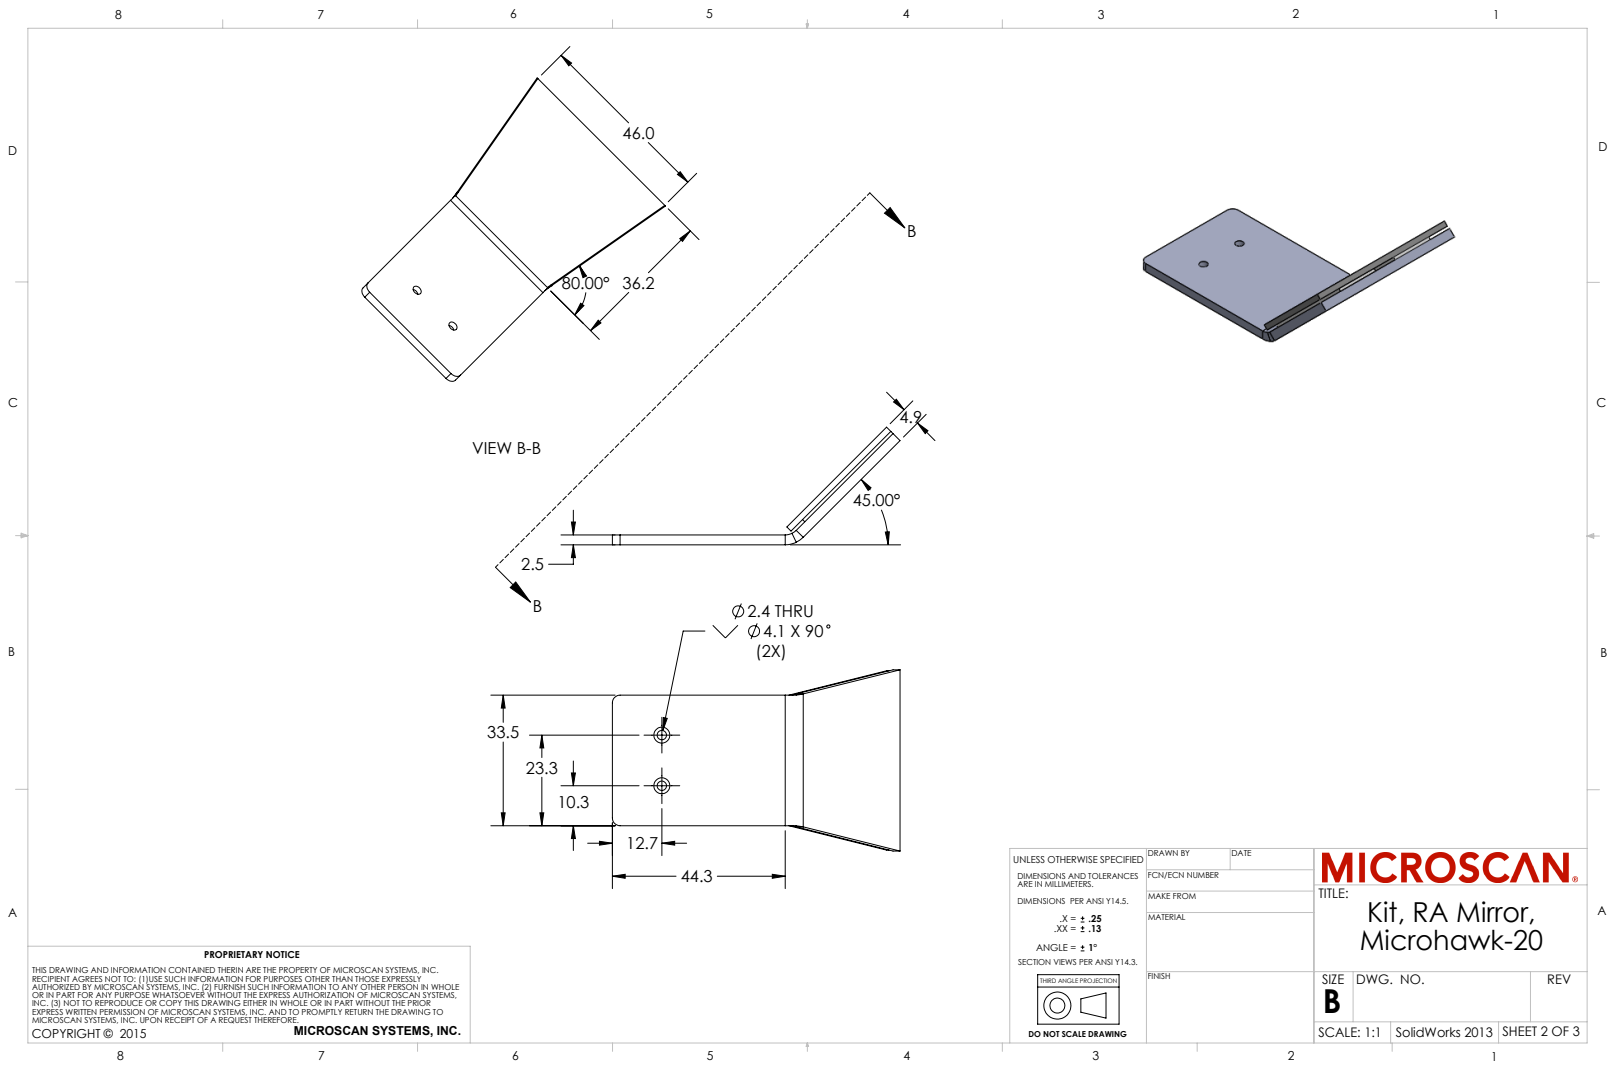
[picture p168: page 2]
2.4 THRU 4.1 X 90; VIEW B-B; DWG. NO.; REV; Kit, RA Mirror,; COPYRIGHT © 2015; MICROSCAN SYSTEMS, INC.; PROPRIETARY NOTICE; DO NOT SCALE DRAWING; SCALE: 1:1 SolidWorks 2013 SHEET 2 OF 3; MAKE FROM; DRAWN BY; DATE

UNLESS OTHERWISE SPECIFIED
DIMENSIONS AND TOLERANCES
ARE IN MILLIMETERS.
DIMENSIONS PER ANSI Y14.5.

FCN/ECN NUMBER

ANGLE =
SECTION VIEWS PER ANSI Y14.3.

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

THIRD ANGLE PROJECTION

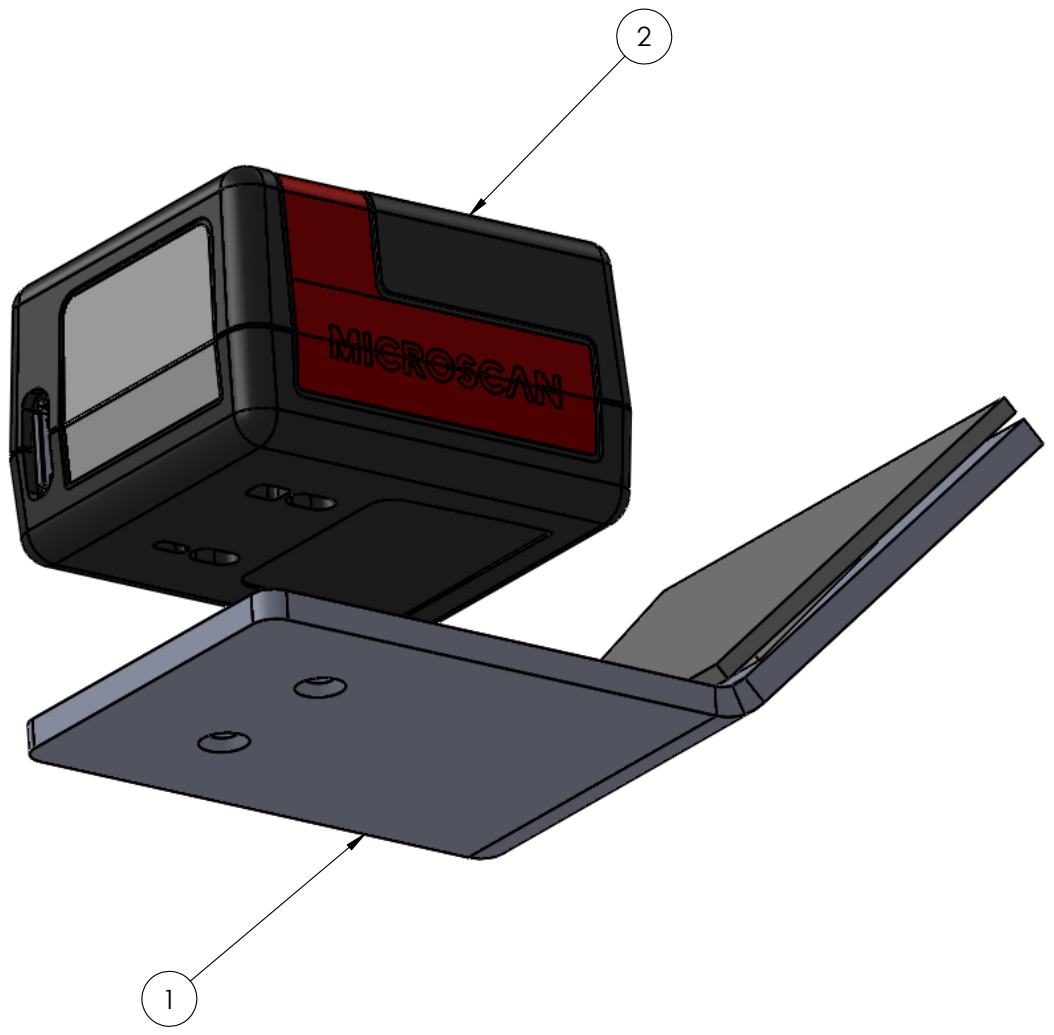
[picture p169: page 3]
DWG. NO.; REV; RA Mirror, Microhawk 20; COPYRIGHT © 2015; MICROSCAN SYSTEMS, INC.; PROPRIETARY NOTICE; DO NOT SCALE DRAWING; SCALE: 2:1 SolidWorks 2013 SHEET 3 OF 3; MAKE FROM; DRAWN BY; DATE

ITEM NO. | PART NUMBER | DESCRIPTION | QTY.
1 | 98-9000057-01 | Kit, RA Mirror, Microhawk-20 | 1
2 | | Microhawk 20 | 1

UNLESS OTHERWISE SPECIFIED
DIMENSIONS AND TOLERANCES
ARE IN MILLIMETERS.
DIMENSIONS PER ANSI Y14.5.

FCN/ECN NUMBER

ANGLE =
SECTION VIEWS PER ANSI Y14.3.

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

THIRD ANGLE PROJECTION
