huan95nd/BAI_TAP_PHAN_MEM/BAI_TAP_SOLIDWORKS/AN_HONG/MV40MicroHAWK_Drawings/PDF/MicroHAWK_ID-45_Drawing.PDF

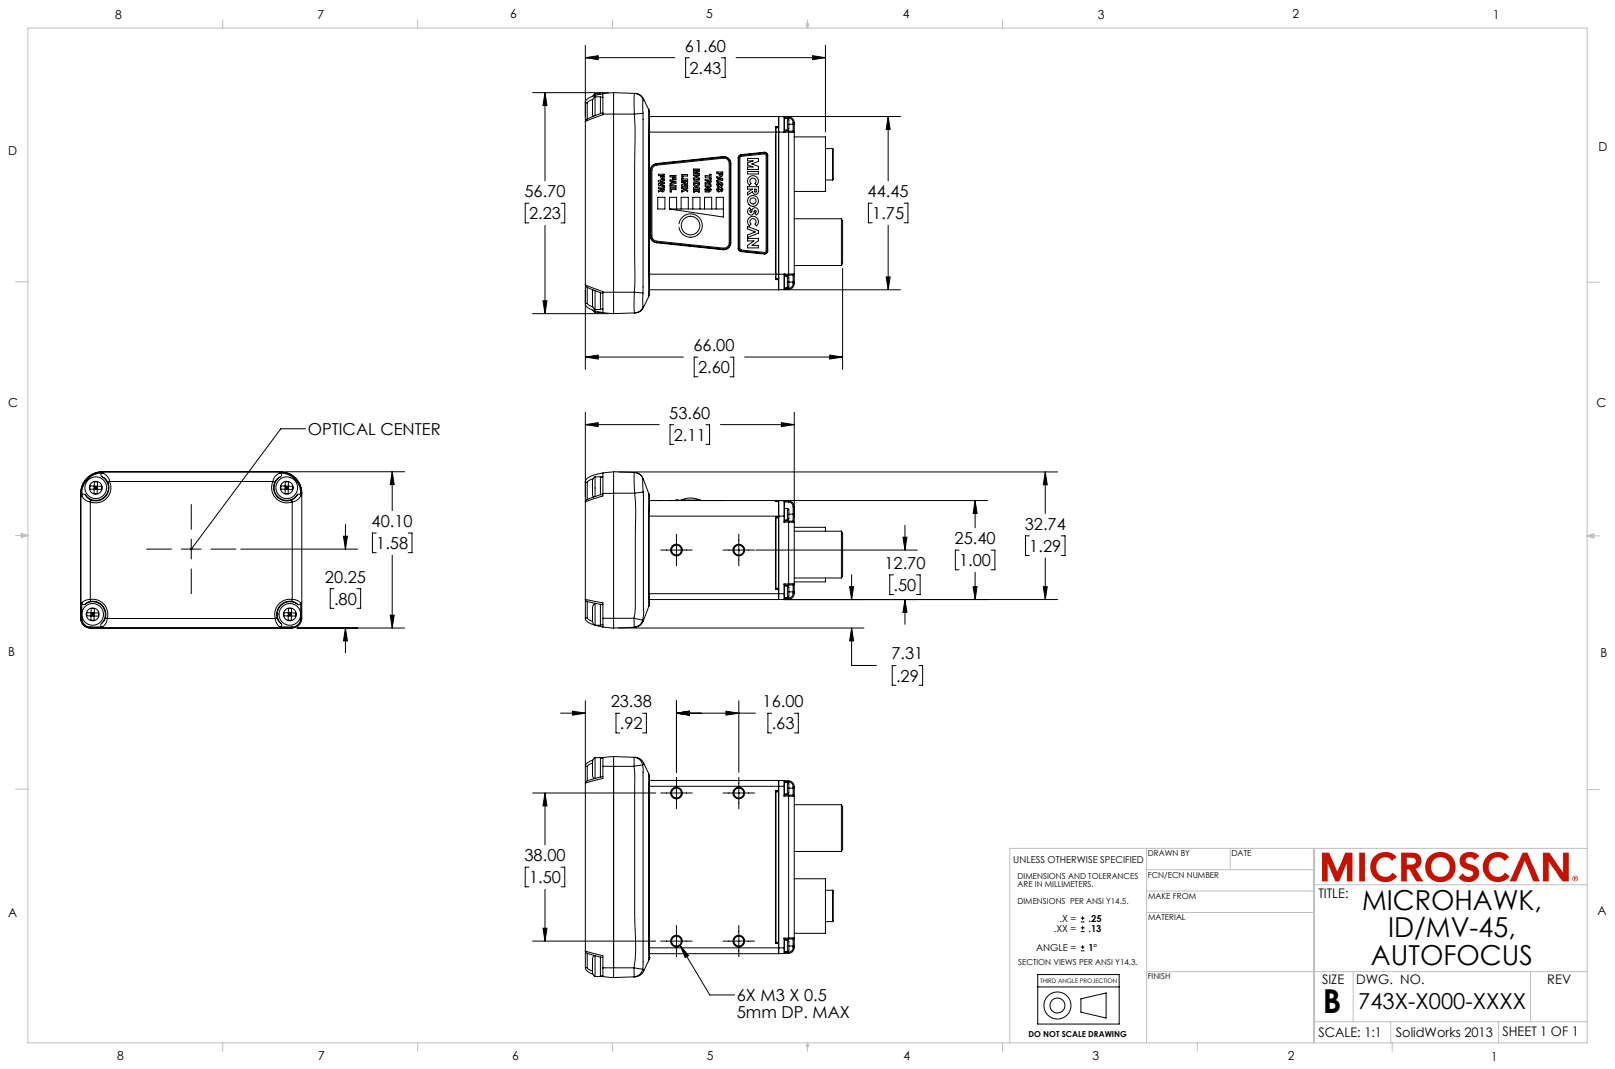
[picture p174: page 1]
OPTICAL CENTER; 6X M3 X 0.5 5mm DP. MAX; DWG. NO.; REV; SECTION VIEWS PER ANSI Y14.3.; AUTOFOCUS; .X = .XX = ANGLE =; DO NOT SCALE DRAWING; SCALE: 1:1 SolidWorks 2013 SHEET 1 OF 1; MAKE FROM; DRAWN BY; DATE

UNLESS OTHERWISE SPECIFIED
DIMENSIONS AND TOLERANCES
ARE IN MILLIMETERS.
DIMENSIONS PER ANSI Y14.5.

FCN/ECN NUMBER

THIRD ANGLE PROJECTION

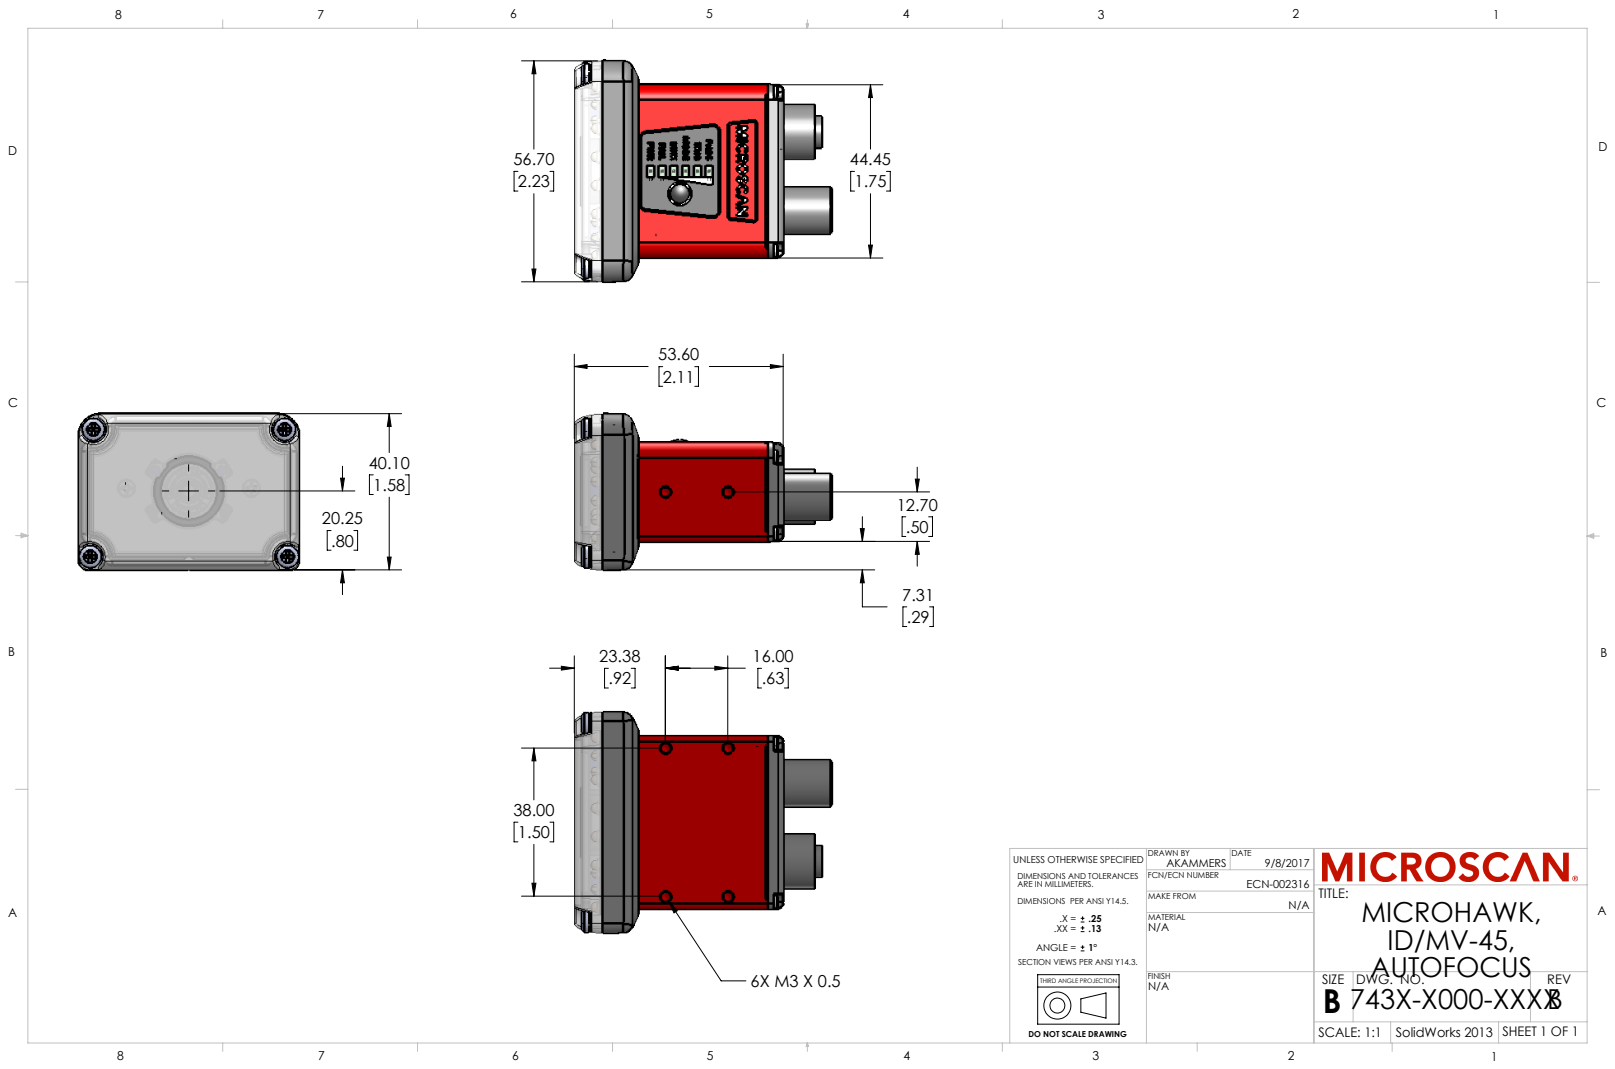
[picture p175: page 2]
DWG. NO.; REV; 743X-X000-XXXXB N/A; MAKE FROM; AKAMMERS; 9/8/2017 DRAWN BY; DATE

UNLESS OTHERWISE SPECIFIED
DIMENSIONS AND TOLERANCES
ARE IN MILLIMETERS.
DIMENSIONS PER ANSI Y14.5.

FCN/ECN NUMBER

ANGLE =
AUTOFOCUS SECTION VIEWS PER ANSI Y14.3.

THIRD ANGLE PROJECTION

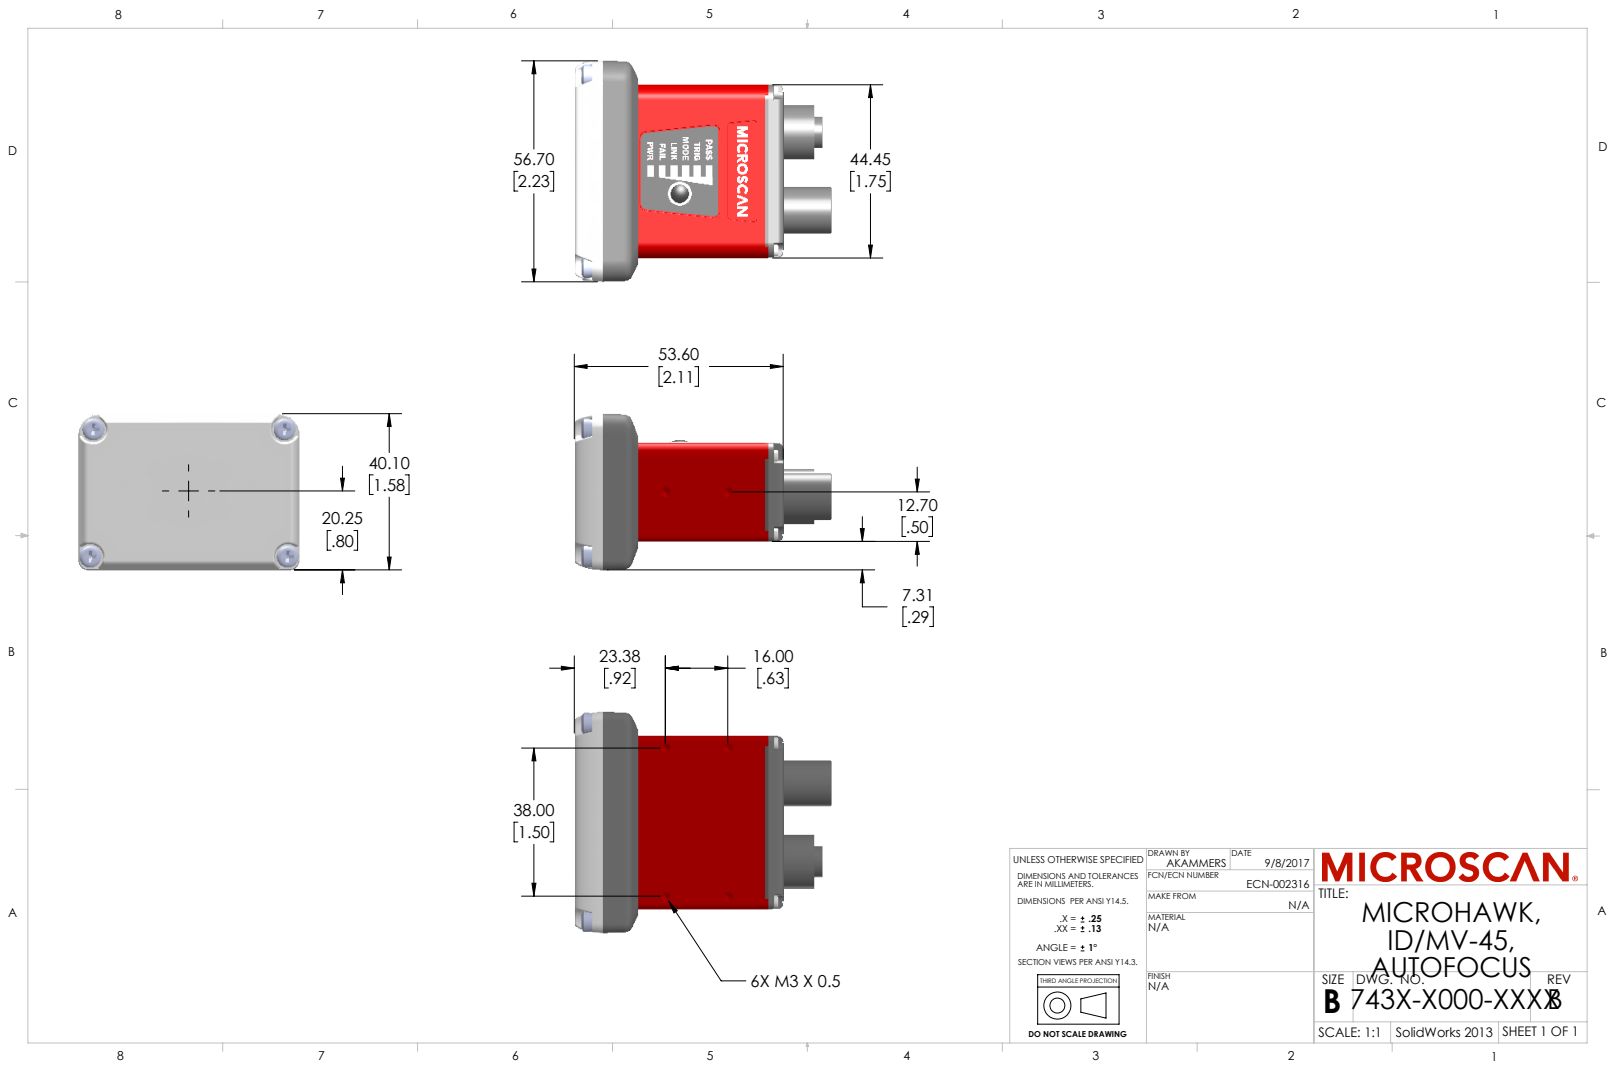
[picture p176: page 3]
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

UNLESS OTHERWISE SPECIFIED
DIMENSIONS AND TOLERANCES
ARE IN MILLIMETERS.
DIMENSIONS PER ANSI Y14.5.

FCN/ECN NUMBER

ANGLE =
AUTOFOCUS SECTION VIEWS PER ANSI Y14.3.

THIRD ANGLE PROJECTION
