huan95nd/BAI_TAP_PHAN_MEM/BAI_TAP_SOLIDWORKS/AN_HONG/Project_BIA_HHT1/FILE 1/full 1.PDF

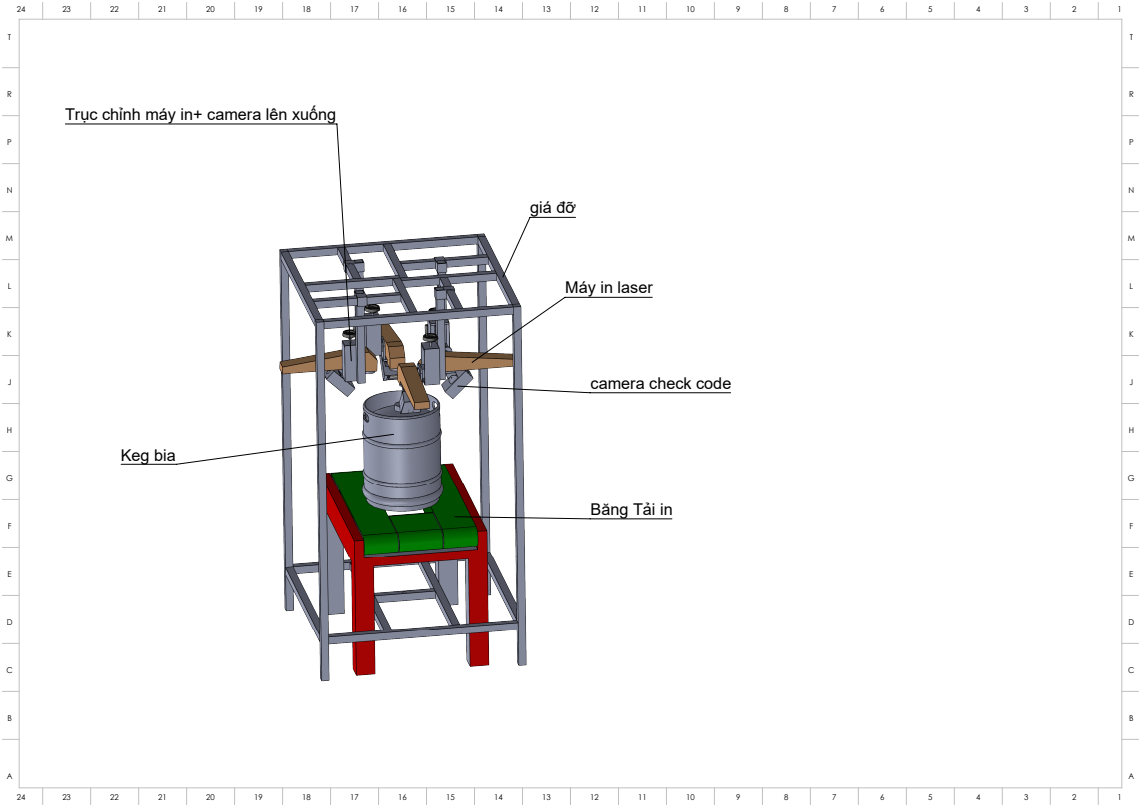
[picture p177: page 1]
giá đỡ; Keg bia

Trục chỉnh máy in+ camera lên xuống

Máy in laser

camera check code

Băng Tải in
