huan95nd/BAI_TAP_PHAN_MEM/BAI_TAP_KHI_NEN_THUY_LUC/GIAO_THONG_LONG_HAI1.PDF

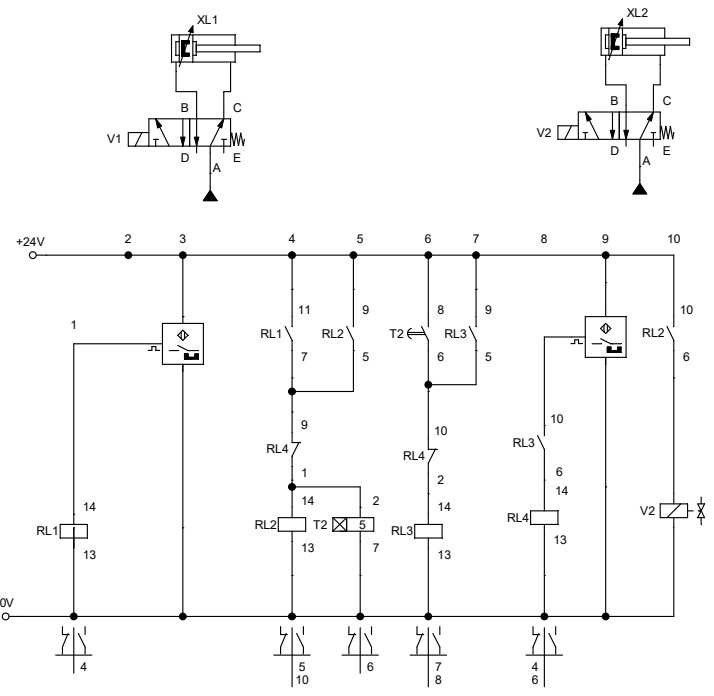
[picture p178: page 1]
