huan95nd/BAI_TAP_PHAN_MEM/BAI_TAP_SOLIDWORKS/AN_HONG/MV40MicroHAWK_Drawings/PDF/MicroHAWK_ID-30_Drawing.PDF

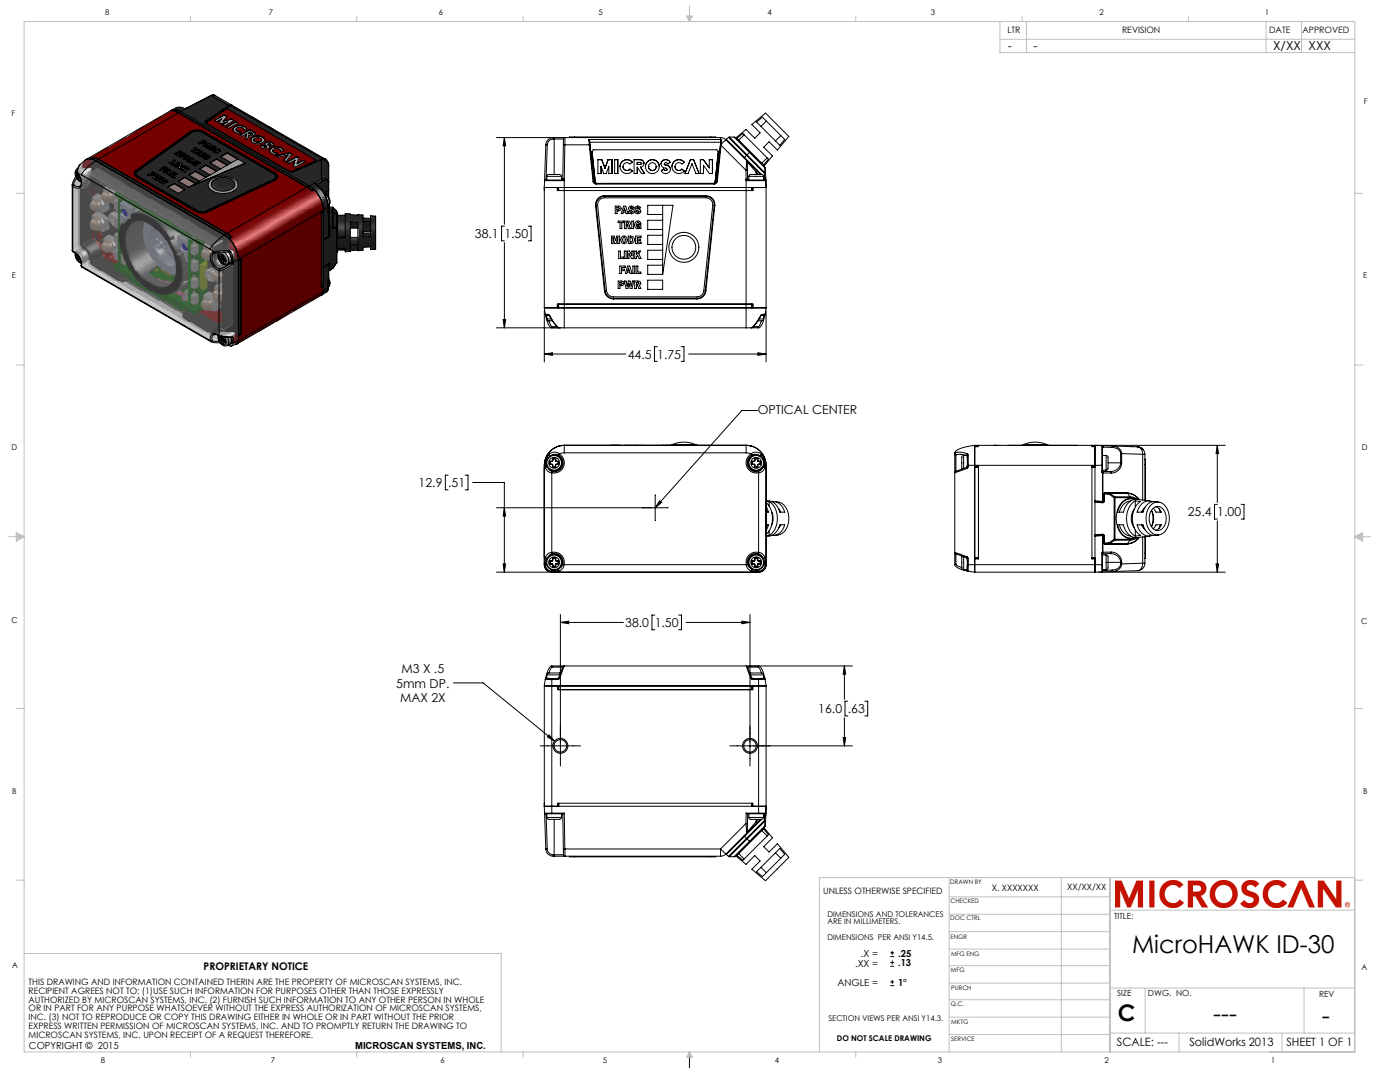
[picture p179: page 1]
OPTICAL CENTER; M3 X .5 5mm DP. MAX 2X; PROPRIETARY NOTICE; COPYRIGHT © 2015; MICROSCAN SYSTEMS, INC.; SCALE: ---; DRAWN BY; SolidWorks 2013; DWG. NO.; DOC CTRL; SECTION VIEWS PER ANSI Y14.3.; SHEET 1 OF 1; MFG ENG; .XX = ANGLE =; LTR; REVISION; DATE APPROVED; X/XX XXX

X. XXXXXXX UNLESS OTHERWISE SPECIFIED

MicroHAWK ID-30

DIMENSIONS AND TOLERANCES
ARE IN MILLIMETERS.
DIMENSIONS PER ANSI Y14.5.

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

DO NOT SCALE DRAWING
