huan95nd/BAI_TAP_PHAN_MEM/BAI_TAP_SOLIDWORKS/AN_HONG/Duoc_CPC_HN_project2-master/Duoc_CPC_HN_project2-master/BAN VE/fullcpchn.PDF

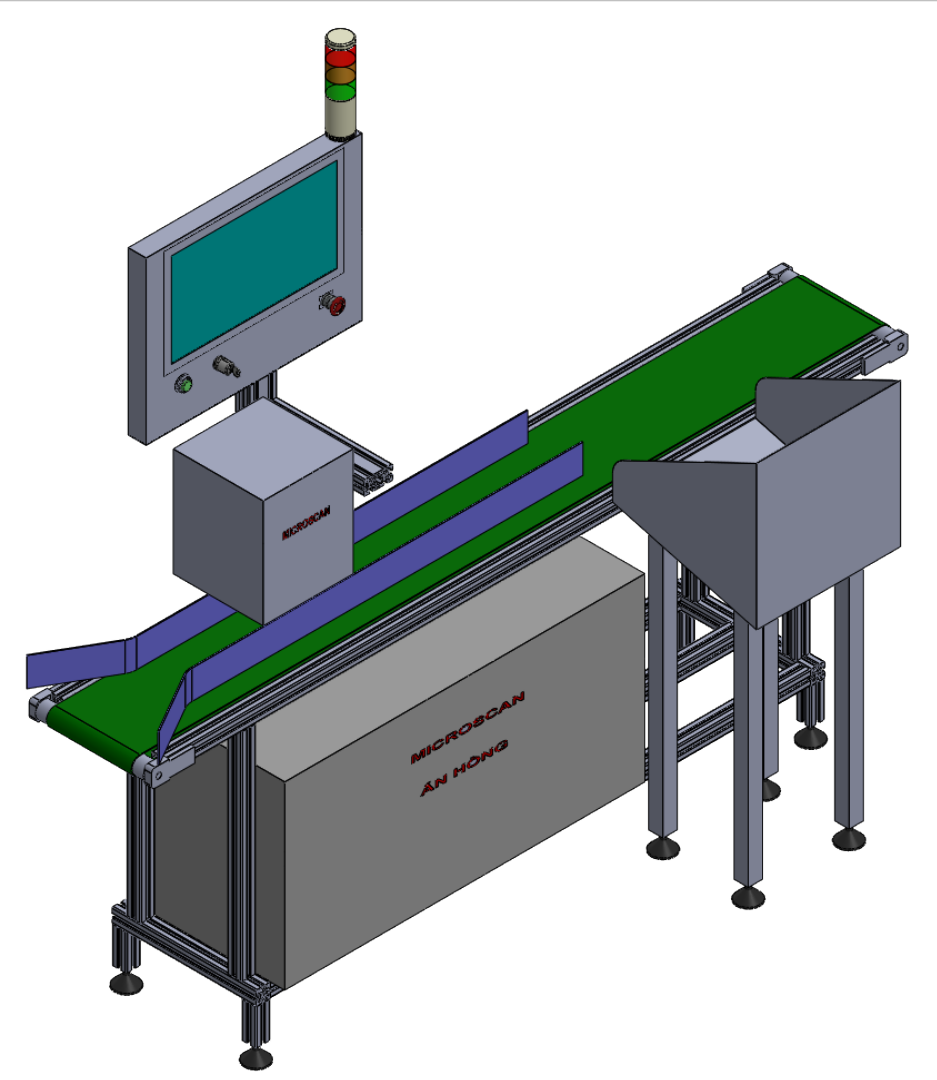
[picture p180: page 1]

DRAWN | NAME | DATE
CHK'D
APPV'D
MFG | | | fullcpchn | A4
Q.A
