huan95nd/BAI_TAP_PHAN_MEM/(commit log)

2020-02-10 bài tập phần mềm 10/02/2020
    [bang tai.SLDASM, thanh doc.SLDPRT, thanh ngan.SLDPRT, thanh ngang.SLDPRT]
2020-03-07 bài tập phần mềm 7/3/2020
    [4.SLDDRW, Assem2.SLDASM, Nhom_giua.SLDPRT, giua_trc_x.SLDPRT]
2020-03-10 bài tập phần mềm 10/3/2020
    [40x80x100.SLDPRT, 40x80x1000.SLDPRT, 40x80x320.SLDPRT, 40x80x3201.SLDPRT, 8020-2061-$PARTNUMBER.SLDPRT, Assem.SLDDRW, Assem1.SLDASM, Assem1.SLDDRW]
2020-03-10 bài tập phần mềm 10/03/2020
    [Assem1.SLDASM, Assem1.SLDDRW, Assem1.SLDPRT, Assem1.STL, Assem2.SLDASM, Assem2.SLDDRW, Assem3.SLDDRW, Part5.SLDPRT]
2020-03-12 Revert "bài tập phần mềm 10/02/2020"
    This reverts commit a43c7b1138dada752ee5631fc86a55fad3eab248.
    [bang tai.SLDASM, thanh doc.SLDPRT, thanh ngan.SLDPRT, thanh ngang.SLDPRT]
